Pro-engineer616/pcb_projects_Alex/Sensor-Node v1.2/sensornodeV1.2/README.md

View this project on [CADLAB.io](https://cadlab.io/project/28262). 

# sensor_node
Airspeed, Compass and UART as CAN sensor
