Pro-engineer616/pcb_projects_Alex/infrastructure-board/production/PCB Specification_Infrastructure.docx

PCB Specification FC-Sensor

- Board Layer Stackup

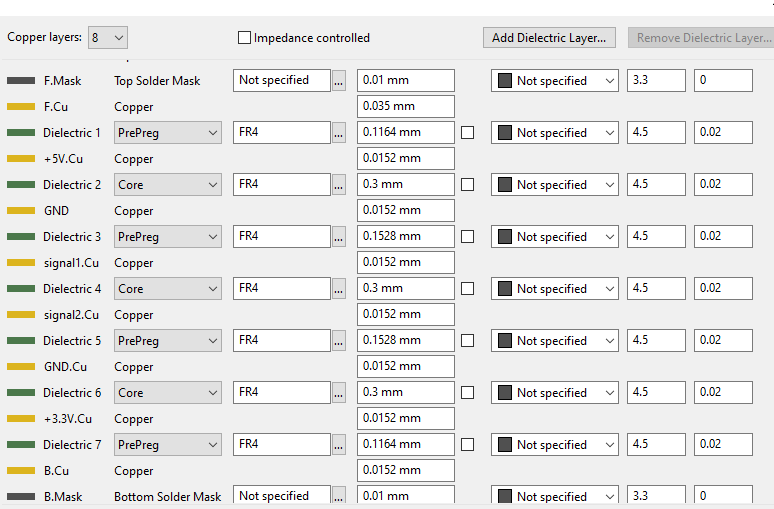
[picture p1: figure]

- Constraints

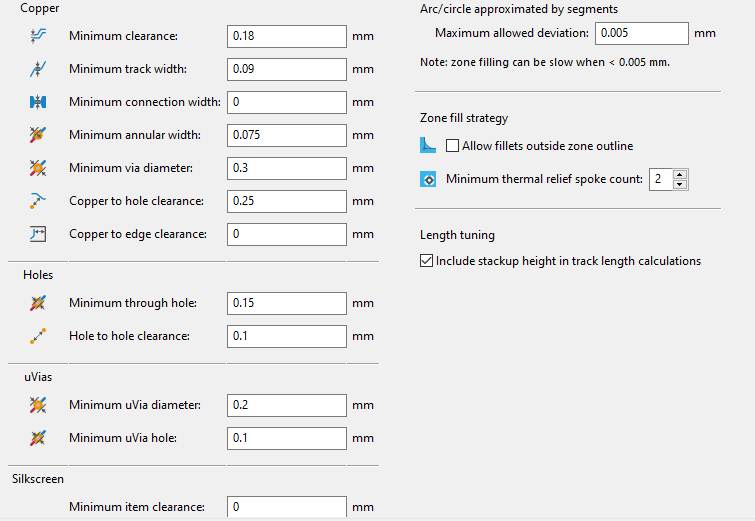
[picture p2: figure]

- 120ohm impedance control

It’s necessary to apply 120ohm impedance control to the following CAN traces on the layer5(signal2).

It’s necessary to apply 100ohm impedance control to the following Ethernet traces on the layer1(F.Cu), layer5(signal2), layer8(B.Cu).

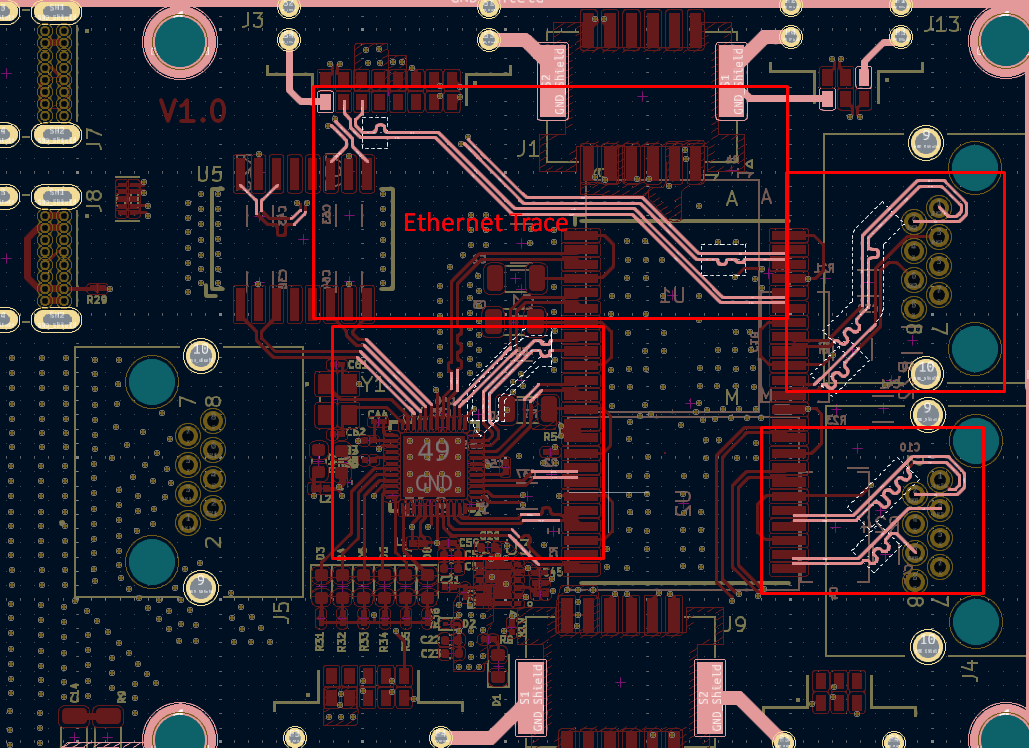
[picture p3: figure]
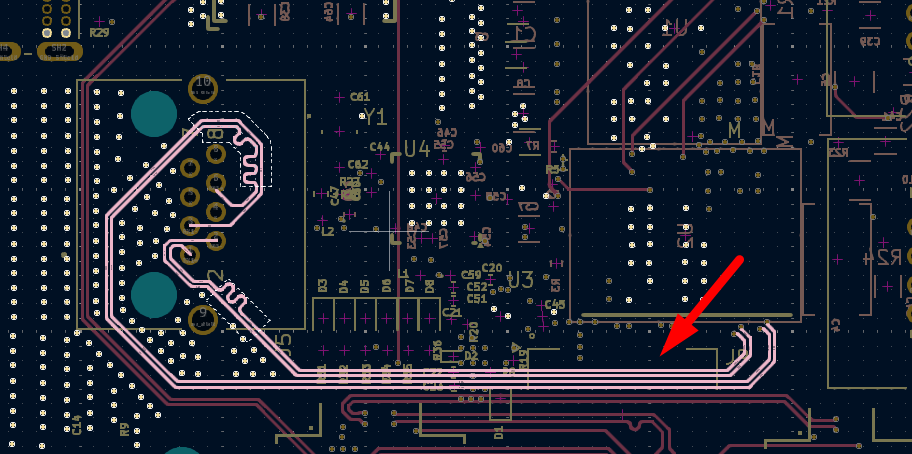
[picture p4: figure]
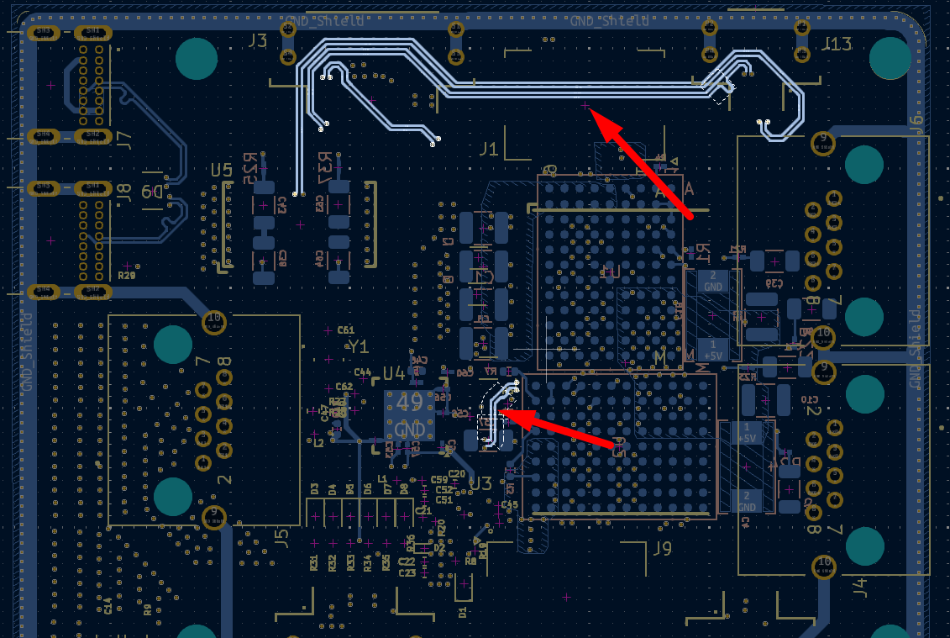
[picture p5: figure]

It’s necessary to apply 120ohm impedance control to the following CAN traces on the layer5(signal2).

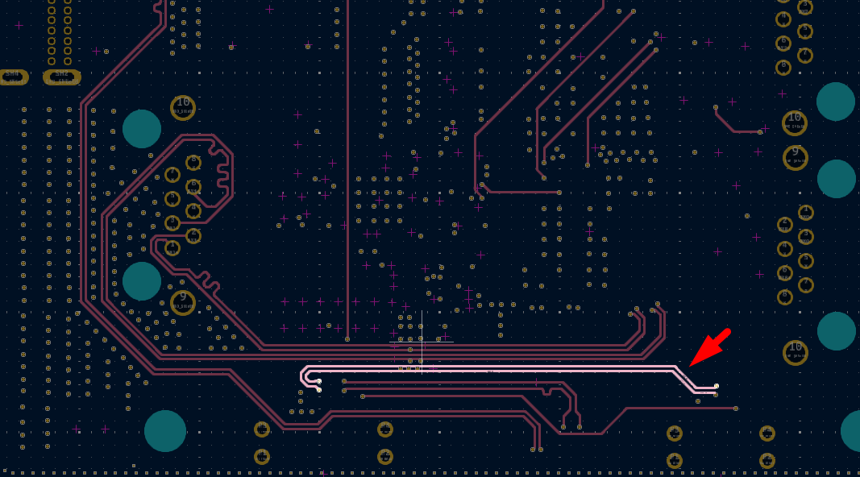
[picture p6: figure]

It’s necessary to apply 90ohm impedance control to the following USB traces on the layer5(signal2), layer8(B.Cu).

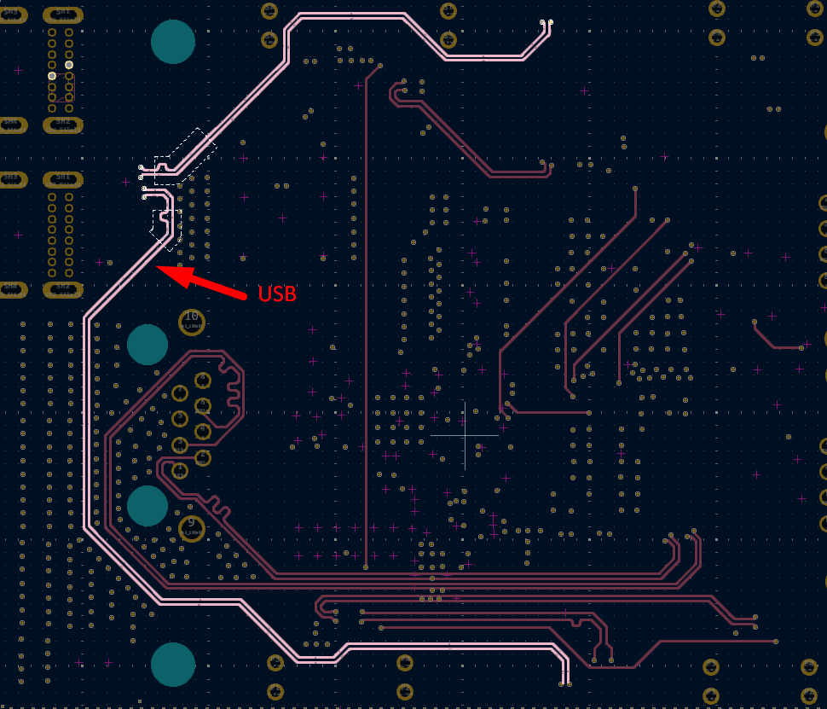
[picture p7: figure]
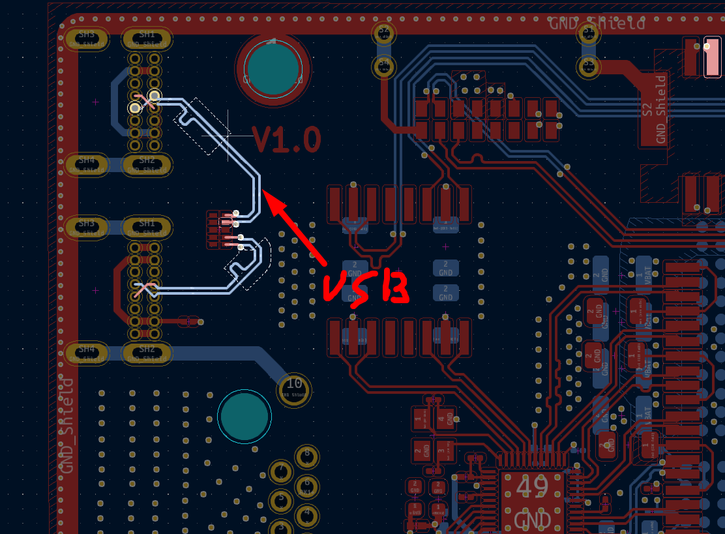
[picture p8: figure]

- Assembly

Pin1 indicators

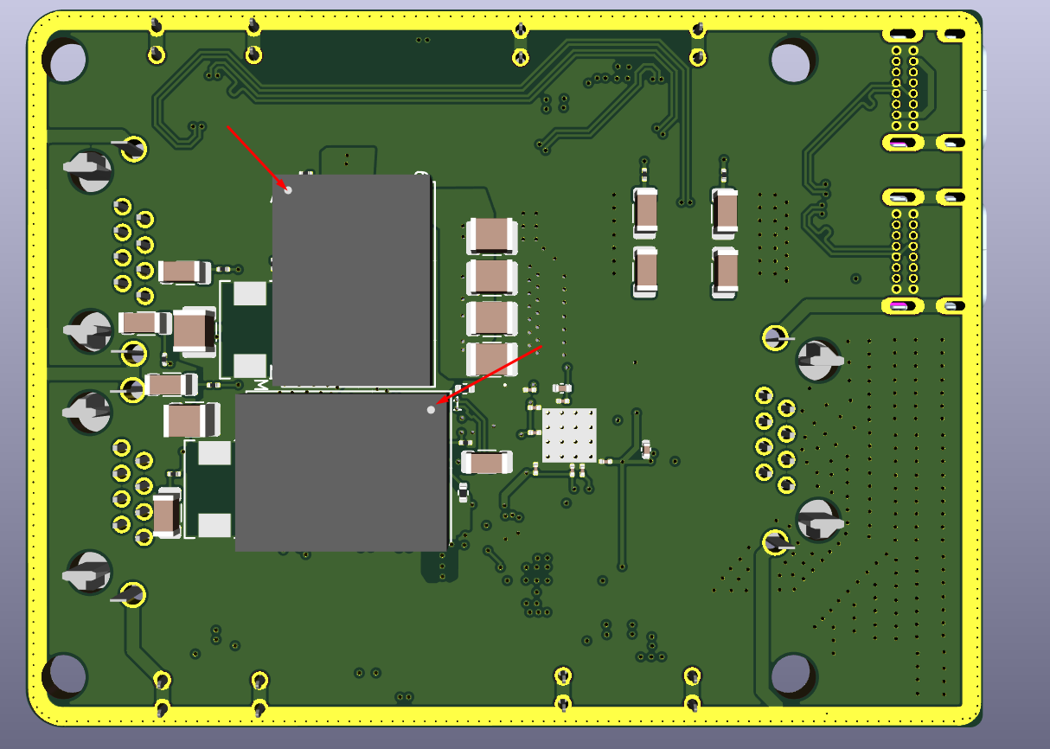
[picture p9: figure]
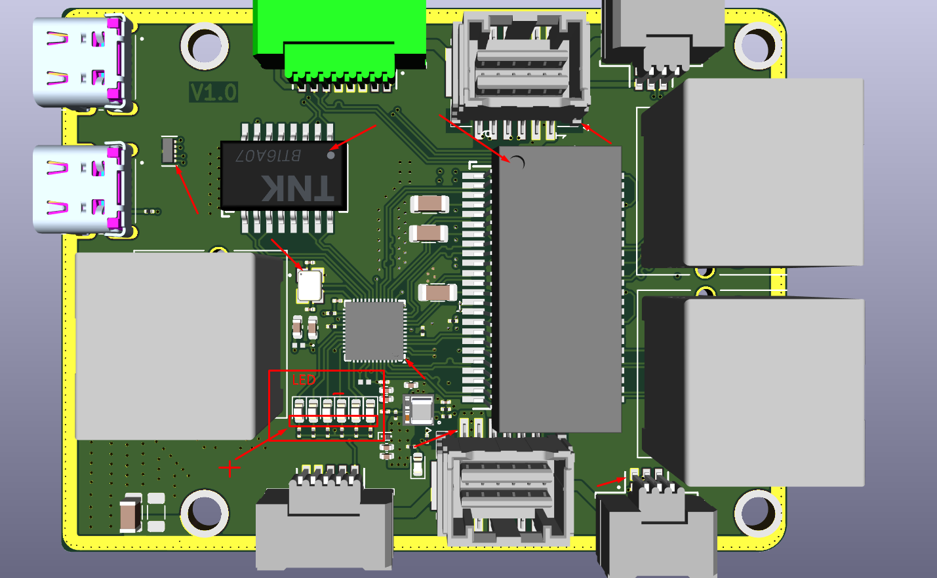
[picture p10: figure]

Drawings

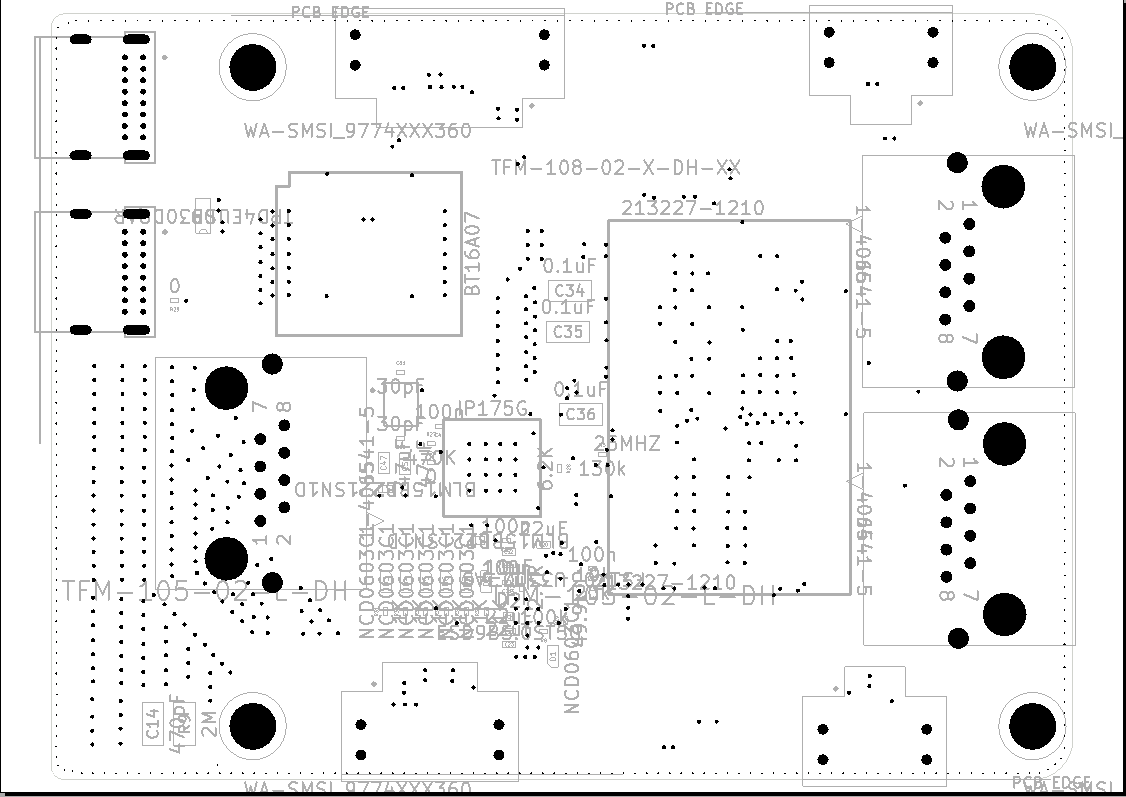
[picture p11: figure]
