Pro-engineer616/pcb_projects_Alex/PDB v1.4/production/PCB Specification PDB_V1.4.docx

PCB Specification FC-Sensor

- Board Layer Stackup

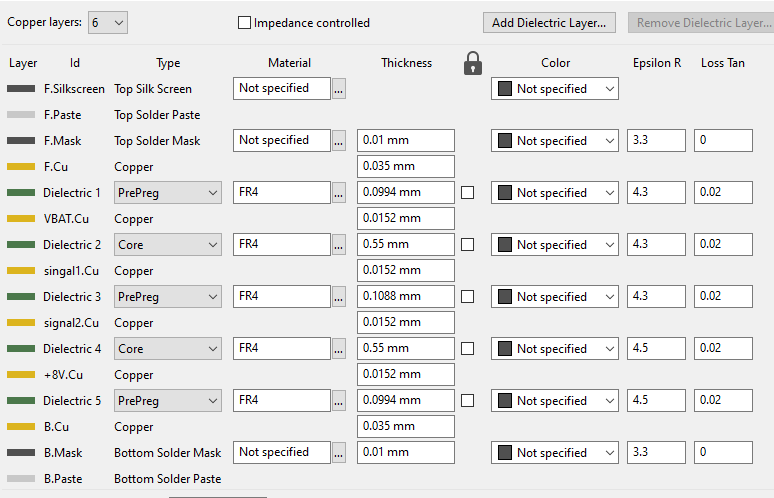
[picture p12: figure]

- Constraints

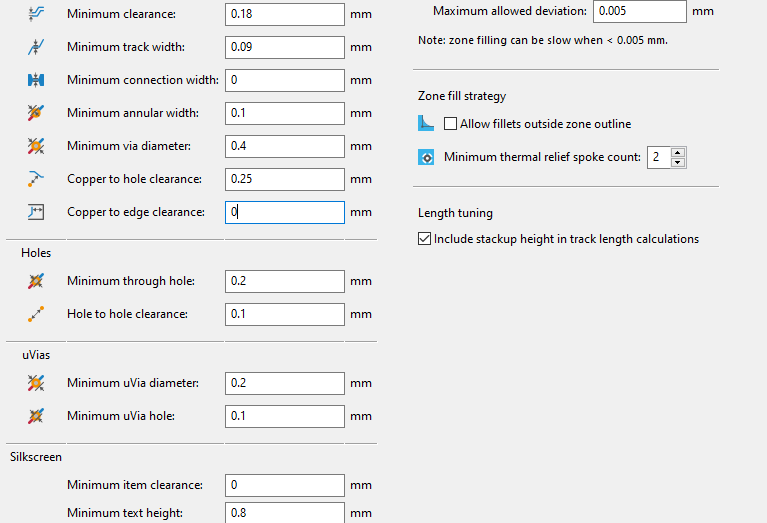
[picture p13: figure]

- 120ohm impedance control

It’s necessary to apply 120ohm impedance control to the following CAN traces on the layer3(signal1).

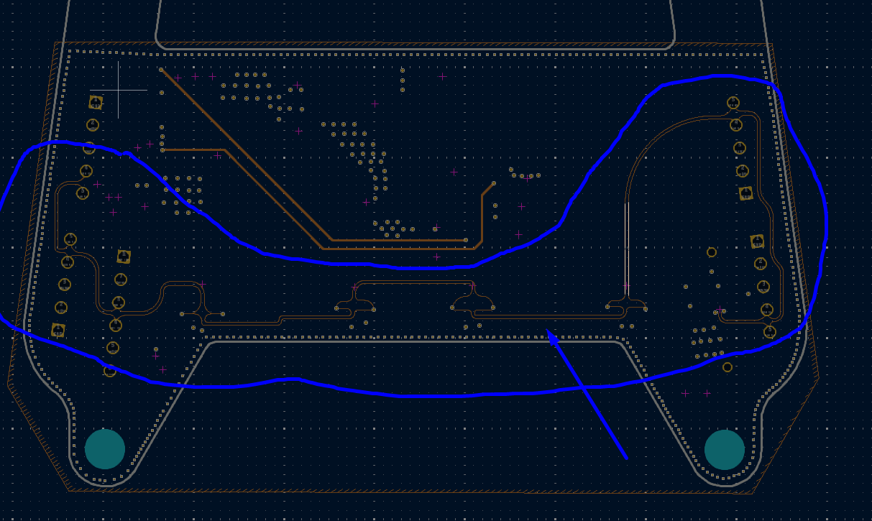
[picture p14: figure]

- Assembly

Pin1 indicators

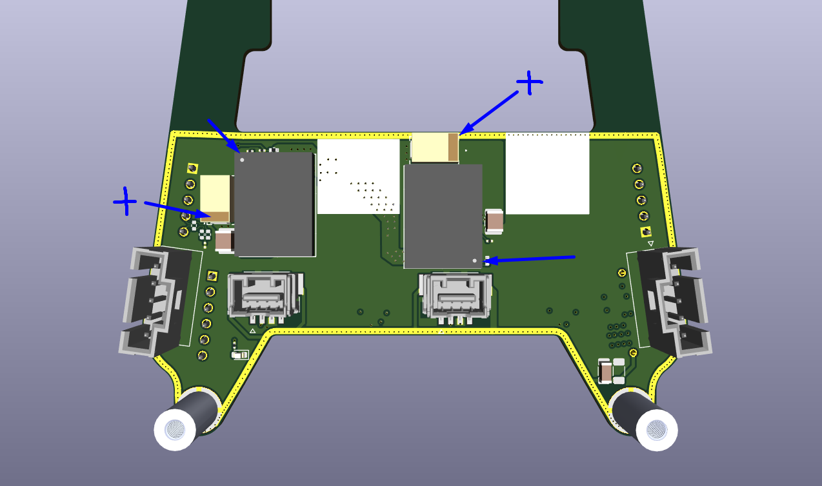
[picture p15: figure]
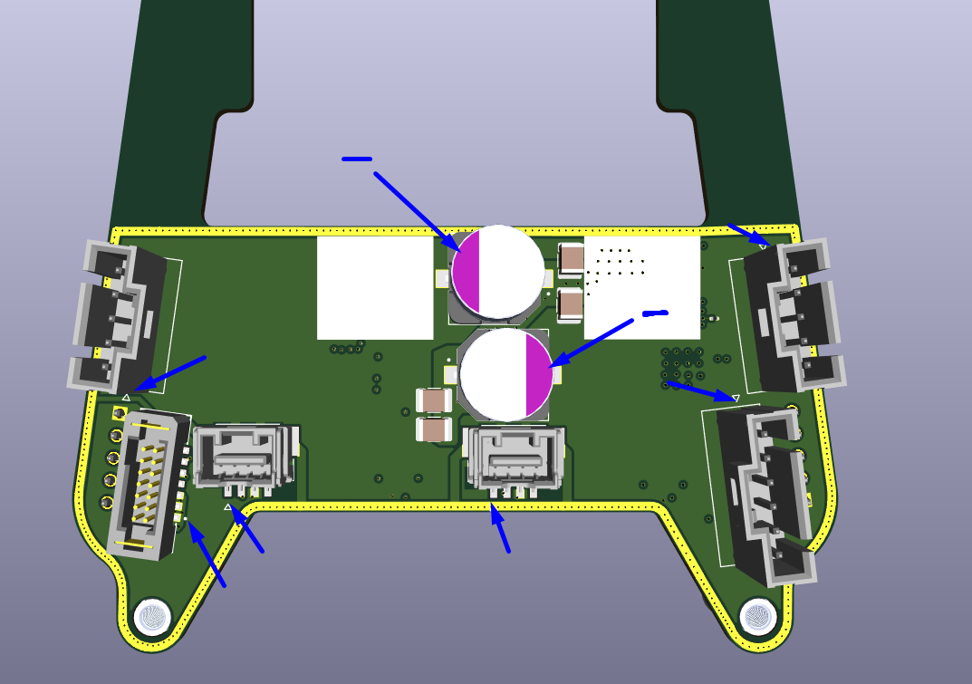
[picture p16: figure]

Drawings

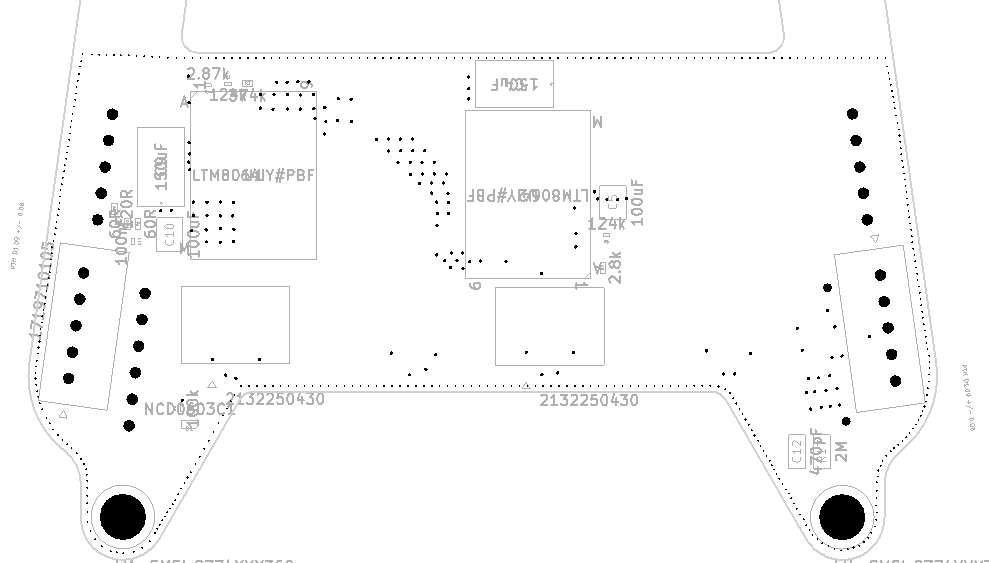
[picture p17: figure]
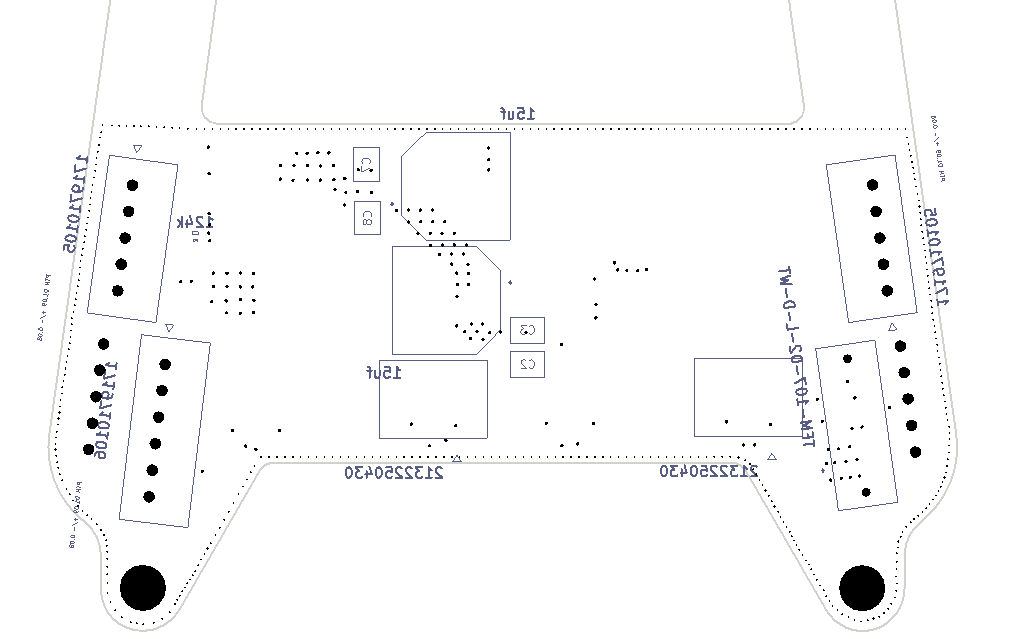
[picture p18: figure]
