Pro-engineer616/pcb_projects_Alex/Sensor-Node v1.2/production/PCB Specification_Sensornode_V1.2.docx

PCB Specification Sensornode_V1.2

- Board Layer Stackup

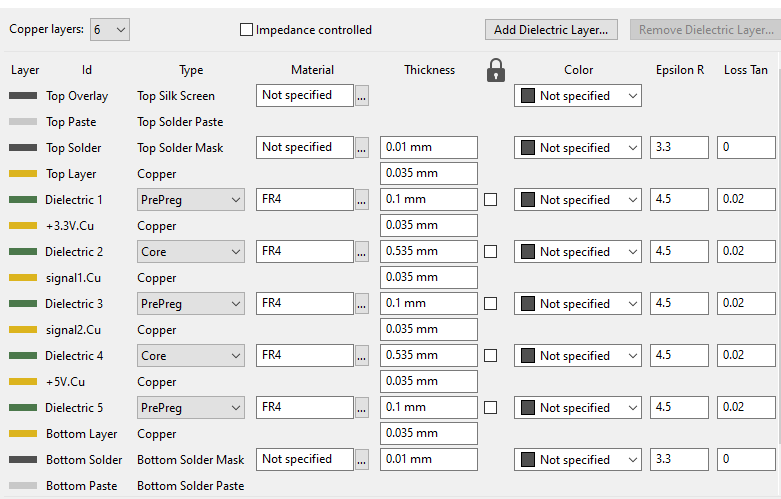
[picture p19: figure]

- Constraints

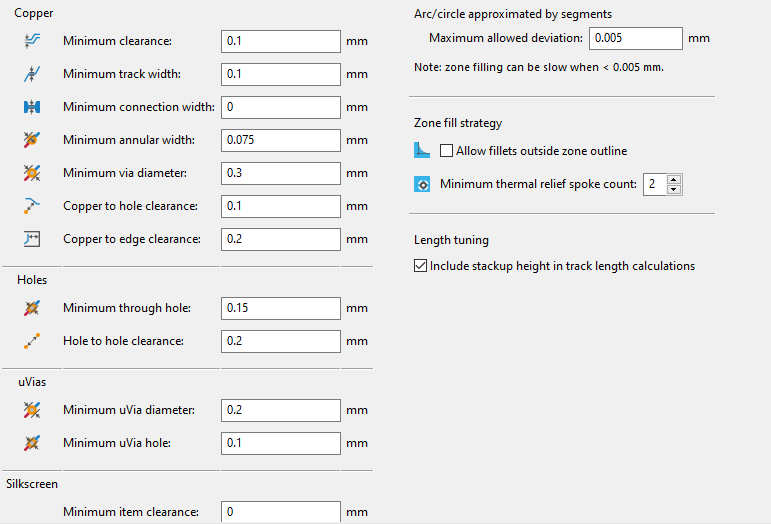
[picture p20: figure]

- impedance control

It’s necessary to apply 120ohm impedance control to the following CAN traces on the layer3(signal1), layer6(B.Cu).

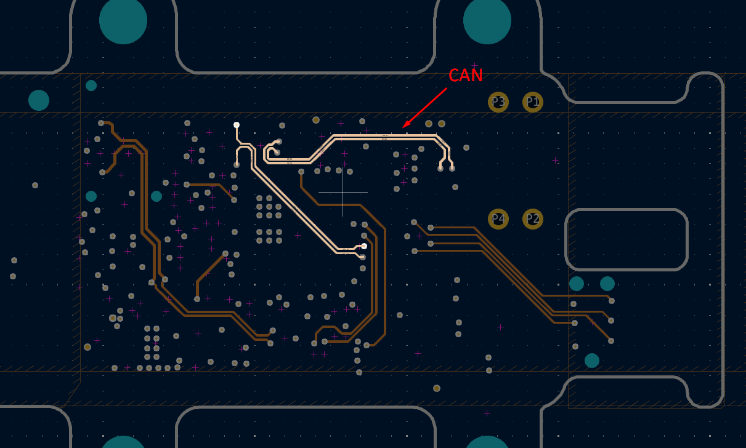
[picture p21: figure]
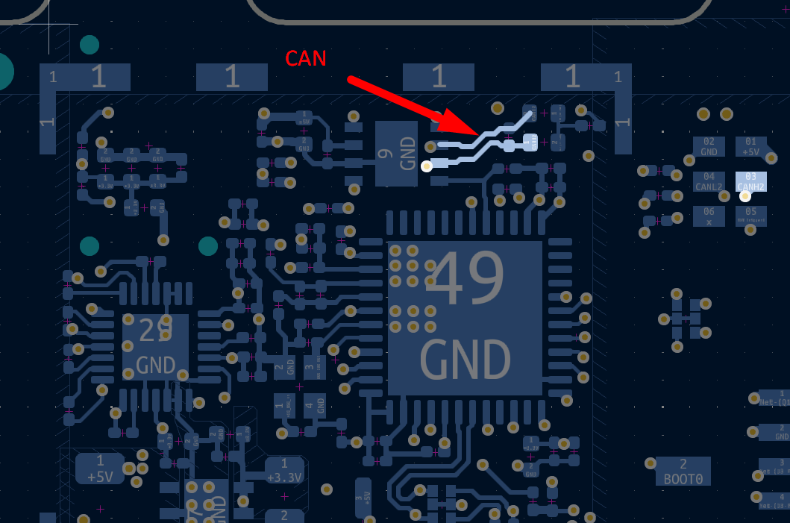
[picture p22: figure]

- Assembly

Pin1 indicators

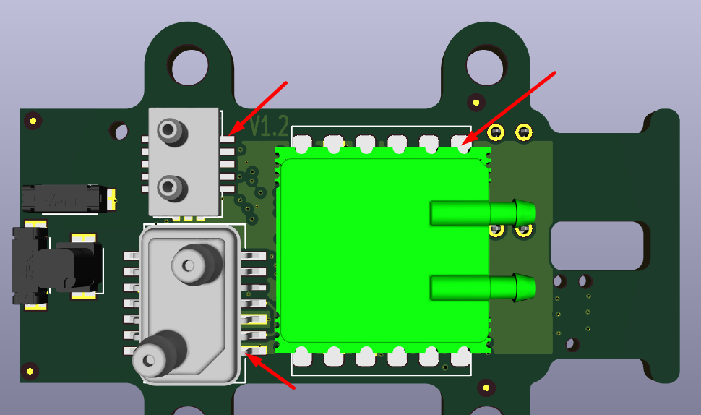
[picture p23: figure]
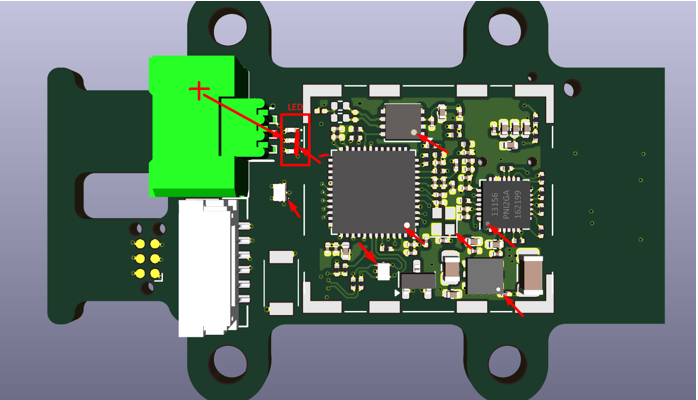
[picture p24: figure]

Drawings

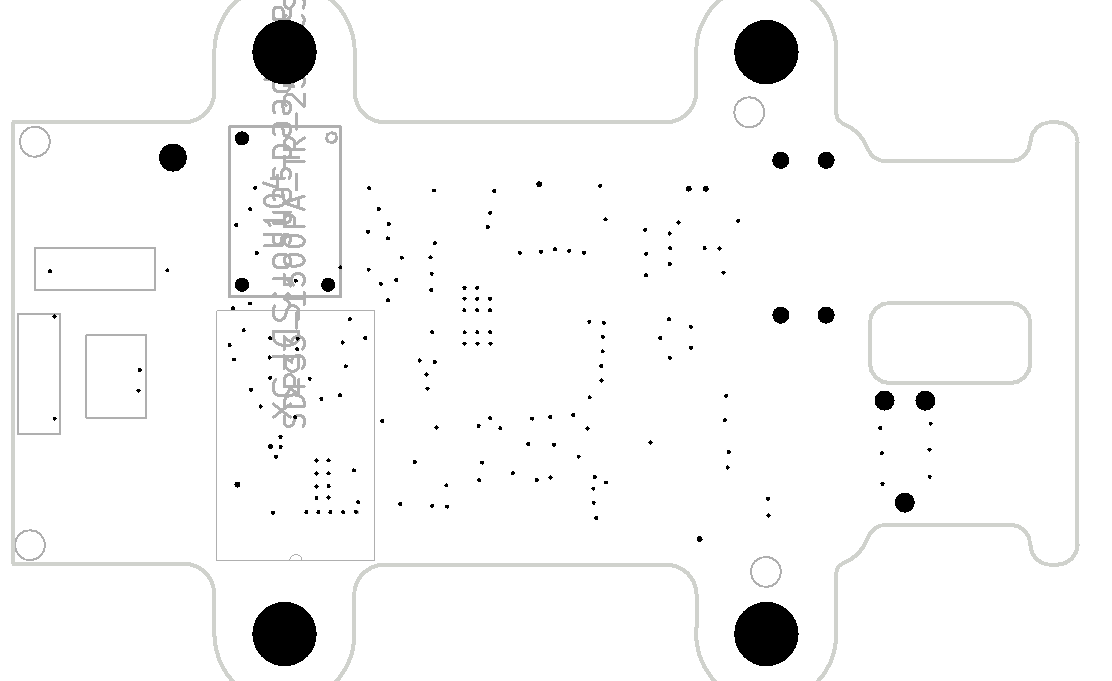
[picture p25: figure]
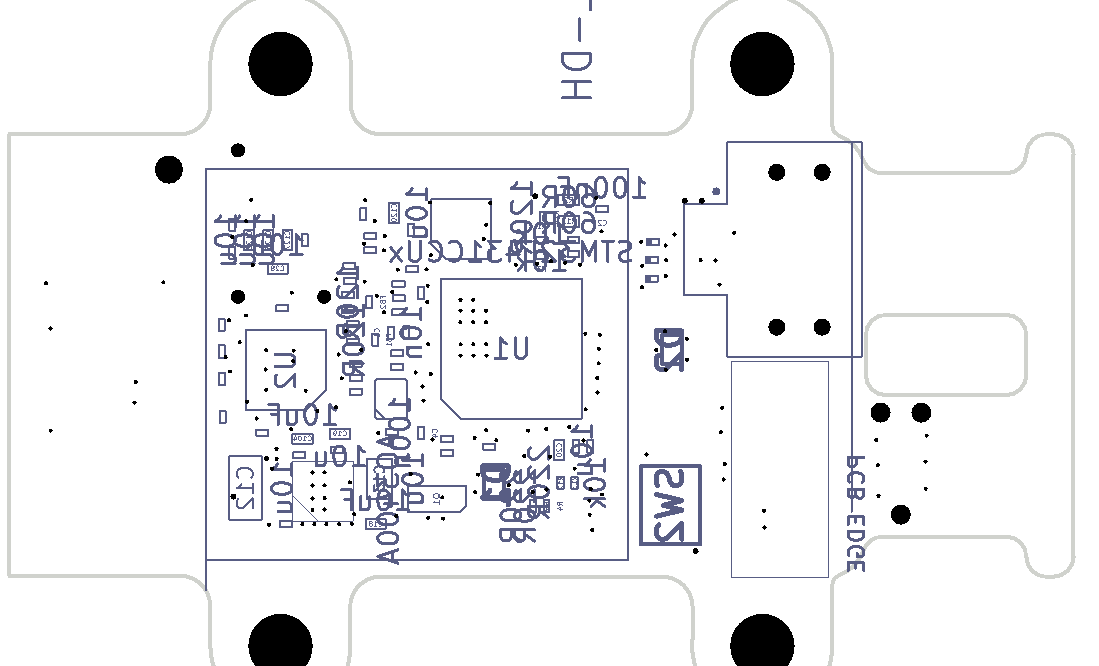
[picture p26: figure]
