Pro-engineer616/pcb_projects_Alex/Sensor-Node v1.2/production/JLCPCB/BOM/sensor_node1.2_BOM.xlsx

Comment | Designator | Footprint | JLCPCB Part#(optional)
CL03A105KP3NSNC | C9,C15,C26,C27 | Capacitor_SMD:C_0201_0603Metric | C5209398
GRM033R71A103KA01D | C1 | Capacitor_SMD:C_0201_0603Metric | C76941
GRM033Z71C104KE14D | C4,C14,C16,C21,C22,C23,C25,C29,C30,C31,C32,C117,C118,C123 | Capacitor_SMD:C_0201_0603Metric | C668346
GRM033Z71C104KE14D | C2,C17,C102,C105,C107 | Capacitor_SMD:C_0201_0603Metric | C668346
CL05A106MP5NUNC | C19,C20,C28,C120,C122,C125,C127, C18,C104 | Capacitor_SMD:C_0402 | C315248
1206B106K100NT | C12 | Capacitor_SMD:C_1206_3216Metric | C165101
CL21A106KPFNNNE | C13 | Capacitor_SMD:C_0805_2012Metric | C17024
C0201C0G6R8D500NTA | C33,C34 | Capacitor_SMD:C_0201_0603Metric | C115567
GRM033Z71C104KE14D | C116 | Capacitor_SMD:C_0201_0603Metric | C668346
XL-0201SURC | D4 | LED_SMD:LED_0201_0603Metric | C3646923
XL-0201UGC | D5 | LED_SMD:LED_0201_0603Metric | C3646922
XL-0201UBC | D6 | LED_SMD:LED_0201_0603Metric | C3646921
PESD3V3L4UF,115 | D1,D2 | SOT-353 | C552517
BLM03AG121SN1D | FB2,FB1 | Resistor_SMD:R_0402 | digikey: 490-2557-1-ND
TFM-103-02-L-DH-TR | J1 | TFM-103-02-L-DH-TR | digikey: 612-TFM-103-02-L-DH-TRCT-ND
SM06B-GHS-TB(LF)(SN) | J3 | SM06B-GHS-TB(LF)(SN) | C133065
RM3100_Sen-XY-f | L101,L102 | airspeedsensor:RM3100_Sen-XY-f | C464558
RM3100_Sen-Z-f | L103 | airspeedsensor:RM3100_Sen-Z-f | C464558
CSD17484F4 | Q1 | PicoStar-3 | C2862245
WR02X1002FAL | R1,R3,R5,R6,R7,R8,R12,R114,R115,R118,R119 | Resistor_SMD:R_0201_0603Metric | C170195
RTT0259R0FTH | R2,R11 | Resistor_SMD:R_0402 | C159005
RTT01333JTH | R105 | Resistor_SMD:R_0201_0603Metric | C158604
RC-01W1210FT | R106,R107,R108,R109,R110,R111 | Resistor_SMD:R_0201_0603Metric | C320672
RC0201FR-07220RL | R4,R9,R13 | Resistor_SMD:R_0201_0603Metric | C274342
0201WMF1200TEE | R10 | Resistor_SMD:R_0201_0603Metric | C473017
0201WMF4701TEE | R112,R113 | Resistor_SMD:R_0201_0603Metric | C270346
TS-1088R-02026 | SW2 | SMD,3x4mm | C455280
STM32L431CCU6 | U1 | UFQFPN-48(7x7) | C1337258
NCP692MN33T2G | U6 | airspeedsensor:DFN6_3X3_ONS-L | C145519
L05D-M25125 | U9 | airspeedsensor:DS-0432 | digikey: 442-AUAV-L05D-M25125-RR-N-ND
5525DSO-DB001DS | U10 | MS5525DSO:SO14_MS5525DSO_TEC | digikey: 223-1707-5-ND
RM3100_MagI2C_QFN28 | U2 | airspeedsensor:RM3100_MagI2C_MLF_4x4mm_P0.4 | C464558
SDP33-1500PA-TR-250PCS | U104 | Airspeedsensor-HW:SDP3x | mouser: 403-SDP331500PATR250
TJA1051TK/3 | U105 | Package_DFN_QFN:DFN-8-1EP_3x3mm_P0.65mm_EP1.55x2.4mm | C2875699
XC21M4-24.000-F06NKDTL | Y2 | Crystal:Crystal_SMD_2016-4Pin_2.0x1.6mm | C3034314
MS215-10S | shield | MS215-10S | digikey: 2333-MS215-10S-ND
