Pro-engineer616/pcb_projects_Alex/Radxa-Shield v1.2/production/PCBWAY/BOM/Radxa Shield Rev. 1.2_BOM_way.xlsx

Item | Designator | Qty | Manufacturer | Msg part | Description | Package | Type | Your Instructions / Notes
1 | C1,C3,C5,C8,C11,C16,C18,C19,C21,C22,C23 | 11 | Walsin Tech Corp | 0201X104K160CT | 16V 100nF X5R ±10% 0201 Multilayer Ceramic Capacitors MLCC - SMD/SMT ROHS | Capacitor_SMD:C_0201_0603Metric | SMD
2 | C2,C4 | 2 | Samsung Electro-Mechanics | CL21A106KOQNNNE | 16V 10uF X5R ±10% 0805 Multilayer Ceramic Capacitors MLCC - SMD/SMT ROHS | Capacitor_SMD:C_0805_2012Metric | SMD
3 | C6 | 1 | Samsung Electro-Mechanics | CL05A475MO5NUNC | 16V 4.7uF X5R ±20% 0402 Multilayer Ceramic Capacitors MLCC - SMD/SMT ROHS | Capacitor_SMD:C_01005_0402Metric | SMD
4 | C7,C9,C10 | 3 | Murata Electronics | GRM155R61A225KE95D | 10V 2.2uF X5R ±10% 0402 Multilayer Ceramic Capacitors MLCC - SMD/SMT ROHS | Capacitor_SMD:C_0402_1005Metric | SMD
5 | C12,C17 | 2 | Murata Electronics | GRM033R71A103KA01D | 10V 10nF X7R ±10% 0201 Multilayer Ceramic Capacitors MLCC - SMD/SMT ROHS | Capacitor_SMD:C_0201_0603Metric | SMD
6 | C13 | 1 | Murata Electronics | GRM033C80J224ME90D | 6.3V 220nF X6S ±20% 0201 Multilayer Ceramic Capacitors MLCC - SMD/SMT ROHS | Capacitor_SMD:C_0201_0603Metric | SMD
7 | C14,C15 | 2 | Murata Electronics | GRM0335C1E180JA01J | 25V 18pF C0G ±5% 0201 Multilayer Ceramic Capacitors MLCC - SMD/SMT ROHS | Capacitor_SMD:C_0201_0603Metric | SMD
8 | C24,C25,C26,C27,C28 | 5 | Samsung Electro-Mechanics | CL05A106MP5NUNC | 10V 10uF X5R ±20% 0402 Multilayer Ceramic Capacitors MLCC - SMD/SMT ROHS | Capacitor_SMD:C_0402_1005Metric | SMD
9 | D1,D2 | 2 | Nexperia | PESD3V3L4UF,115 | SOT-353 ESD and Surge Protection (TVS/ESD) ROHS | PESD3V3L4UF,115:PESD3V3L5UF115 | SMD
10 | D3 | 1 | TECH PUBLIC | ESD9B5.0ST5G | SOD-923 ESD and Surge Protection (TVS/ESD) ROHS | Diode_SMD:D_SOD-923 | SMD
11 | D4 | 1 | Texas Instruments | TPD4EUSB30DQAR | 1A 45W 8V 7V Unidirectional 5.5V USON-10(1x2.5) ESD and Surge Protection (TVS/ESD) ROHS | TPD4EUSB30DQAR:DQA10 | SMD
12 | J1 | 1 | ZHOURI | 2.54-2*20 | 2.54mm 2.54mm Double Row 2.5A 40P -40℃~+105℃ Direct Insert 2x20P 8.5mm Top Square Hole Plugin,P=2.54mm Female Headers ROHS | Connector_Samtec_HLE_THT:Samtec_HLE-120-02-xx-DV-TE_2x20_P2.54mm_Horizontal | wave soldering
13 | J2 | 1 | Samtec Inc. | TFM-106-02-L-DH-TR | CONN HEADER SMD R/A 12POS 1.27MM | TFM-106-02-L-DH-TR:SAMTEC_TFM-106-02-L-DH-TR | SMD
14 | L1 | 1 | Murata Electronics | BLM15BB221SN1D | 800mΩ ±25% 220Ω@100MHz 0402 Ferrite Beads ROHS | BLM15BB221SN1D:IND_BLM15_0402_MUR
15 | R1 | 1 | FH (Guangdong Fenghua Advanced Tech) | RC-01W2402FT | 50mW Thick Film Resistors 25V ±1% ±200ppm/℃ 24kΩ 0201 Chip Resistor - Surface Mount ROHS | Resistor_SMD:R_0201_0603Metric | SMD
16 | R2 | 1 | UNI-ROYAL(Uniroyal Elec) | 0201WMF4702TEE | 50mW Thick Film Resistors 25V ±1% ±200ppm/℃ 47kΩ 0201 Chip Resistor - Surface Mount ROHS | Resistor_SMD:R_0201_0603Metric | SMD
17 | R3 | 1 | UNI-ROYAL(Uniroyal Elec) | 0201WMF4301TEE | 50mW Thick Film Resistors 25V ±1% ±200ppm/℃ 4.3kΩ 0201 Chip Resistor - Surface Mount ROHS | Resistor_SMD:R_0201_0603Metric | SMD
18 | R4,R9,R10,R11,R13,R16,R17 | 7 | YAGEO | RC0201JR-0710KL | 50mW Thick Film Resistors 25V ±5% ±200ppm/℃ 10kΩ 0201 Chip Resistor - Surface Mount ROHS | Resistor_SMD:R_0201_0603Metric | SMD
19 | R5 | 1 | UNI-ROYAL(Uniroyal Elec) | 0201WMF2002TEE | 50mW Thick Film Resistors 25V ±1% ±200ppm/℃ 20kΩ 0201 Chip Resistor - Surface Mount ROHS | Resistor_SMD:R_0201_0603Metric | SMD
20 | R6 | 1 | YAGEO | RC0201FR-0749K9L | 50mW Thick Film Resistors 25V ±1% ±200ppm/℃ 49.9kΩ 0201 Chip Resistor - Surface Mount ROHS | Resistor_SMD:R_0201_0603Metric | SMD
21 | R7 | 1 | RALEC | RTT012R70FTH | 50mW Thick Film Resistors 25V -200ppm/℃~+400ppm/℃ ±1% 2.7Ω 0201 Chip Resistor - Surface Mount ROHS | Resistor_SMD:R_0201_0603Metric | SMD
22 | R8 | 1 | UNI-ROYAL(Uniroyal Elec) | 0201WMF1202TEE | 50mW Thick Film Resistors 25V ±1% ±200ppm/℃ 12kΩ 0201 Chip Resistor - Surface Mount ROHS | Resistor_SMD:R_0201_0603Metric | SMD
23 | R12,R14 | 2 | RALEC | RTT011003FTH | 50mW Thick Film Resistors 25V ±1% ±200ppm/℃ 100kΩ 0201 Chip Resistor - Surface Mount ROHS | Resistor_SMD:R_0201_0603Metric | SMD
24 | R15 | 1 | YAGEO | RC0201FR-071ML | 50mW Thick Film Resistors 25V ±1% ±200ppm/℃ 1MΩ 0201 Chip Resistor - Surface Mount ROHS | Resistor_SMD:R_0201_0603Metric | SMD
25 | U1 | 1 | SKYWORKS/SILICON LABS | CP2105-F01-GM | 2Mbps USB to UART UART QFN-24-EP(4x4) USB Converters ROHS | CP2105:QFN24_4X4_SIL-L | SMD
26 | U2 | 1 | Microchip Tech | USB2512BI-AEZG | Hub SQFN-36-EP(6x6) USB Converters ROHS | QFN36_6X6MC_MCH | SMD
27 | U3 | 1 | TDK | FS1703-3300-AS | SMD-17P,3.3x3.3mm DC-DC Power Modules ROHS | FS1703-3300-AS:P11F1_TDK | wave soldering
28 | Y1 | 1 | Lucki | L327S240P11L | 24MHz SMD crystal oscillator 15pF ±10ppm SMD3225-4P Crystals ROHS | L327S240P11L:XTAL_TSX-3225_40.0000MF20X-K0 | SMD
29 | C20 | 1 | FOJAN | FCC1206B471K102DT | 1kV 470pF X7R ±10% 1206 Multilayer Ceramic Capacitors MLCC - SMD/SMT ROHS | 1206 | SMD
30 | R18 | 1 | UNI-ROYAL(Uniroyal Elec) | 1206W4F2004T5E | 250mW Thick Film Resistors 200V ±100ppm/℃ ±1% 2.2MΩ 1206 Chip Resistor - Surface Mount ROHS | 1206 | SMD
