Pro-engineer616/pcb_projects_Alex/infrastructure-board/source/infrastructure/package/100SXV15MX/100SXV15MX.step

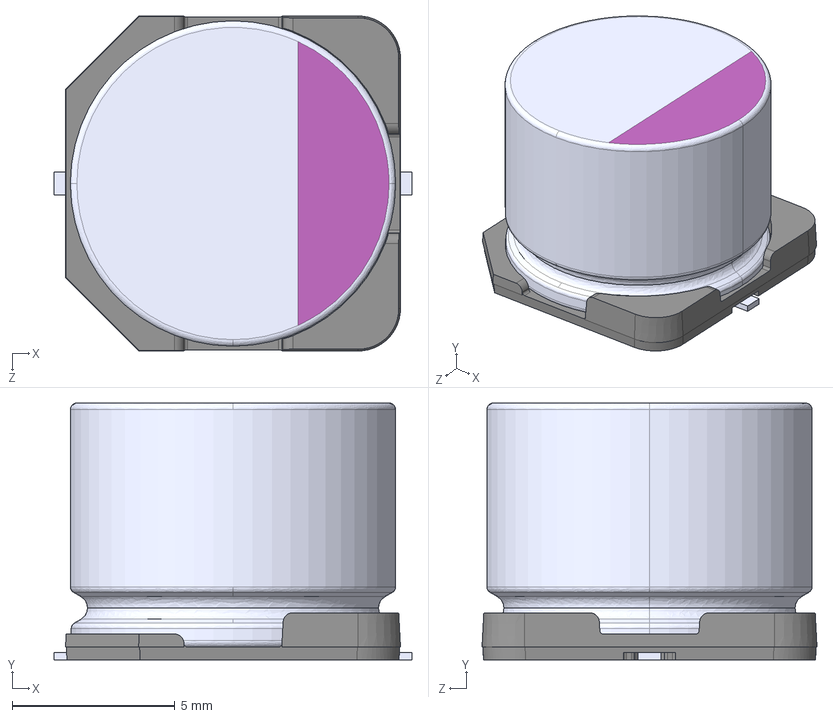
[picture p27: CAD file, 2024-08-19]
infrastructure-board/source/infrastructure/package/100SXV15MX/100SXV15MX.step
11.0 x 7.90 x 10.3 mm
