Pro-engineer616/pcb_projects_Alex/infrastructure-board/source/infrastructure/package/1_406541_5/c-1-406541-5-l1-3d.stp

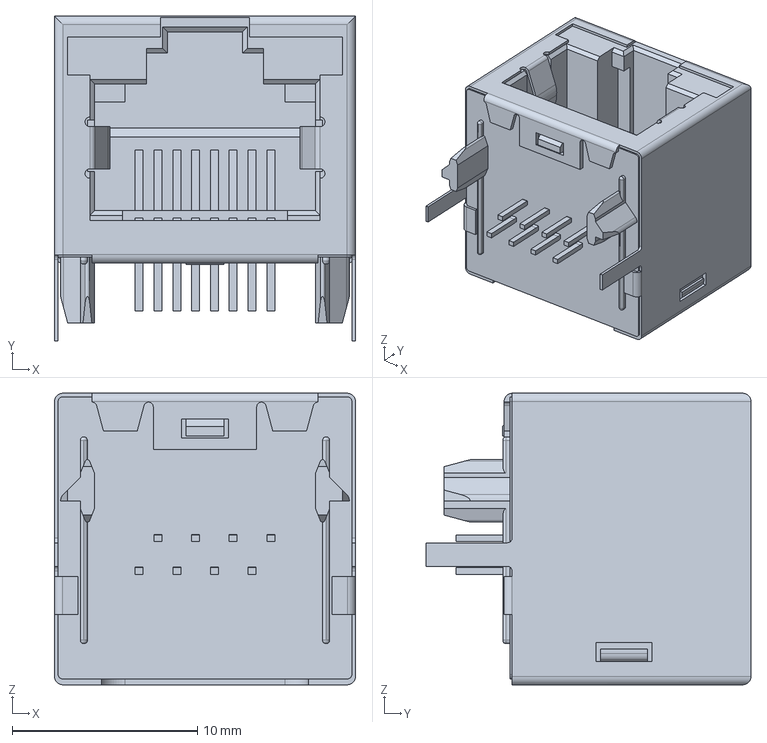
[picture p28: CAD file, 2024-08-29]
infrastructure-board/source/infrastructure/package/1_406541_5/c-1-406541-5-l1-3d.stp
16.3 x 17.6 x 15.7 mm
