Pro-engineer616/pcb_projects_Alex/infrastructure-board/source/infrastructure/package/9774120360R/WA-SMSI_9774XXX360.step

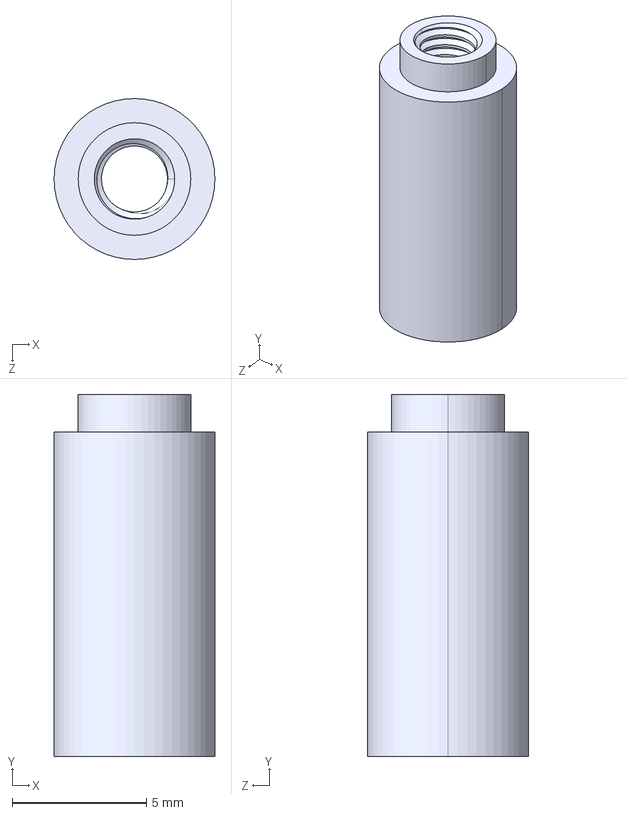
[picture p29: CAD file, 2024-08-19]
infrastructure-board/source/infrastructure/package/9774120360R/WA-SMSI_9774XXX360.step
6.00 x 13.5 x 6.00 mm
