Pro-engineer616/pcb_projects_Alex/infrastructure-board/source/infrastructure/package/GSB1C211110DS1HR/GSB1C211110DS1HR.step

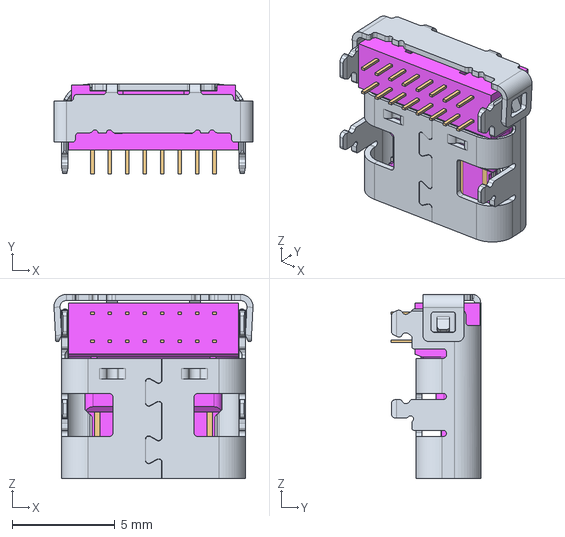
[picture p30: CAD file, 2024-08-29]
infrastructure-board/source/infrastructure/package/GSB1C211110DS1HR/GSB1C211110DS1HR.step
9.69 x 4.36 x 8.97 mm
