Pro-engineer616/pcb_projects_Alex/infrastructure-board/source/infrastructure/package/LIB_IP175G/IP175G/3D/IP175G.stp

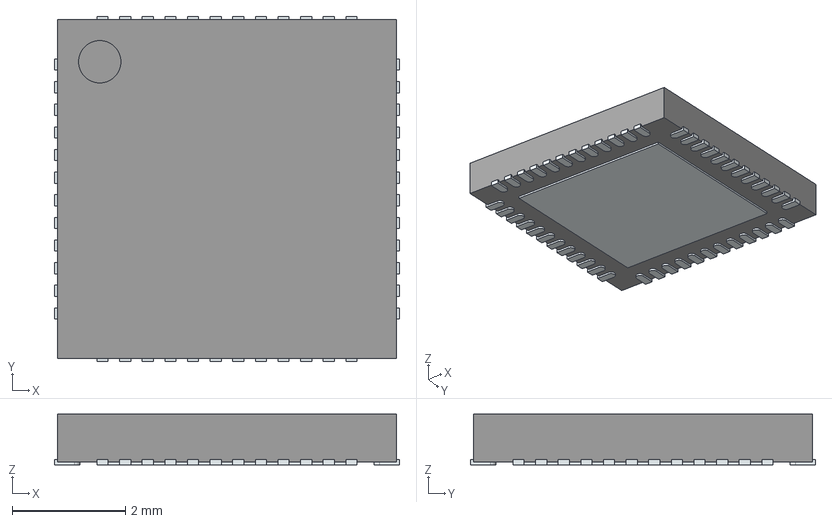
[picture p31: CAD file, 2024-08-29]
infrastructure-board/source/infrastructure/package/LIB_IP175G/IP175G/3D/IP175G.stp
6.10 x 6.10 x 0.9 mm
ThermalPin
PinsArrayLR
PinsArrayTB
