Pro-engineer616/pcb_projects_Alex/infrastructure-board/source/infrastructure/package/LIB_QT48A03/QT48A03/3D/QT48A03.stp

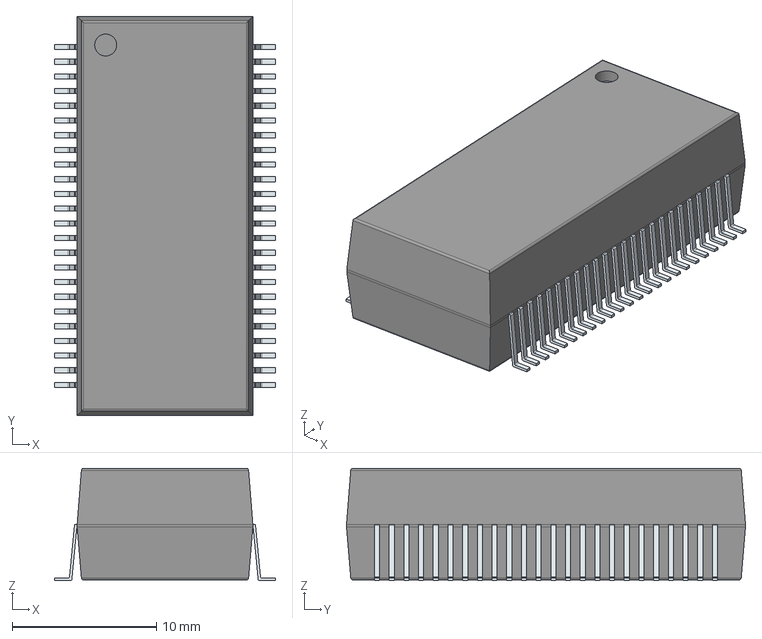
[picture p32: CAD file, 2024-08-29]
infrastructure-board/source/infrastructure/package/LIB_QT48A03/QT48A03/3D/QT48A03.stp
15.4 x 27.7 x 7.80 mm
PinsArrayLR
