Pro-engineer616/pcb_projects_Alex/infrastructure-board/source/infrastructure/package/LTM8064IY_PBF/KiCADv6/BGA108_16X11P9_ADI.step

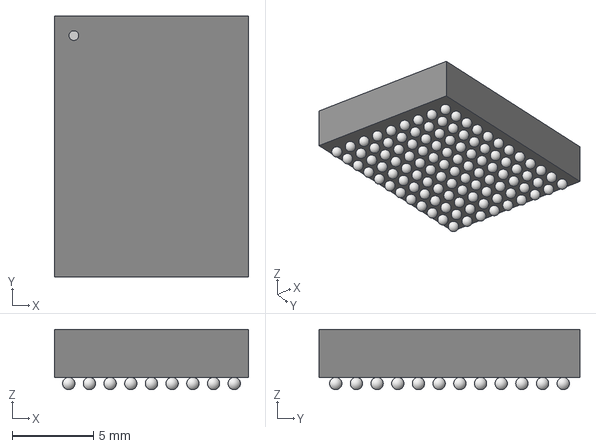
[picture p33: CAD file, 2024-08-19]
infrastructure-board/source/infrastructure/package/LTM8064IY_PBF/KiCADv6/BGA108_16X11P9_ADI.step
11.9 x 16.0 x 3.71 mm
