Pro-engineer616/pcb_projects_Alex/infrastructure-board/source/infrastructure/package/TFM_103_02_L_DH/TFM-103-02-L-DH.step

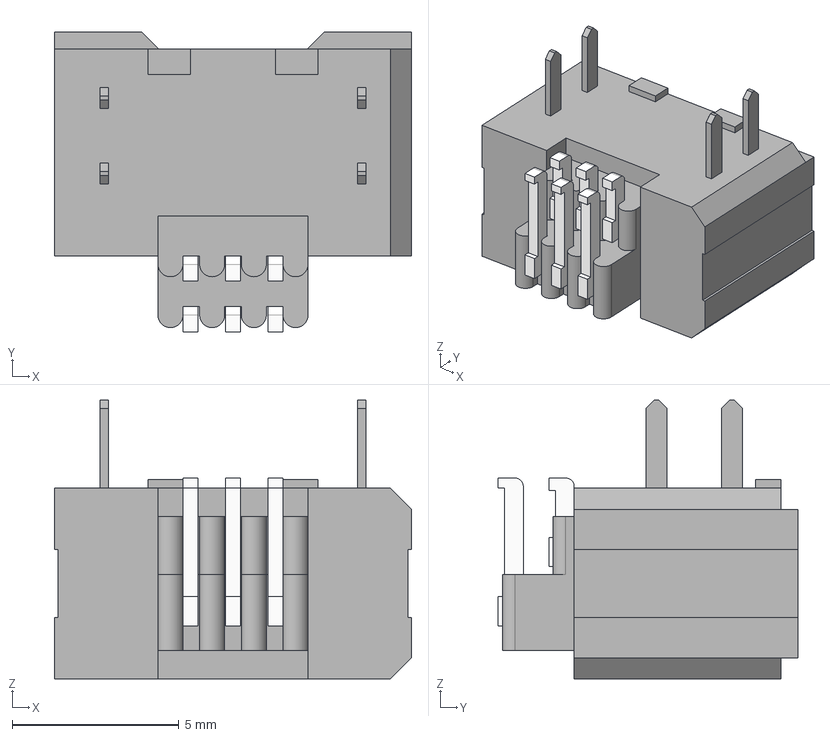
[picture p34: CAD file, 2024-08-29]
infrastructure-board/source/infrastructure/package/TFM_103_02_L_DH/TFM-103-02-L-DH.step
10.7 x 8.99 x 8.36 mm
TFM-103-02-L-DH_terminal
TFM-103-02-L-DH-L_pins
TFM-103-02-L-DH-L-2_pins
