Pro-engineer616/pcb_projects_Alex/infrastructure-board/source/infrastructure/package/TFM_108_02_L_DH/TFM-108-02-X-DH-XX.step

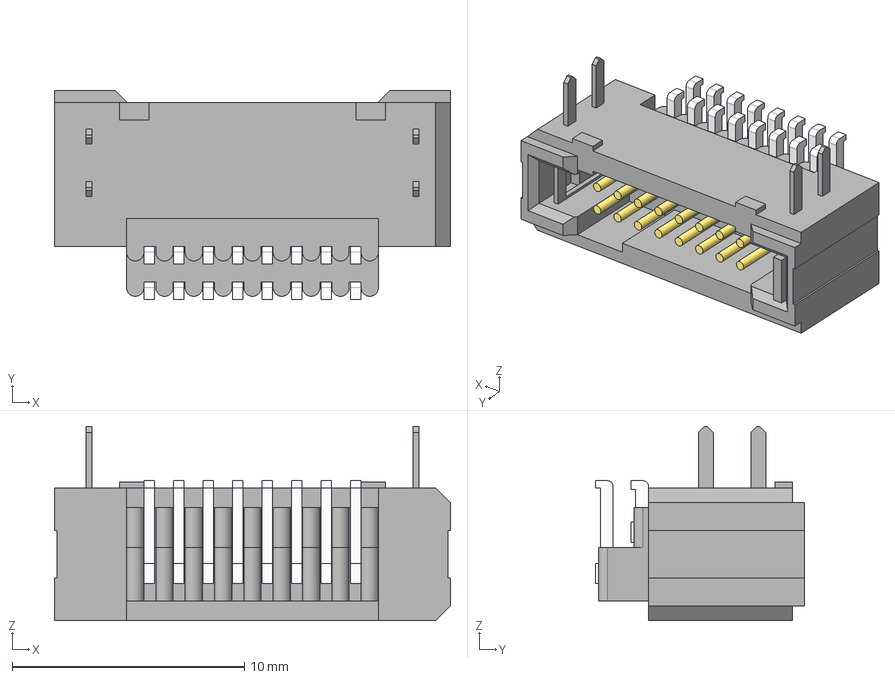
[picture p35: CAD file, 2024-08-29]
infrastructure-board/source/infrastructure/package/TFM_108_02_L_DH/TFM-108-02-X-DH-XX.step
17.0 x 8.99 x 8.36 mm
TFM-108-02-L-DH_terminal
TFM-108-02-L-DH-L_pins
TFM-108-02-L-DH-L-2_pins
