Pro-engineer616/pcb_projects_Alex/infrastructure-board/source/infrastructure/package/TRME157M016R0030/CAP_TRM-E-2917_AVX.step

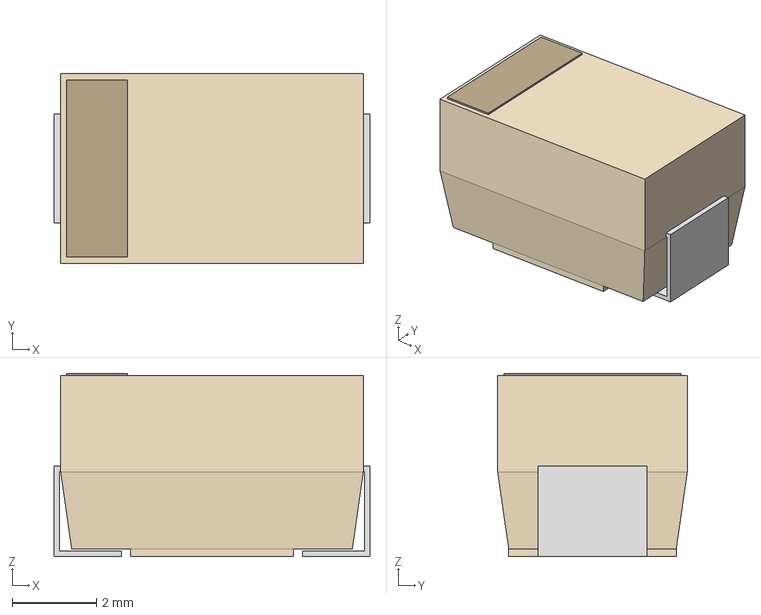
[picture p36: CAD file, 2024-08-19]
infrastructure-board/source/infrastructure/package/TRME157M016R0030/CAP_TRM-E-2917_AVX.step
7.49 x 4.50 x 4.34 mm
