Pro-engineer616/pcb_projects_Alex/Radxa-Shield v1.2/source/3D/FS1703-3300-AL--3DModel-STEP-269445.STEP

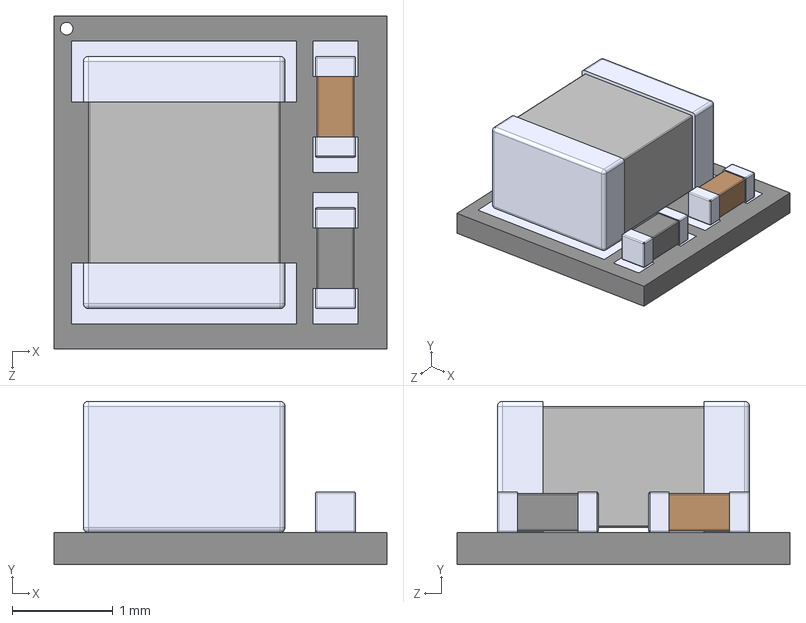
[picture p37: CAD file, 2024-08-19]
Radxa-Shield v1.2/source/3D/FS1703-3300-AL--3DModel-STEP-269445.STEP
3.30 x 1.62 x 3.30 mm
