Pro-engineer616/pcb_projects_Alex/Radxa-Shield v1.2/source/CP2105_F01_GM/QFN24_4X4_SIL.step

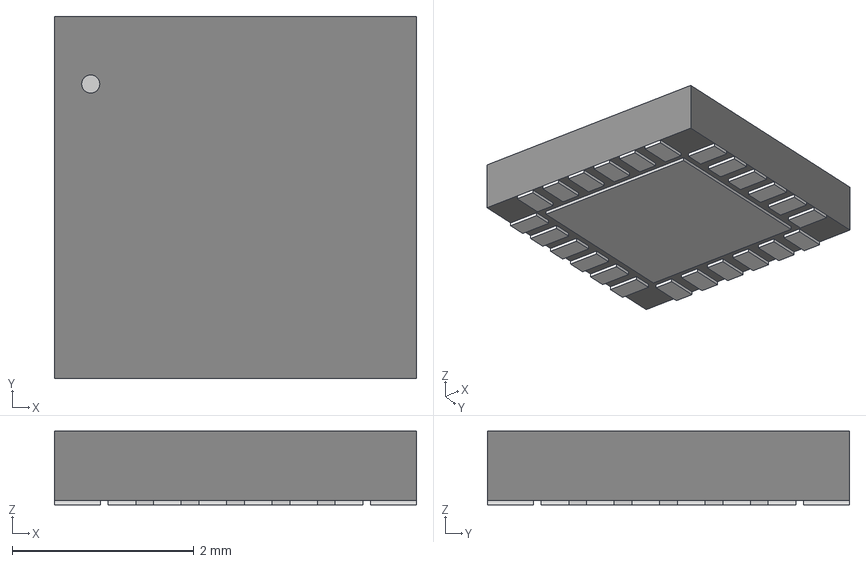
[picture p38: CAD file, 2024-08-19]
Radxa-Shield v1.2/source/CP2105_F01_GM/QFN24_4X4_SIL.step
3.99 x 3.99 x 0.815 mm
