Pro-engineer616/pcb_projects_Alex/Radxa-Shield v1.2/source/LIB_PESD3V3L4UF,115/PESD3V3L4UF,115/3D/PESD3V3L4UF,115.stp

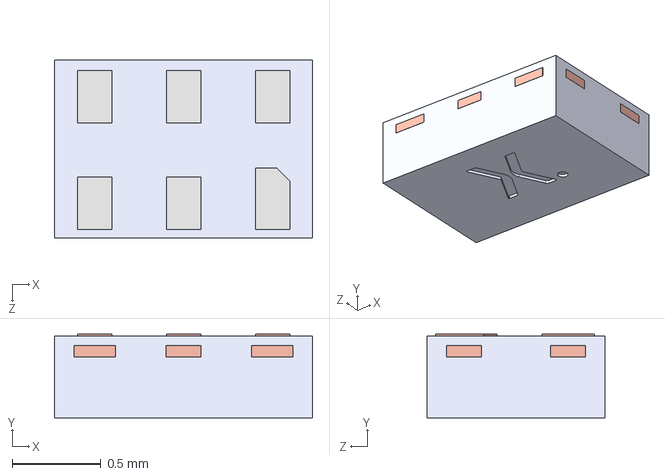
[picture p39: CAD file, 2024-08-19]
Radxa-Shield v1.2/source/LIB_PESD3V3L4UF,115/PESD3V3L4UF,115/3D/PESD3V3L4UF,115.stp
1.45 x 0.47 x 1.00 mm
SOT886 LF
SOT886 Mold Body
