Pro-engineer616/pcb_projects_Alex/Radxa-Shield v1.2/source/SSW_120_22_G_D/SSW-120-22-G-D.step

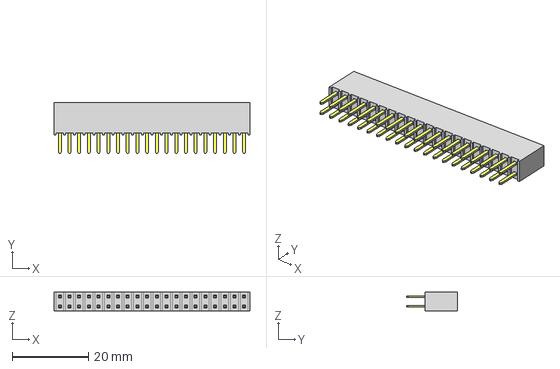
[picture p40: CAD file, 2024-08-19]
Radxa-Shield v1.2/source/SSW_120_22_G_D/SSW-120-22-G-D.step
51.3 x 13.4 x 4.95 mm
T1SSW-120-22-G-D
P2SSW-120-22-G-D
