Pro-engineer616/pcb_projects_Alex/Radxa-Shield v1.2/source/TFM-104-02-L-DH-FR/TFM-104-02-L-DH.step

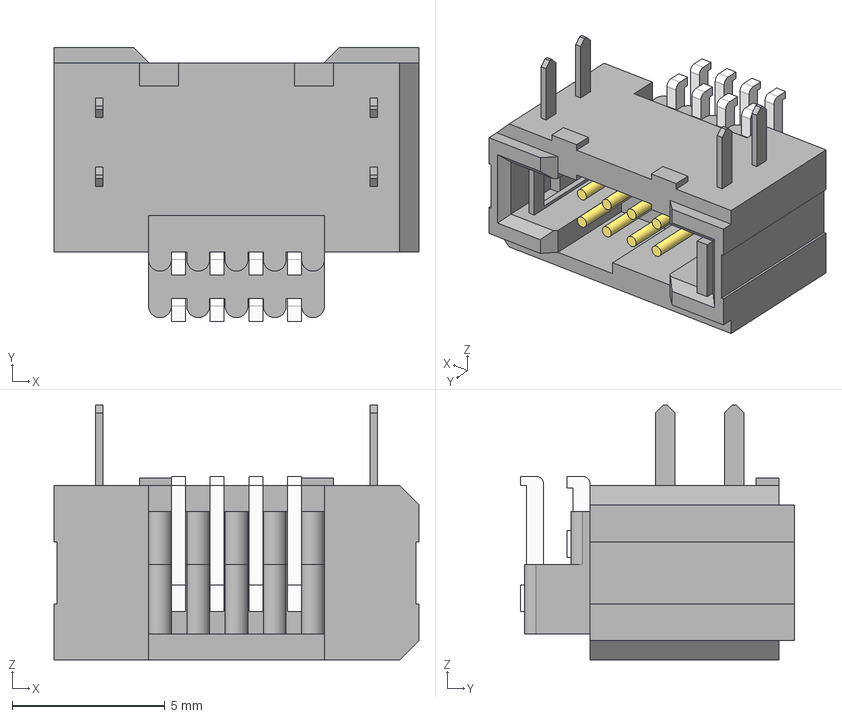
[picture p41: CAD file, 2024-08-19]
Radxa-Shield v1.2/source/TFM-104-02-L-DH-FR/TFM-104-02-L-DH.step
12.0 x 8.99 x 8.36 mm
TFM-104-02-L-DH_terminal
TFM-104-02-L-DH-L_pins
TFM-104-02-L-DH-L-2_pins
