Pro-engineer616/pcb_projects_Alex/Radxa-Shield v1.2/source/TFM_102_02_L_DH_TR/TFM-102-02-L-DH.step

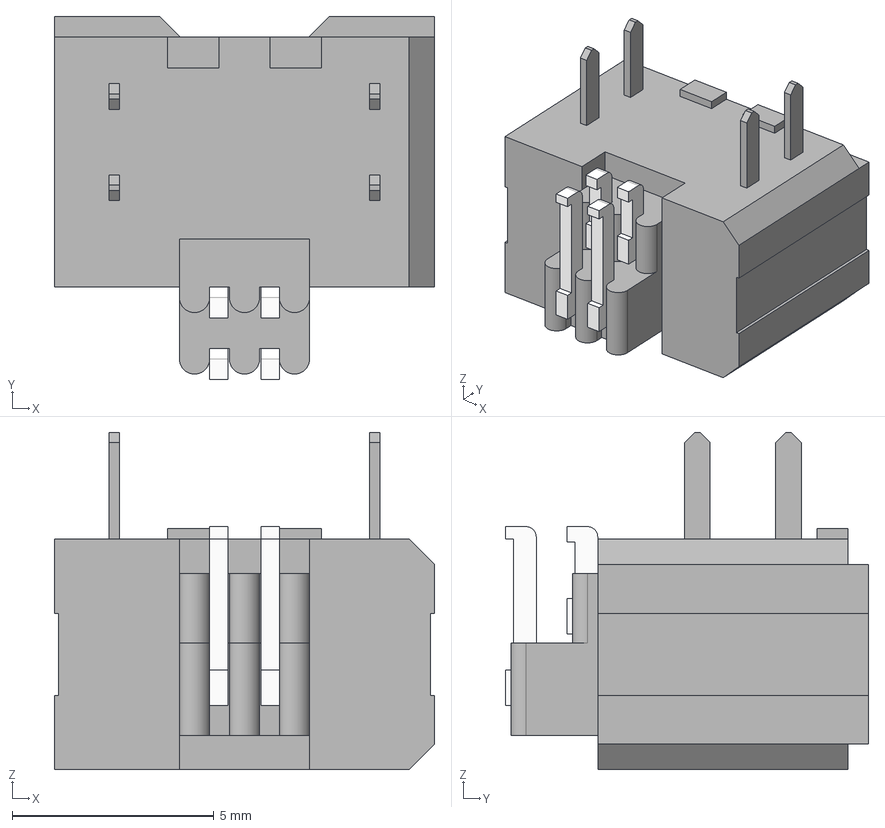
[picture p42: CAD file, 2024-08-19]
Radxa-Shield v1.2/source/TFM_102_02_L_DH_TR/TFM-102-02-L-DH.step
9.42 x 8.99 x 8.36 mm
TFM-102-02-L-DH_terminal
TFM-102-02-L-DH-L_pins
TFM-102-02-L-DH-L-2_pins
