Pro-engineer616/pcb_projects_Alex/Radxa-Shield v1.2/source/TFM_105_02_L_DH (1)/TFM-105-02-L-DH.step

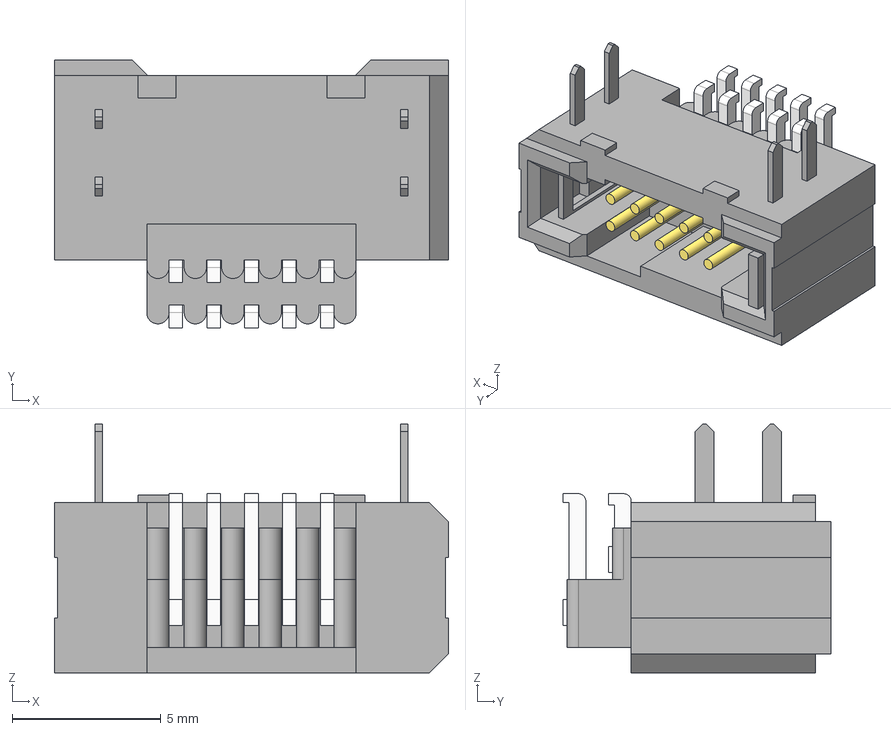
[picture p43: CAD file, 2024-08-19]
Radxa-Shield v1.2/source/TFM_105_02_L_DH (1)/TFM-105-02-L-DH.step
13.2 x 8.99 x 8.36 mm
TFM-105-02-L-DH_terminal
TFM-105-02-L-DH-L_pins
TFM-105-02-L-DH-L-2_pins
