Pro-engineer616/pcb_projects_Alex/Radxa-Shield v1.2/source/TFM_106_02_L_DH_TR/TFM-106-02-L-DH-TR.step

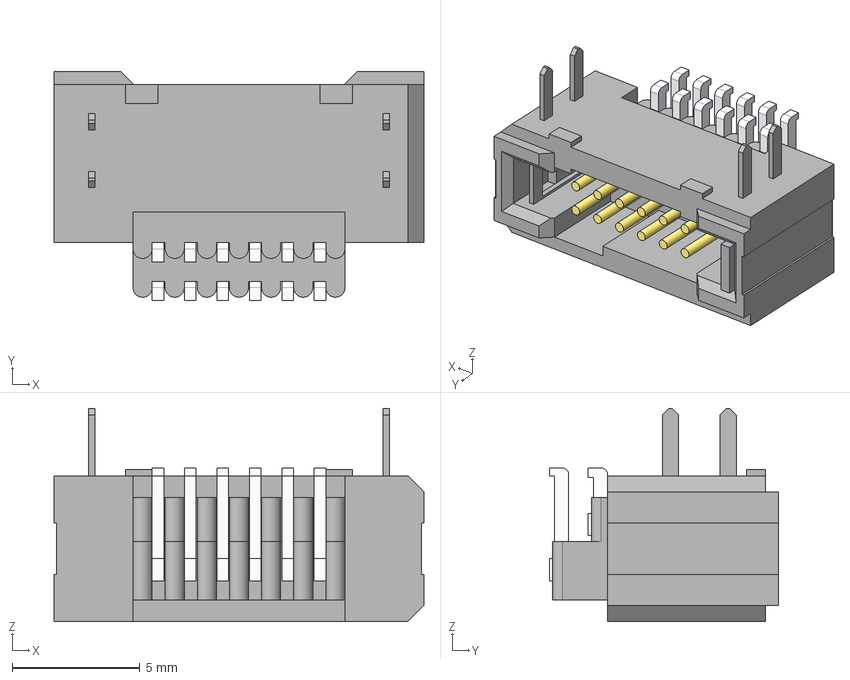
[picture p44: CAD file, 2024-08-19]
Radxa-Shield v1.2/source/TFM_106_02_L_DH_TR/TFM-106-02-L-DH-TR.step
14.5 x 8.99 x 8.36 mm
TFM-106-02-L-DH_terminal
TFM-106-02-L-DH-L_pins
TFM-106-02-L-DH-L-2_pins
