Pro-engineer616/pcb_projects_Alex/Radxa-Shield v1.2/source/TPD4EUSB30DQAR/DQA0010A.stp

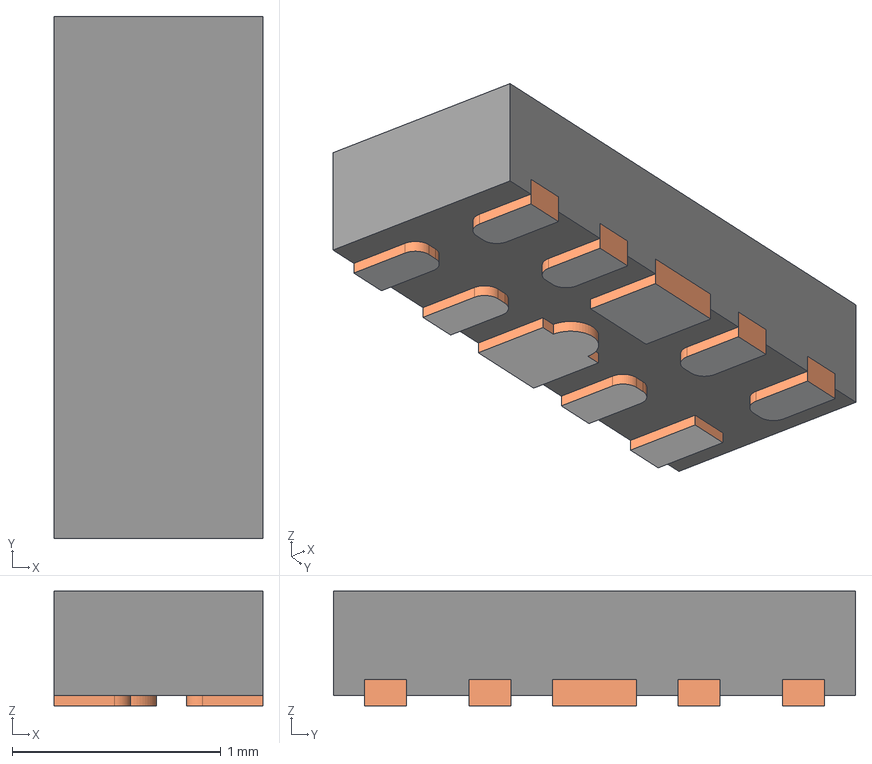
[picture p45: CAD file, 2024-08-19]
Radxa-Shield v1.2/source/TPD4EUSB30DQAR/DQA0010A.stp
1.00 x 2.50 x 0.55 mm
BODY-SON
FRAME-DQA0010A
PIN1-ID
