Pro-engineer616/pcb_projects_Alex/Radxa-Shield v1.2/source/TSX_3225_40_0000MF20X_K0/TSX-3225_40.0000MF20X-K0.step

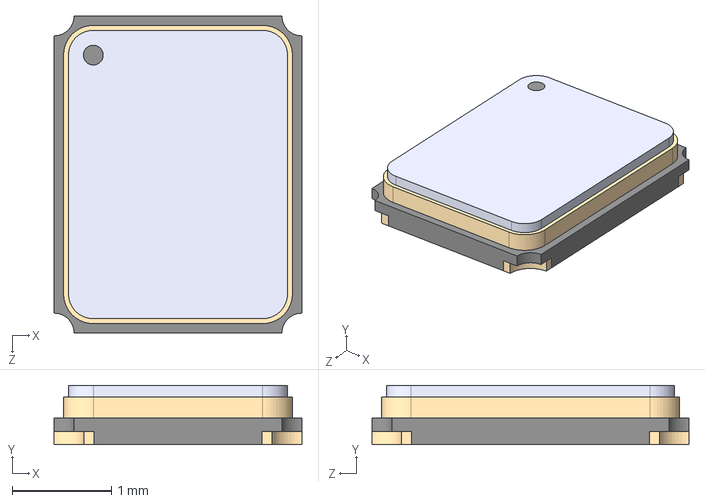
[picture p46: CAD file, 2024-08-19]
Radxa-Shield v1.2/source/TSX_3225_40_0000MF20X_K0/TSX-3225_40.0000MF20X-K0.step
2.50 x 0.6 x 3.20 mm
