Pro-engineer616/pcb_projects_Alex/Radxa-Shield v1.2/source/USB2512BI_AEZG/QFN36_6X6MC_MCH.step

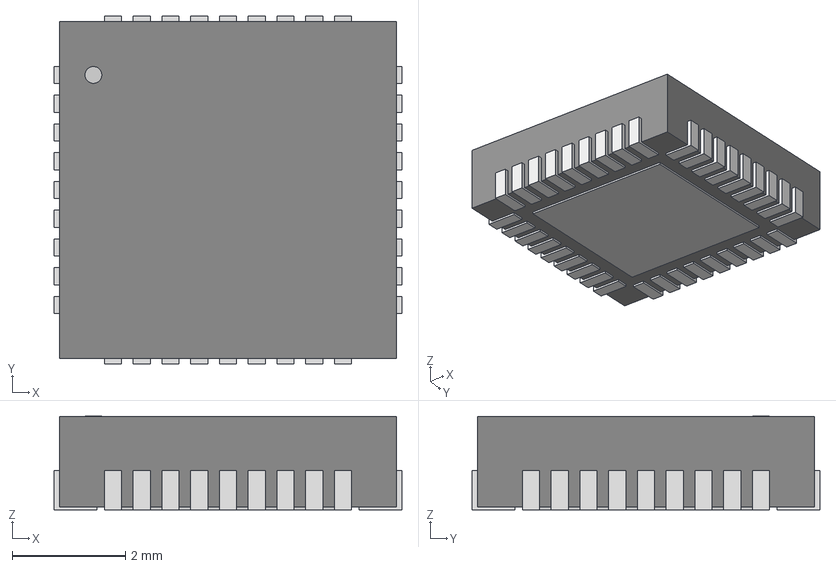
[picture p47: CAD file, 2024-08-19]
Radxa-Shield v1.2/source/USB2512BI_AEZG/QFN36_6X6MC_MCH.step
6.15 x 6.15 x 1.65 mm
