Pro-engineer616/pcb_projects_Alex/Sensor-Node v1.2/sensornodeV1.2/3d model/NCP692MN33T2G--3DModel-STEP-510211.STEP

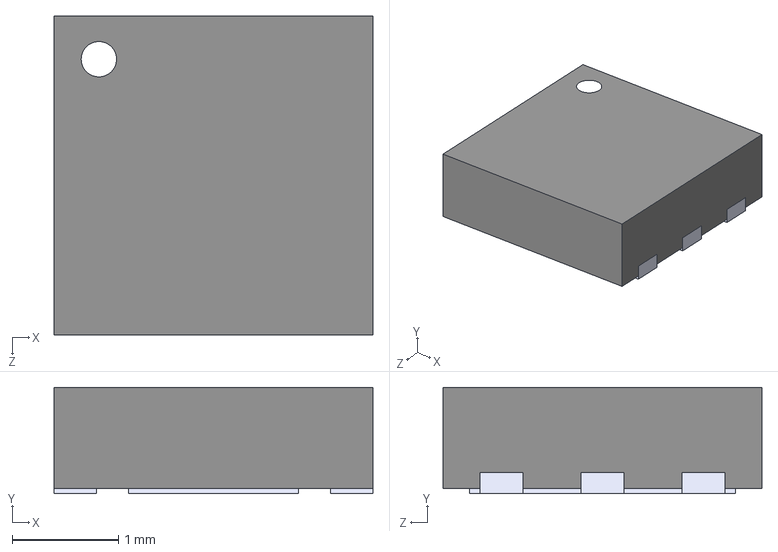
[picture p48: CAD file, 2024-08-19]
Sensor-Node v1.2/sensornodeV1.2/3d model/NCP692MN33T2G--3DModel-STEP-510211.STEP
3.00 x 1.00 x 3.00 mm
