Pro-engineer616/pcb_projects_Alex/Sensor-Node v1.2/sensornodeV1.2/5525DSO_DB001DS/c-5525dso-db001ds-b-3d.stp

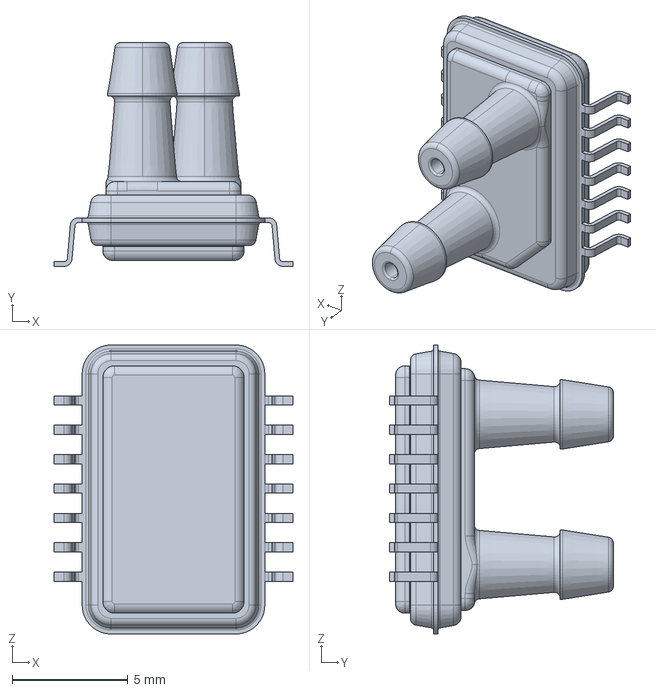
[picture p49: CAD file, 2024-08-19]
Sensor-Node v1.2/sensornodeV1.2/5525DSO_DB001DS/c-5525dso-db001ds-b-3d.stp
10.3 x 9.68 x 12.5 mm
