Pro-engineer616/pcb_projects_Alex/Sensor-Node v1.2/sensornodeV1.2/Airsensor.step

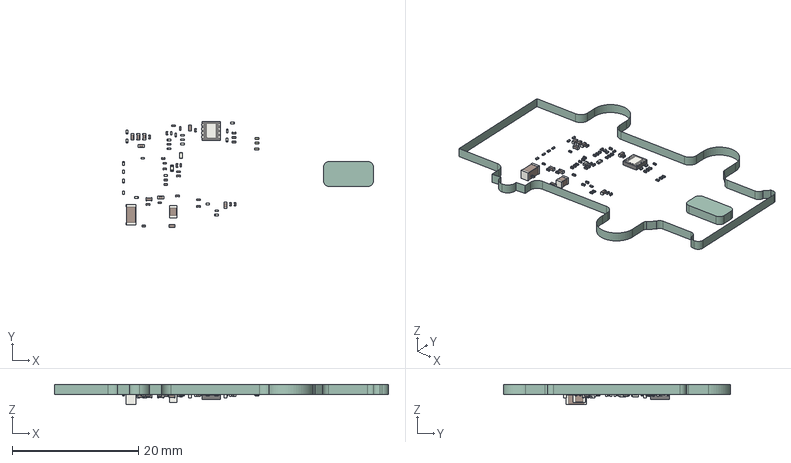
[picture p50: CAD file, 2024-08-19]
Sensor-Node v1.2/sensornodeV1.2/Airsensor.step
53.0 x 36.0 x 3.25 mm
R_0201_0603Metric x 22
C_0201_0603Metric x 26
DFN-8-1EP_3x3mm_Pitch0.65mm
C_0402_1005Metric x 9
R_0402_1005Metric x 2
LED_0201_0603Metric x 3
C_0805_2012Metric
C_1206_3216Metric
_autosave-Airspeedsensor_PCB
