Pro-engineer616/pcb_projects_Alex/Sensor-Node v1.2/sensornodeV1.2/CSD17381F4/YJC0003A_TEX.step

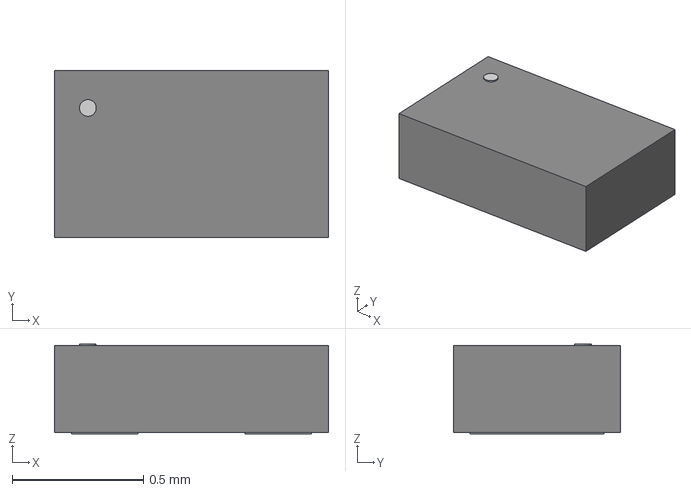
[picture p51: CAD file, 2024-09-19]
Sensor-Node v1.2/sensornodeV1.2/CSD17381F4/YJC0003A_TEX.step
1.04 x 0.636 x 0.341 mm
