Pro-engineer616/pcb_projects_Alex/Sensor-Node v1.2/sensornodeV1.2/LIB_ESDCAN03-2BM3Y/ESDCAN03-2BM3Y/3D/ESDCAN03-2BM3Y.stp

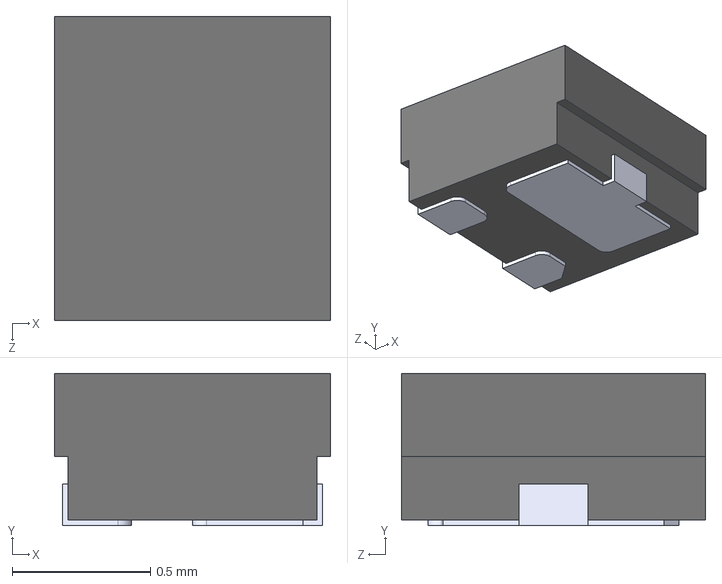
[picture p52: CAD file, 2024-08-19]
Sensor-Node v1.2/sensornodeV1.2/LIB_ESDCAN03-2BM3Y/ESDCAN03-2BM3Y/3D/ESDCAN03-2BM3Y.stp
1.00 x 0.55 x 1.10 mm
