Pro-engineer616/pcb_projects_Alex/Sensor-Node v1.2/sensornodeV1.2/LIB_KMR621NGLFS/KMR621NGLFS/3D/KMR621NGLFS.stp

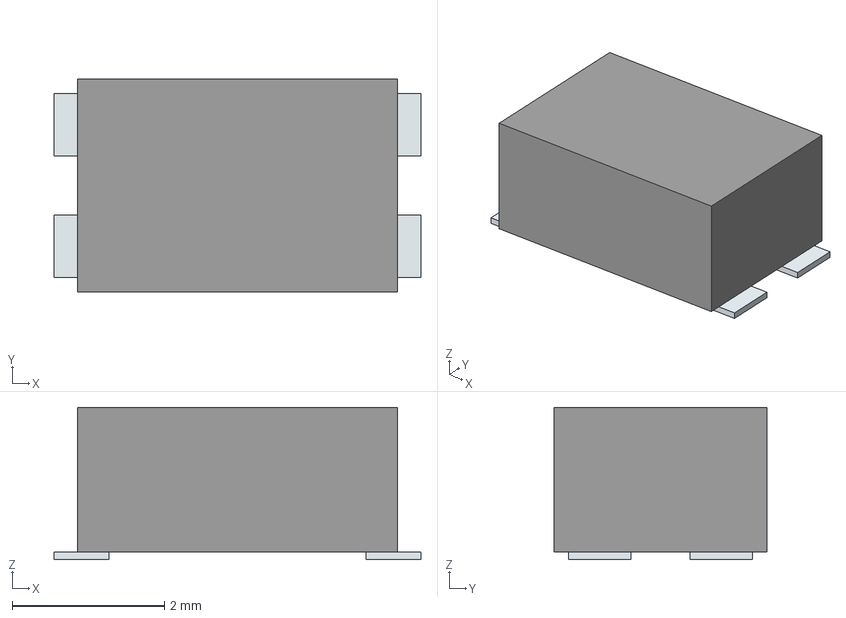
[picture p53: CAD file, 2024-08-19]
Sensor-Node v1.2/sensornodeV1.2/LIB_KMR621NGLFS/KMR621NGLFS/3D/KMR621NGLFS.stp
4.82 x 2.80 x 2.00 mm
Pins
