Pro-engineer616/pcb_projects_Alex/Sensor-Node v1.2/sensornodeV1.2/LIB_PESD3V3S1UL,315/PESD3V3S1UL,315/3D/PESD3V3S1UL,315.stp

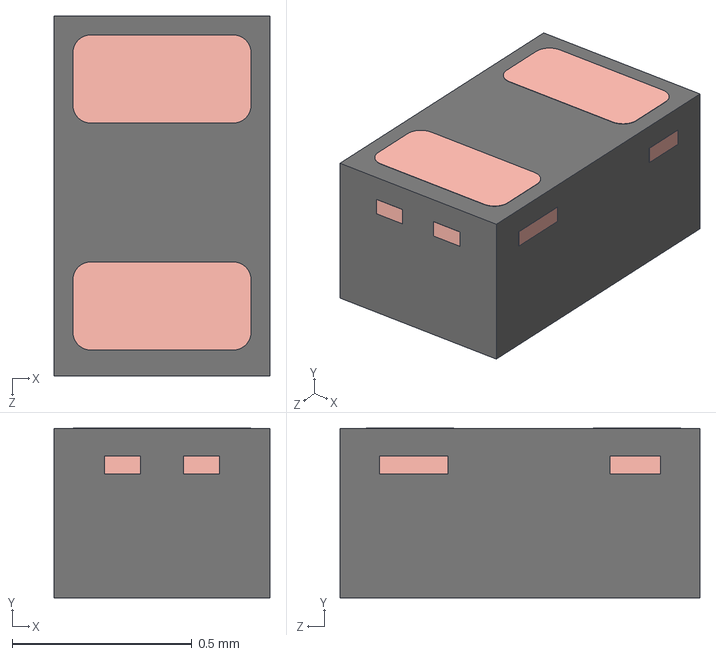
[picture p54: CAD file, 2024-08-19]
Sensor-Node v1.2/sensornodeV1.2/LIB_PESD3V3S1UL,315/PESD3V3S1UL,315/3D/PESD3V3S1UL,315.stp
0.6 x 0.471 x 1.00 mm
SOD882 body
SOD882A3 singulated LF unit
