Pro-engineer616/pcb_projects_Alex/Sensor-Node v1.2/sensornodeV1.2/STM32L431KCU6/UFQFPN-32.step

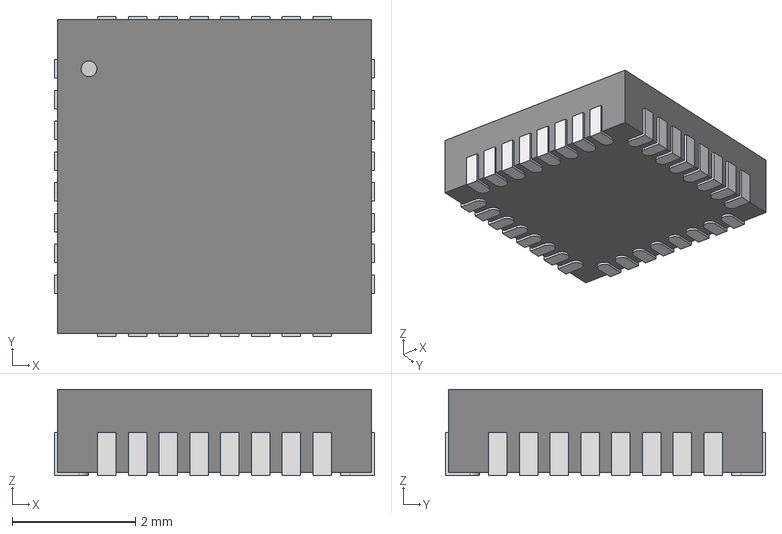
[picture p55: CAD file, 2024-08-19]
Sensor-Node v1.2/sensornodeV1.2/STM32L431KCU6/UFQFPN-32.step
5.20 x 5.20 x 1.40 mm
