Pro-engineer616/pcb_projects_Alex/Sensor-Node v1.2/sensornodeV1.2/TFM_102_02_L_D_WT/TFM-102-02-L-D-WT.step

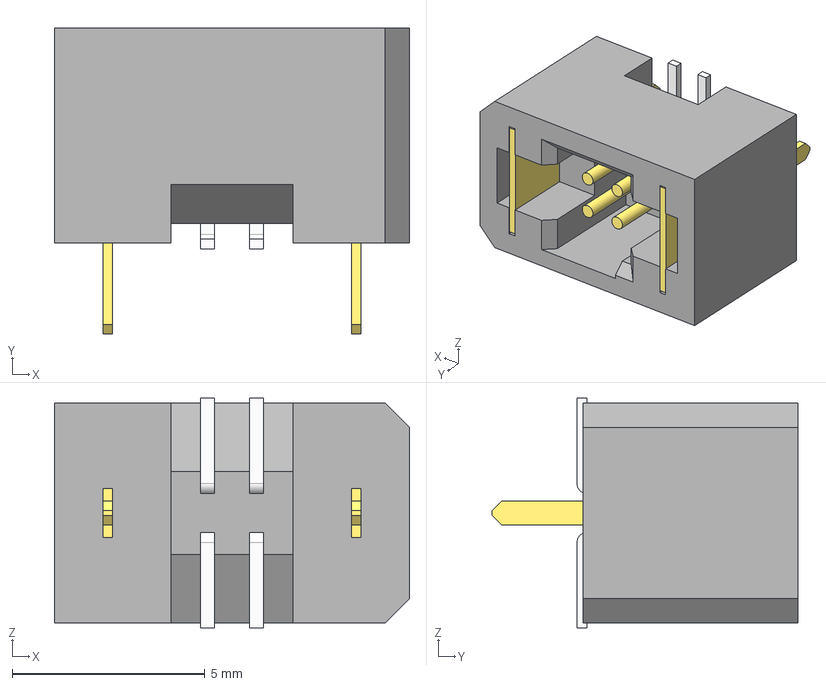
[picture p56: CAD file, 2024-08-19]
Sensor-Node v1.2/sensornodeV1.2/TFM_102_02_L_D_WT/TFM-102-02-L-D-WT.step
9.22 x 7.95 x 5.97 mm
TFM-102-02-L-D-WT_terminal
TFM-102-02-L-D-L_pins
TFM-102-02-L-D-L-2_pins
WT-25-04-T x 2
