Pro-engineer616/pcb_projects_Alex/Sensor-Node v1.2/sensornodeV1.2/TJA1051TK_3_118/HVSON08_3X3_NXP.step

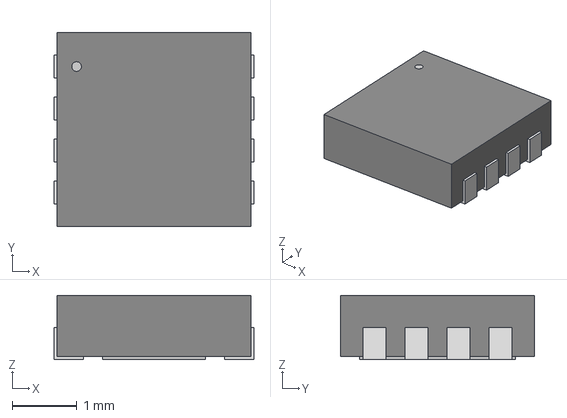
[picture p57: CAD file, 2024-08-19]
Sensor-Node v1.2/sensornodeV1.2/TJA1051TK_3_118/HVSON08_3X3_NXP.step
3.10 x 3.00 x 0.993 mm
