Pro-engineer616/pcb_projects_Alex/Sensor-Node v1.2/sensornodeV1.2/3d model/STM32L431CCT6.step

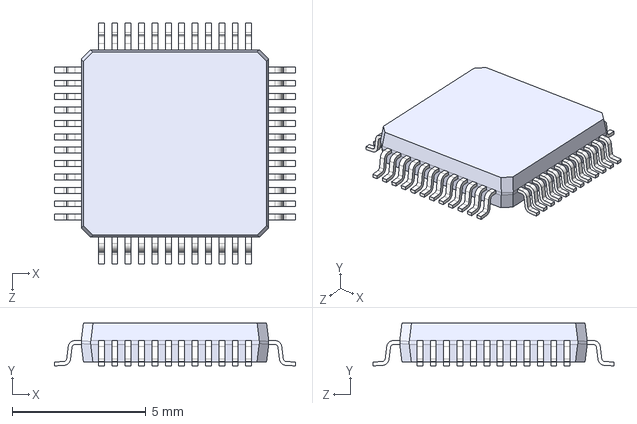
[picture p58: CAD file, 2024-08-19]
Sensor-Node v1.2/sensornodeV1.2/3d model/STM32L431CCT6.step
9.00 x 1.60 x 9.00 mm
