Pro-engineer616/pcb_projects_Alex/Sensor-Node v1.2/sensornodeV1.2/3d model/DFN6_3X3_ONS.step

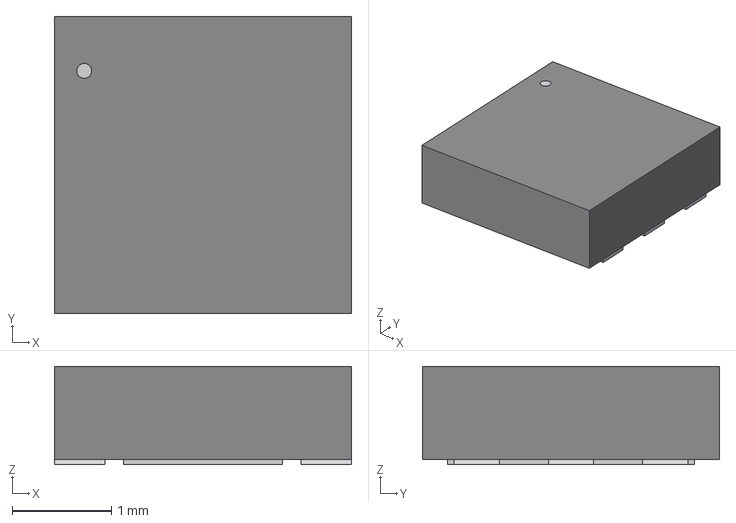
[picture p59: CAD file, 2024-08-19]
Sensor-Node v1.2/sensornodeV1.2/3d model/DFN6_3X3_ONS.step
3.00 x 3.00 x 0.993 mm
