Pro-engineer616/pcb_projects_Alex/Sensor-Node v1.2/sensornodeV1.2/3d model/SM10B-GHS-TB.STEP

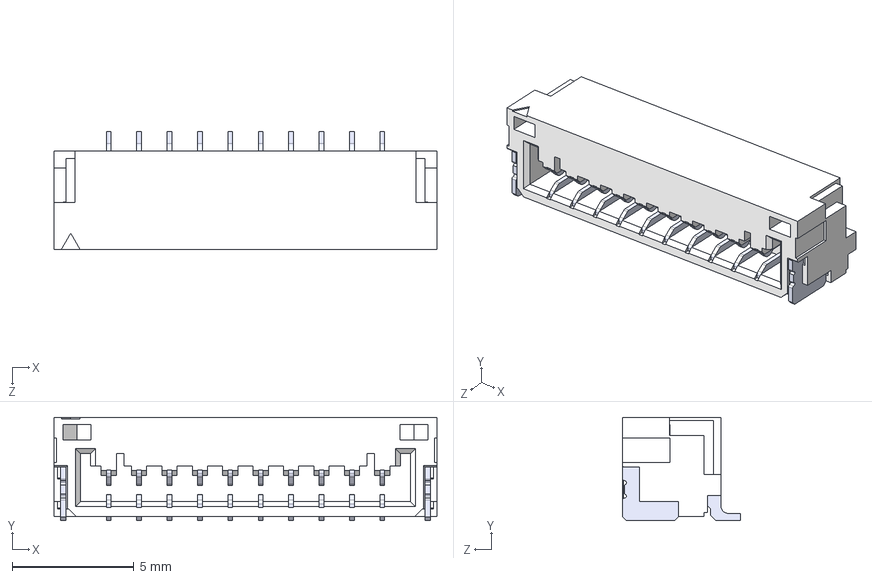
[picture p60: CAD file, 2024-08-19]
Sensor-Node v1.2/sensornodeV1.2/3d model/SM10B-GHS-TB.STEP
15.8 x 4.25 x 4.85 mm
SMxB-GHS-TB 8plus_10
pin x 10
