Pro-engineer616/pcb_projects_Alex/infrastructure-board/source/infrastructure/package/magnetics/T.step

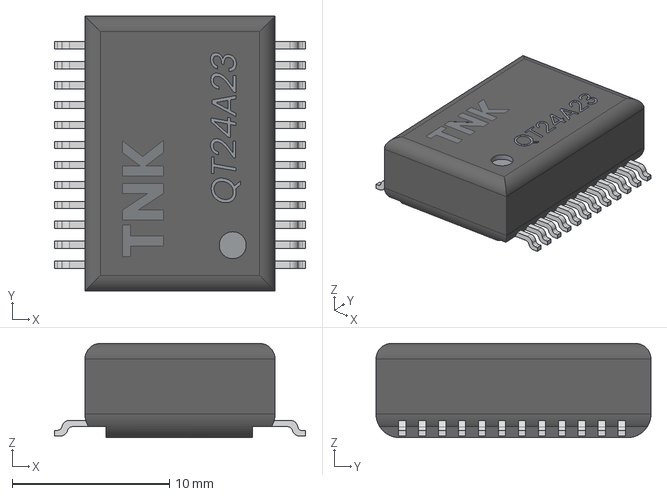
[picture p61: CAD file, 2024-08-29]
infrastructure-board/source/infrastructure/package/magnetics/T.step
16.0 x 17.5 x 6.00 mm
