Pro-engineer616/pcb_projects_Alex/Sensor-Node v1.2/sensornodeV1.2/3d model/AUAV-RR.STEP

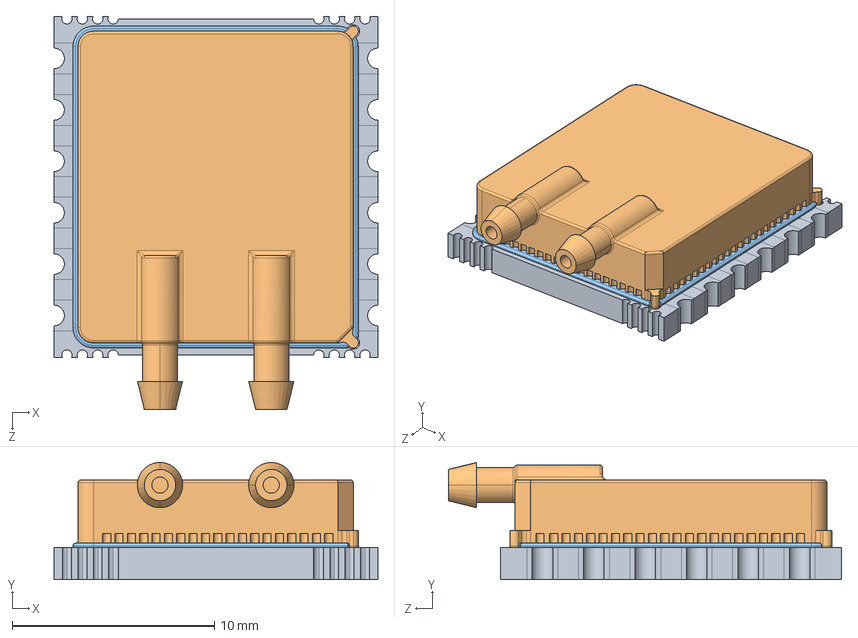
[picture p62: CAD file, 2024-08-19]
Sensor-Node v1.2/sensornodeV1.2/3d model/AUAV-RR.STEP
16.0 x 5.78 x 19.4 mm
PCB AS01-08-078A
AS01-01-060 Rev A1
Adhesive
