Pro-engineer616/pcb_projects_Alex/Sensor-Node v1.2/sensornodeV1.2/3d model/MS215-10S.step

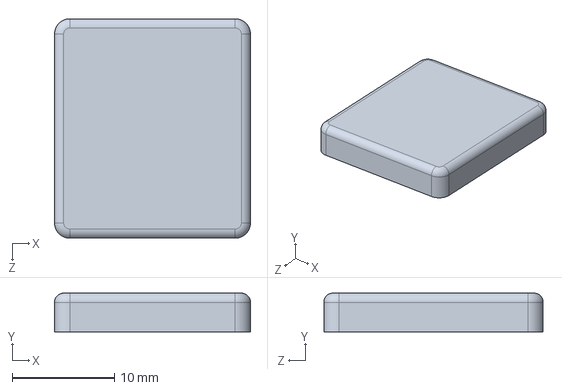
[picture p63: CAD file, 2024-08-19]
Sensor-Node v1.2/sensornodeV1.2/3d model/MS215-10S.step
19.2 x 3.80 x 21.5 mm
