Pro-engineer616/pcb_projects_Alex/Sensor-Node v1.2/sensornodeV1.2/3d model/SM06B-GHS-TB.step

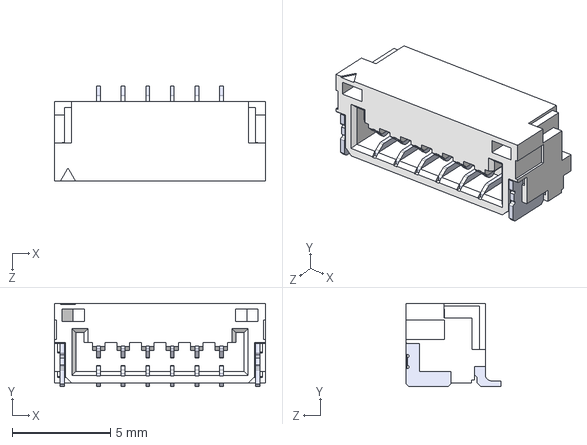
[picture p64: CAD file, 2024-08-19]
Sensor-Node v1.2/sensornodeV1.2/3d model/SM06B-GHS-TB.step
10.8 x 4.25 x 4.85 mm
SMxB-GHS-TB_06
pin x 6
