Pro-engineer616/pcb_projects_Alex/Sensor-Node v1.2/sensornodeV1.2/3d model/LQFP-48.step

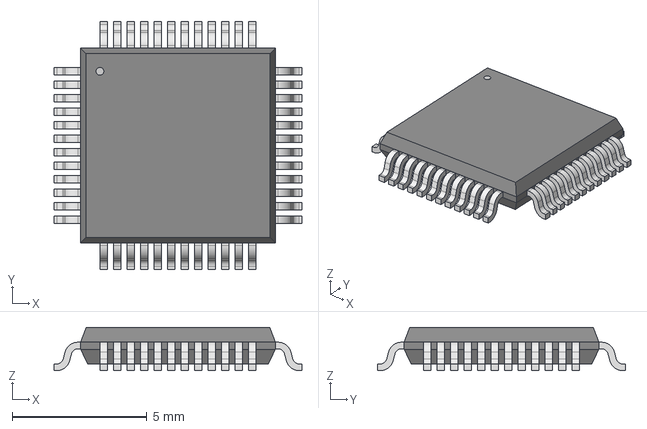
[picture p65: CAD file, 2024-08-19]
Sensor-Node v1.2/sensornodeV1.2/3d model/LQFP-48.step
9.19 x 9.19 x 1.60 mm
