Pro-engineer616/pcb_projects_Alex/Sensor-Node v1.2/sensornodeV1.2/3d model/Sensirion_Differential_Pressure_Sensors_SDP3x.step

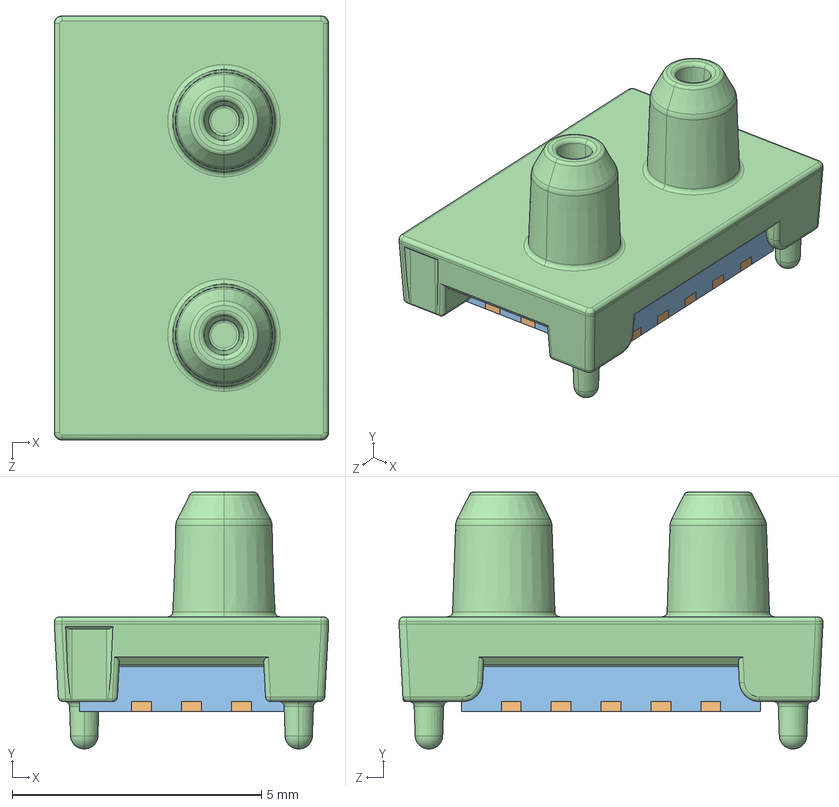
[picture p66: CAD file, 2024-08-19]
Sensor-Node v1.2/sensornodeV1.2/3d model/Sensirion_Differential_Pressure_Sensors_SDP3x.step
5.50 x 5.15 x 8.50 mm
