Pro-engineer616/pcb_projects_Alex/Sensor-Node v1.2/sensornodeV1.2/3d model/PNI_RM3100_MagIC_QFN_4X4.STEP

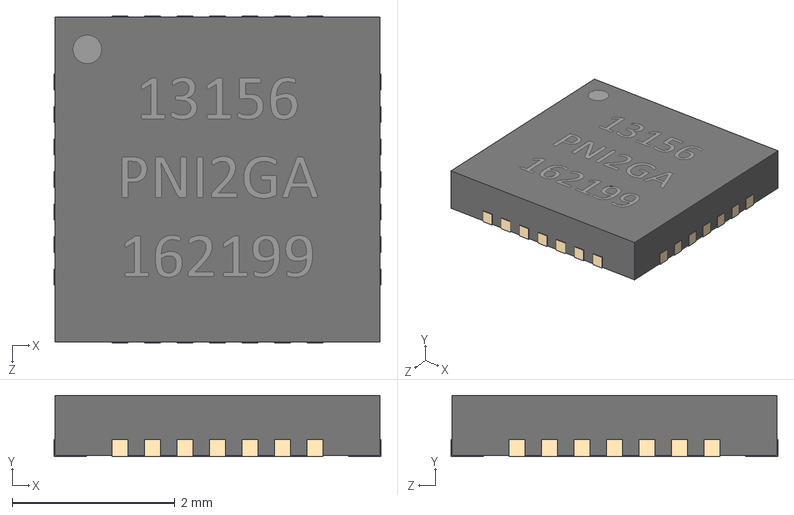
[picture p67: CAD file, 2024-08-19]
Sensor-Node v1.2/sensornodeV1.2/3d model/PNI_RM3100_MagIC_QFN_4X4.STEP
4.02 x 0.75 x 4.02 mm
