Pro-engineer616/pcb_projects_Alex/(list of files, cad)

Other CAD files:
Sensor-Node v1.2/sensornodeV1.2/TFM_103_02_L_DH_TR/TFM-103-02-L-DH.step
infrastructure-board/source/infrastructure/package/magnetics/Part Studio 1.step
PDB v1.1/PDB1.1/source/PDB/package/1719710106 (1)/1719710106.step
PDB v1.1/PDB1.1/source/PDB/package/1719710106/1719710106.step
PDB v1.1/PDB1.1/source/PDB/package/2132250430 (1)/2132250430.step
PDB v1.1/PDB1.1/source/PDB/package/2132250430/2132250430.step
PDB v1.1/PDB_1.0/source/source/package/1719710106 (1)/1719710106.step
PDB v1.1/PDB_1.0/source/source/package/1719710106/1719710106.step
PDB v1.1/PDB_1.0/source/source/package/2132250430 (1)/2132250430.step
PDB v1.1/PDB_1.0/source/source/package/2132250430/2132250430.step
PDB v1.2/PDB1.step
PDB v1.2/bottom.DXF
PDB v1.2/top.DXF
PDB v1.4/source/PDB1.4/package/1719710106 (1)/1719710106.step
PDB v1.4/source/PDB1.4/package/1719710106/1719710106.step
PDB v1.4/source/PDB1.4/package/2132250430 (1)/2132250430.step
PDB v1.4/source/PDB1.4/package/2132250430/2132250430.step
Radxa-Shield v1.1/Radxa Shield 1.0/production/RADXA5.0_V1.1.step
Radxa-Shield v1.1/Radxa Shield 1.0/source/LIB_PESD3V3L4UF,115/PESD3V3L4UF,115/Allegro/pesd3v3l5uf115.psm
Radxa-Shield v1.1/Radxa Shield 1.0/source/LIB_PESD3V3L4UF,115/PESD3V3L4UF,115/DEHDL/pesd3v3l4uf_115/chips/chips.prt
Radxa-Shield v1.2/source/LIB_PESD3V3L4UF,115/PESD3V3L4UF,115/Allegro/pesd3v3l5uf115.psm
Radxa-Shield v1.2/source/LIB_PESD3V3L4UF,115/PESD3V3L4UF,115/DEHDL/pesd3v3l4uf_115/chips/chips.prt
Sensor-Node v1.1/Sensor_node_1.0/Airspeed_pcb.step
Sensor-Node v1.1/Sensor_node_1.0/LIB_KMR621NGLFS/KMR621NGLFS/Allegro/kmr621nglfs.psm
Sensor-Node v1.1/Sensor_node_1.0/LIB_KMR621NGLFS/KMR621NGLFS/DEHDL/kmr621nglfs/chips/chips.prt
Sensor-Node v1.1/Sensor_node_1.0/LIB_PESD3V3S1UL,315/PESD3V3S1UL,315/Allegro/pesd5v0s1bl315.psm
Sensor-Node v1.1/Sensor_node_1.0/LIB_PESD3V3S1UL,315/PESD3V3S1UL,315/DEHDL/pesd3v3s1ul_315/chips/chips.prt
Sensor-Node v1.1/Sensor_node_1.0/LIB_TS-1088R-02026/TS-1088R-02026/Allegro/ts1088r02026.psm
Sensor-Node v1.1/Sensor_node_1.0/LIB_TS-1088R-02026/TS-1088R-02026/DEHDL/ts_1088r_02026/chips/chips.prt
Sensor-Node v1.1/Sensor_node_1.0/Radxa-shield/production/RADXA5.0.step
Sensor-Node v1.2/sensornodeV1.2/LIB_KMR621NGLFS/KMR621NGLFS/Allegro/kmr621nglfs.psm
Sensor-Node v1.2/sensornodeV1.2/LIB_KMR621NGLFS/KMR621NGLFS/DEHDL/kmr621nglfs/chips/chips.prt
Sensor-Node v1.2/sensornodeV1.2/LIB_PESD3V3S1UL,315/PESD3V3S1UL,315/Allegro/pesd5v0s1bl315.psm
Sensor-Node v1.2/sensornodeV1.2/LIB_PESD3V3S1UL,315/PESD3V3S1UL,315/DEHDL/pesd3v3s1ul_315/chips/chips.prt
Sensor-Node v1.2/sensornodeV1.2/LIB_TS-1088R-02026/TS-1088R-02026/Allegro/ts1088r02026.psm
Sensor-Node v1.2/sensornodeV1.2/LIB_TS-1088R-02026/TS-1088R-02026/DEHDL/ts_1088r_02026/chips/chips.prt
infrastructure-board/source/infrastructure/package/151583533-19-2132271210/2132271210.stp
infrastructure-board/source/infrastructure/package/1719710105 (1)/1719710105.step
infrastructure-board/source/infrastructure/package/1719710106 (1)/1719710106.step
infrastructure-board/source/infrastructure/package/1719710106/1719710106.step
infrastructure-board/source/infrastructure/package/2132250430 (1)/2132250430.step
infrastructure-board/source/infrastructure/package/2132250430/2132250430.step
infrastructure-board/source/infrastructure/package/LIB_IP175G/IP175G/Allegro/qfn40p600x600x90-49n-d.psm
infrastructure-board/source/infrastructure/package/LIB_IP175G/IP175G/DEHDL/ip175g/chips/chips.prt
infrastructure-board/source/infrastructure/package/LIB_QT48A03/QT48A03/Allegro/sop102p1536x780-48n.psm
infrastructure-board/source/infrastructure/package/LIB_QT48A03/QT48A03/DEHDL/qt48a03/chips/chips.prt
infrastructure-board/source/infrastructure/package/TFM_105_02_L_DH/TFM-105-02-L-DH.step
infrastructure-board/source/infrastructure/package/TFM_106_02_L_DH_TR/TFM-106-02-L-DH-TR.step
infrastructure-board/source/infrastructure/package/magnetics/530470210.stp
infrastructure-board/source/infrastructure/package/magnetics/530470410.stp
infrastructure-board/source/infrastructure/package/magnetics/Part Studio 1 Copy 1.step
infrastructure-board/source/infrastructure/package/magnetics/Part Studio 1 Copy 2.step
