Pro-engineer616/pcb_projects_Alex/Radxa-Shield v1.2/source/Radxa Shield Rev. 1.2.pdf

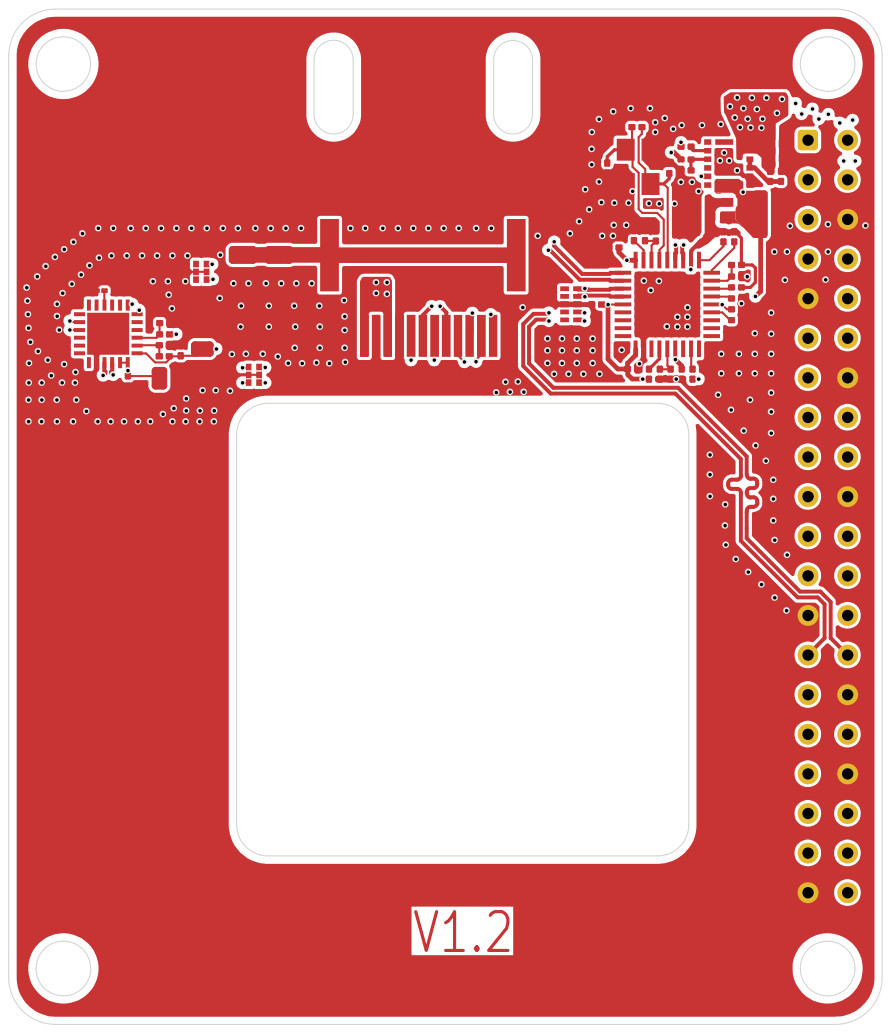
[picture p68: page 1]

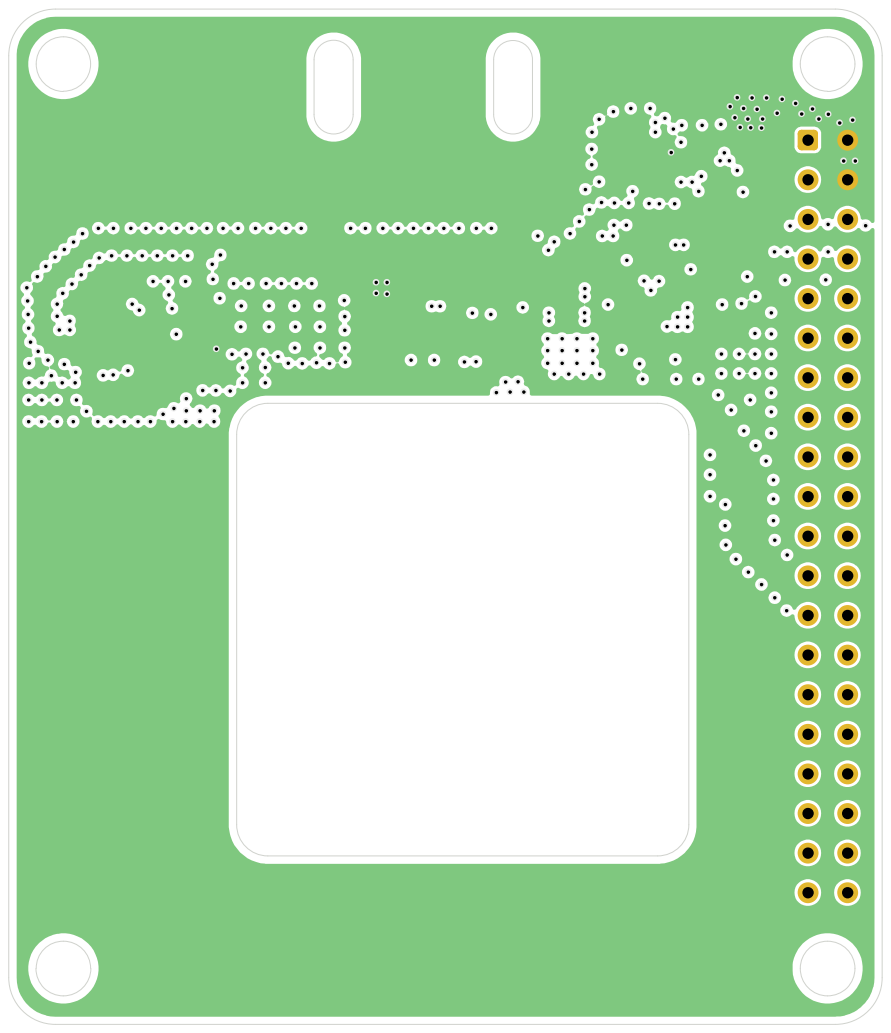
[picture p69: page 2]

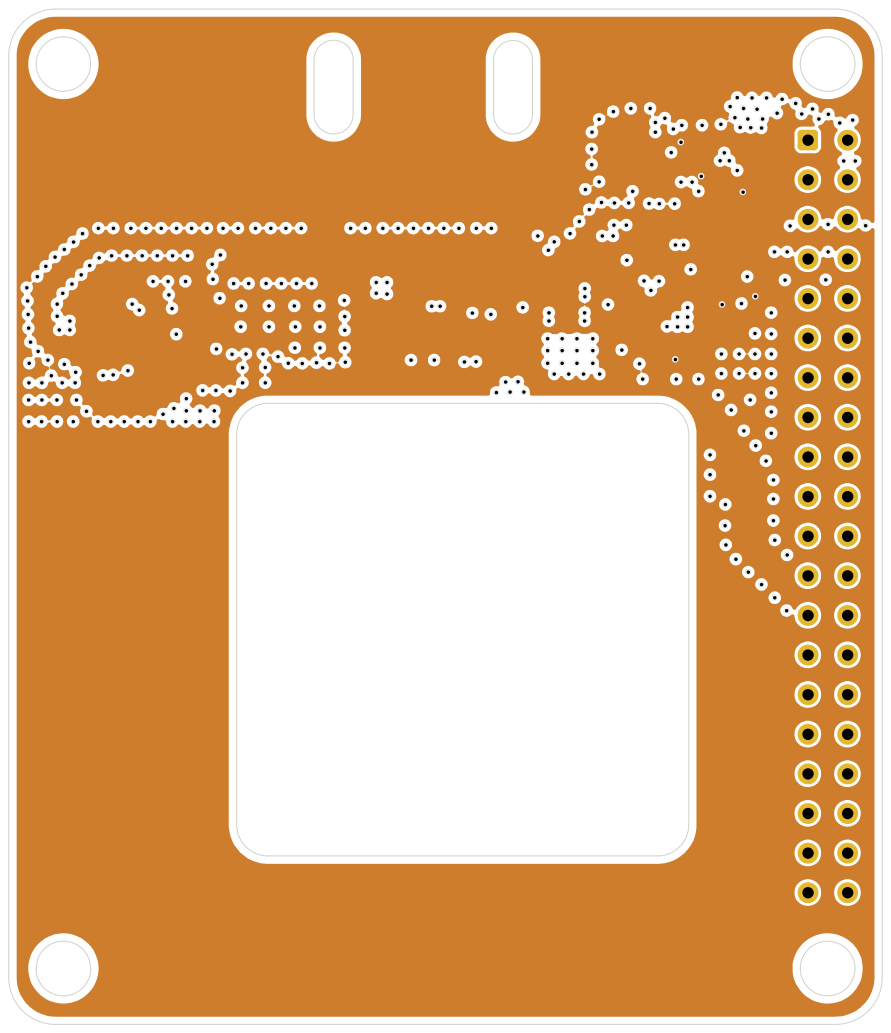
[picture p70: page 3]

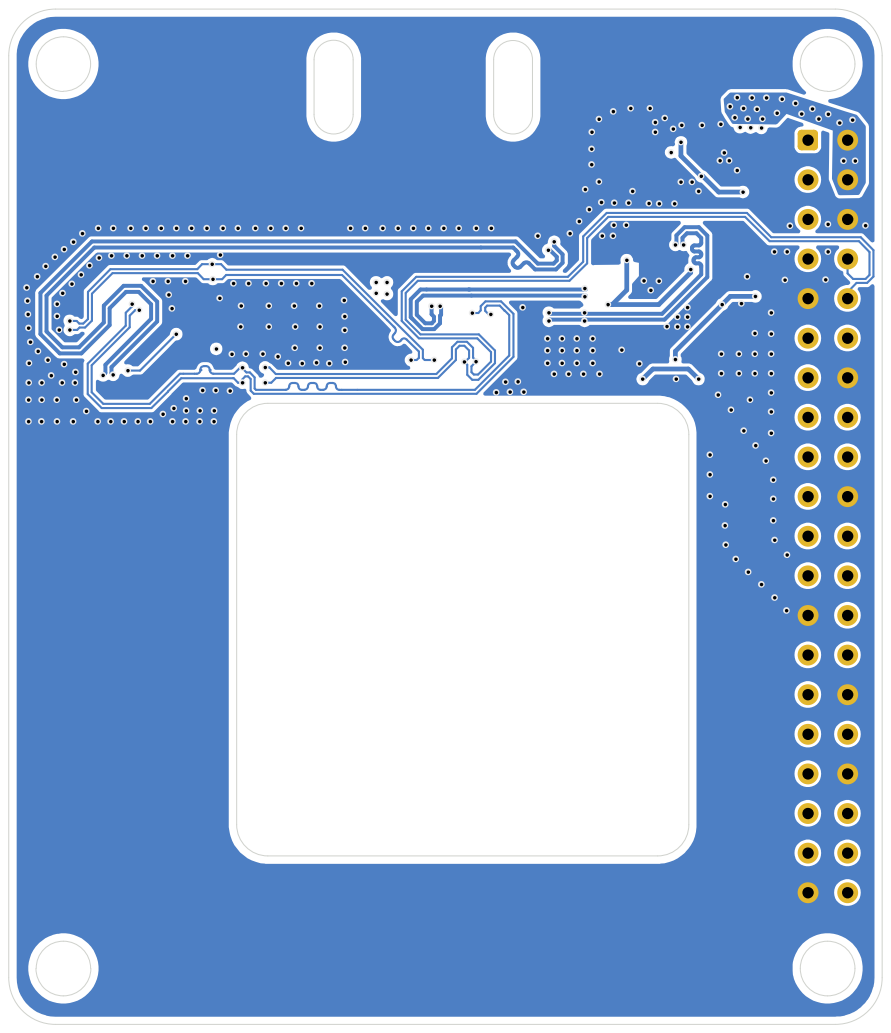
[picture p71: page 4]
