Pro-engineer616/pcb_projects_Alex/infrastructure-board/source/infrastructure/Infrastructure_circuit.pdf

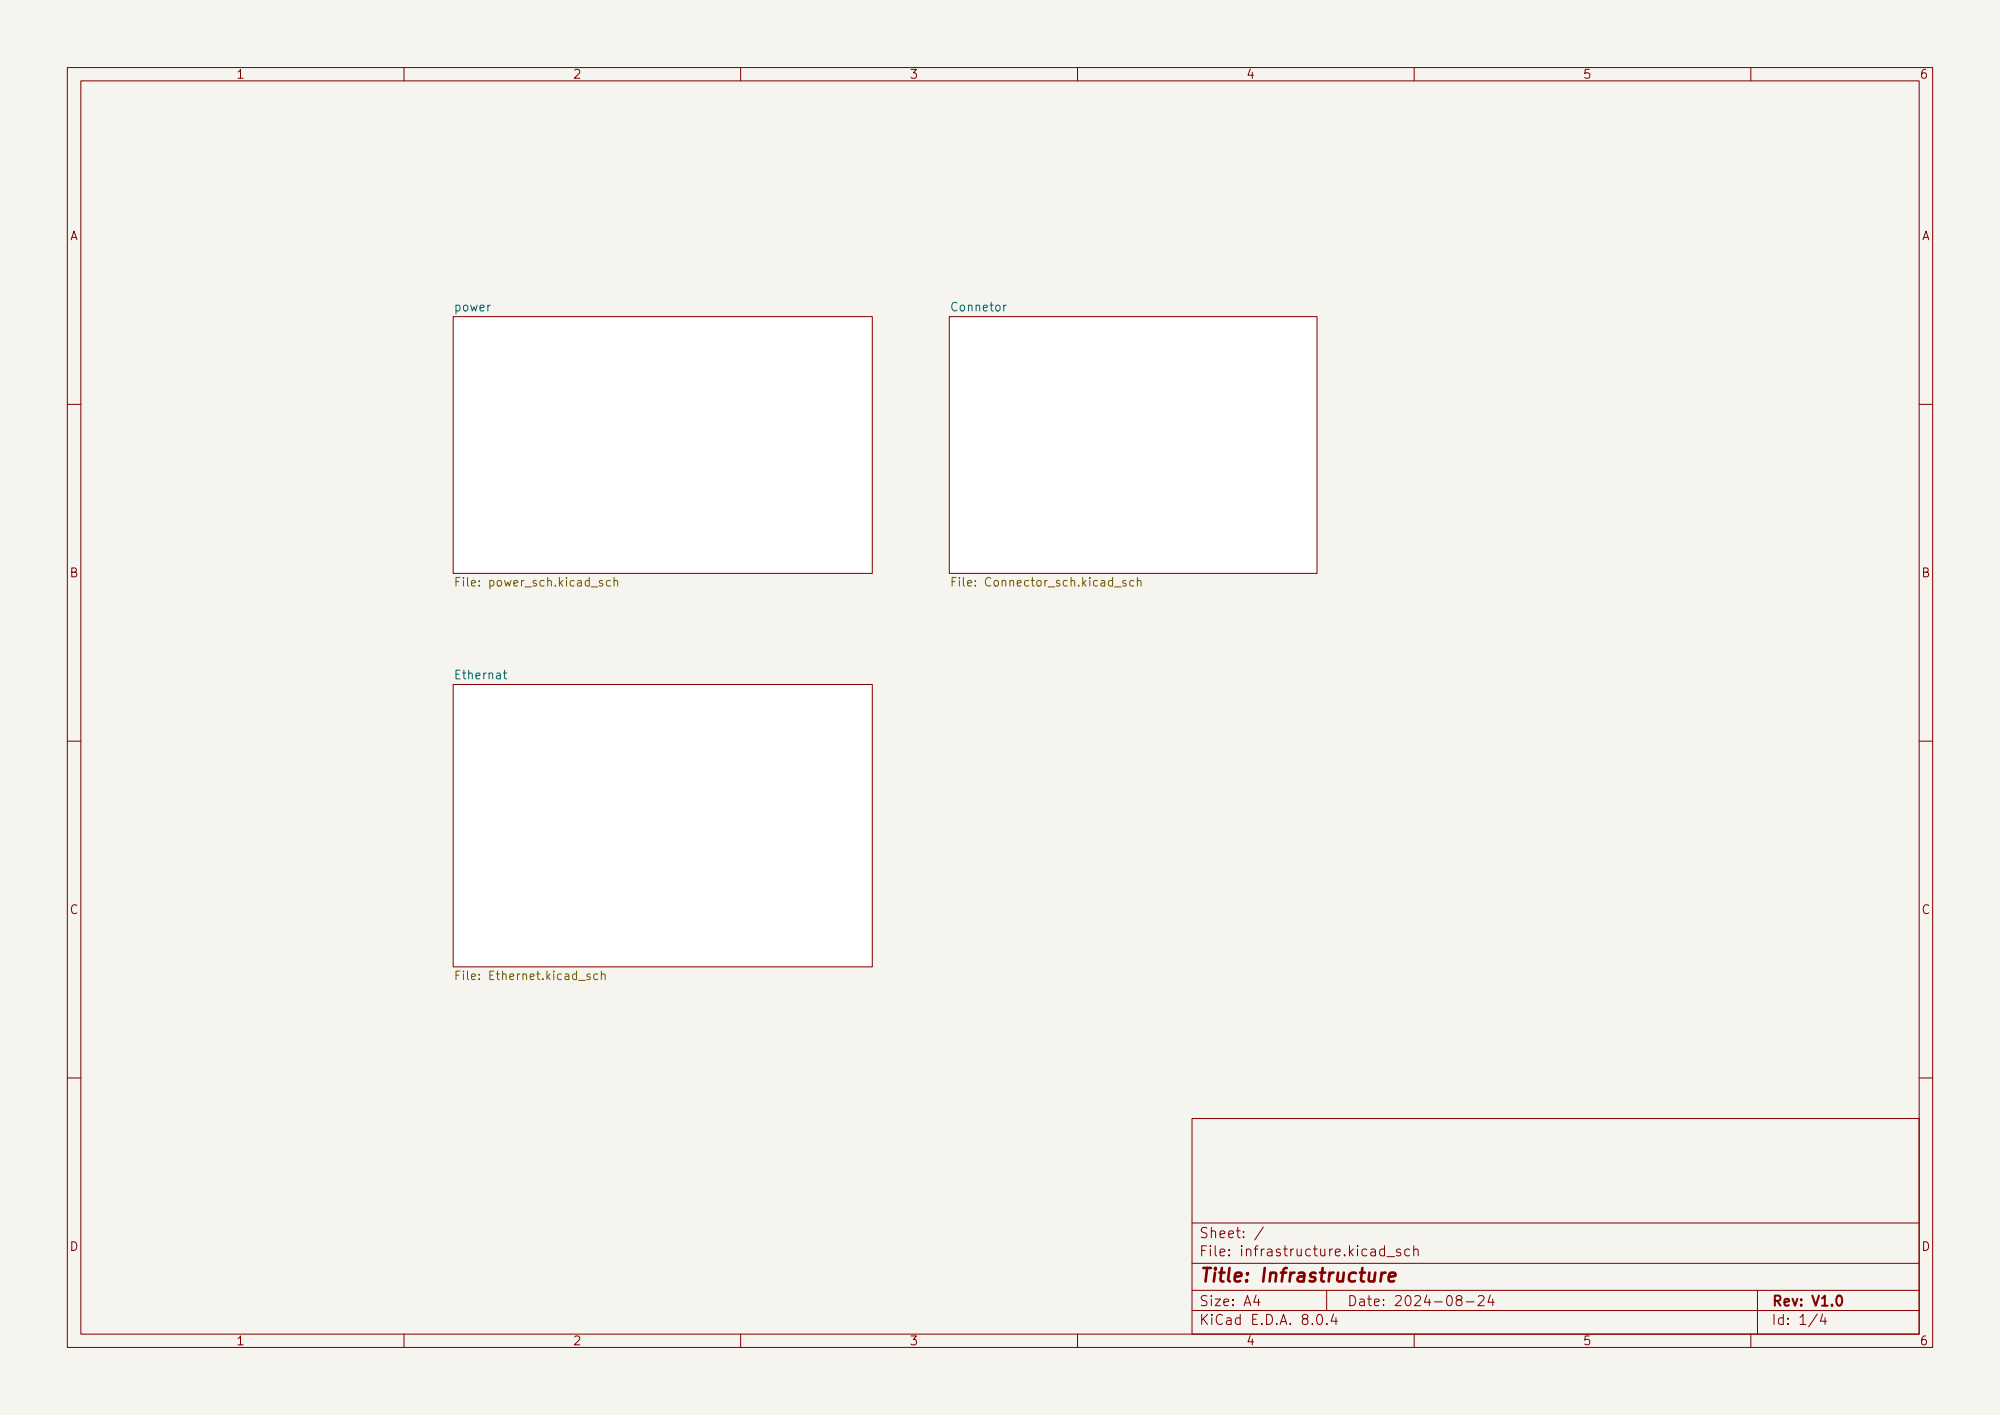
[picture p72: page 1]

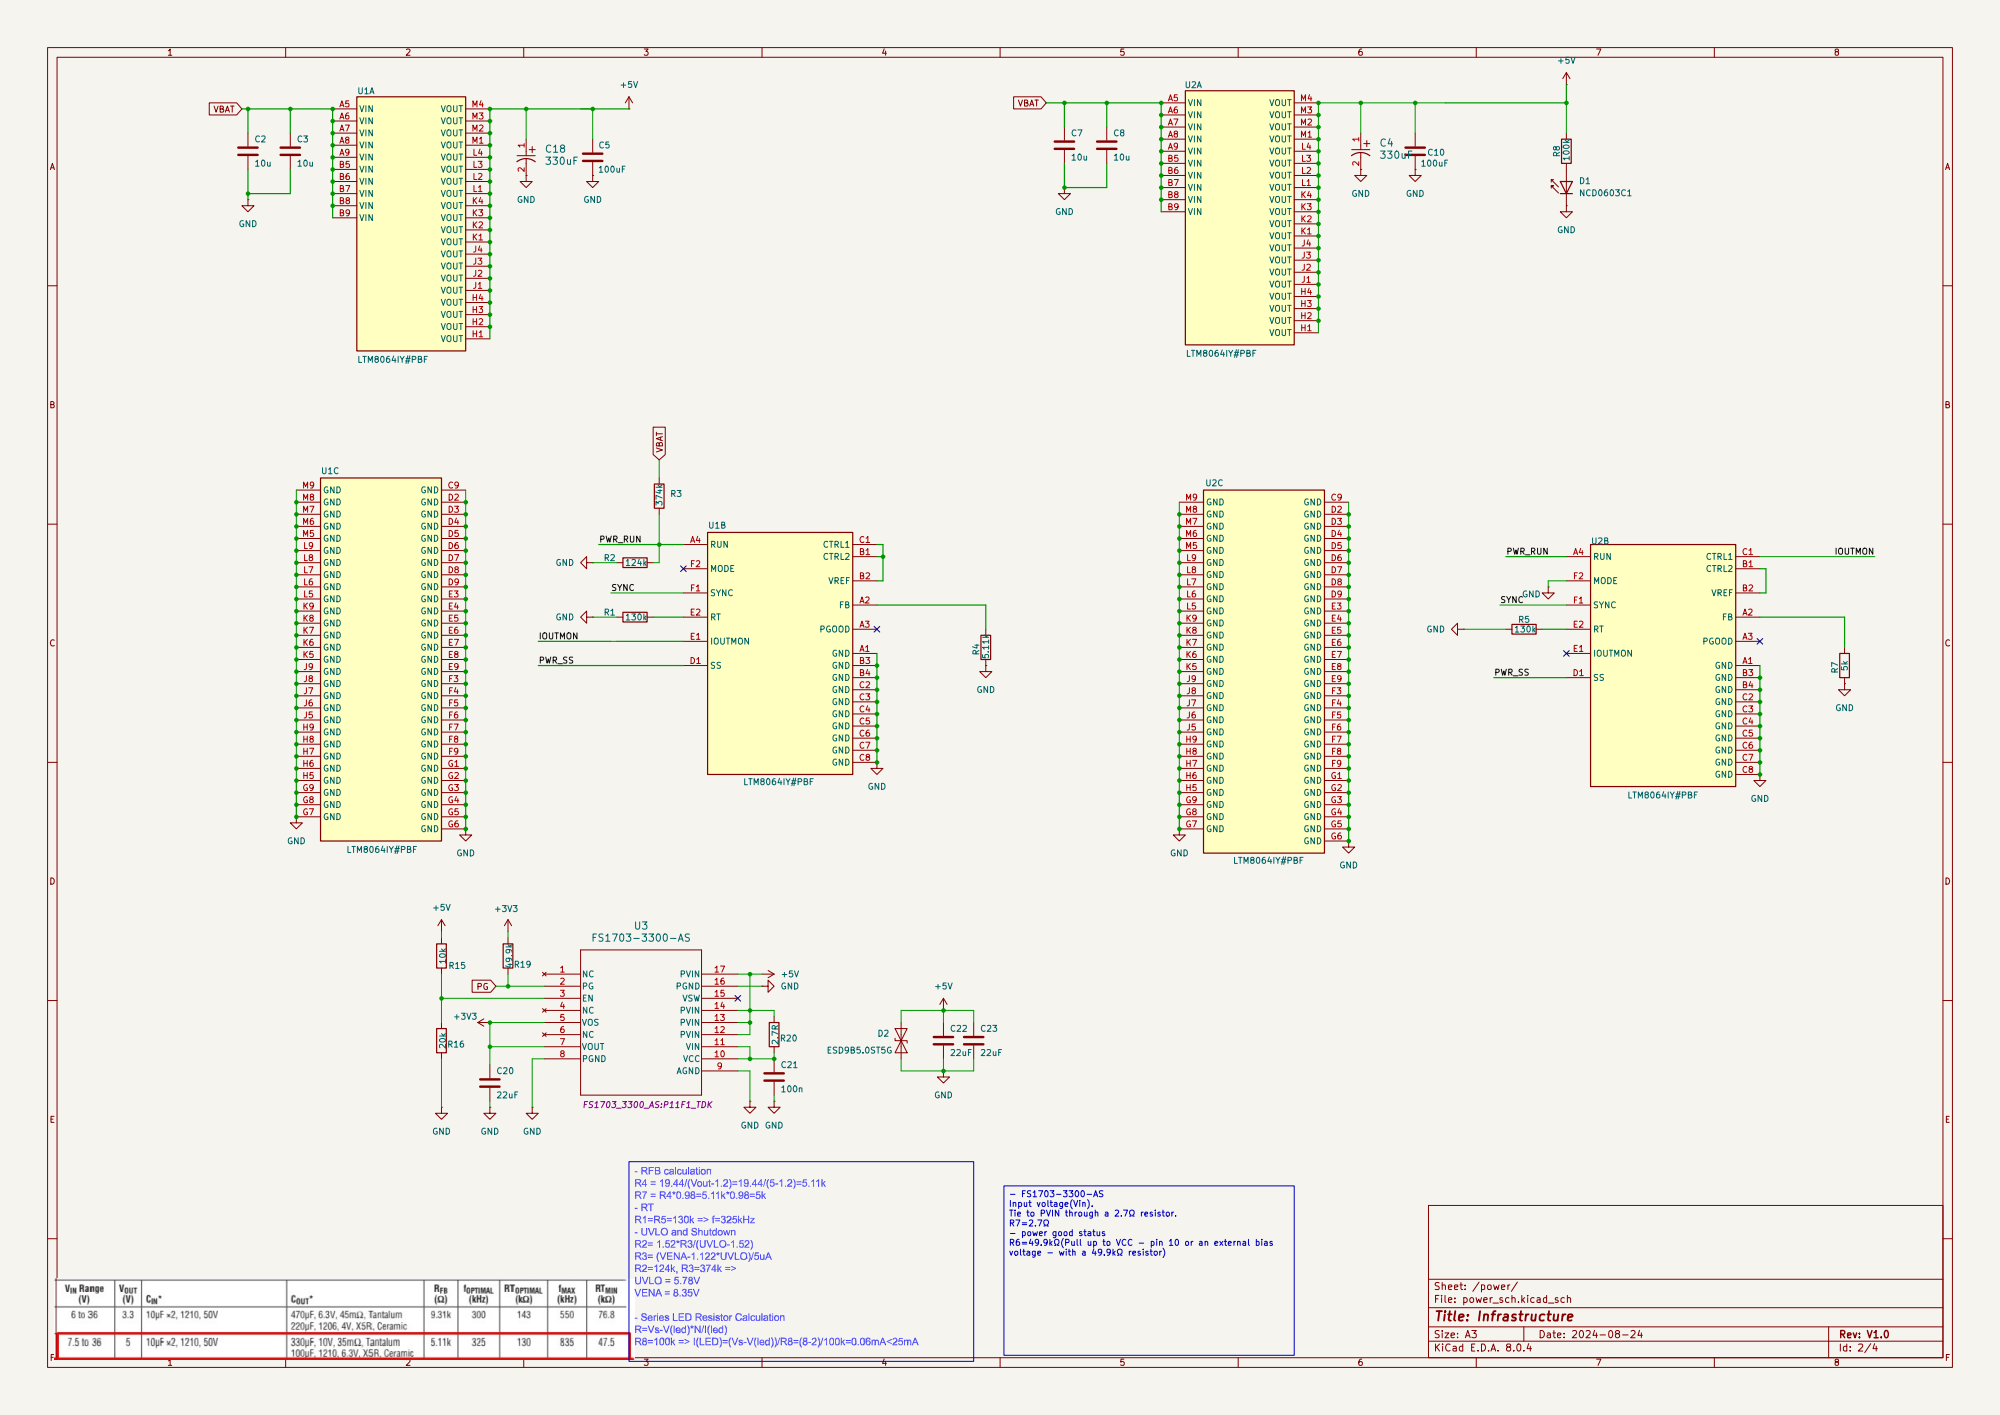
[picture p73: page 2]

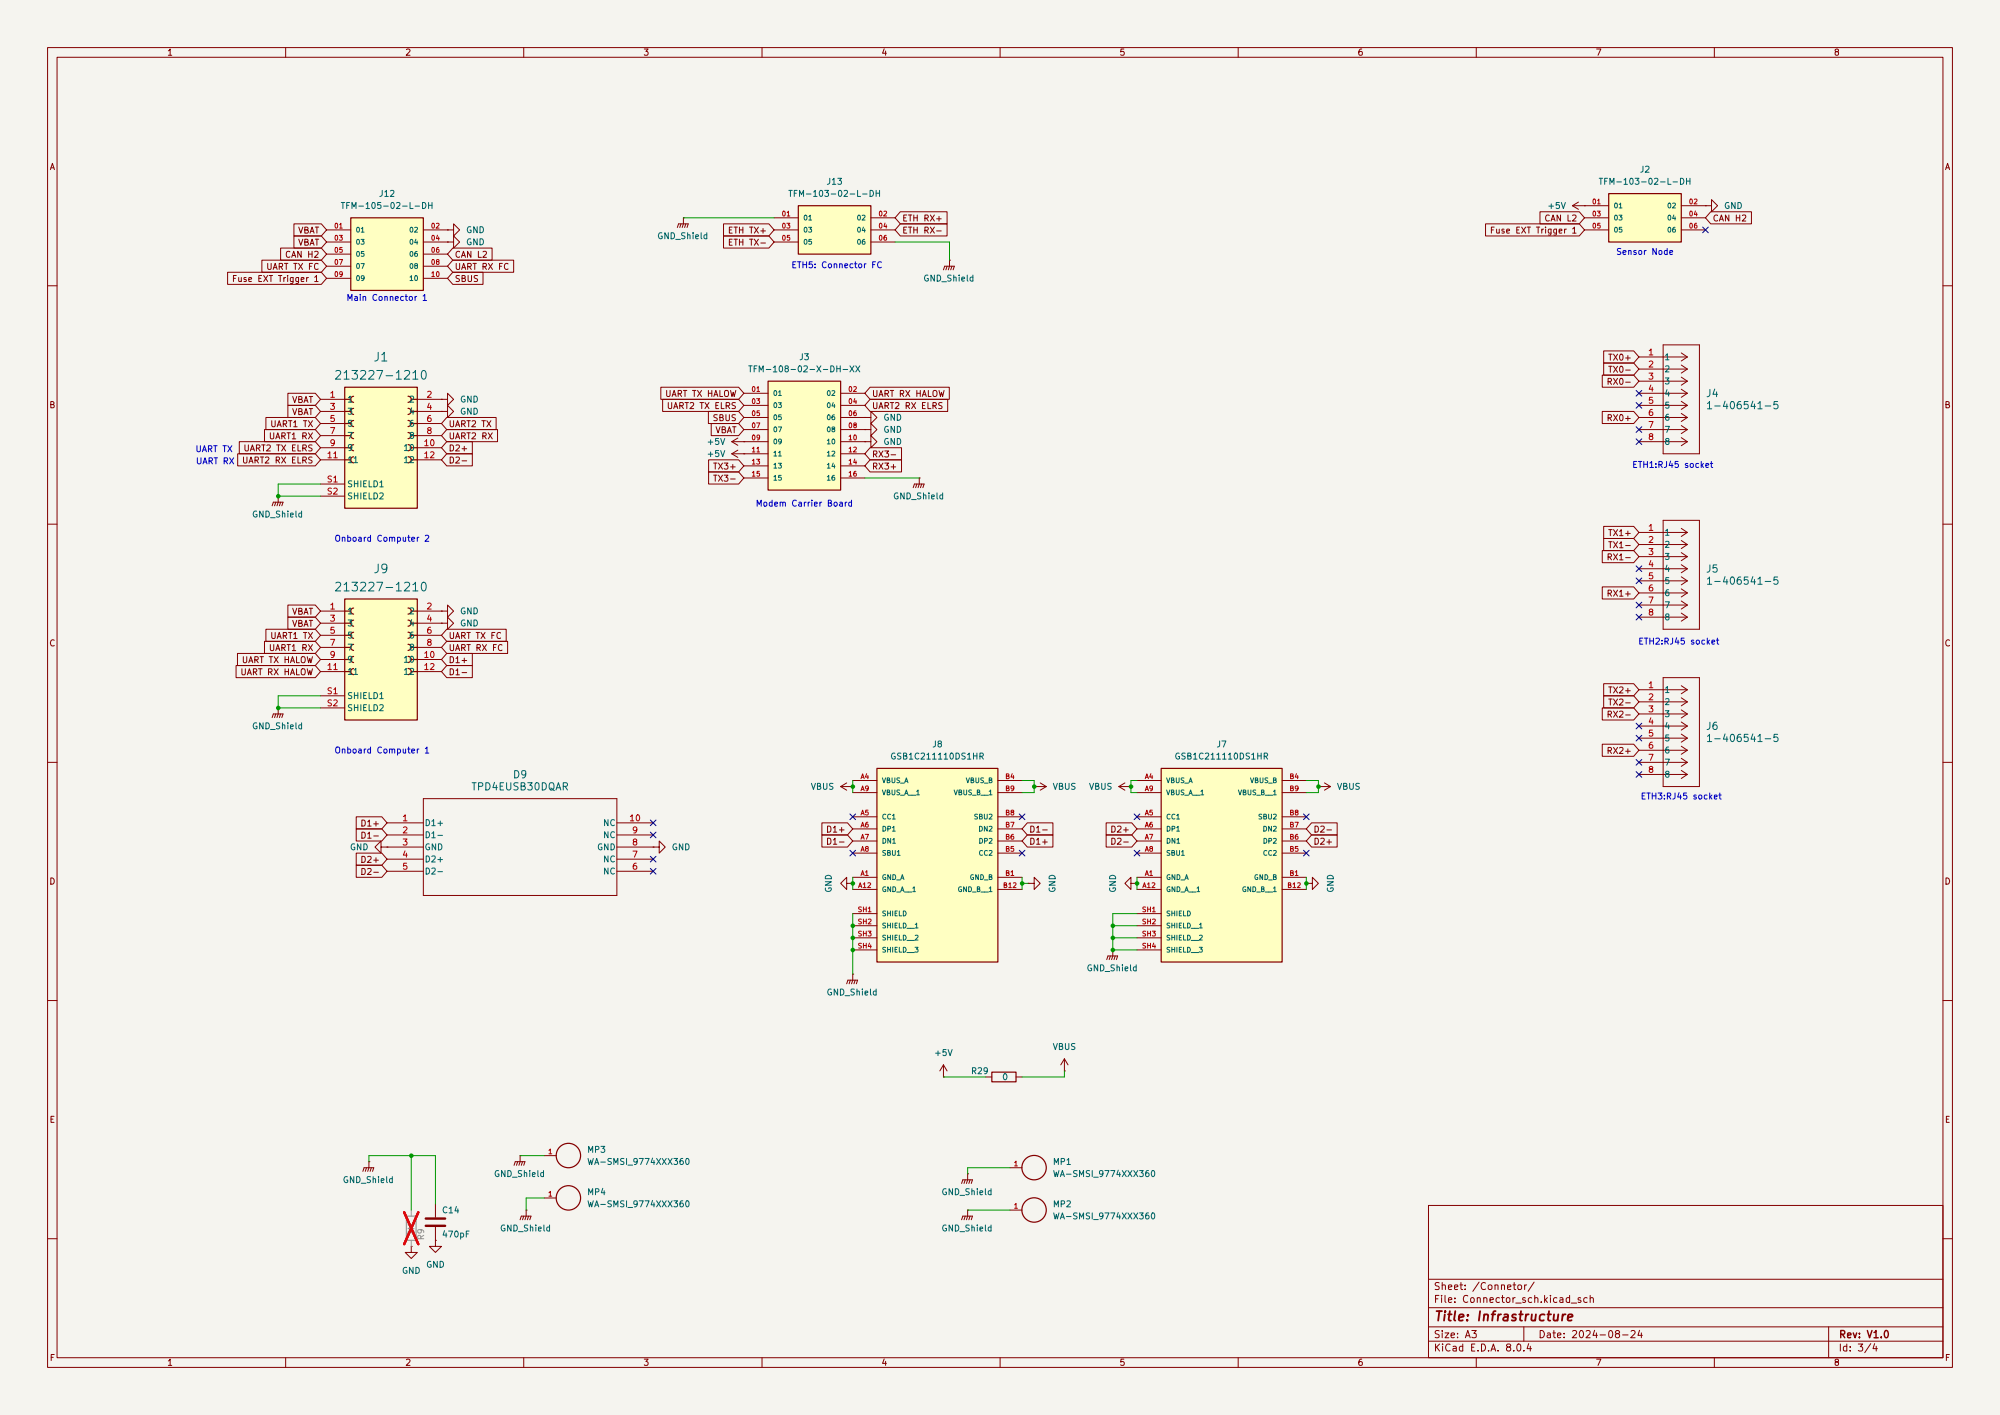
[picture p74: page 3]

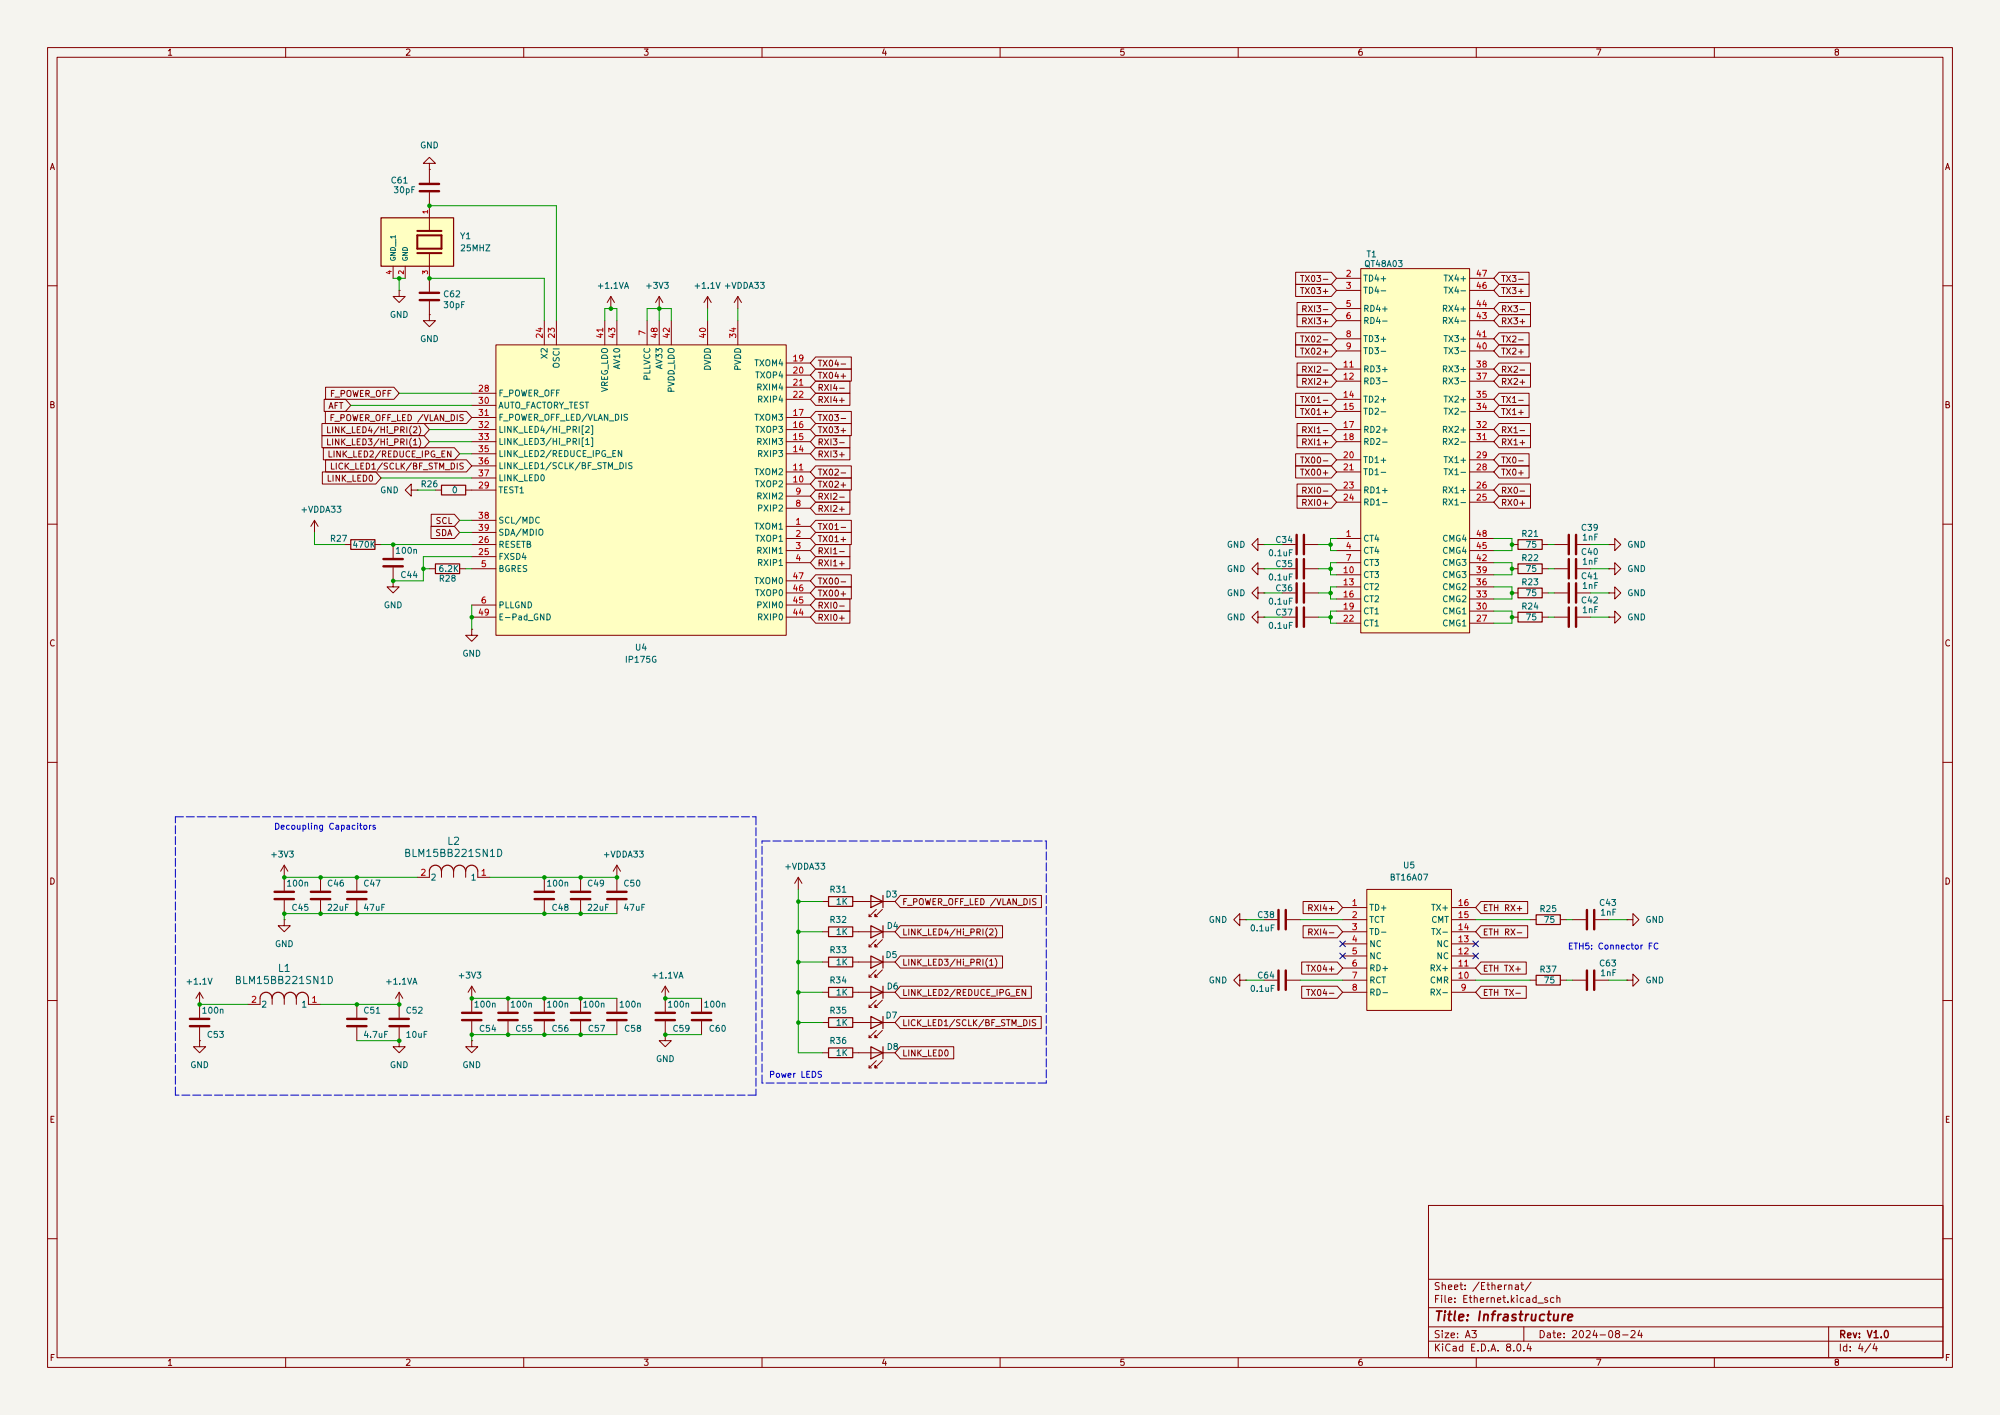
[picture p75: page 4]
