Pro-engineer616/pcb_projects_Alex/PDB v1.2/schematic_V1.2.pdf

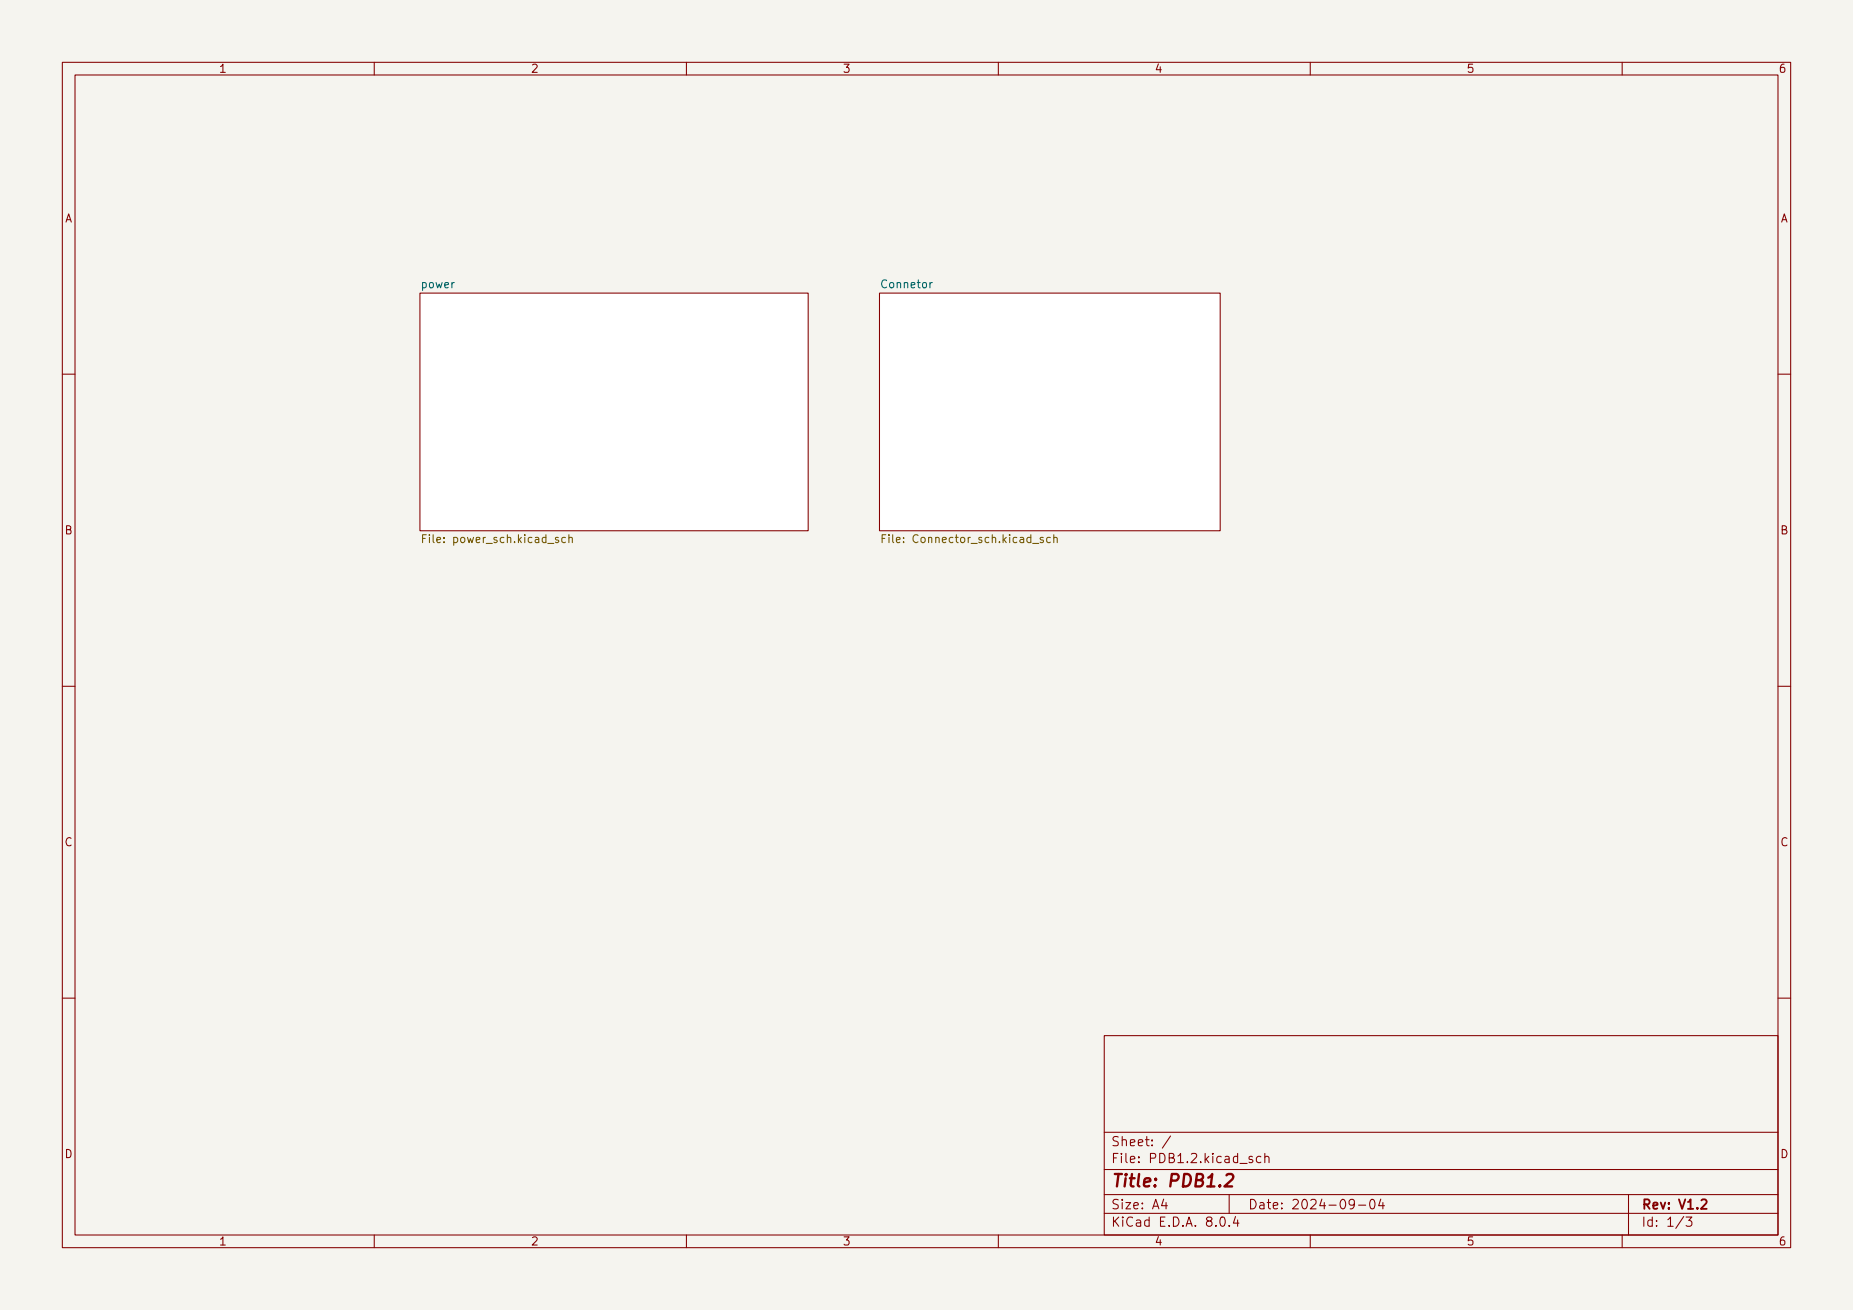
[picture p84: page 1]

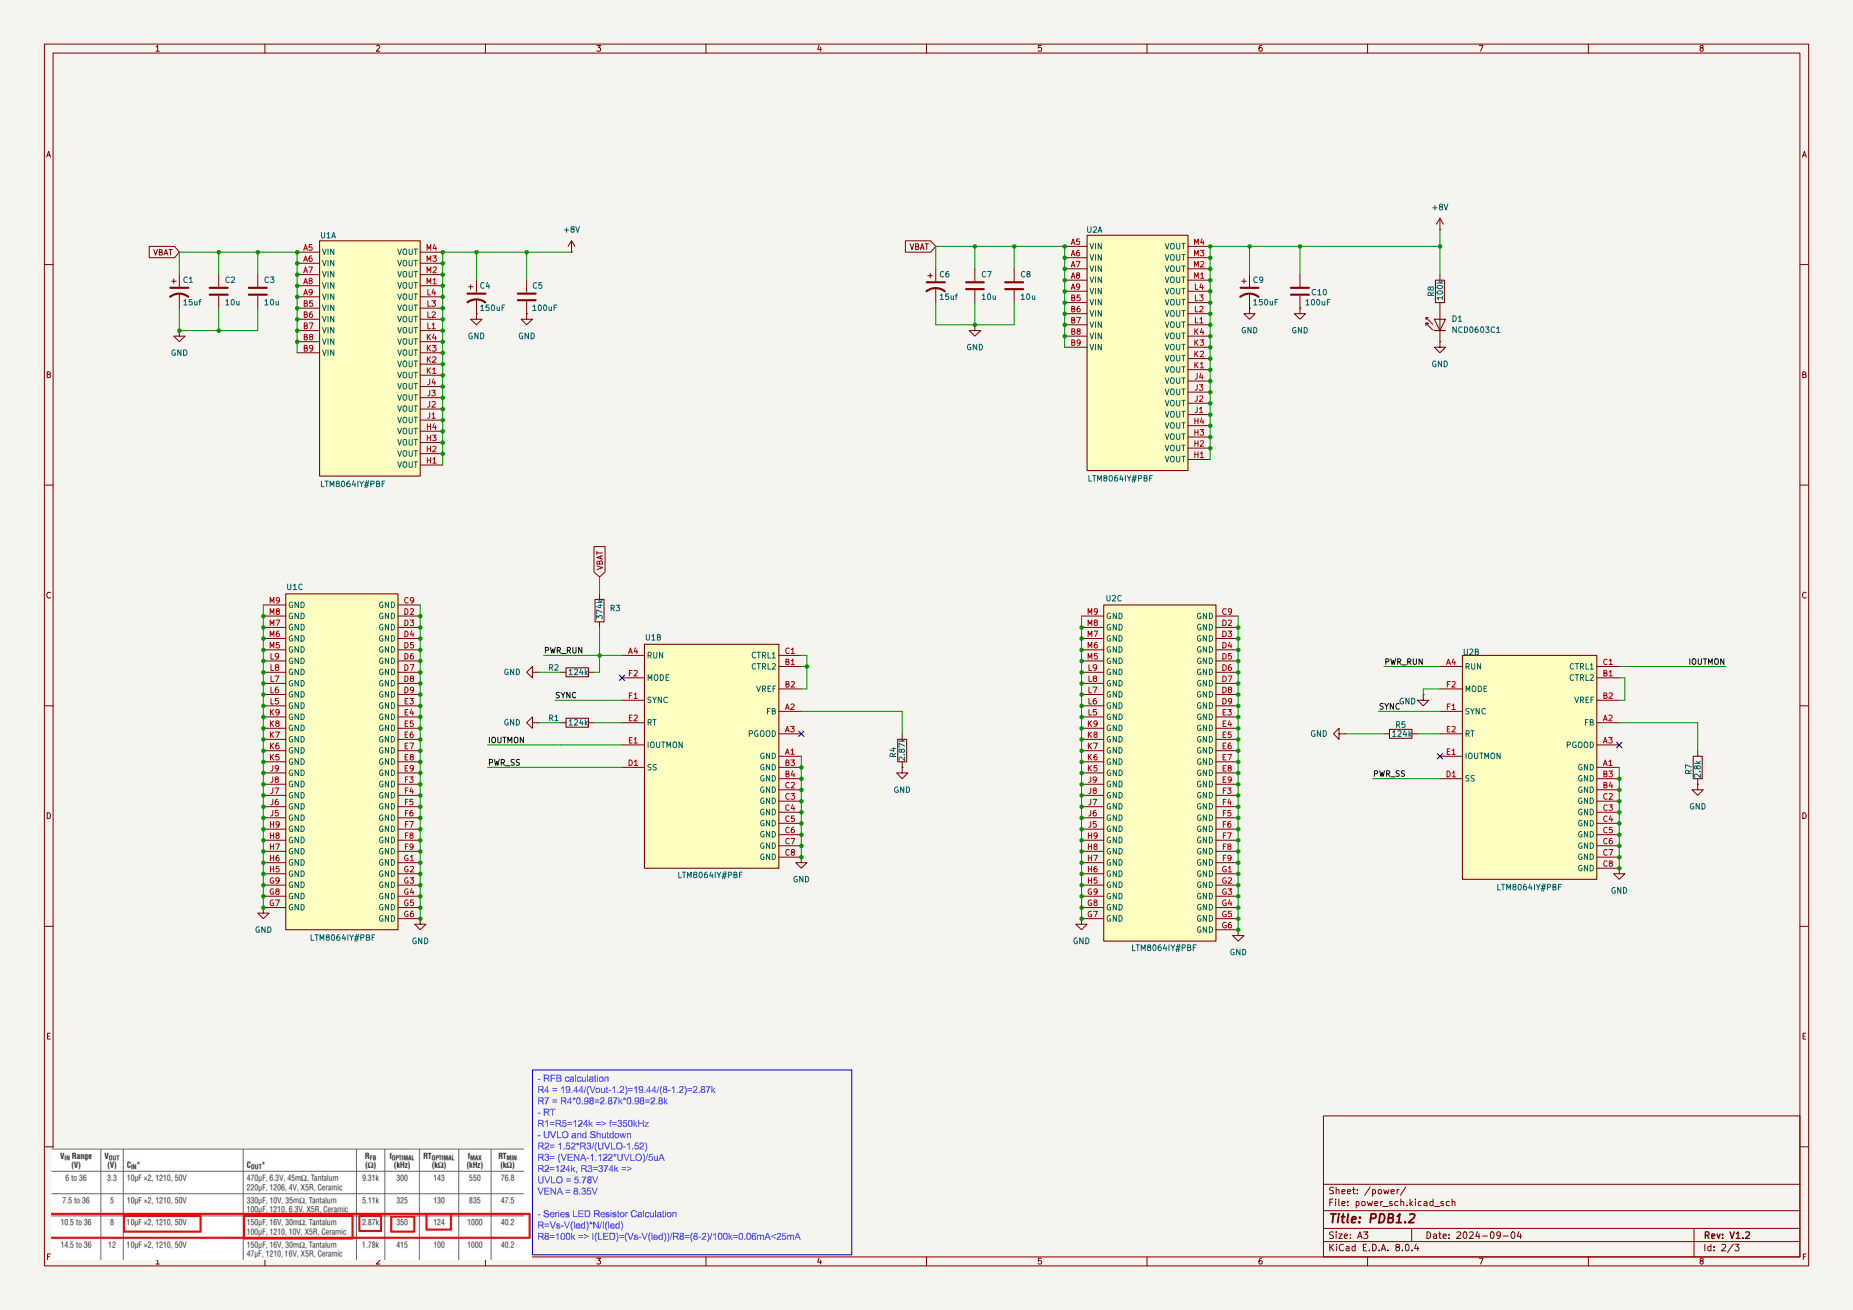
[picture p85: page 2]

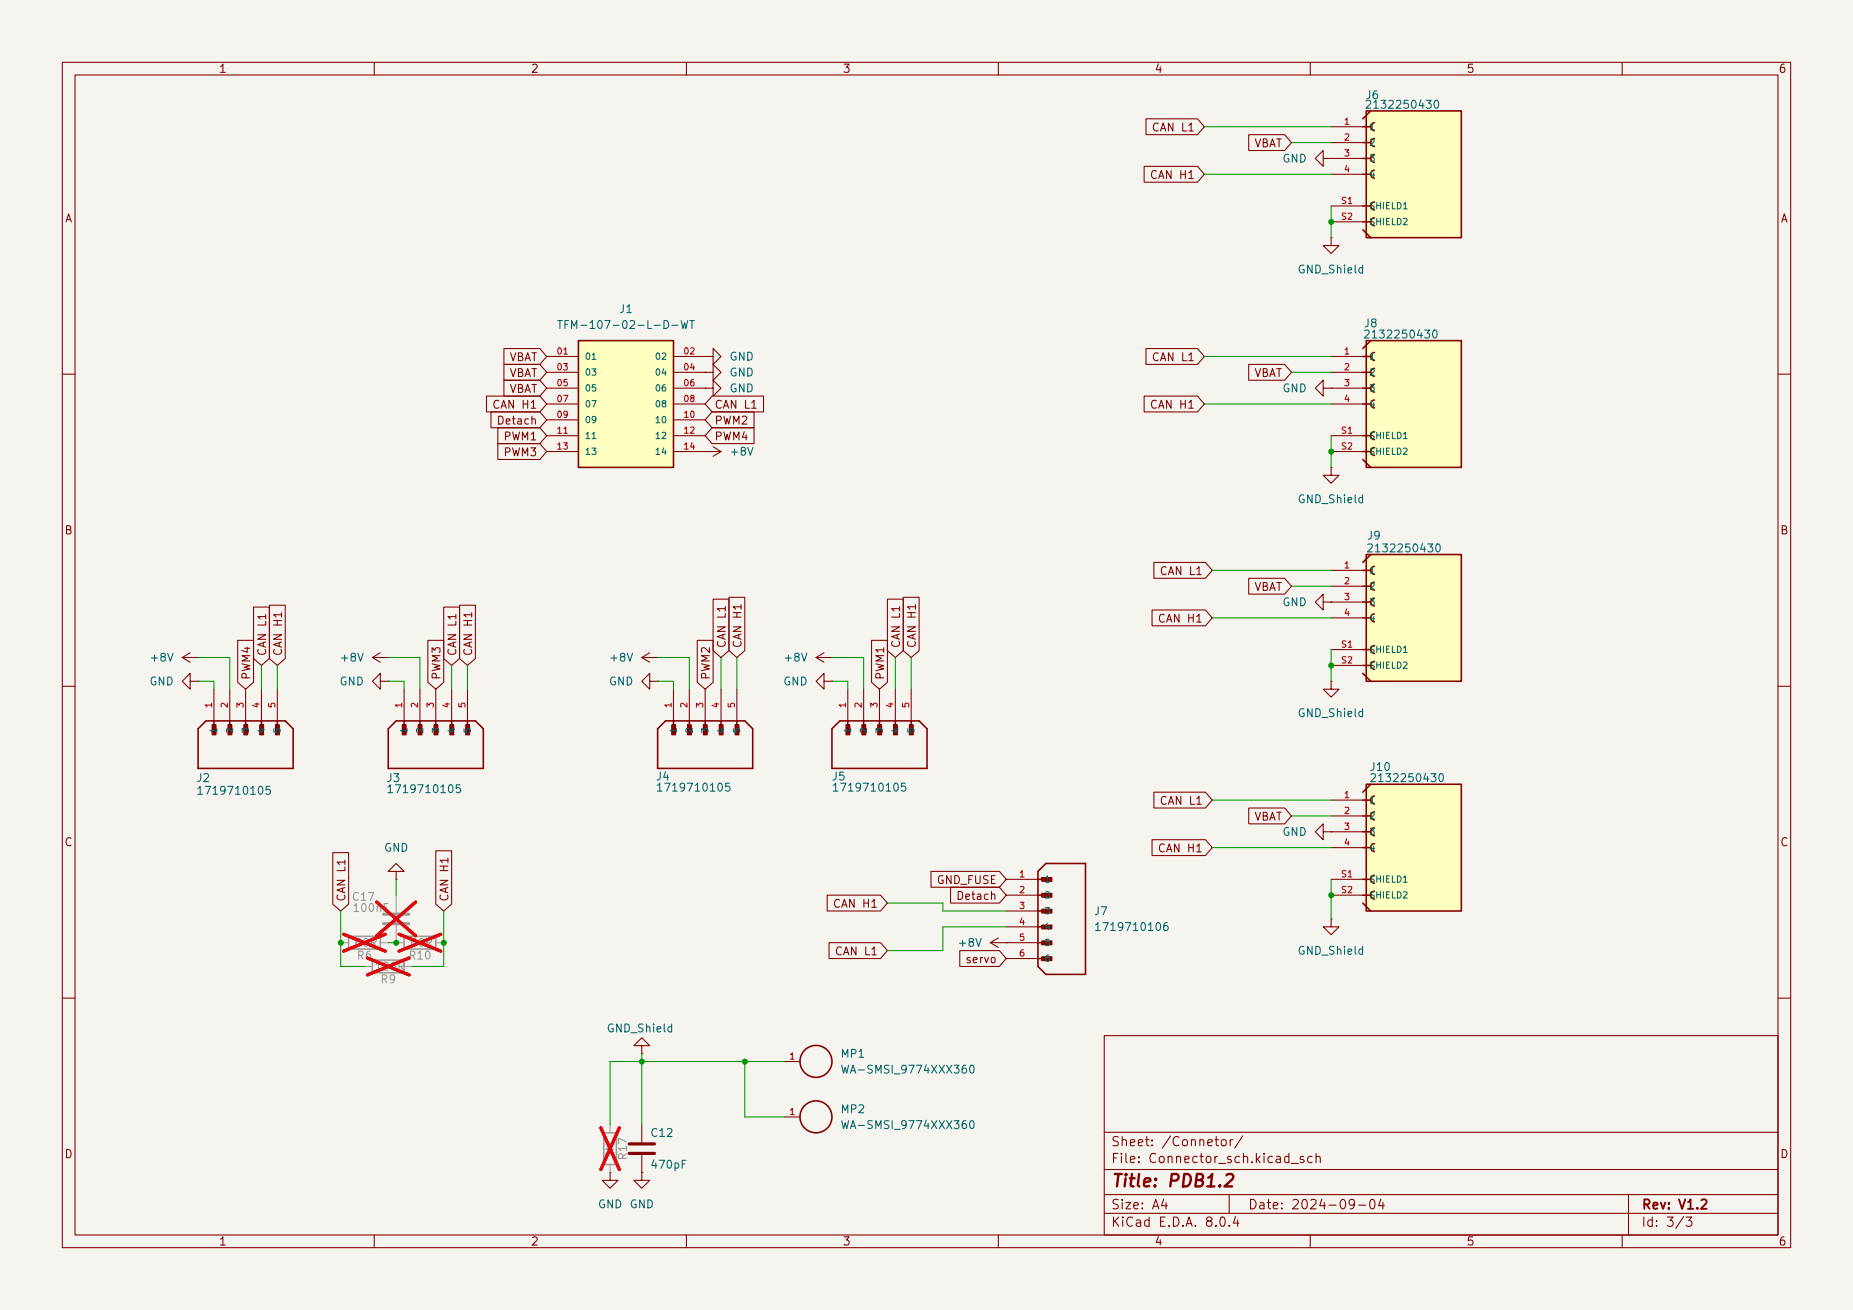
[picture p86: page 3]
