Pro-engineer616/pcb_projects_Alex/PDB v1.2/PCB_V1.2.pdf

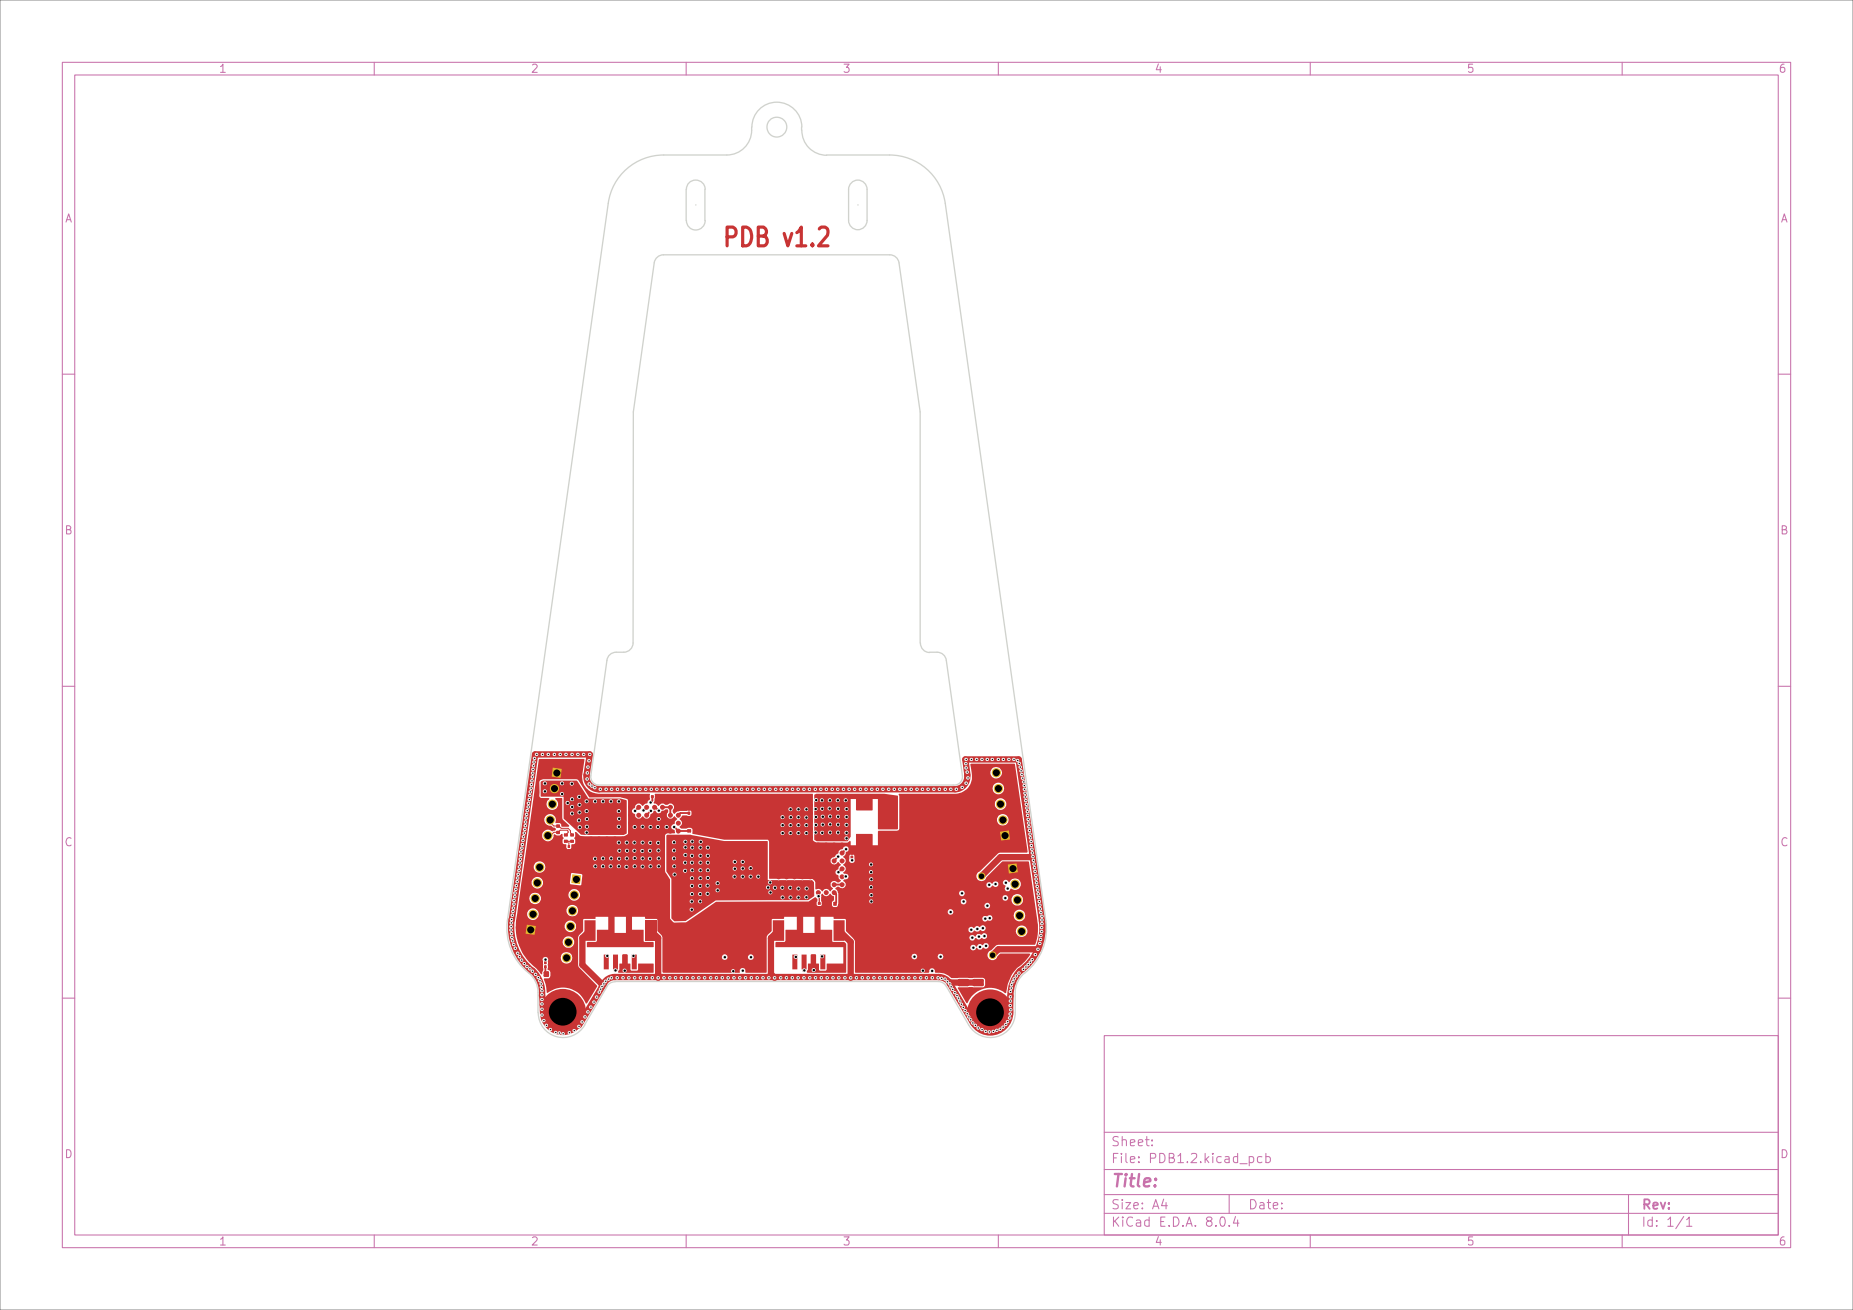
[picture p87: page 1]

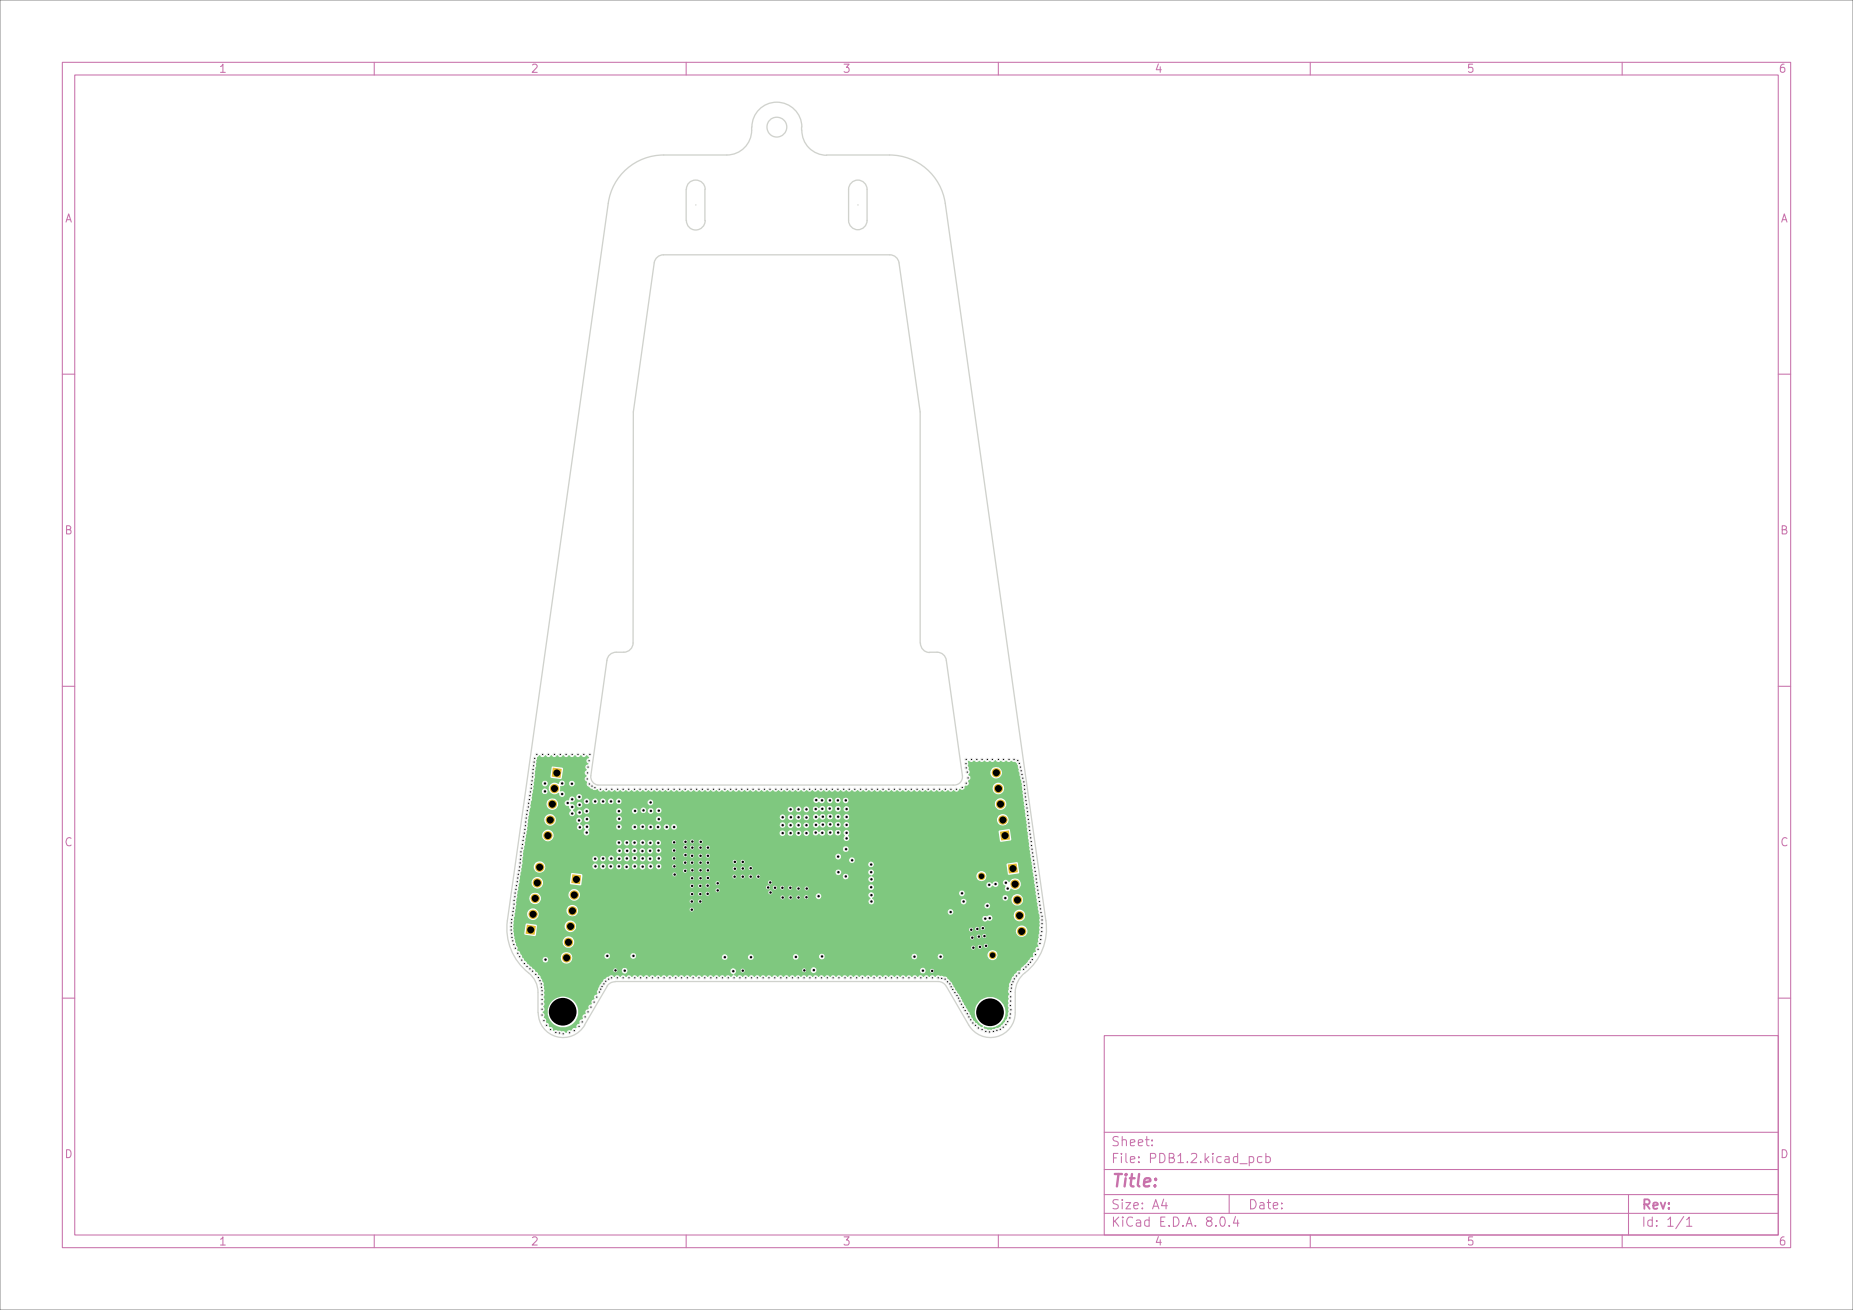
[picture p88: page 2]

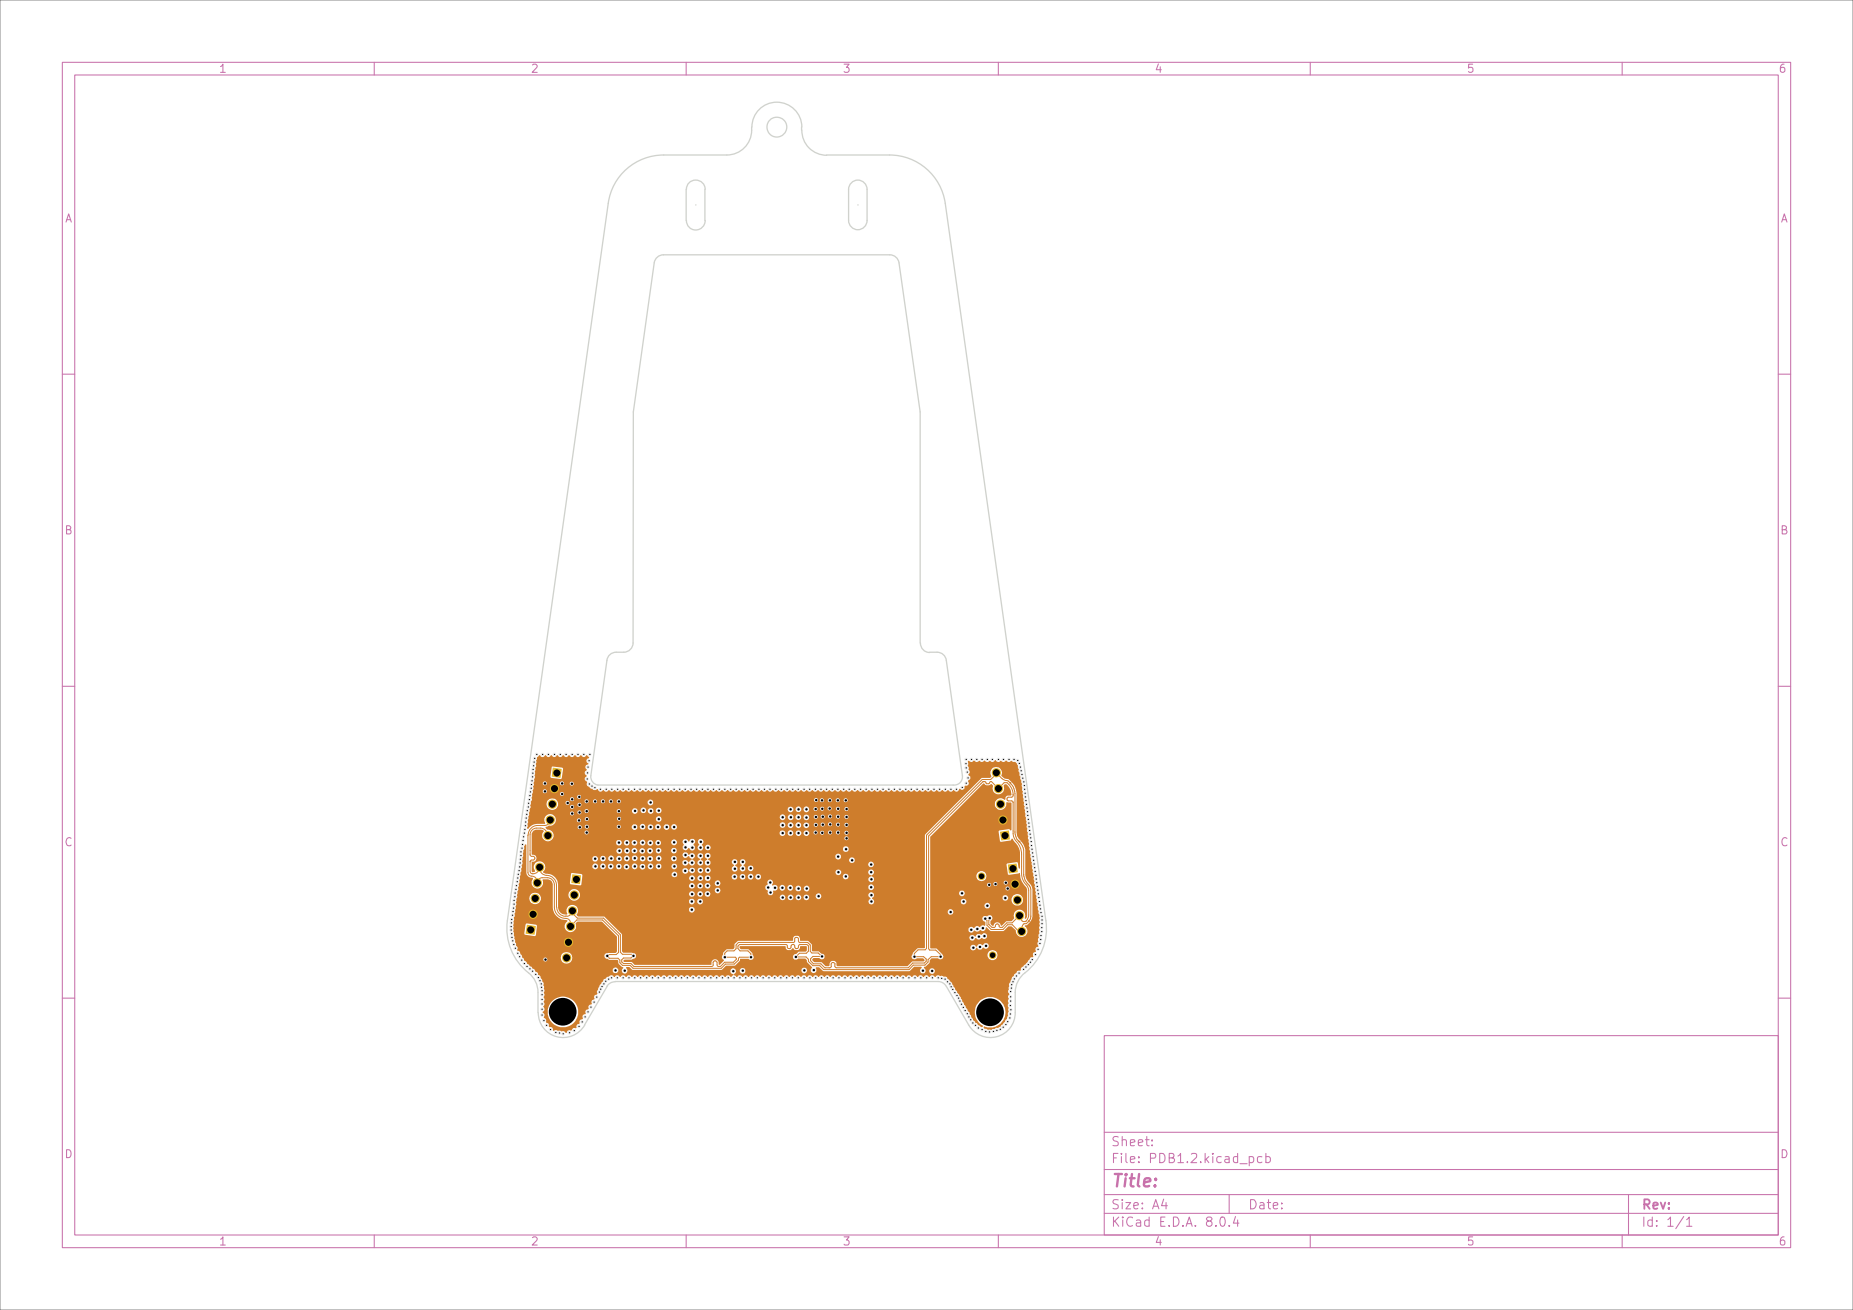
[picture p89: page 3]

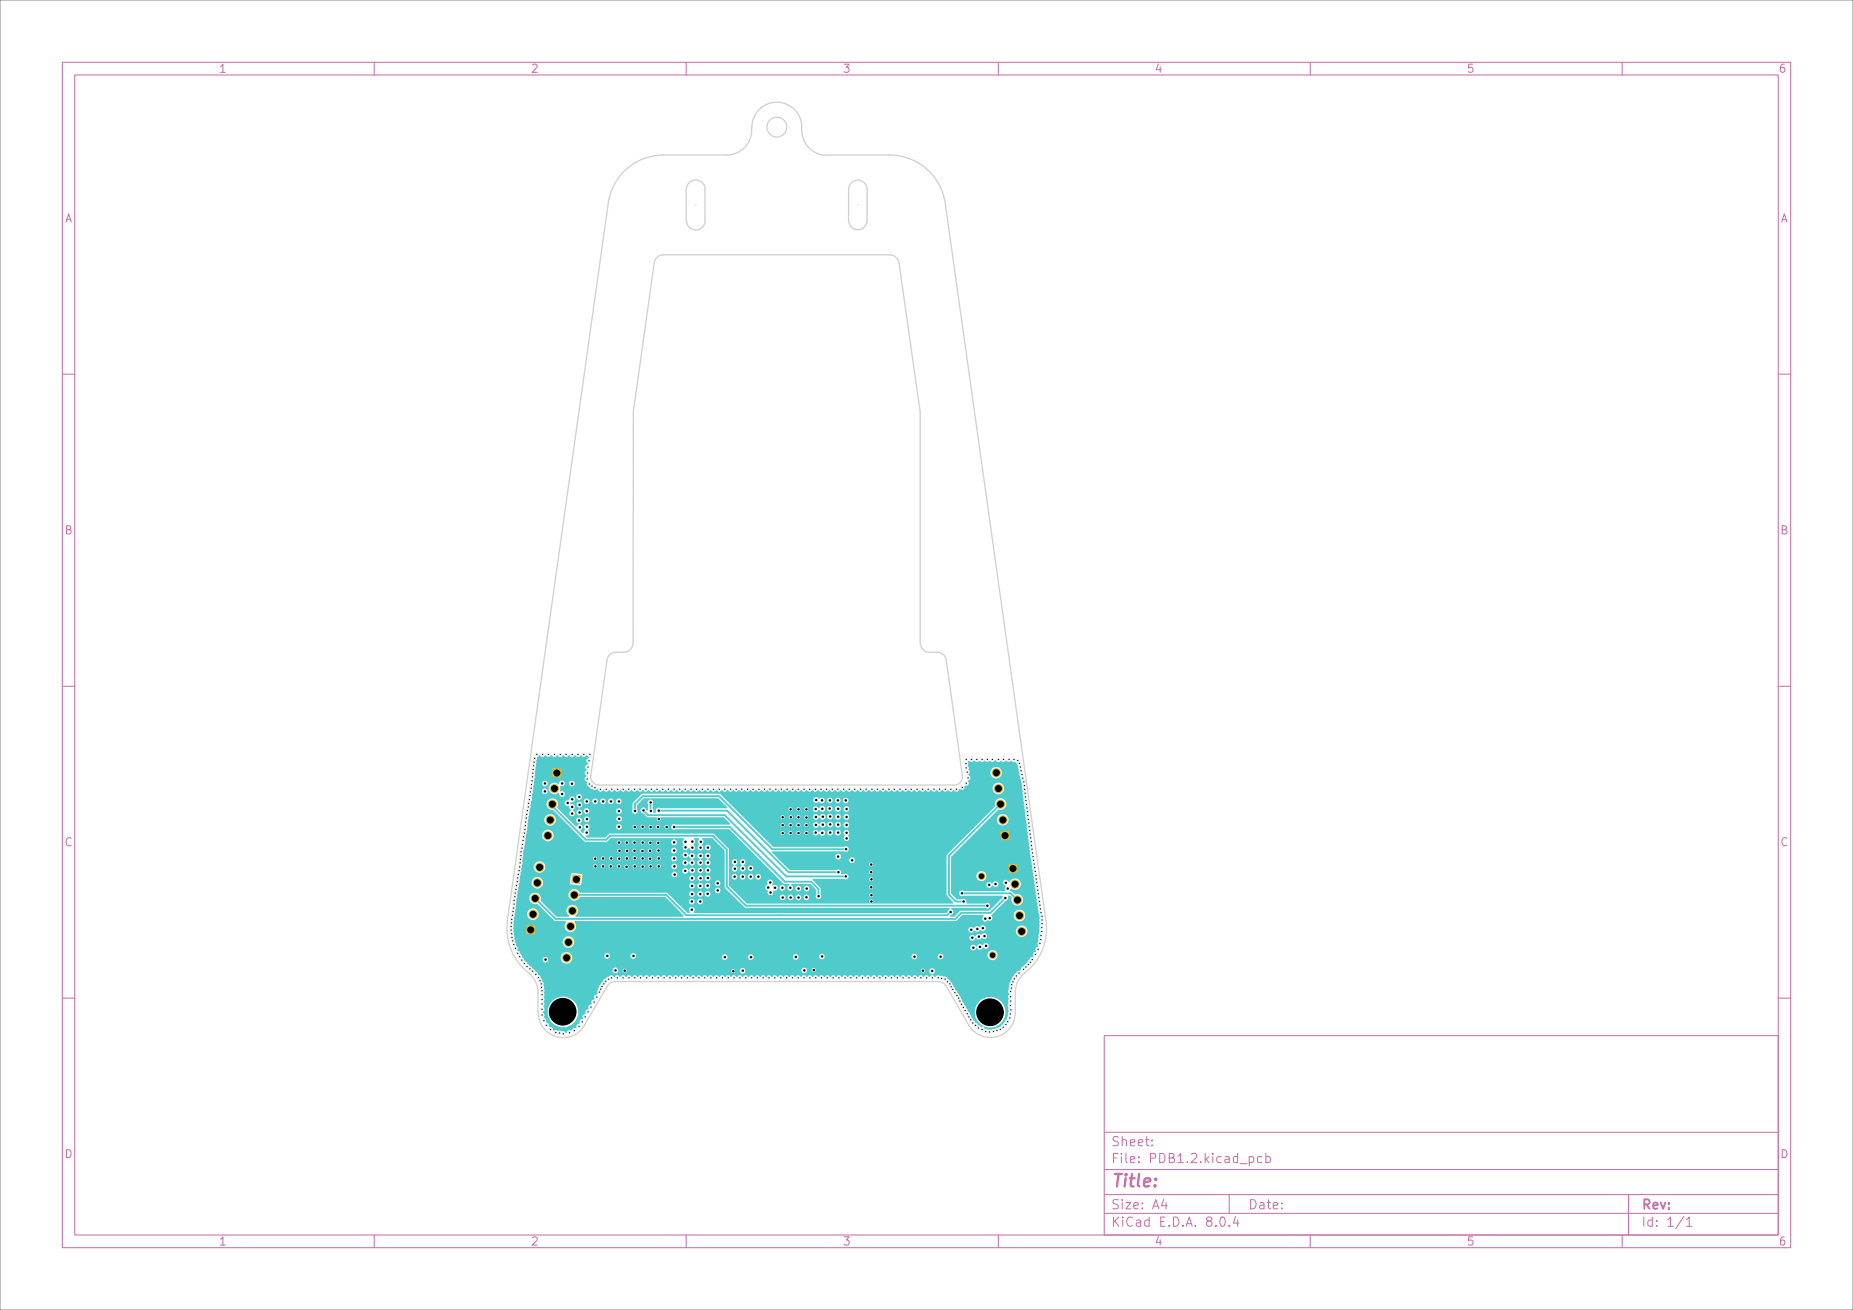
[picture p90: page 4]

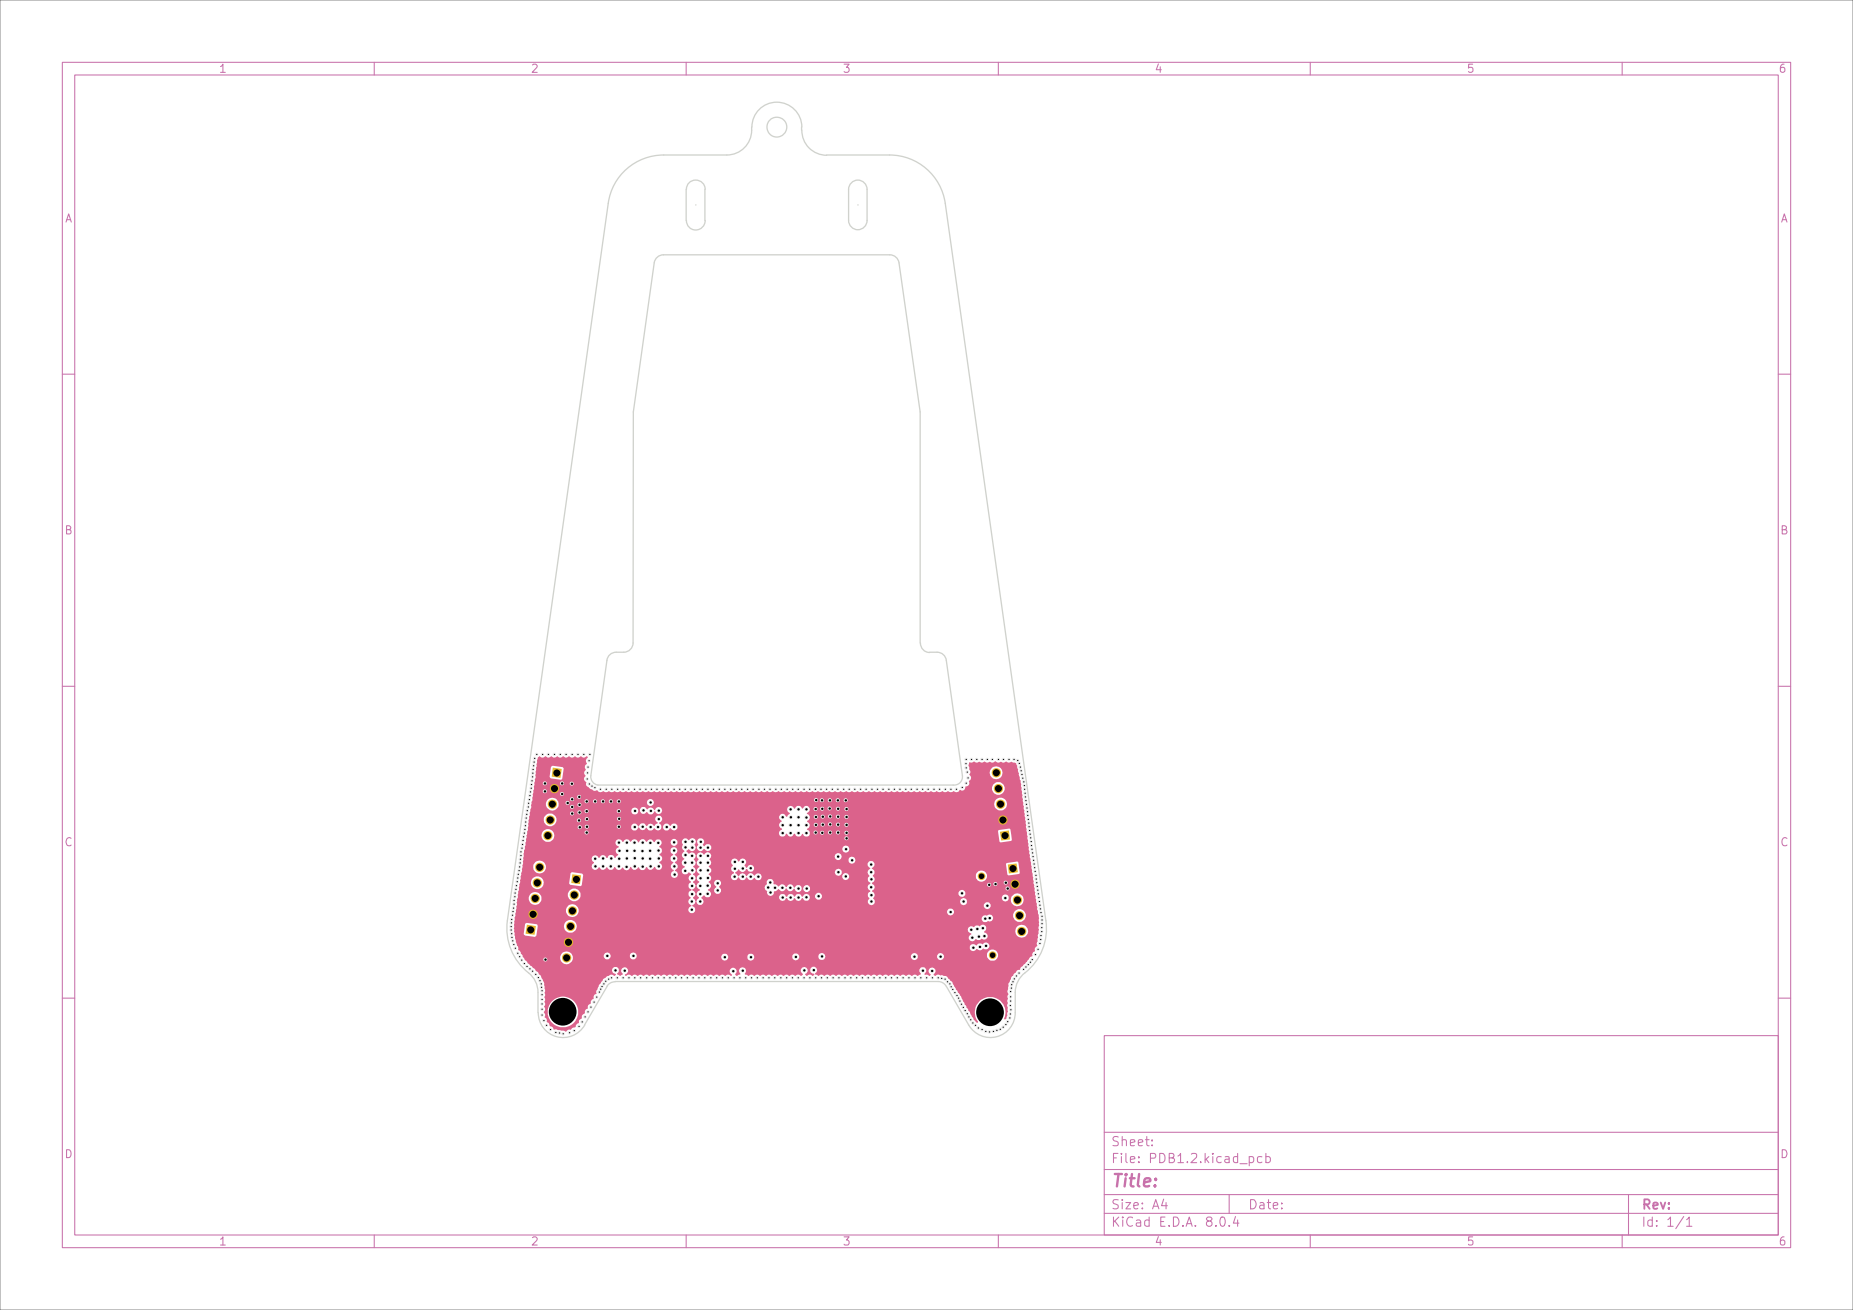
[picture p91: page 5]

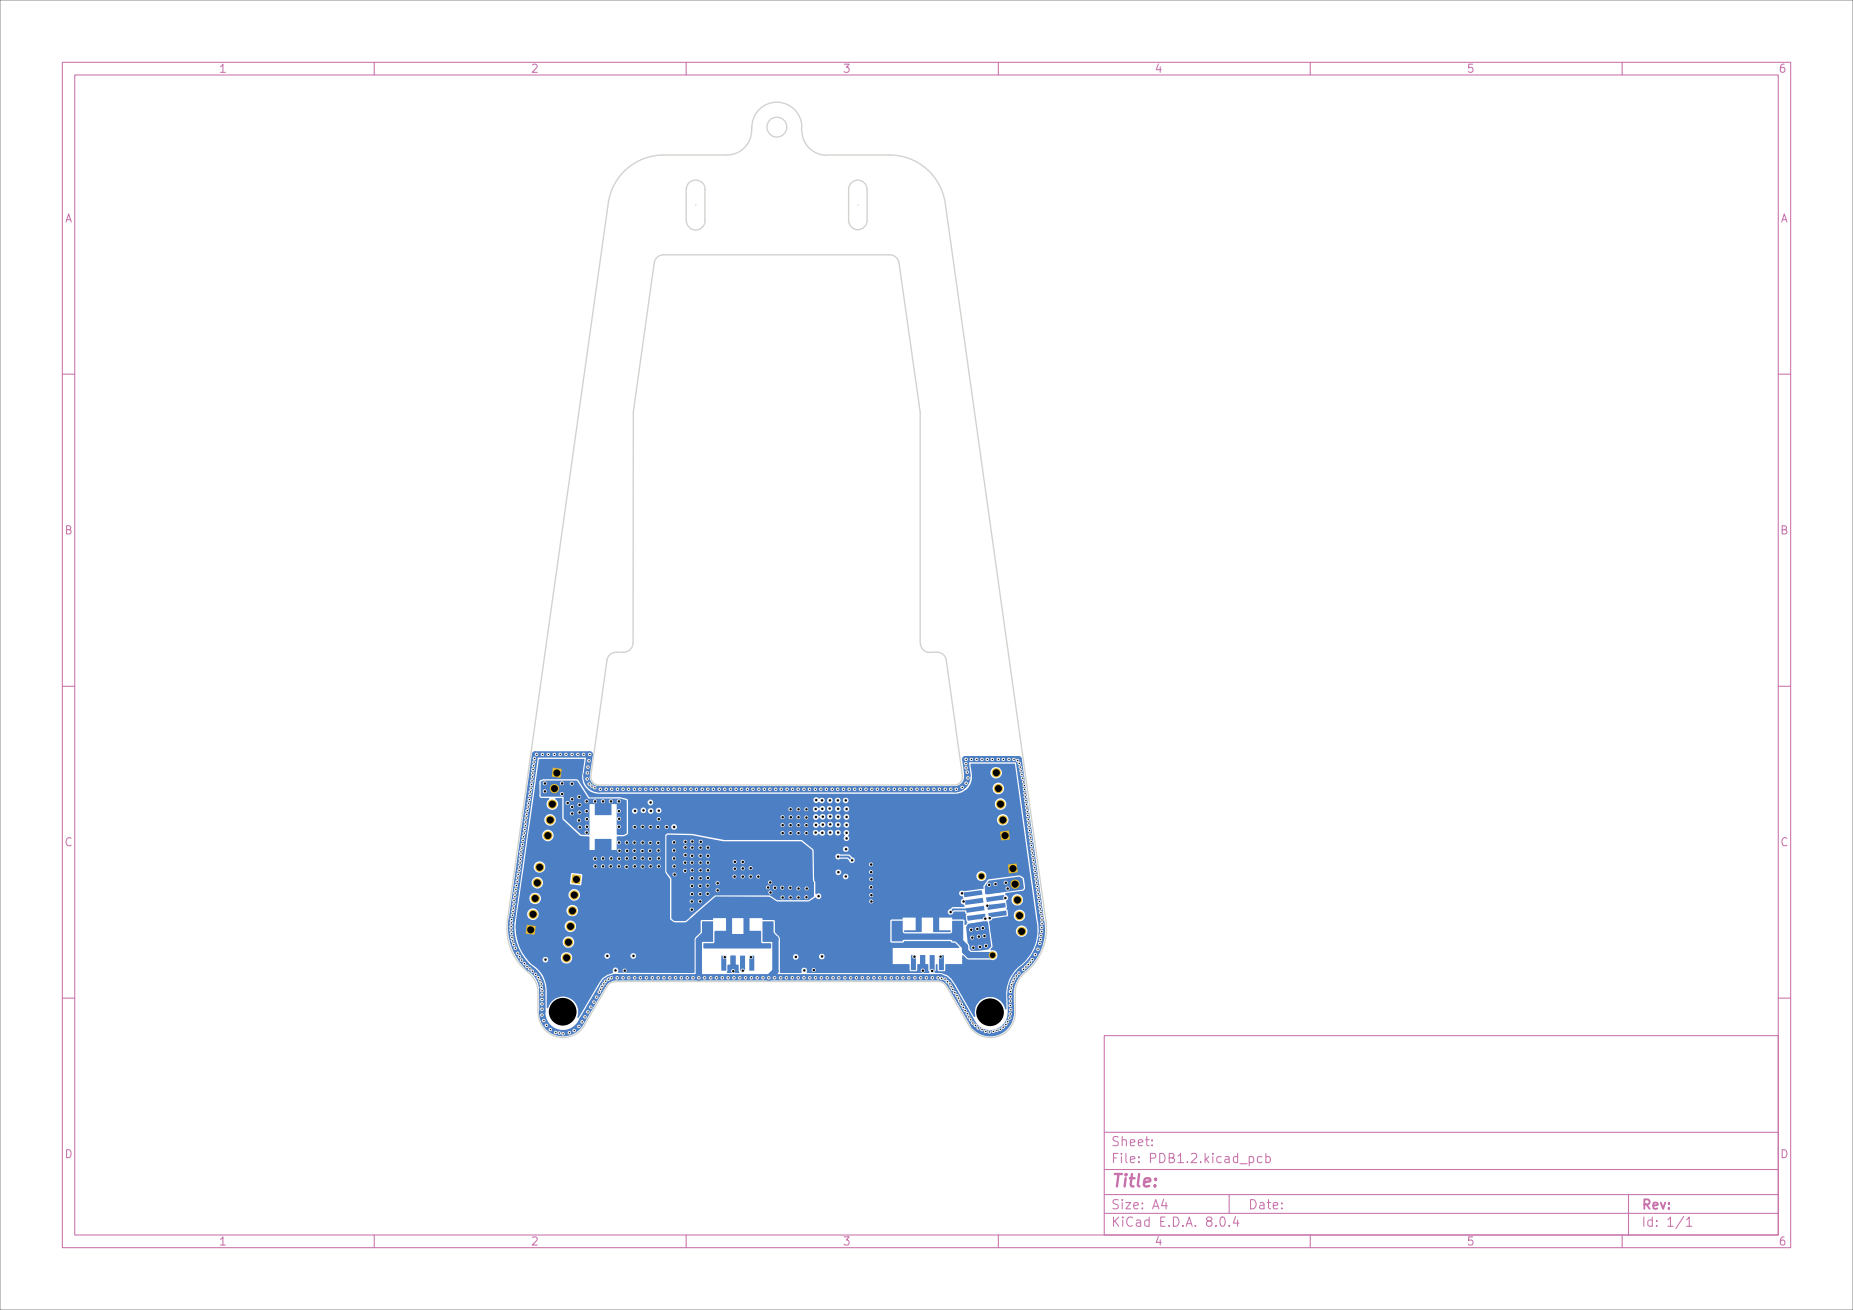
[picture p92: page 6]
