Pro-engineer616/pcb_projects_Alex/Sensor-Node v1.1/Sensor_node_1.0/Airspeedsensor.pdf

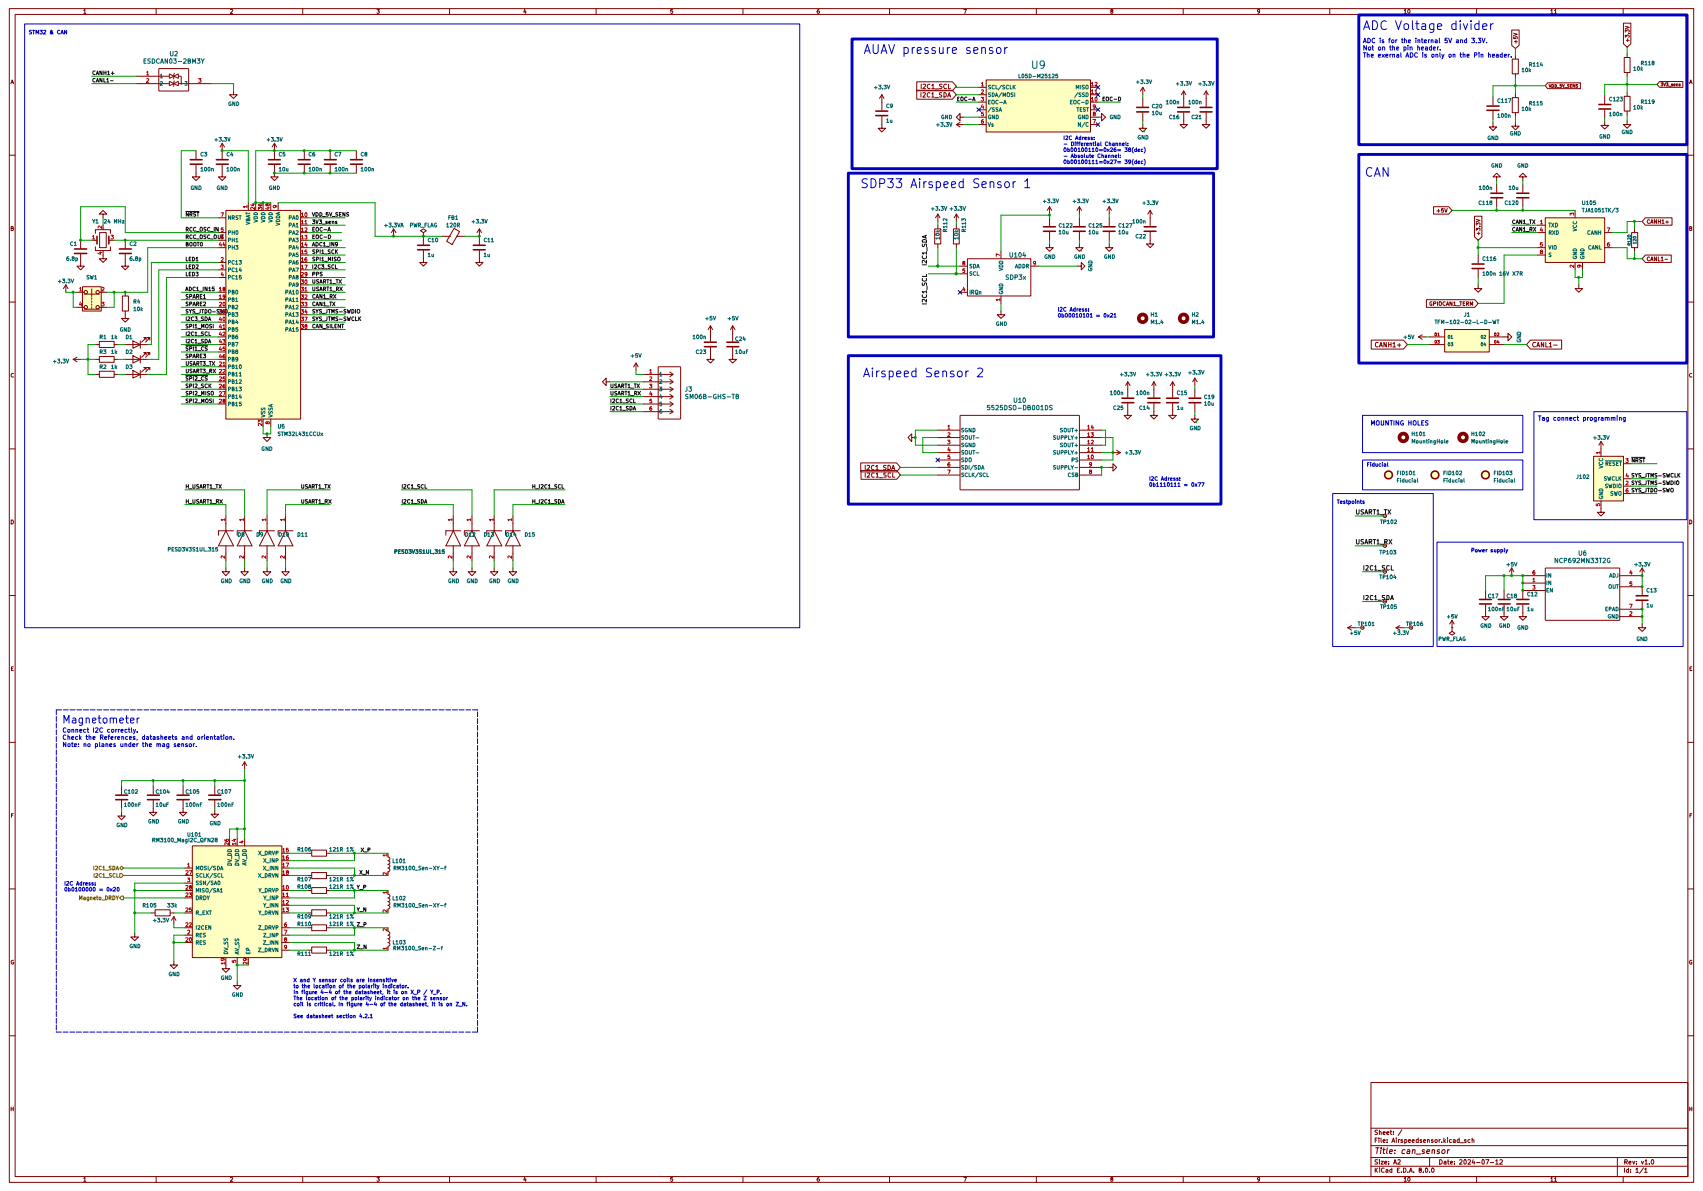
[picture p93: page 1]
