Pro-engineer616/pcb_projects_Alex/PDB v1.1/PDB1.1/source/PDB1.1 circuit.pdf

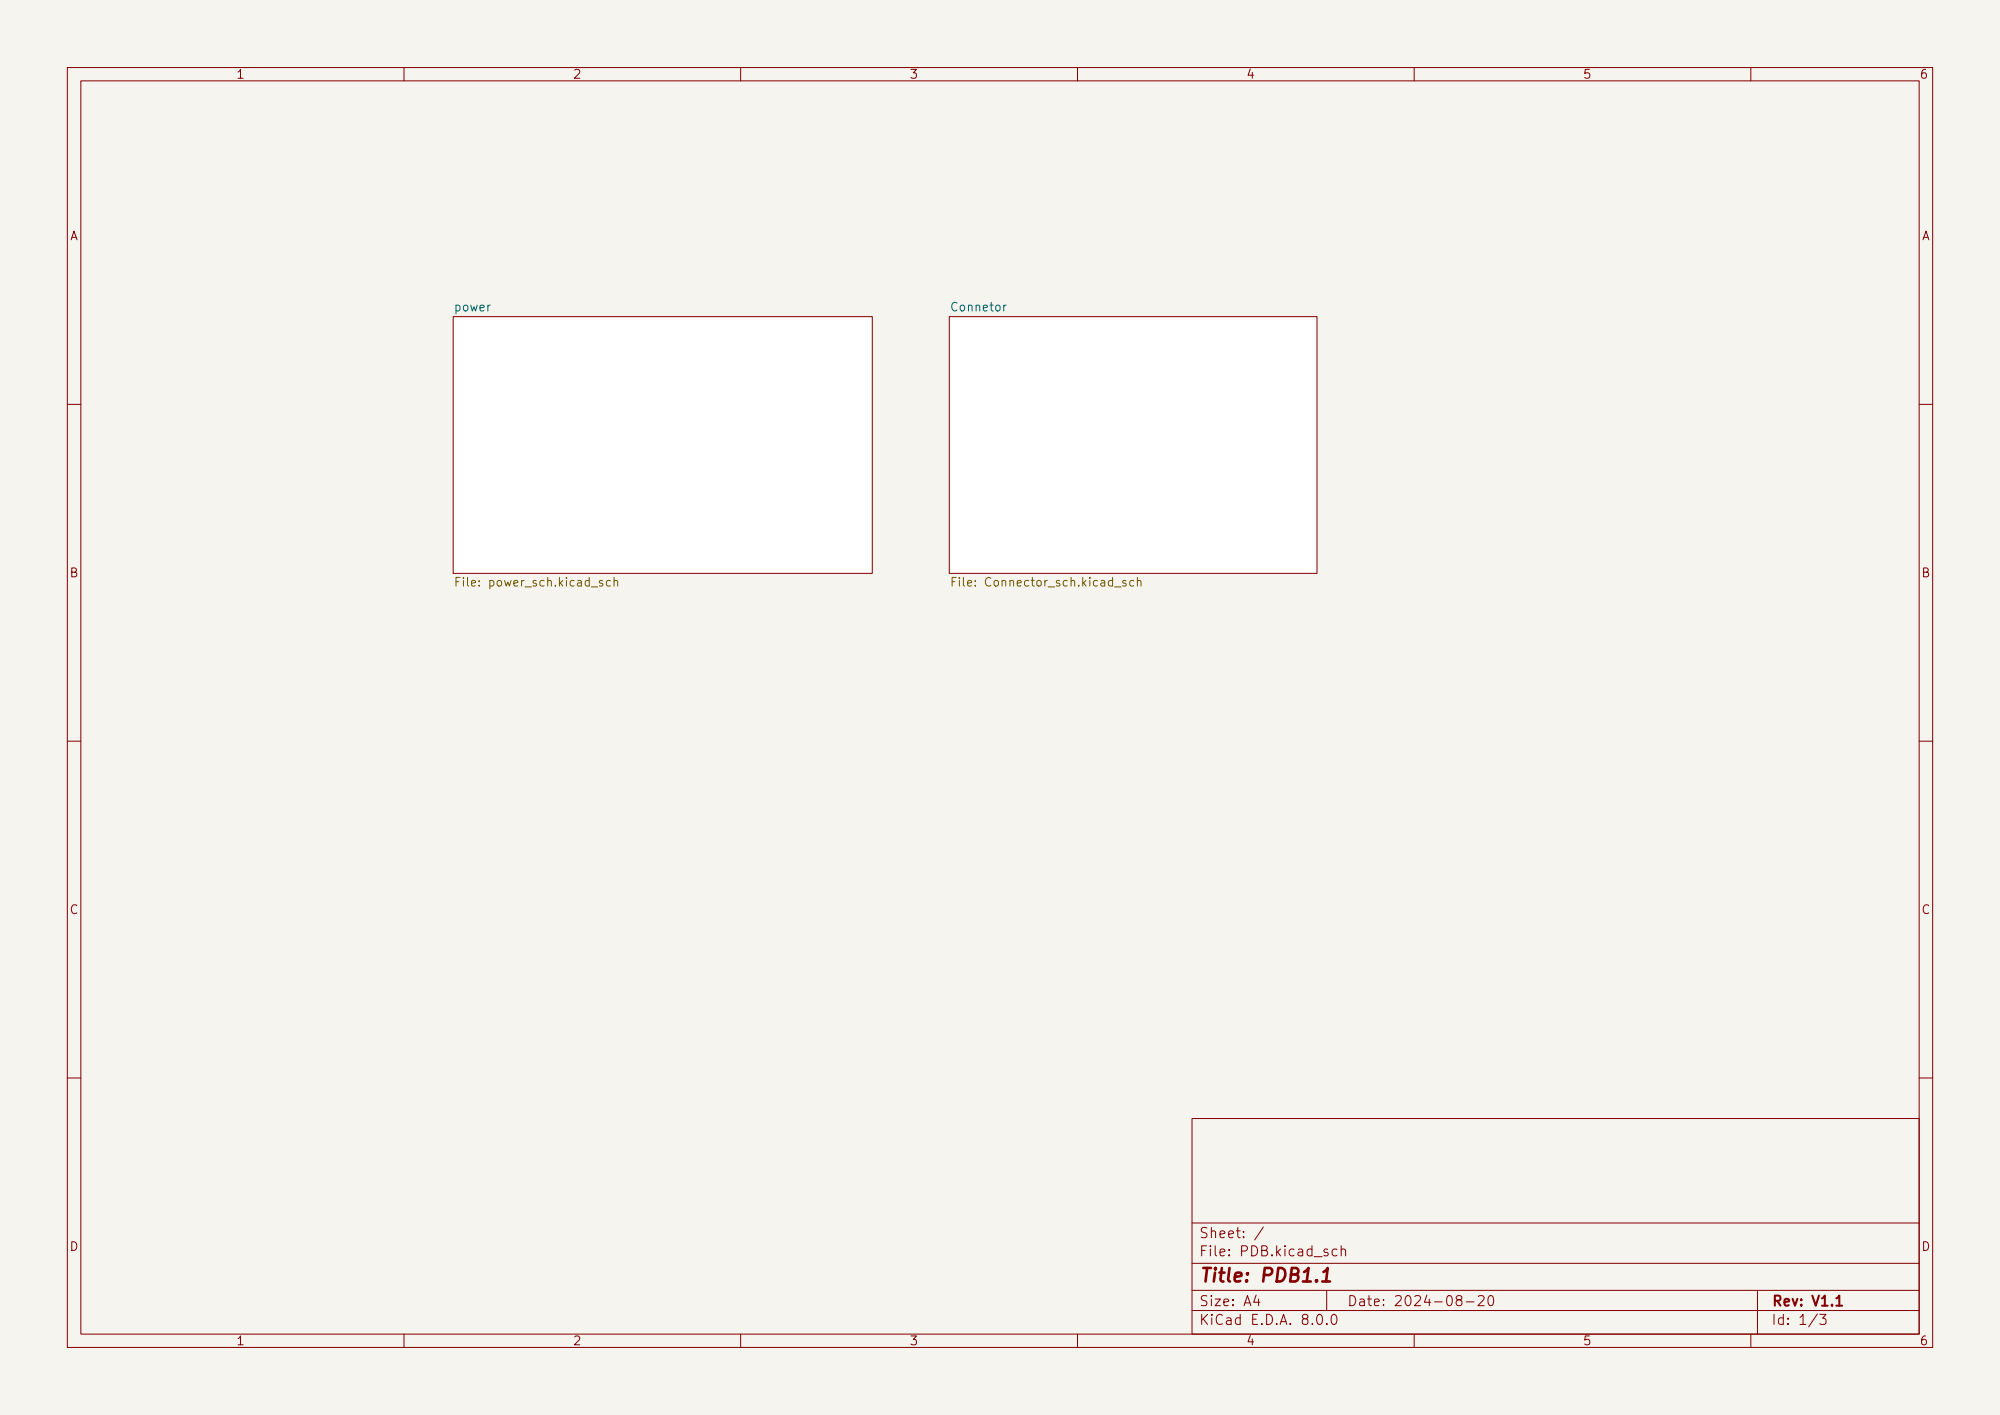
[picture p94: page 1]

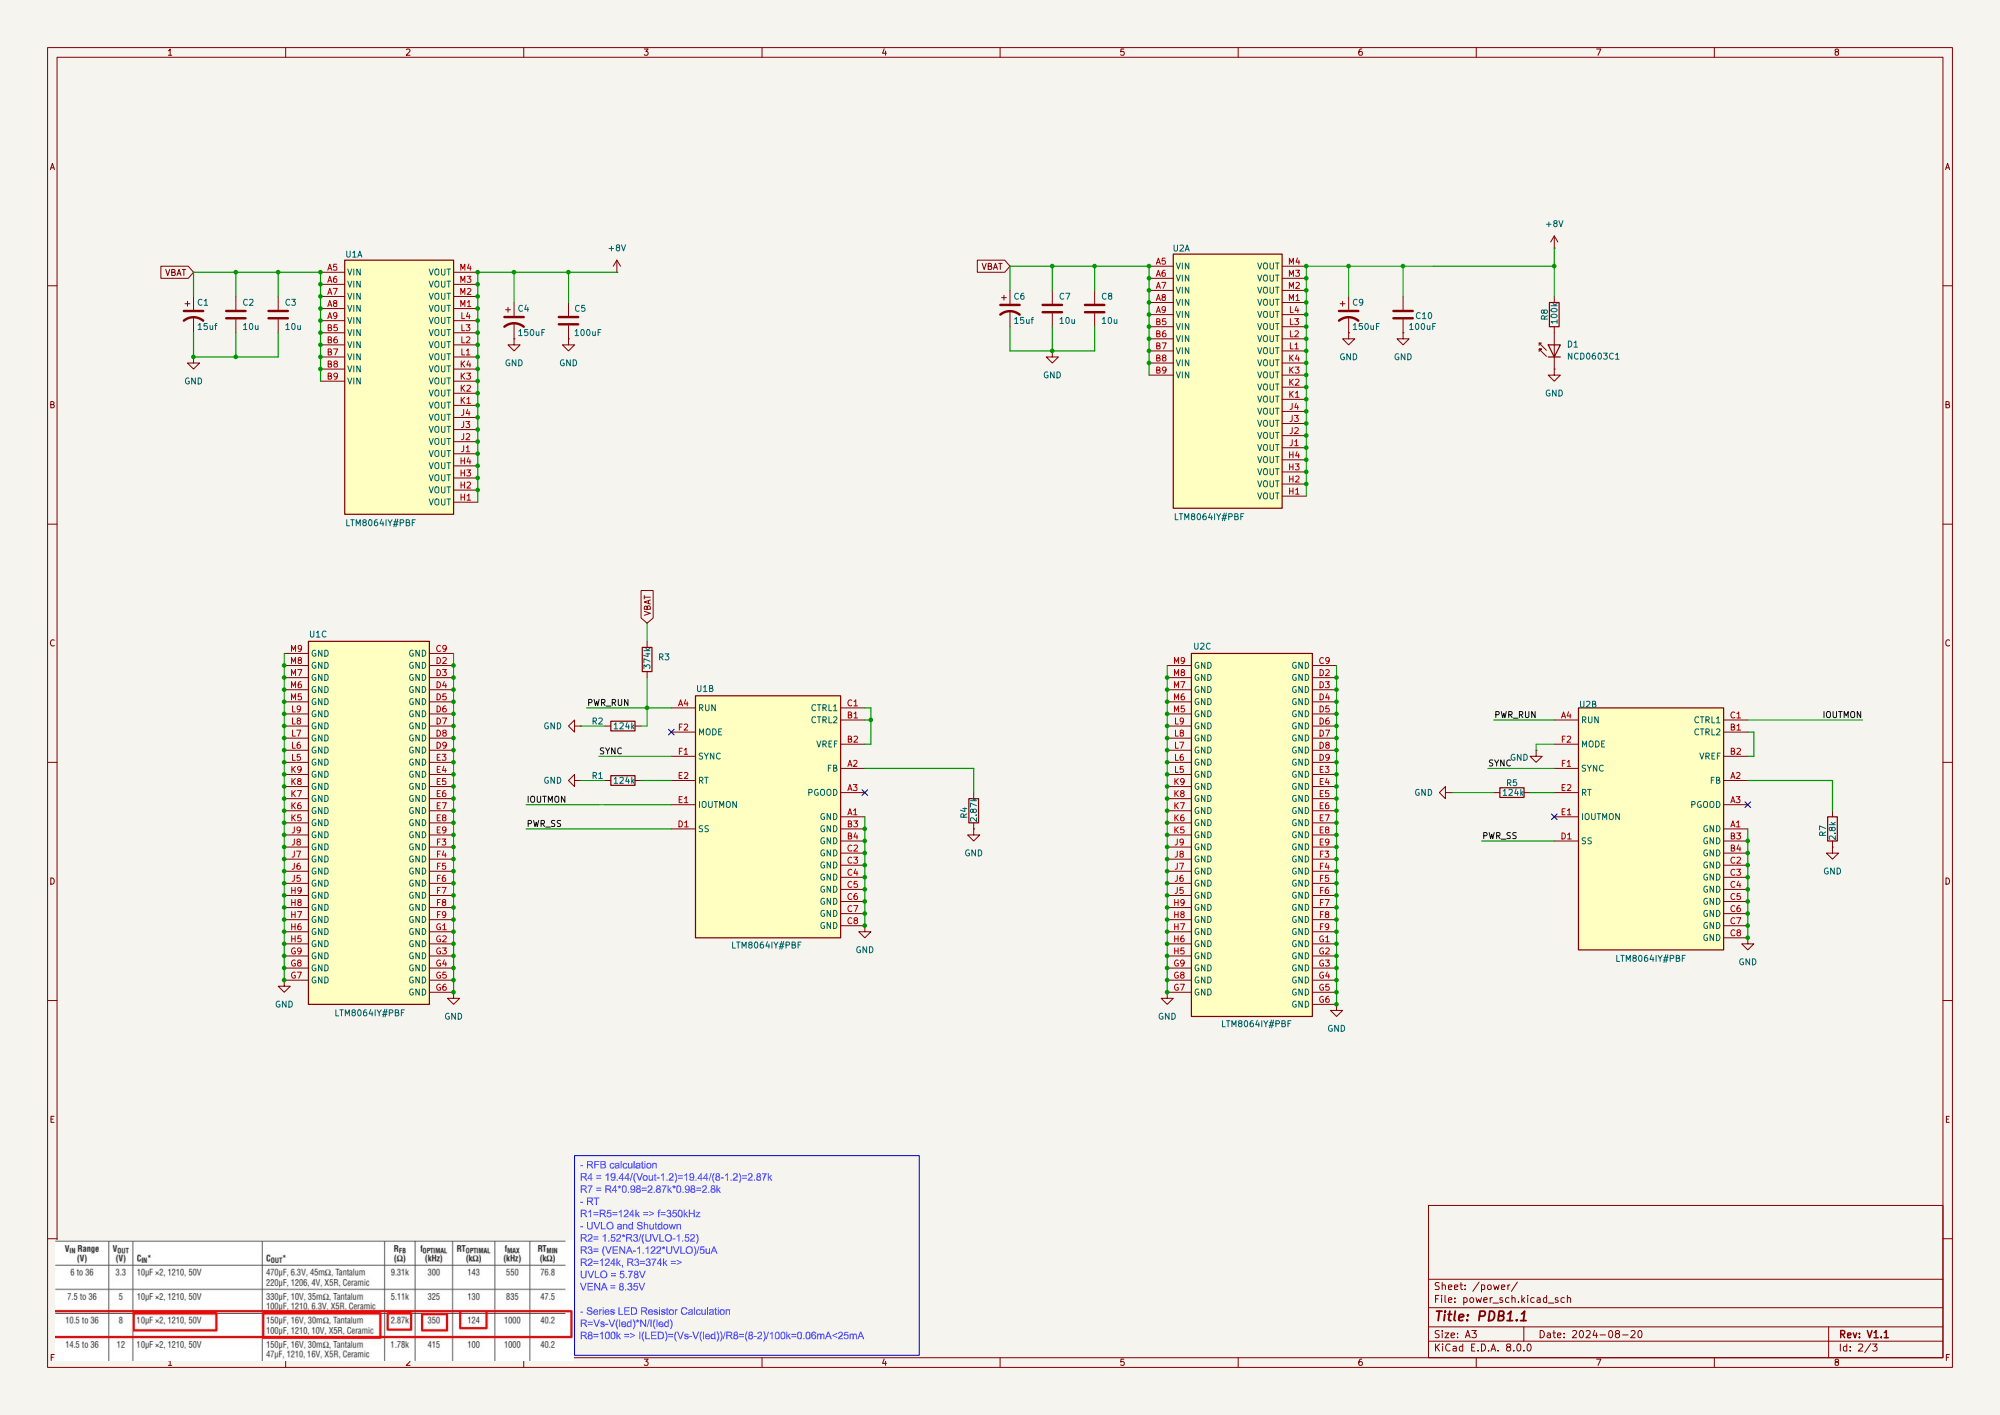
[picture p95: page 2]

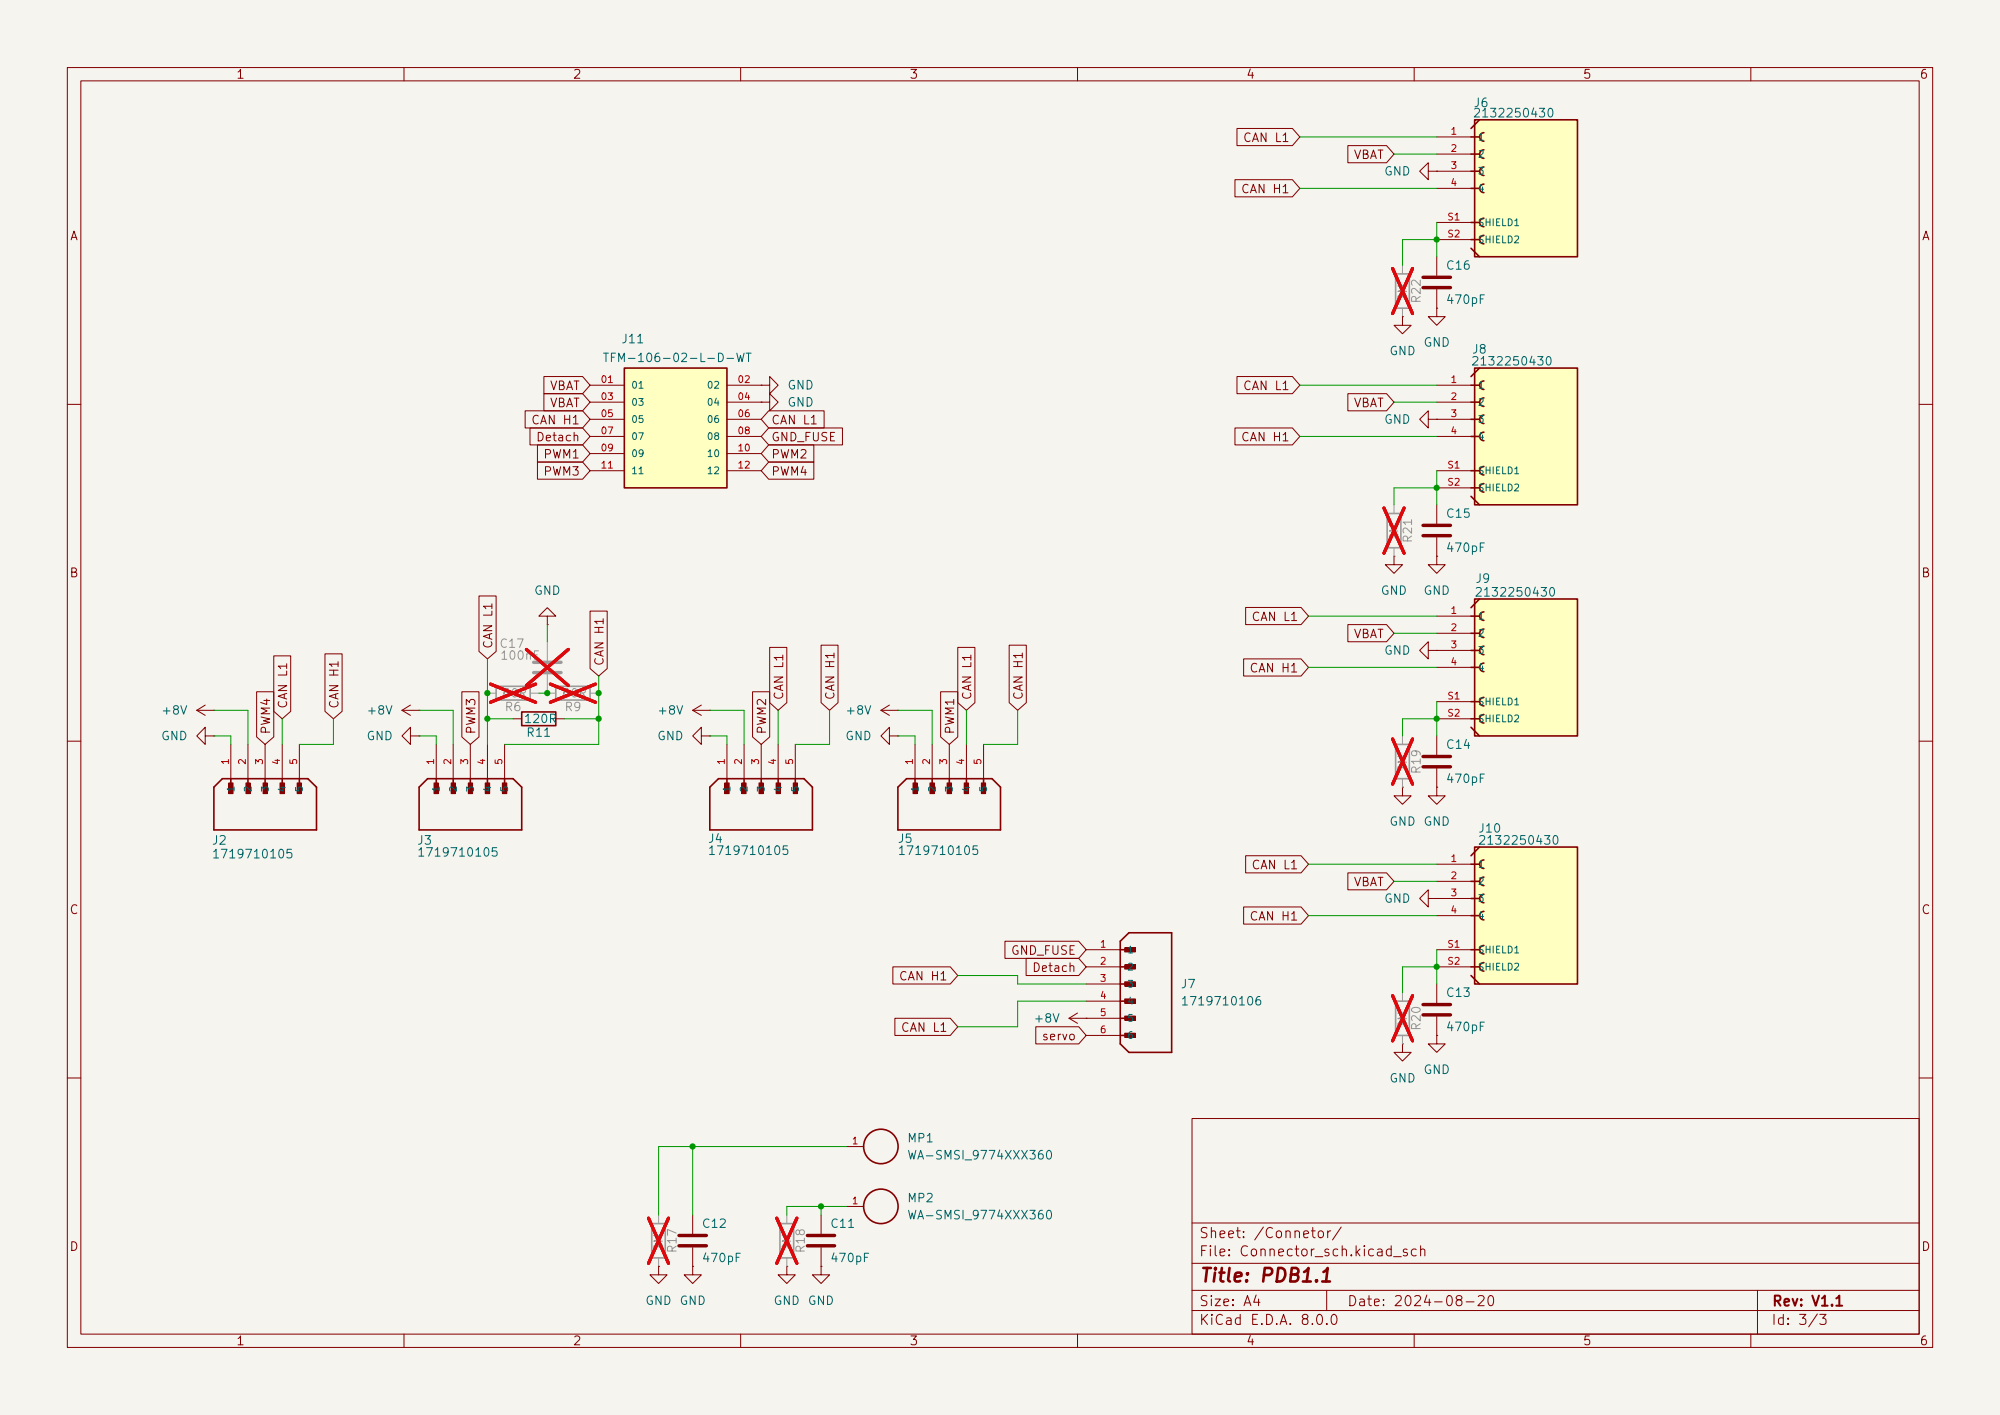
[picture p96: page 3]
