Pro-engineer616/pcb_projects_Alex/Radxa-Shield v1.1/Radxa Shield 1.0/source/circuit.pdf

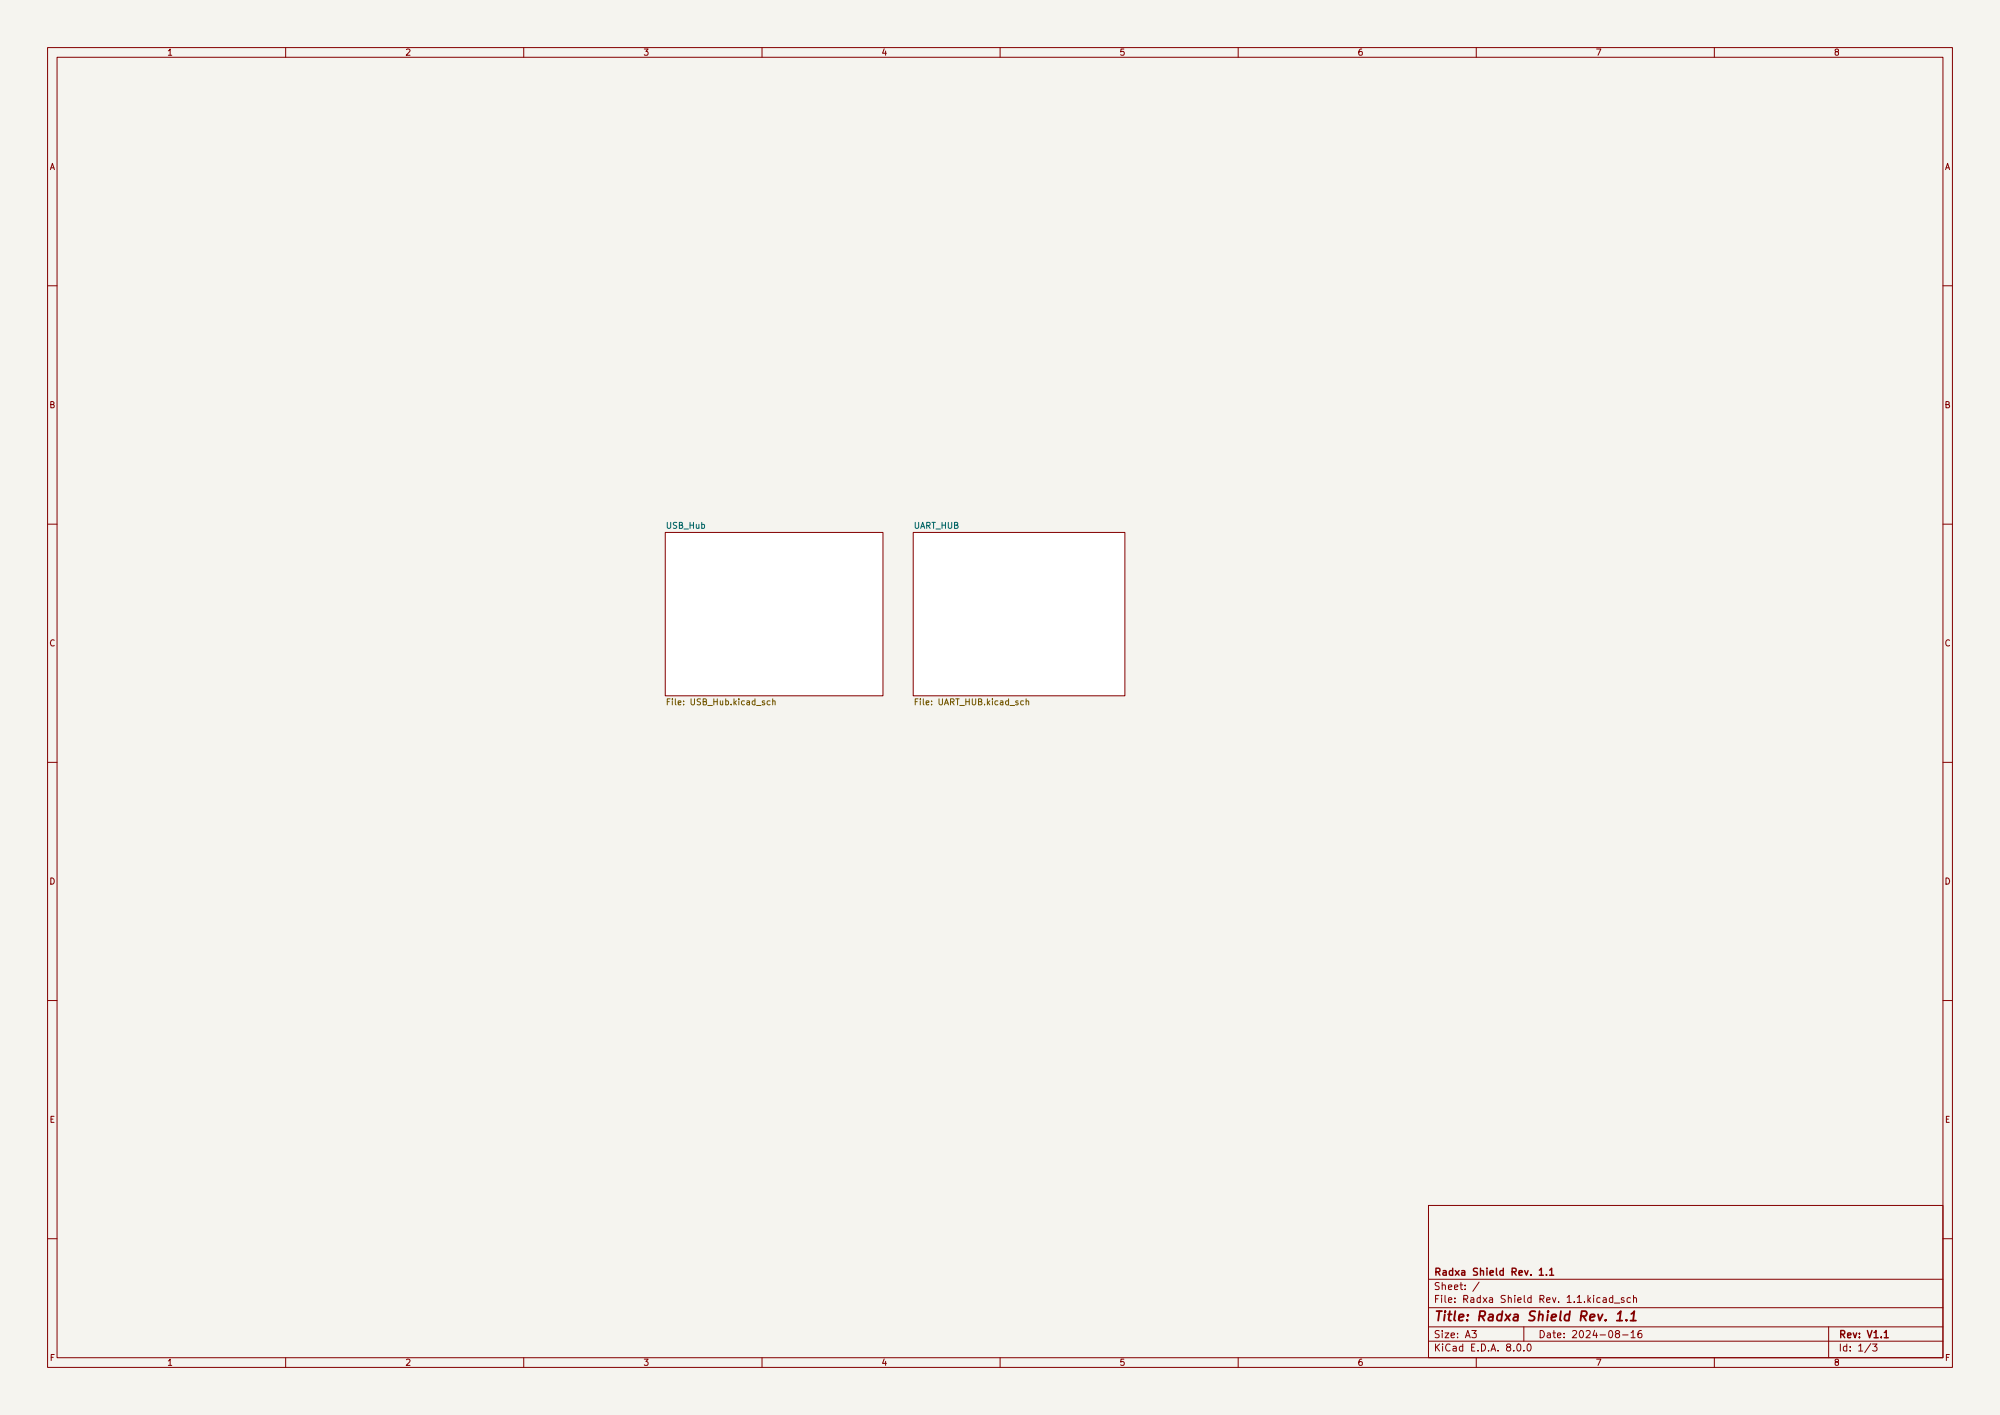
[picture p97: page 1]

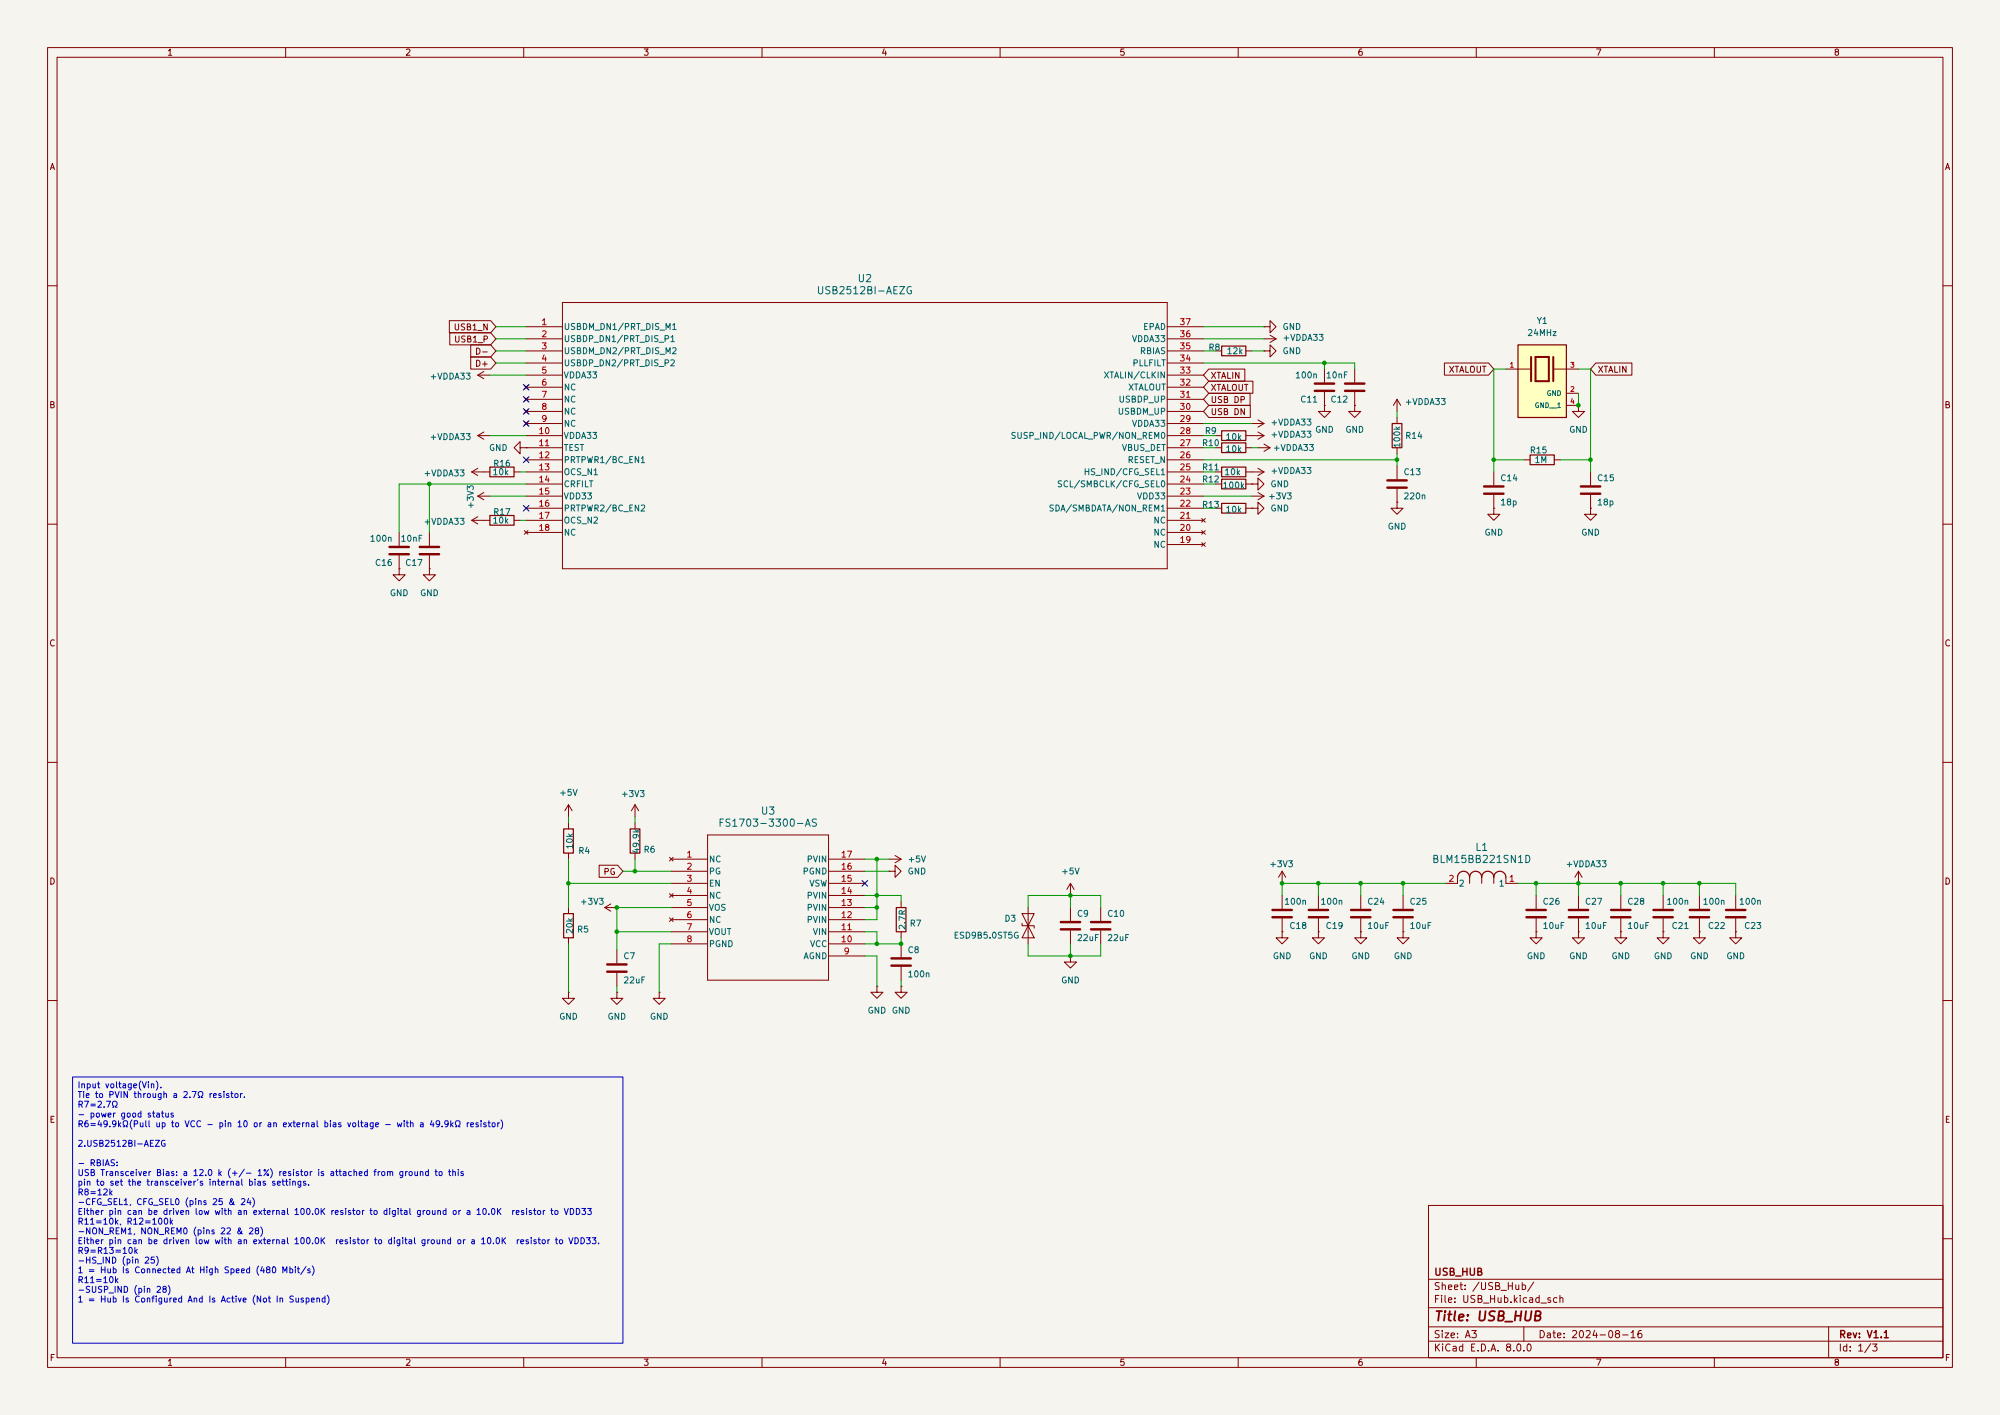
[picture p98: page 2]

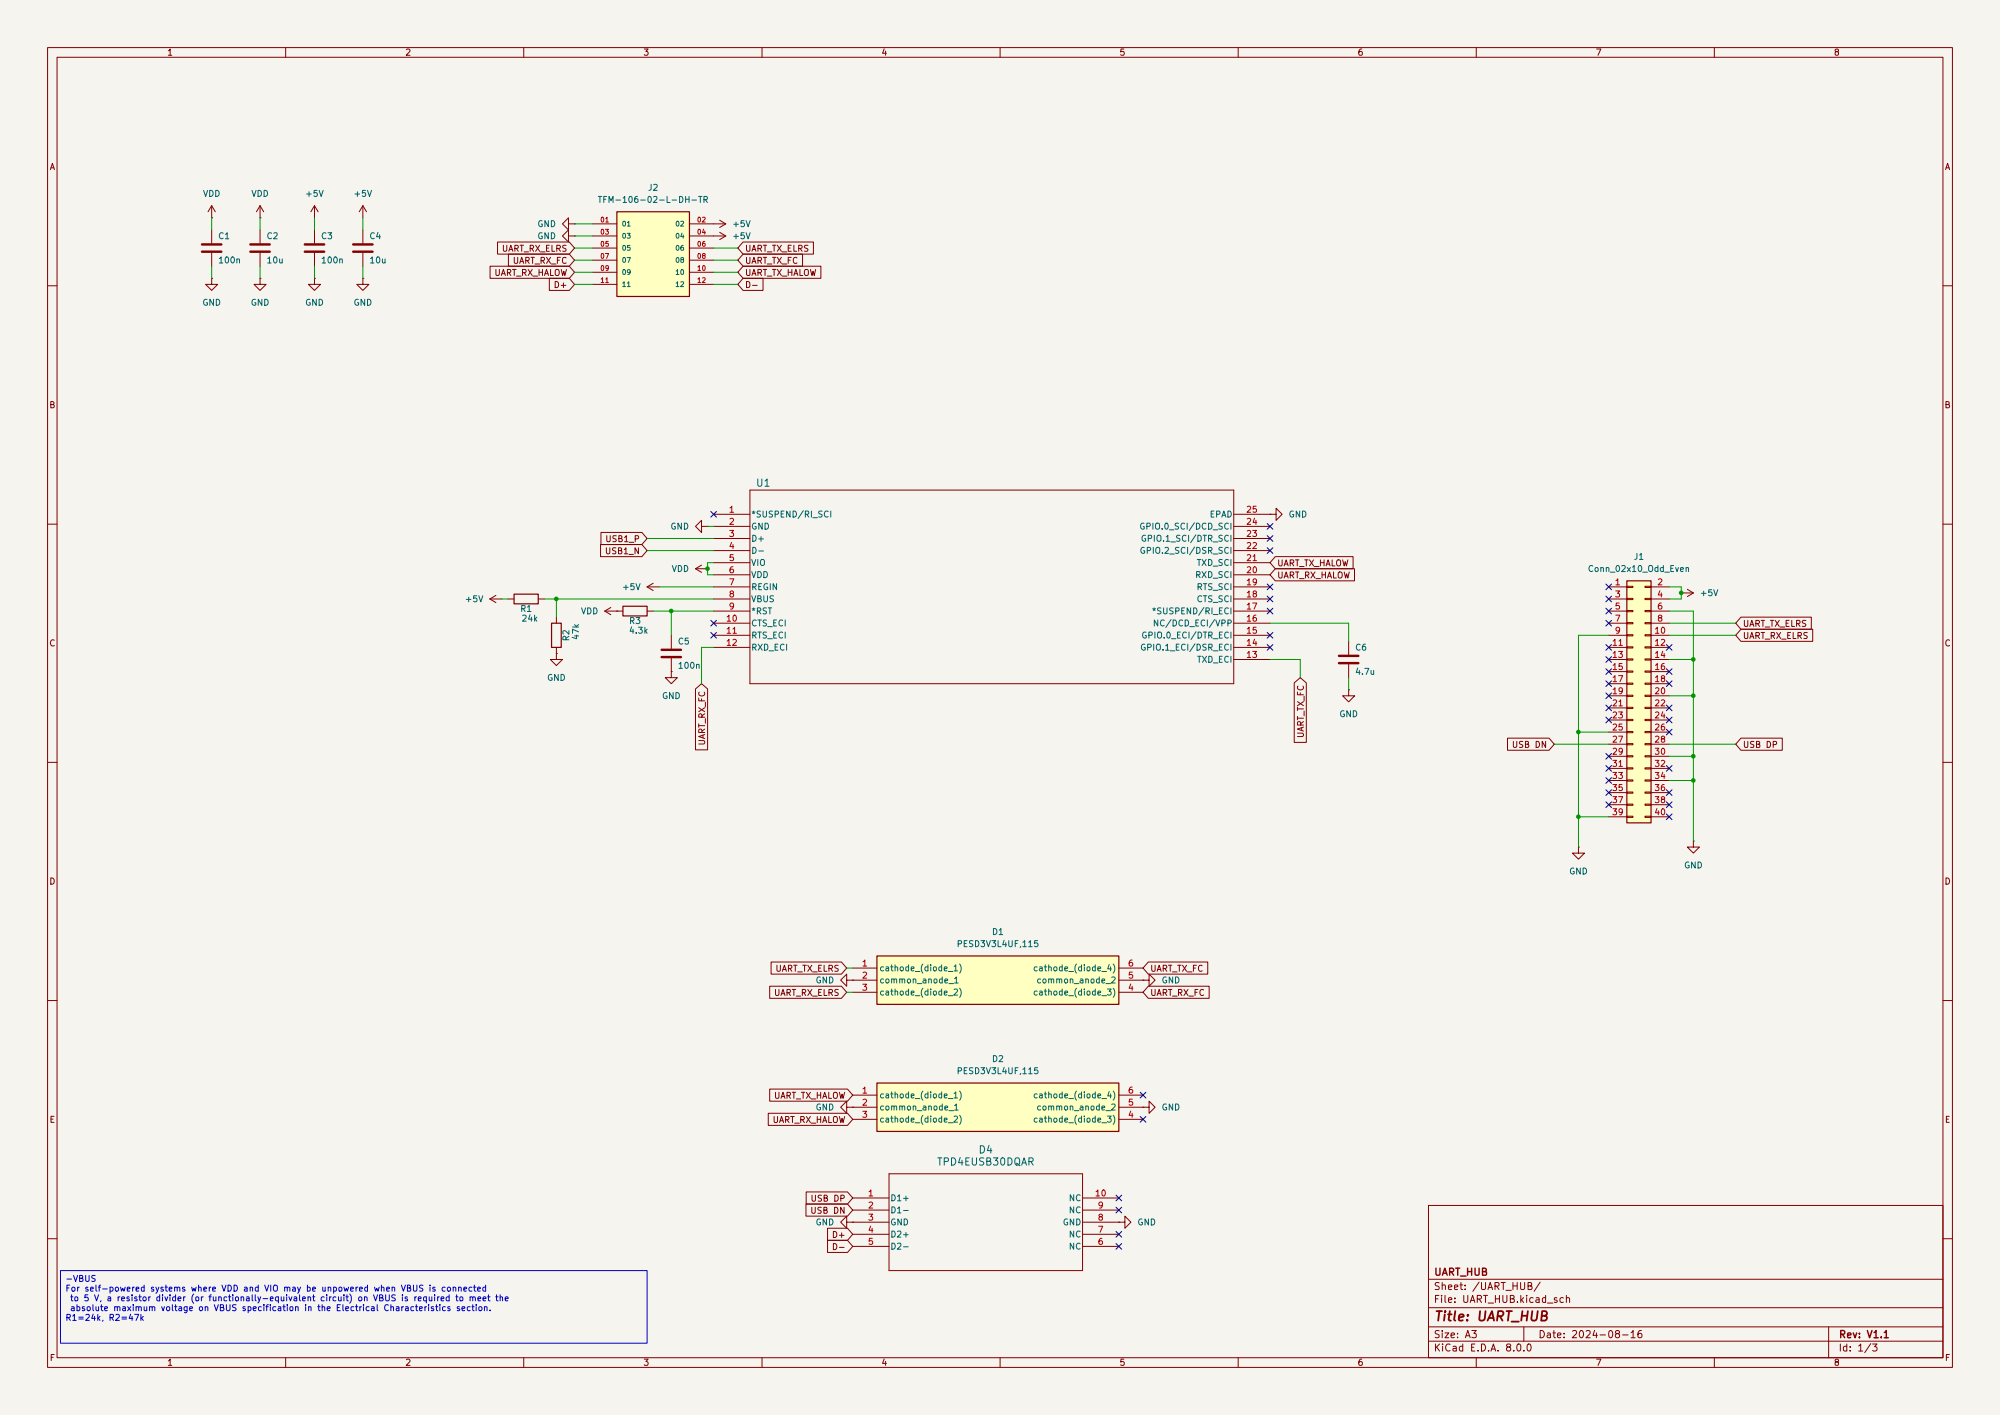
[picture p99: page 3]
