Pro-engineer616/pcb_projects_Alex/Radxa-Shield v1.1/Radxa Shield 1.0/source/Radxa Shield Rev. 1.1.pdf

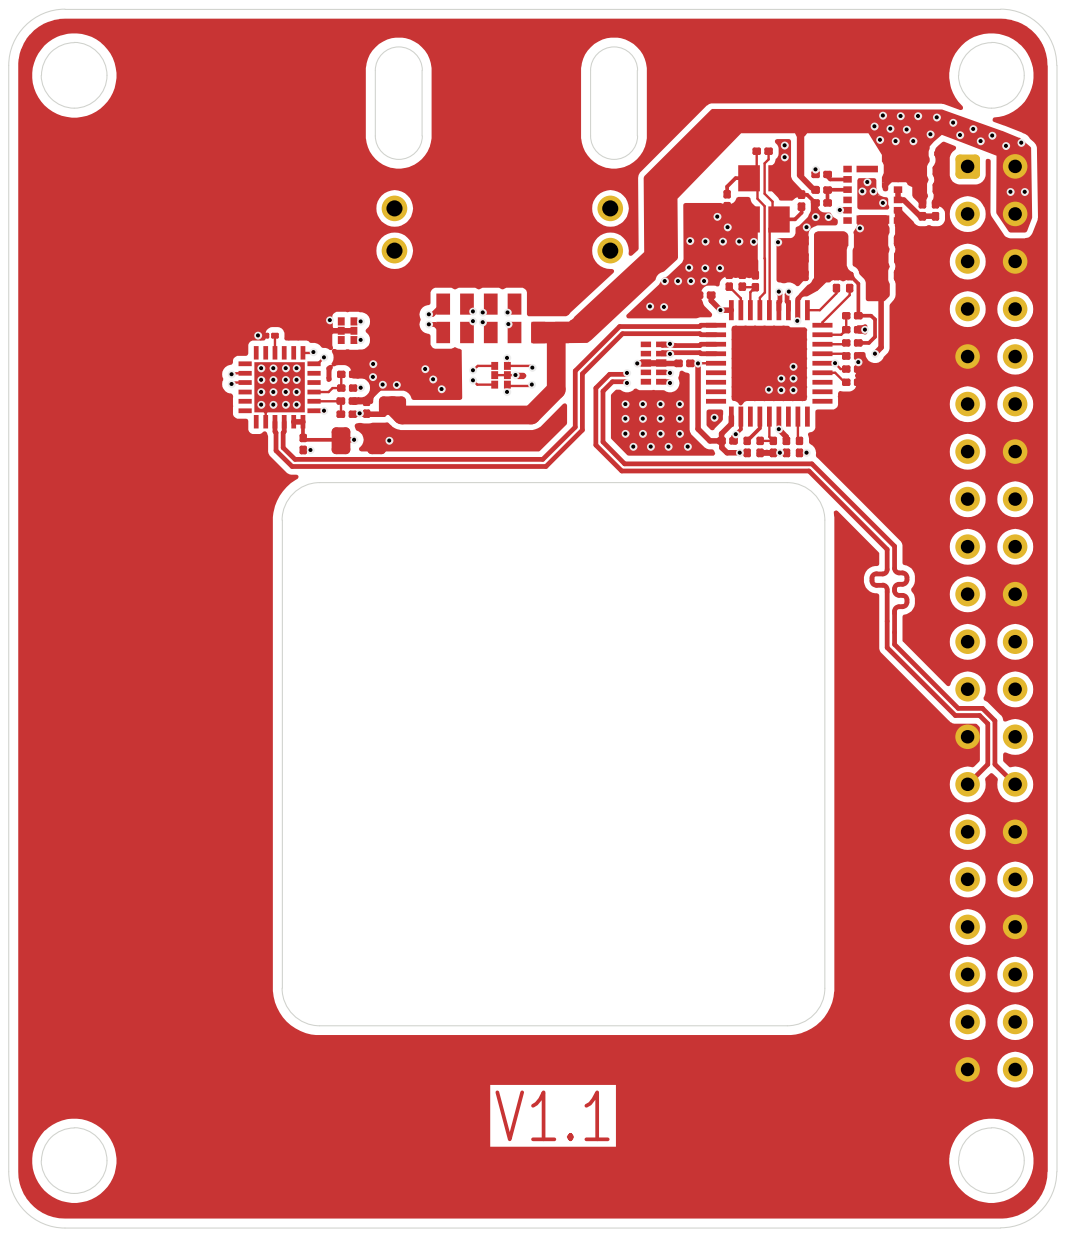
[picture p100: page 1]

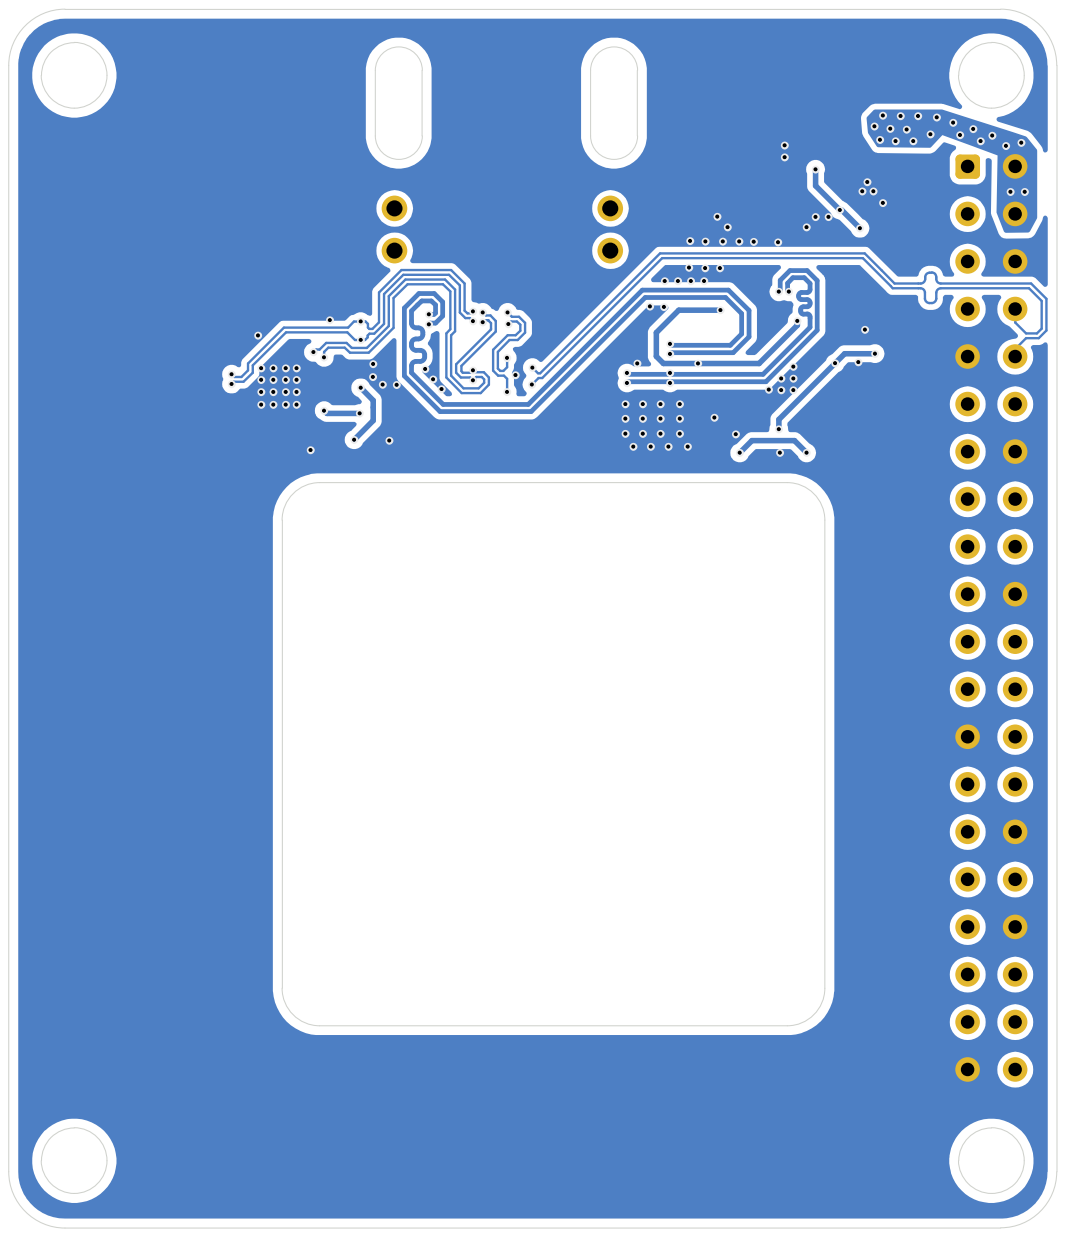
[picture p101: page 2]
