Pro-engineer616/pcb_projects_Alex/PDB v1.1/PDB1.1/source/PDB/PDB_circuit.pdf

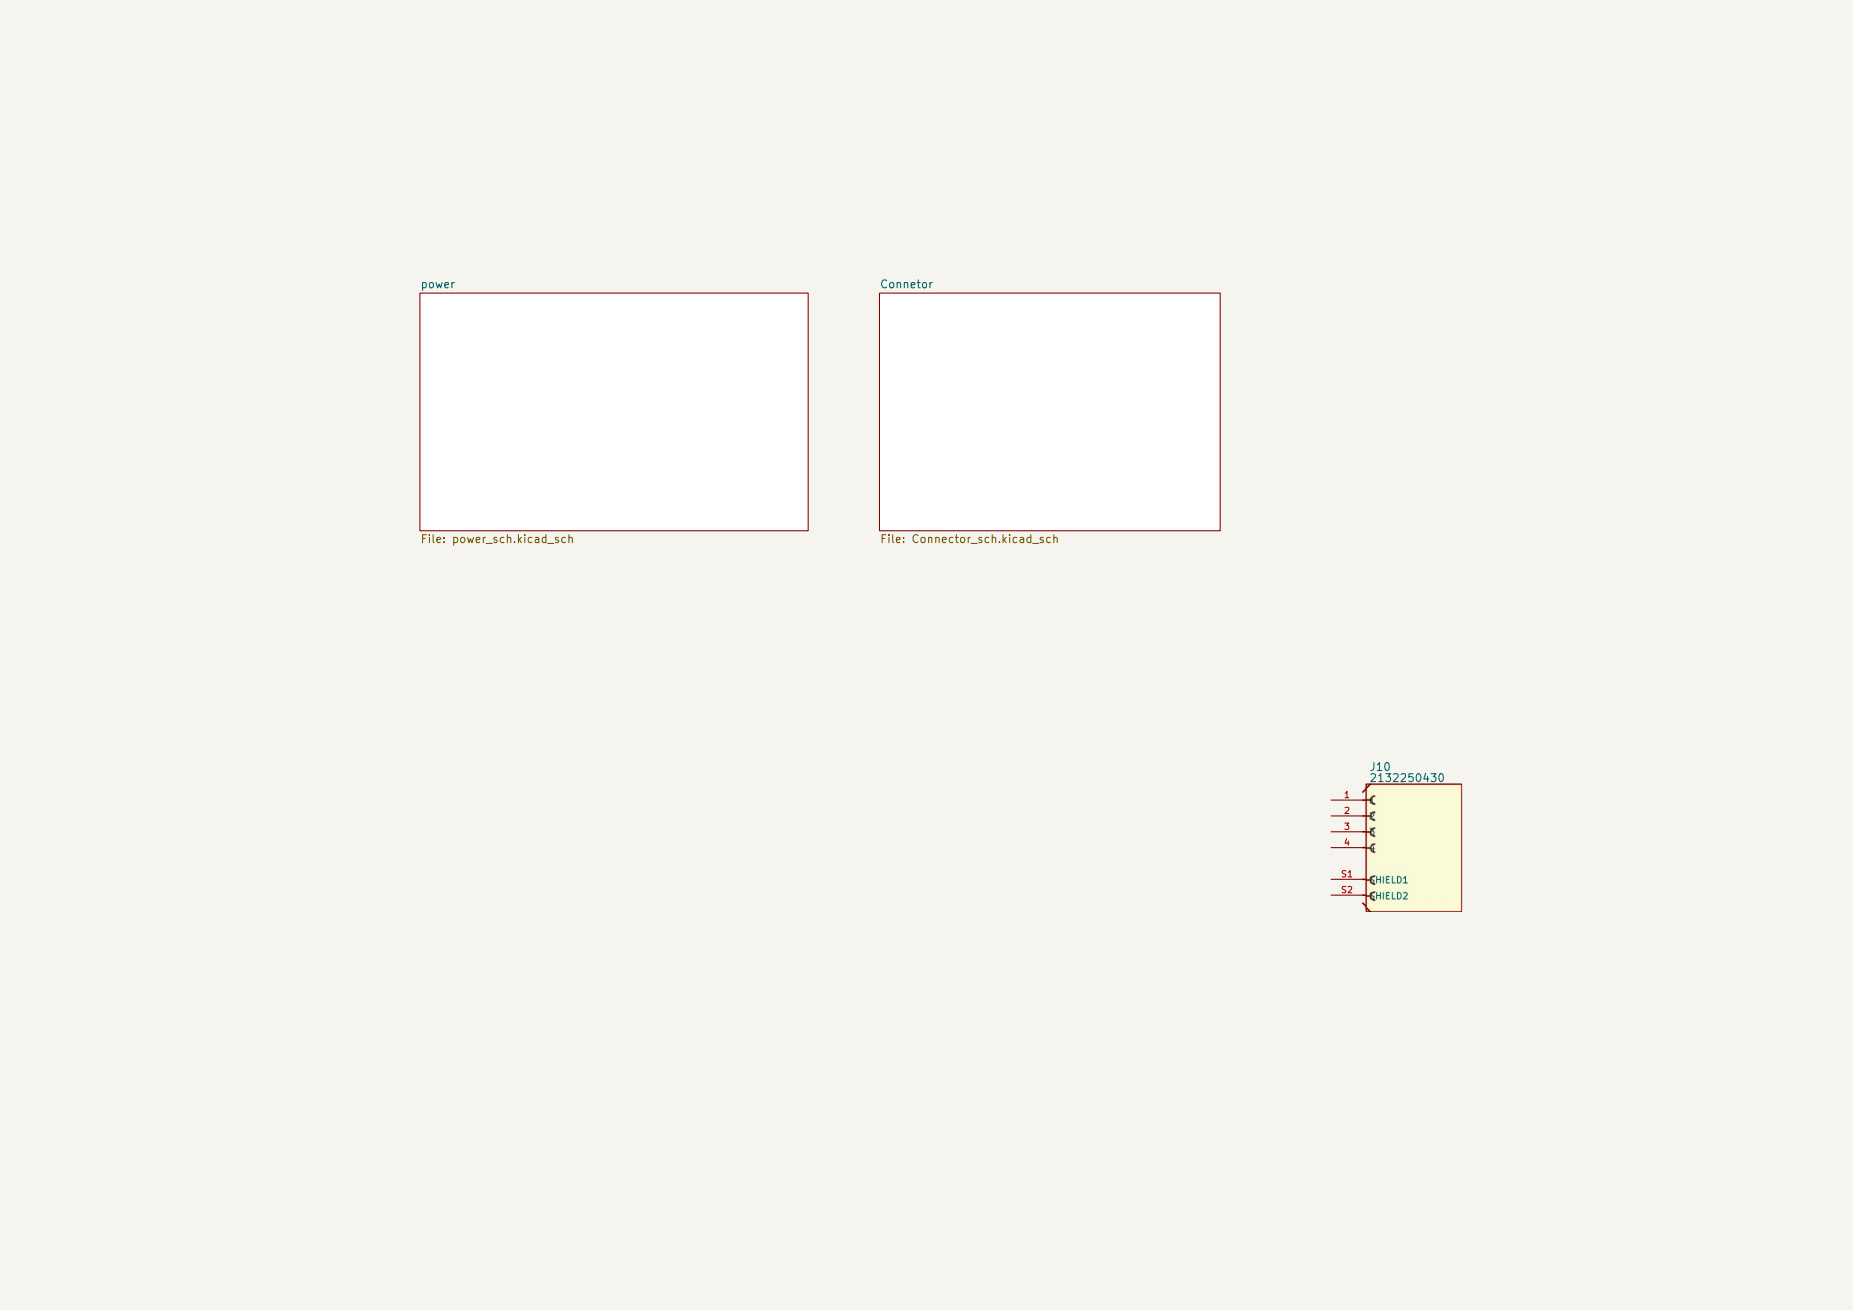
[picture p102: page 1]

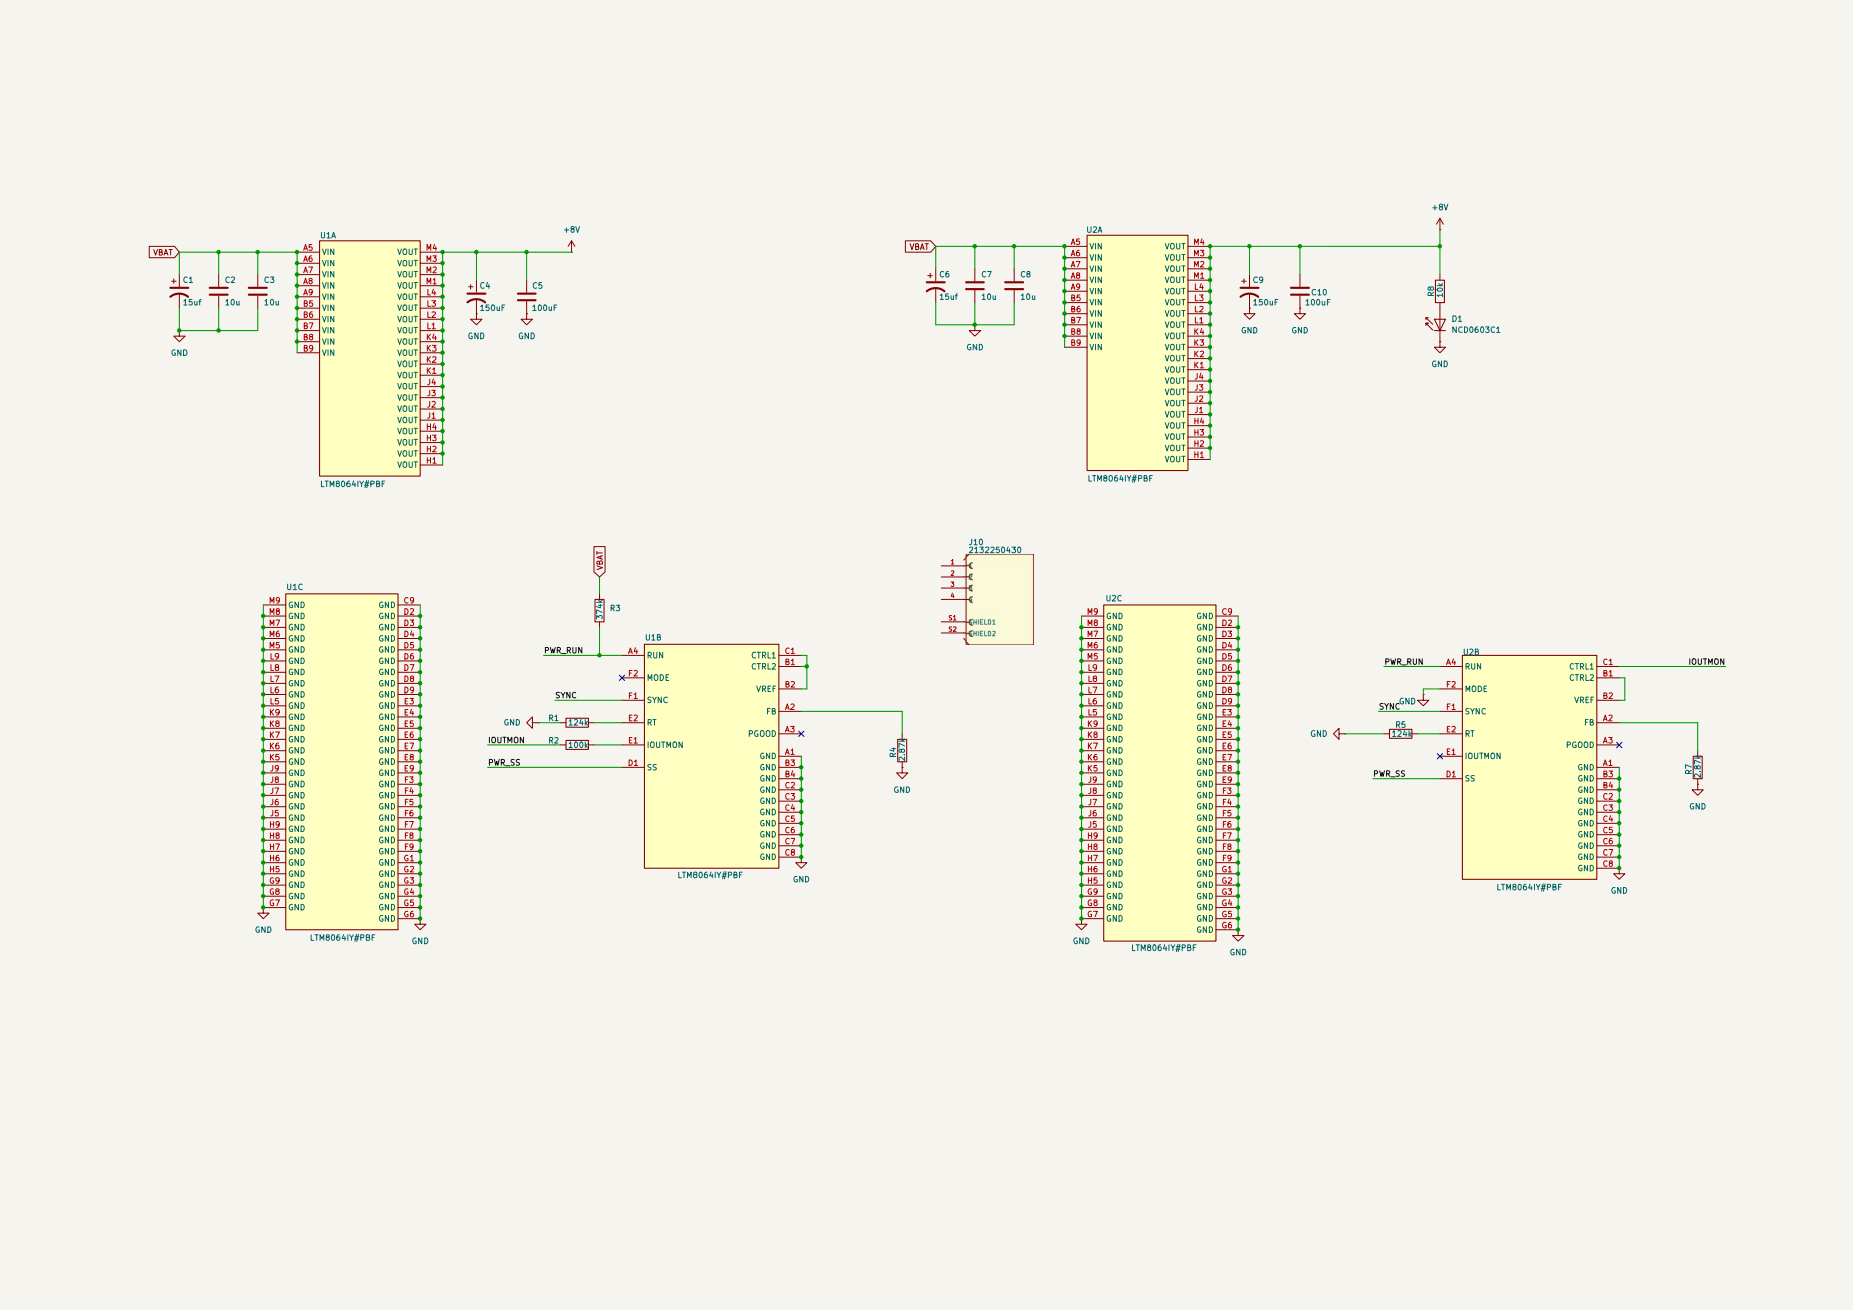
[picture p103: page 2]

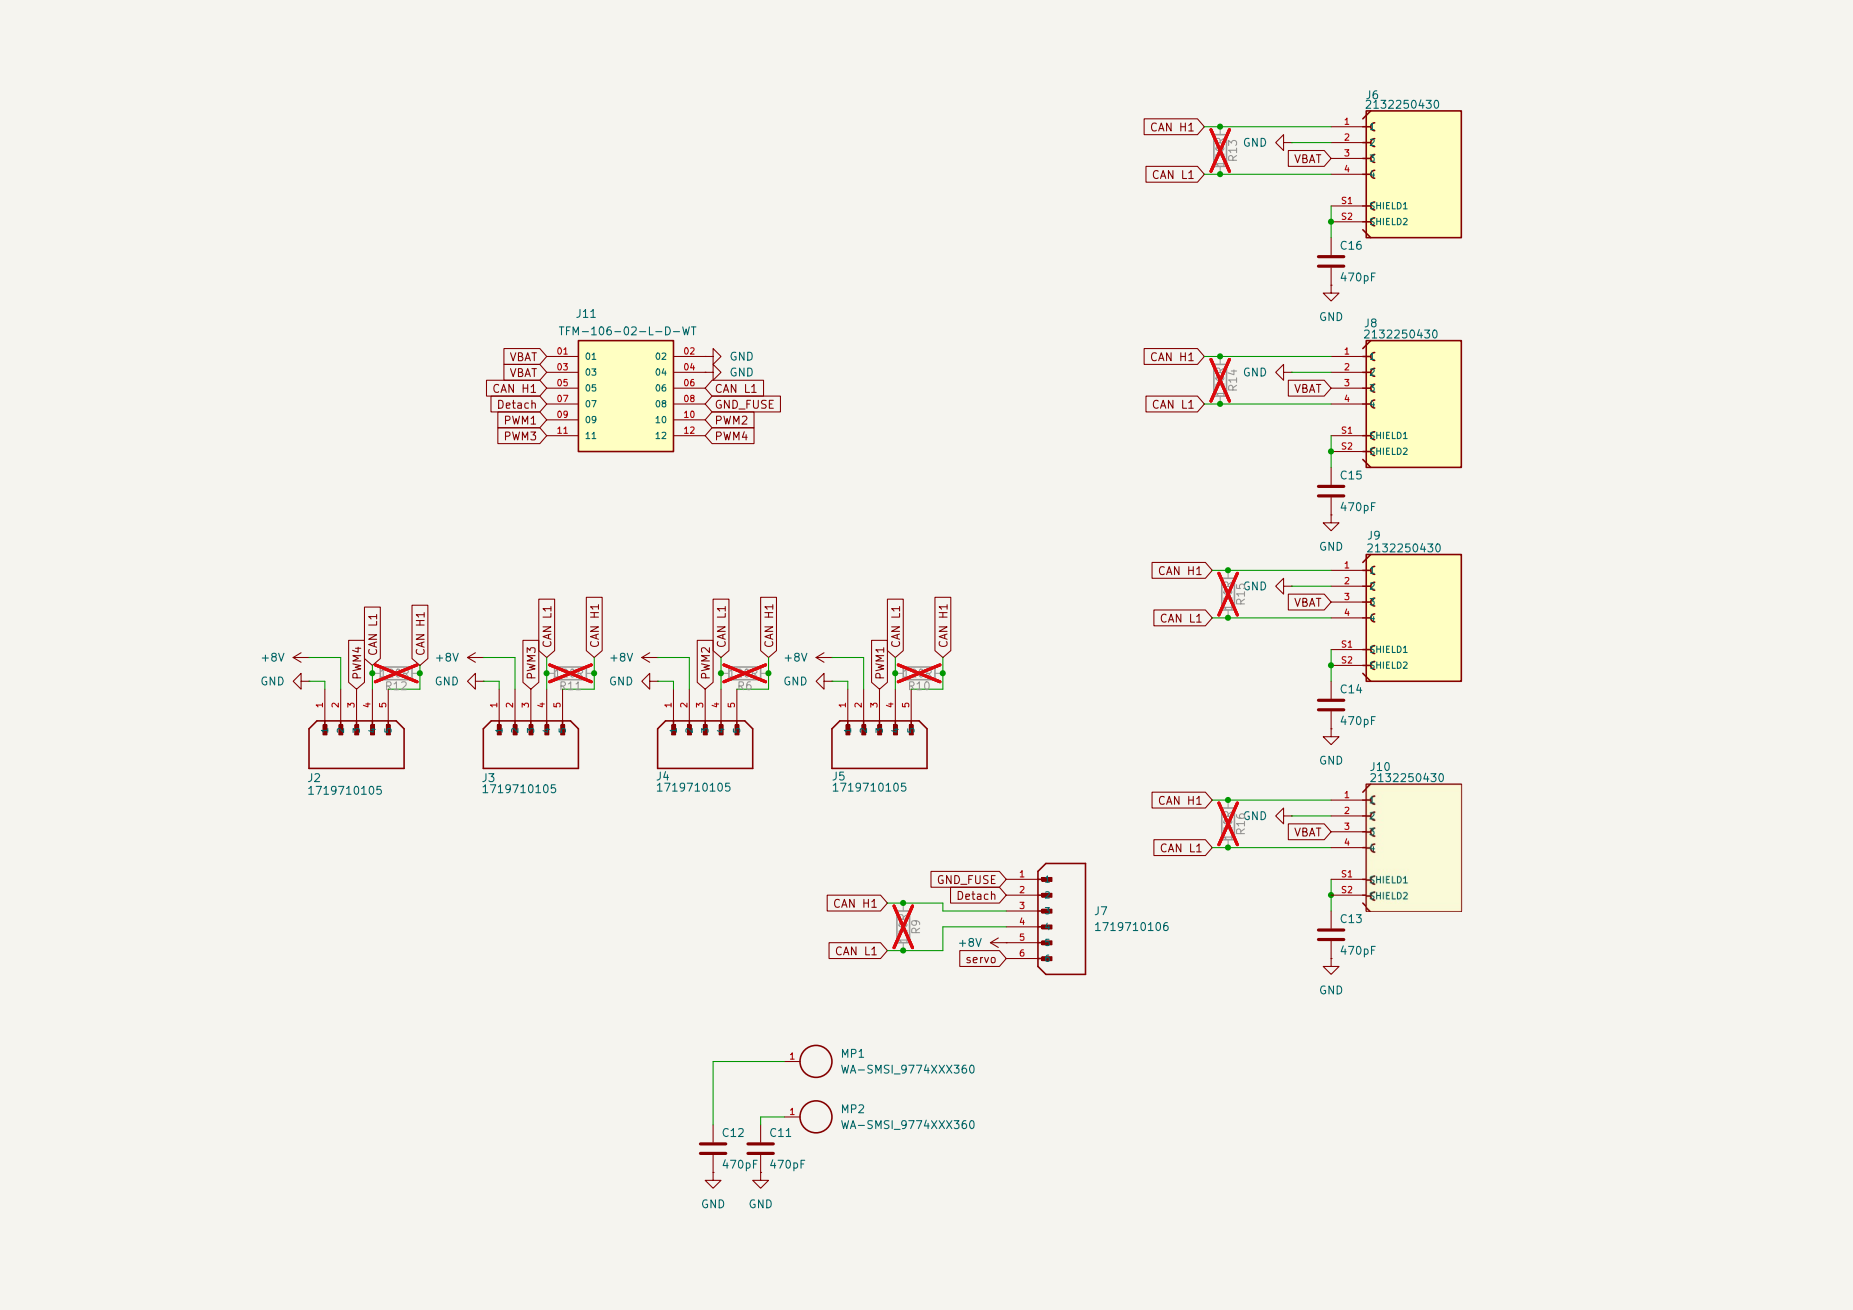
[picture p104: page 3]
