Pro-engineer616/pcb_projects_Alex/PDB v1.1/PDB1.1/source/PDB/PDB_layout.pdf

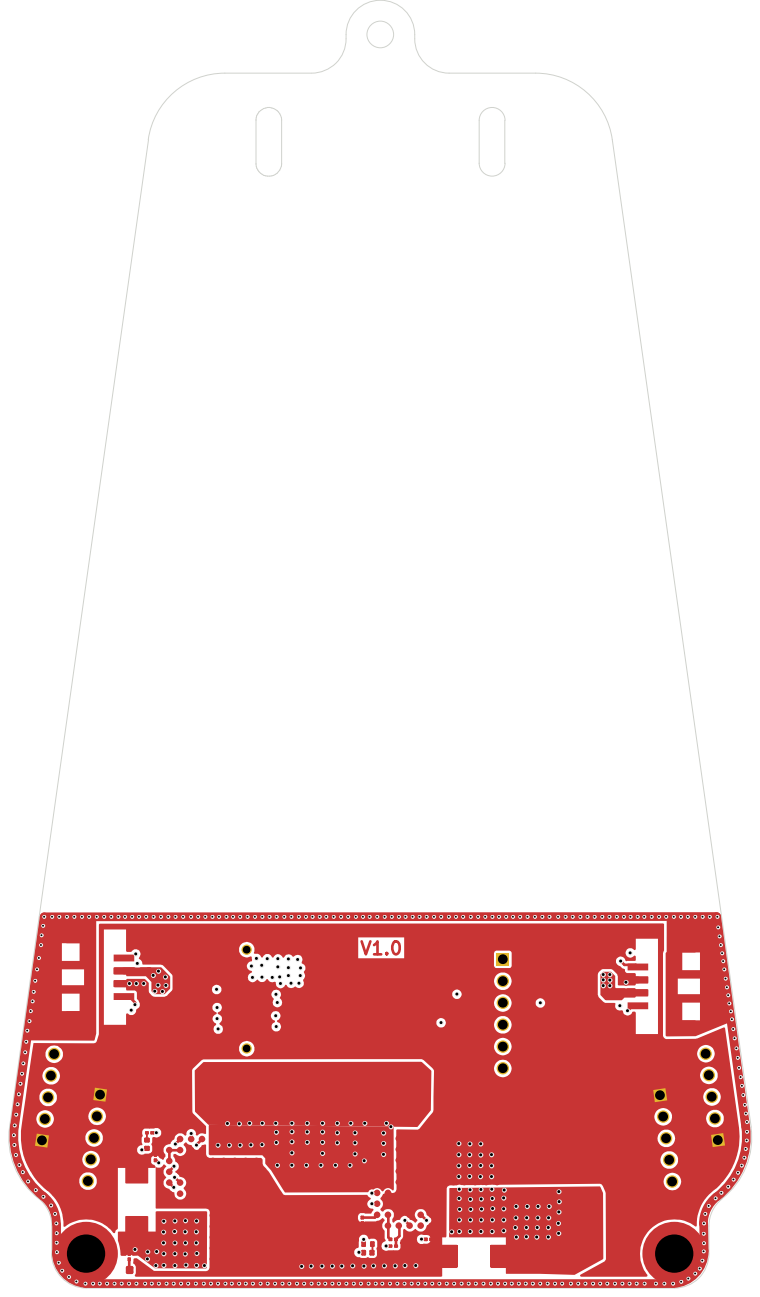
[picture p105: page 1]

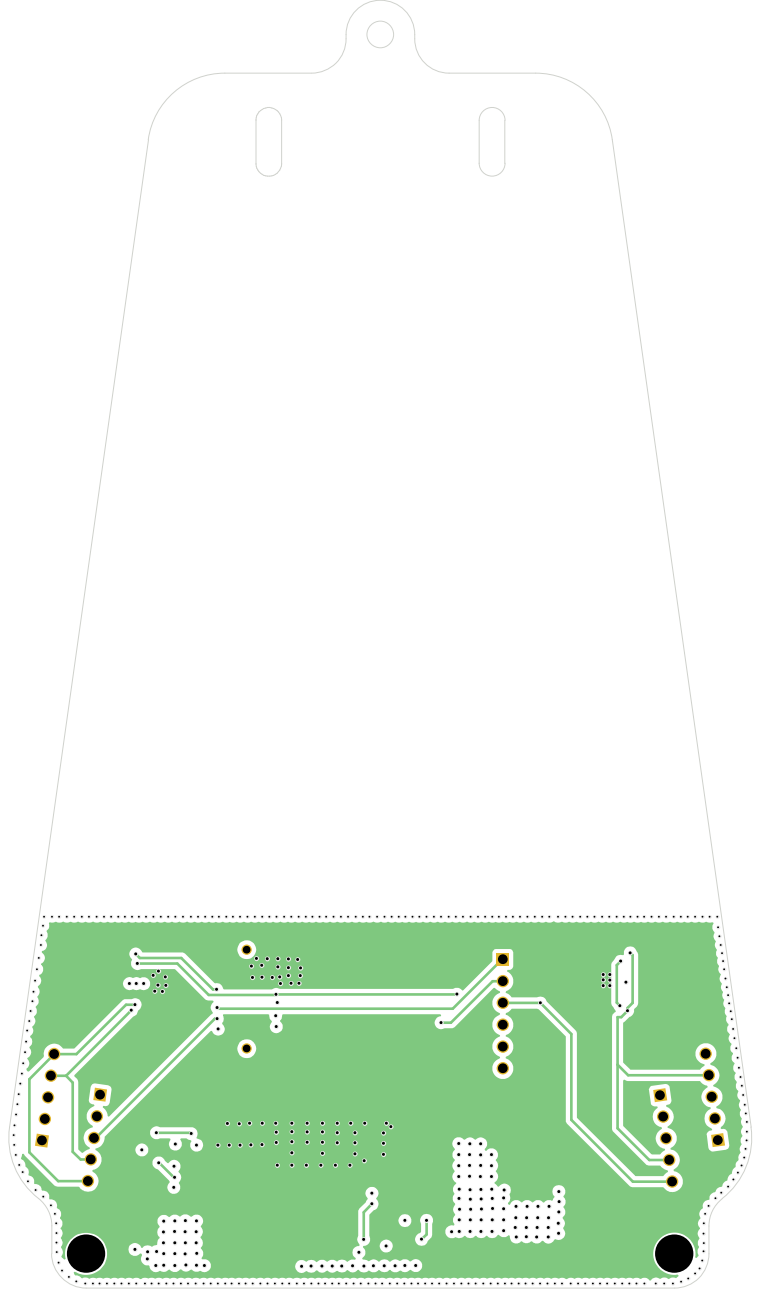
[picture p106: page 2]

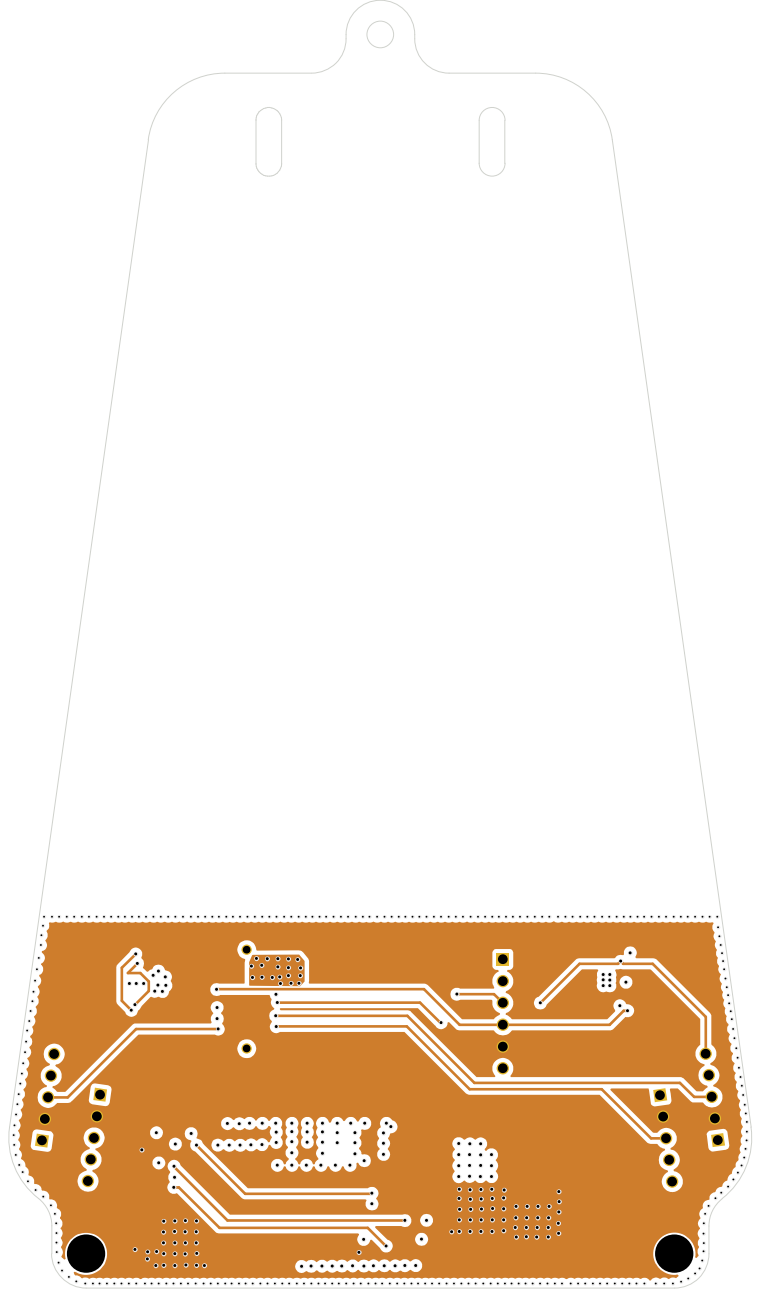
[picture p107: page 3]

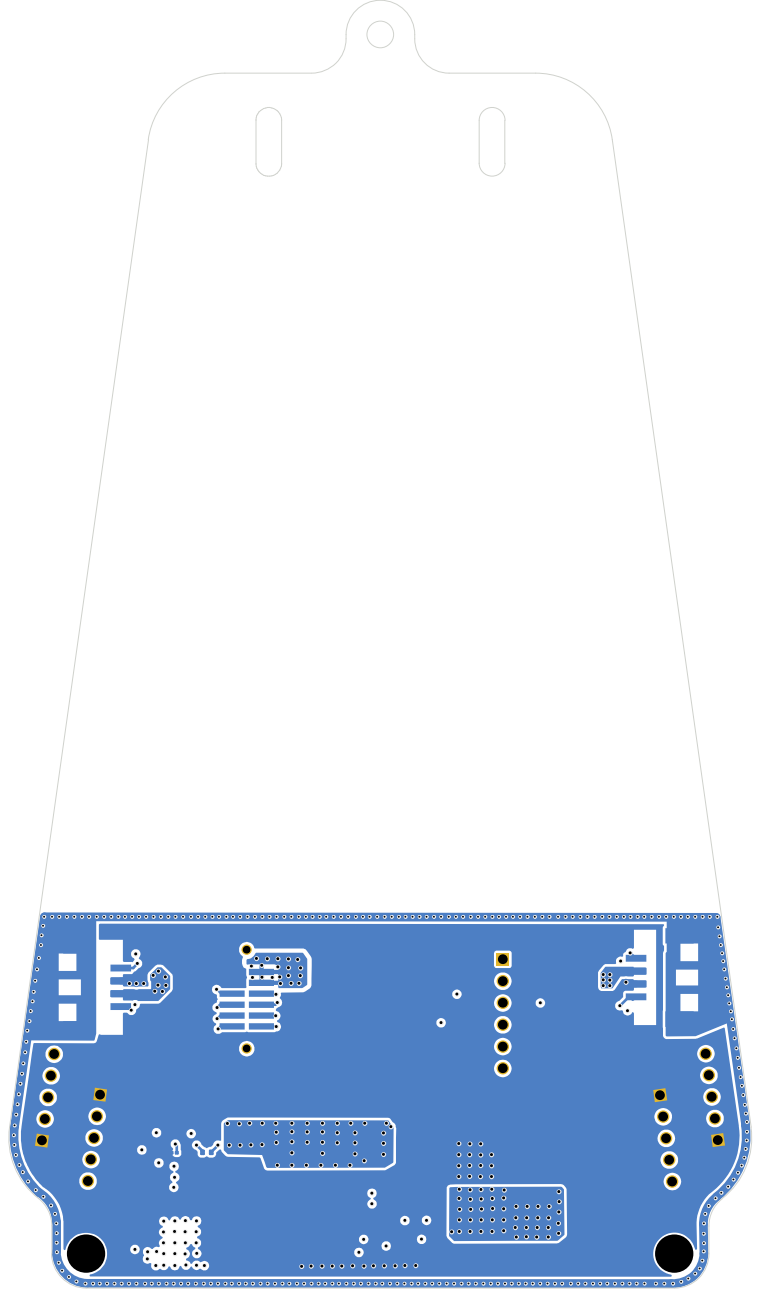
[picture p108: page 4]
