Pro-engineer616/pcb_projects_Alex/Sensor-Node v1.1/Sensor_node_1.0/Radxa-shield/source/RADXA5.0/PCB.pdf

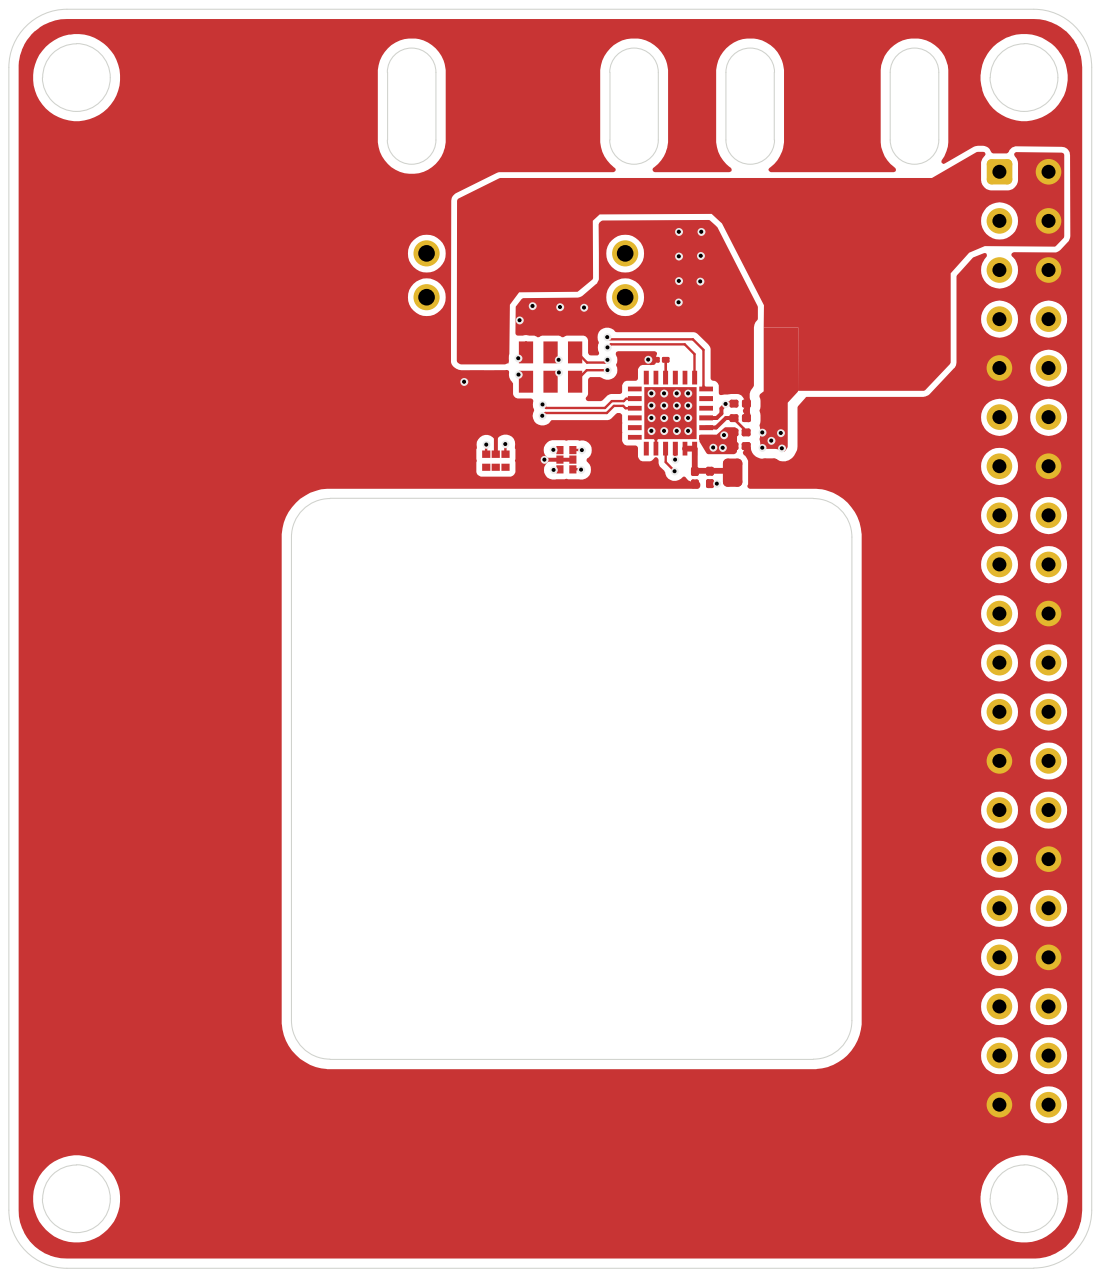
[picture p109: page 1]

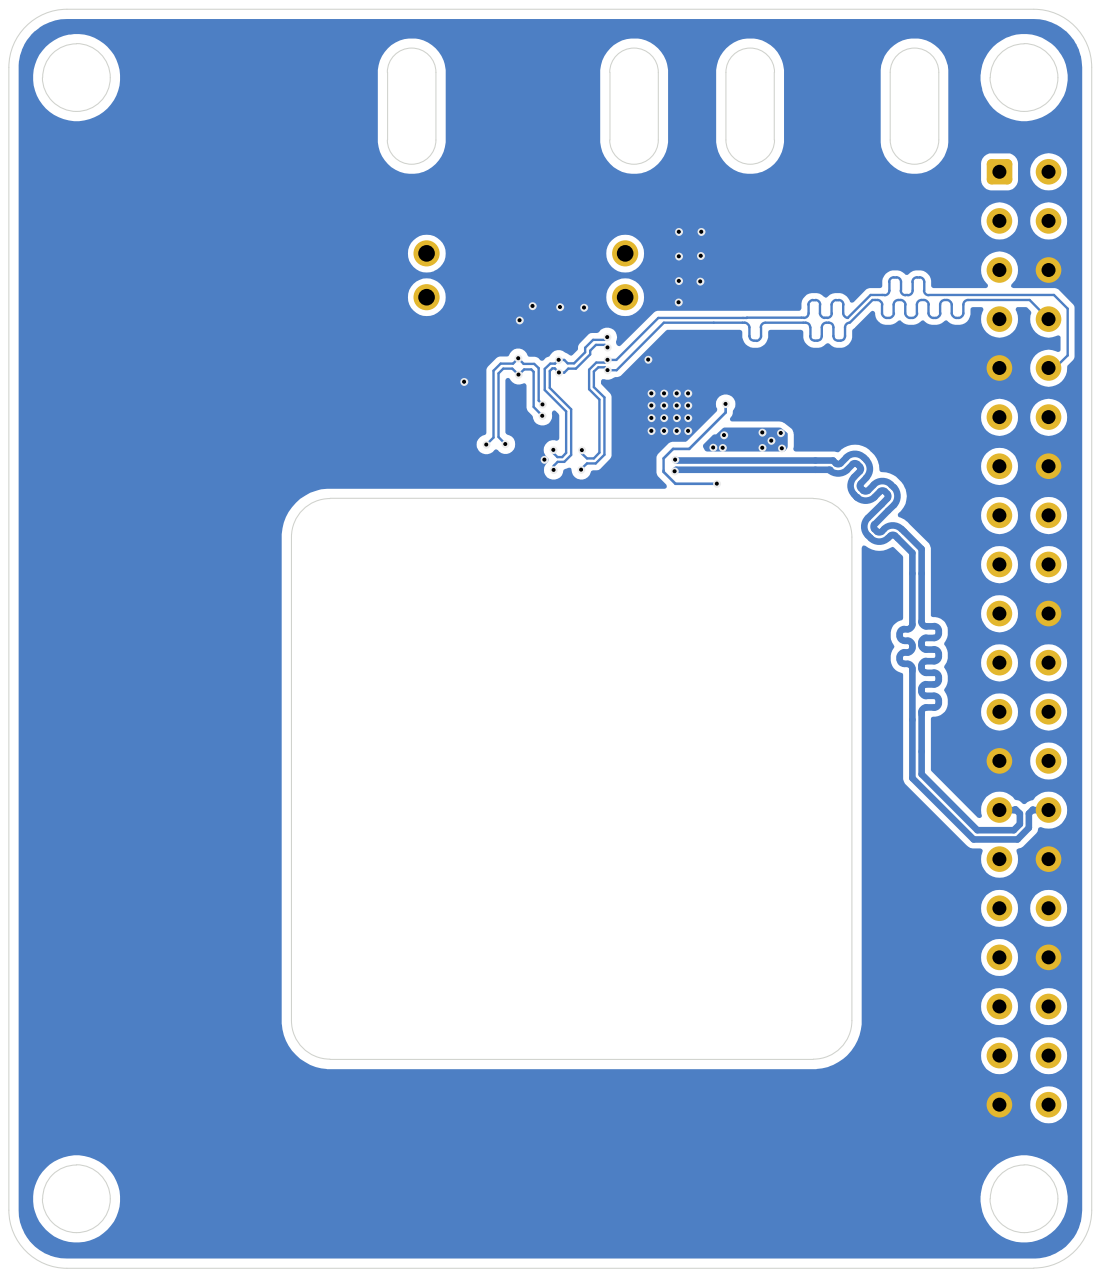
[picture p110: page 2]
