Pro-engineer616/pcb_projects_Alex/(list of files, drawings)

Other design files:
infrastructure-board/source/infrastructure/package/LIB_IP175G/IP175G/Altium/IP175G.SchLib
infrastructure-board/source/infrastructure/package/LIB_IP175G/IP175G/Altium/QFN40P600X600X90-49N-D.PcbLib
infrastructure-board/source/infrastructure/package/LIB_QT48A03/QT48A03/Altium/QT48A03.SchLib
infrastructure-board/source/infrastructure/package/LIB_QT48A03/QT48A03/Altium/SOP102P1536X780-48N.PcbLib
Sensor-Node v1.1/Sensor_node_1.0/LIB_KMR621NGLFS/KMR621NGLFS/Altium/KMR621NGLFS.PcbLib
Sensor-Node v1.1/Sensor_node_1.0/LIB_KMR621NGLFS/KMR621NGLFS/Altium/KMR621NGLFS.SchLib
Sensor-Node v1.2/sensornodeV1.2/LIB_KMR621NGLFS/KMR621NGLFS/Altium/KMR621NGLFS.PcbLib
Sensor-Node v1.2/sensornodeV1.2/LIB_KMR621NGLFS/KMR621NGLFS/Altium/KMR621NGLFS.SchLib
