Pro-engineer616/pcb_projects_Alex/Radxa-Shield v1.2/source/Radxa Shield Rev. 1.2.kicad_pcb

## KiCad design Radxa-Shield v1.2/source/Radxa Shield Rev. 1.2.kicad_pcb (2024-09-19)

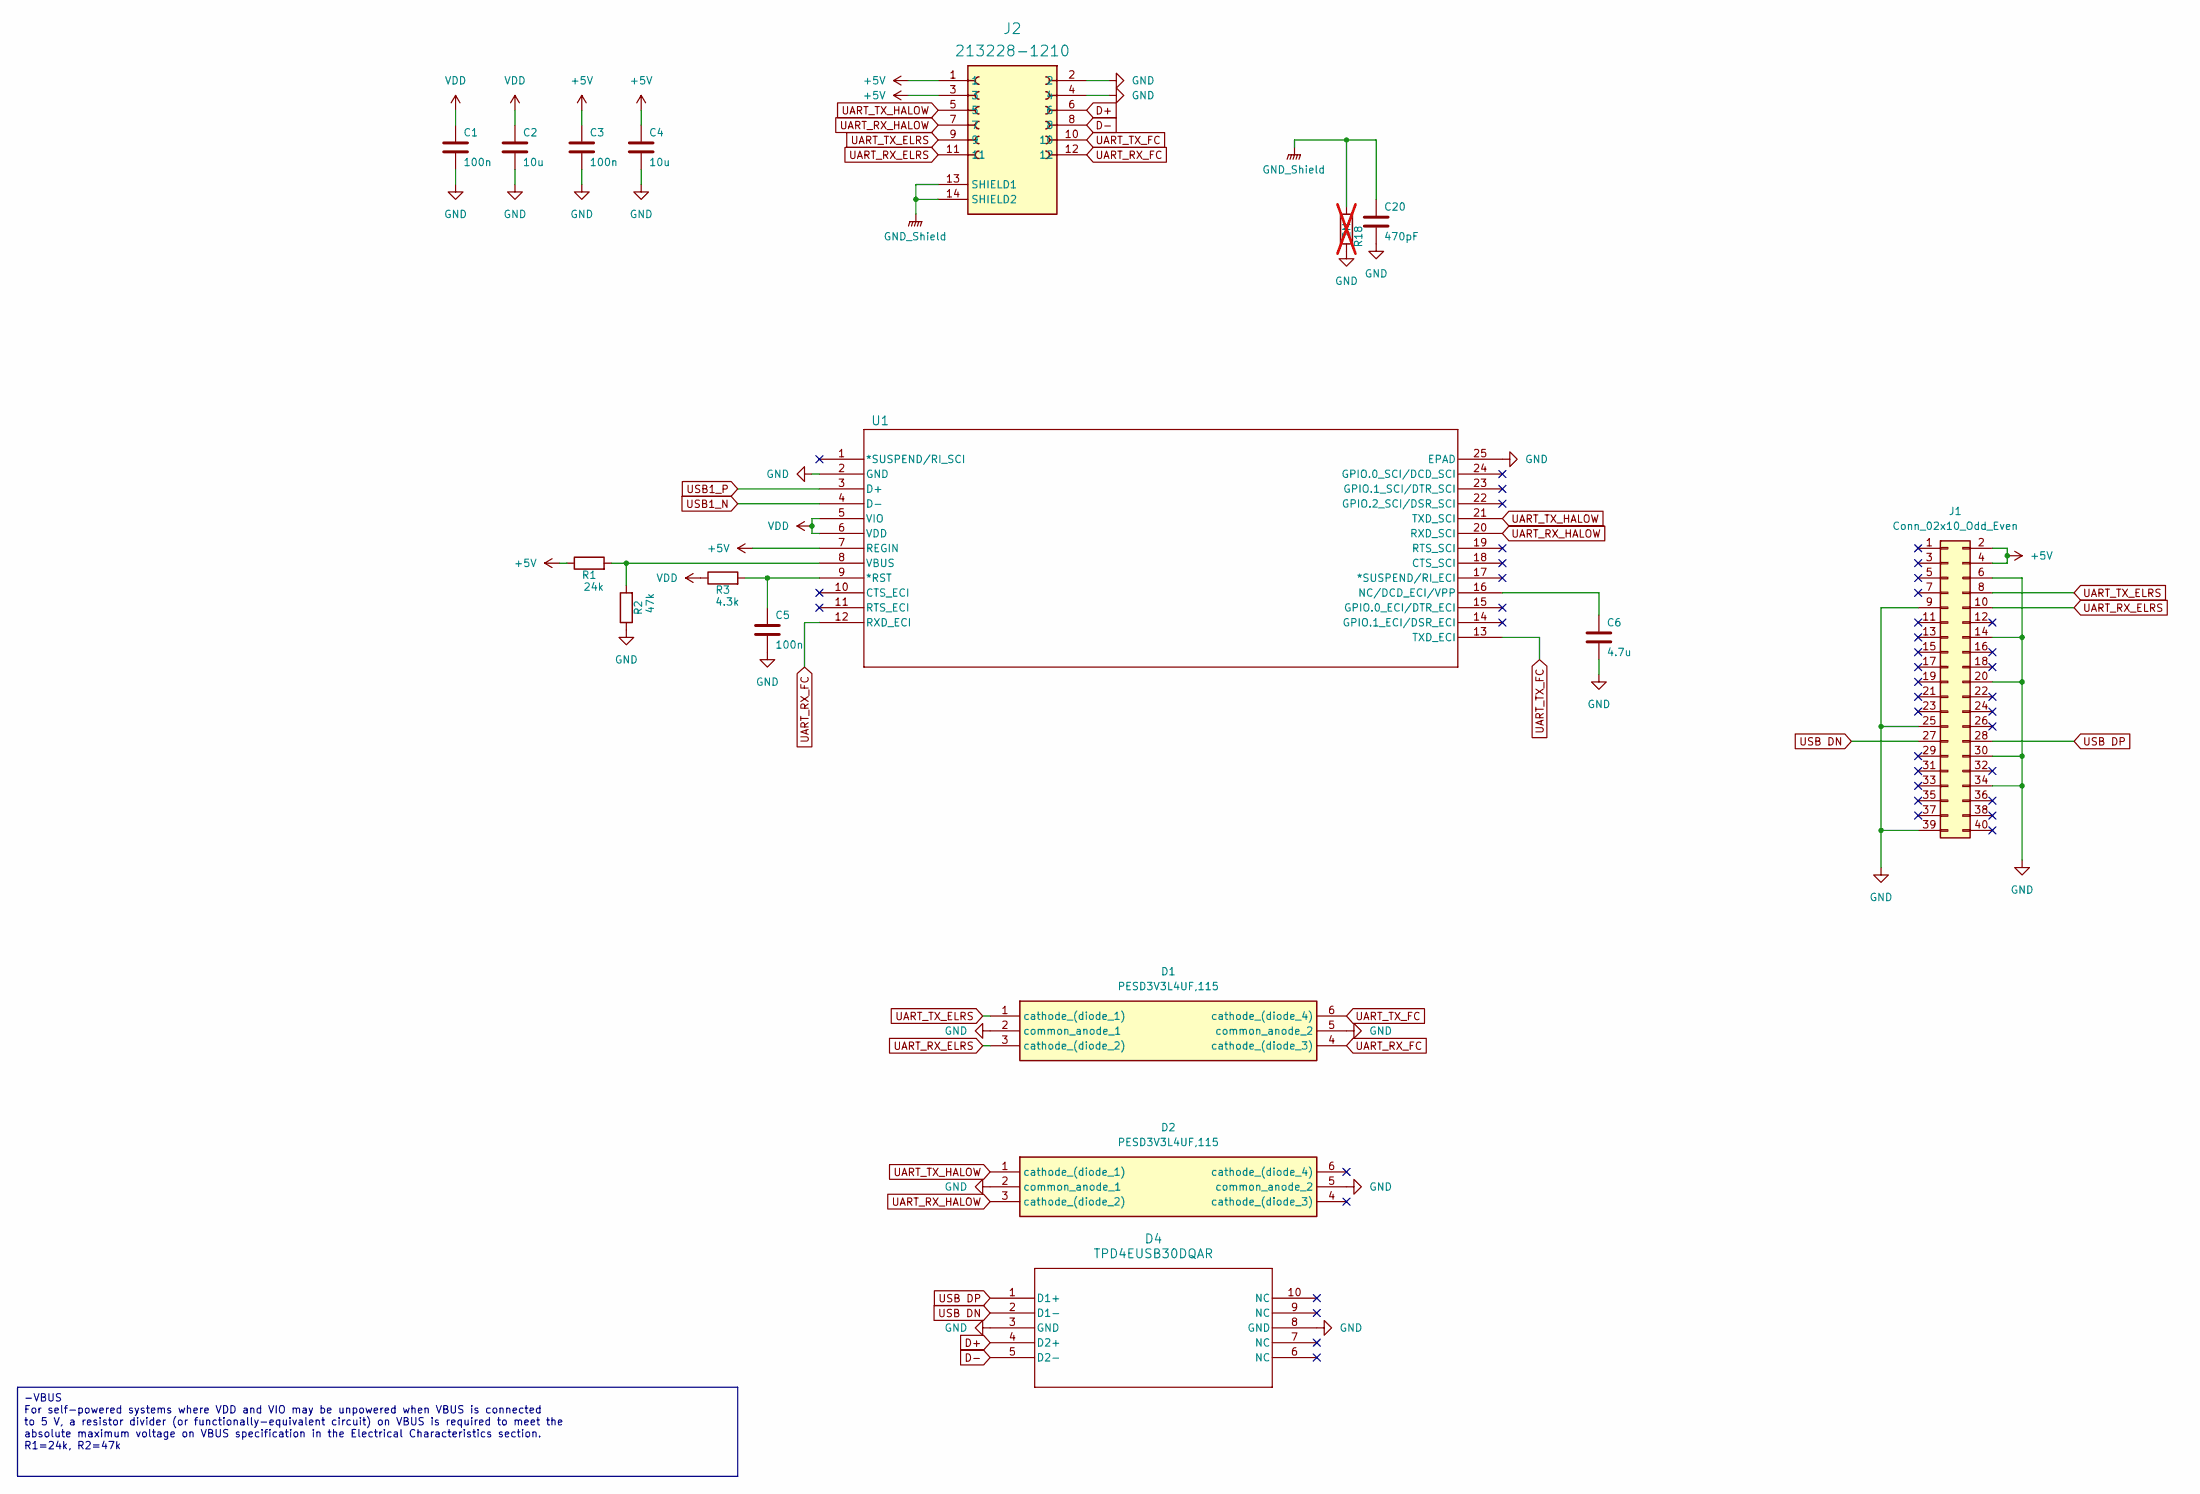
[picture p111: schematic UART_HUB.kicad_sch]

Parts:
C1, C3, C5: 100n; C_0201_0603Metric; Part CL10B104KB8NNWC
C2, C4: 10u; C_0805_2012Metric; Part CL21A106KOQNNNE
C6: 4.7u; C_01005_0402Metric; Part CL05A475MO5NUNC
C20: 470pF; C_1206_3216Metric; Part FCC1206B471K102DT
D1, D2: PESD3V3L4UF,115; PESD3V3L5UF115; Manufacturer_Part_Number PESD3V3L4UF,115; Mouser Part Number 771-PESD3V3L4UFT/R
D4: TPD4EUSB30DQAR; DQA10
J1: Conn_02x10_Odd_Even; Samtec_HLE-120-02-xx-DV-TE_2x20_P2.54mm_Horizontal
J2: 213228-1210; CON_2132281210_MOL
R1: 24k; R_0201_0603Metric; Part RC-01W2402FT
R2: 47k; R_0201_0603Metric; Part 0201WMF4702TEE
R3: 4.3k; R_0201_0603Metric; Part RNCP0603FTD1K00
R18: 2M; C_1206_3216Metric; PART NUMBER 1206W4F2004T5E; not fitted
U1: CP2105-F01-GM; QFN24_4X4_SIL-L

Connections:
+5V: C3.1, C4.1, J1.2, J1.4, J2.1, J2.3, R1.1, U1.7 (REGIN); also elsewhere on the board
D+: D4.4 (D2+), J2.6; also elsewhere on the board
D-: D4.5 (D2-), J2.8; also elsewhere on the board
GND: C1.2, C2.2, C3.2, C4.2, C5.2, C6.2, C20.2, D1.2 (common_anode_1), D1.5 (common_anode_2), D2.2 (common_anode_1), D2.5 (common_anode_2), D4.3 (GND), D4.8 (GND), J1.6, J1.9, J1.14, J1.20, J1.25, J1.30, J1.34, J1.39, J2.2, J2.4, R2.1, R18.2, U1.2 (GND), U1.25 (EPAD); also elsewhere on the board
GND_Shield: C20.1, J2.13 (SHIELD1), J2.14 (SHIELD2), R18.1
unnamed: C5.1, R3.2, U1.9 (*RST)
unnamed: C6.1, U1.16 (NC/DCD_ECI/VPP)
unnamed: R1.2, R2.2, U1.8 (VBUS)
UART_RX_ELRS: D1.3 (cathode_(diode_2)), J1.10, J2.11
UART_RX_FC: D1.4 (cathode_(diode_3)), J2.12, U1.12 (RXD_ECI)
UART_RX_HALOW: D2.3 (cathode_(diode_2)), J2.7, U1.20 (RXD_SCI)
UART_TX_ELRS: D1.1 (cathode_(diode_1)), J1.8, J2.9
UART_TX_FC: D1.6 (cathode_(diode_4)), J2.10, U1.13 (TXD_ECI)
UART_TX_HALOW: D2.1 (cathode_(diode_1)), J2.5, U1.21 (TXD_SCI)
USB1_N: U1.4 (D-); also elsewhere on the board
USB1_P: U1.3 (D+); also elsewhere on the board
USB DN: D4.2 (D1-), J1.27; also elsewhere on the board
USB DP: D4.1 (D1+), J1.28; also elsewhere on the board
VDD: C1.1, C2.1, R3.1, U1.5 (VIO), U1.6 (VDD)

Notes on the sheet:
-VBUS For self-powered systems where VDD and VIO may be unpowered when VBUS is connected to 5 V, a resistor divider (or functionally-equivalent circuit) on VBUS is required to meet the absolute maximum voltage on VBUS specification in the Electrical Characteristics section. R1=24k, R2=47k

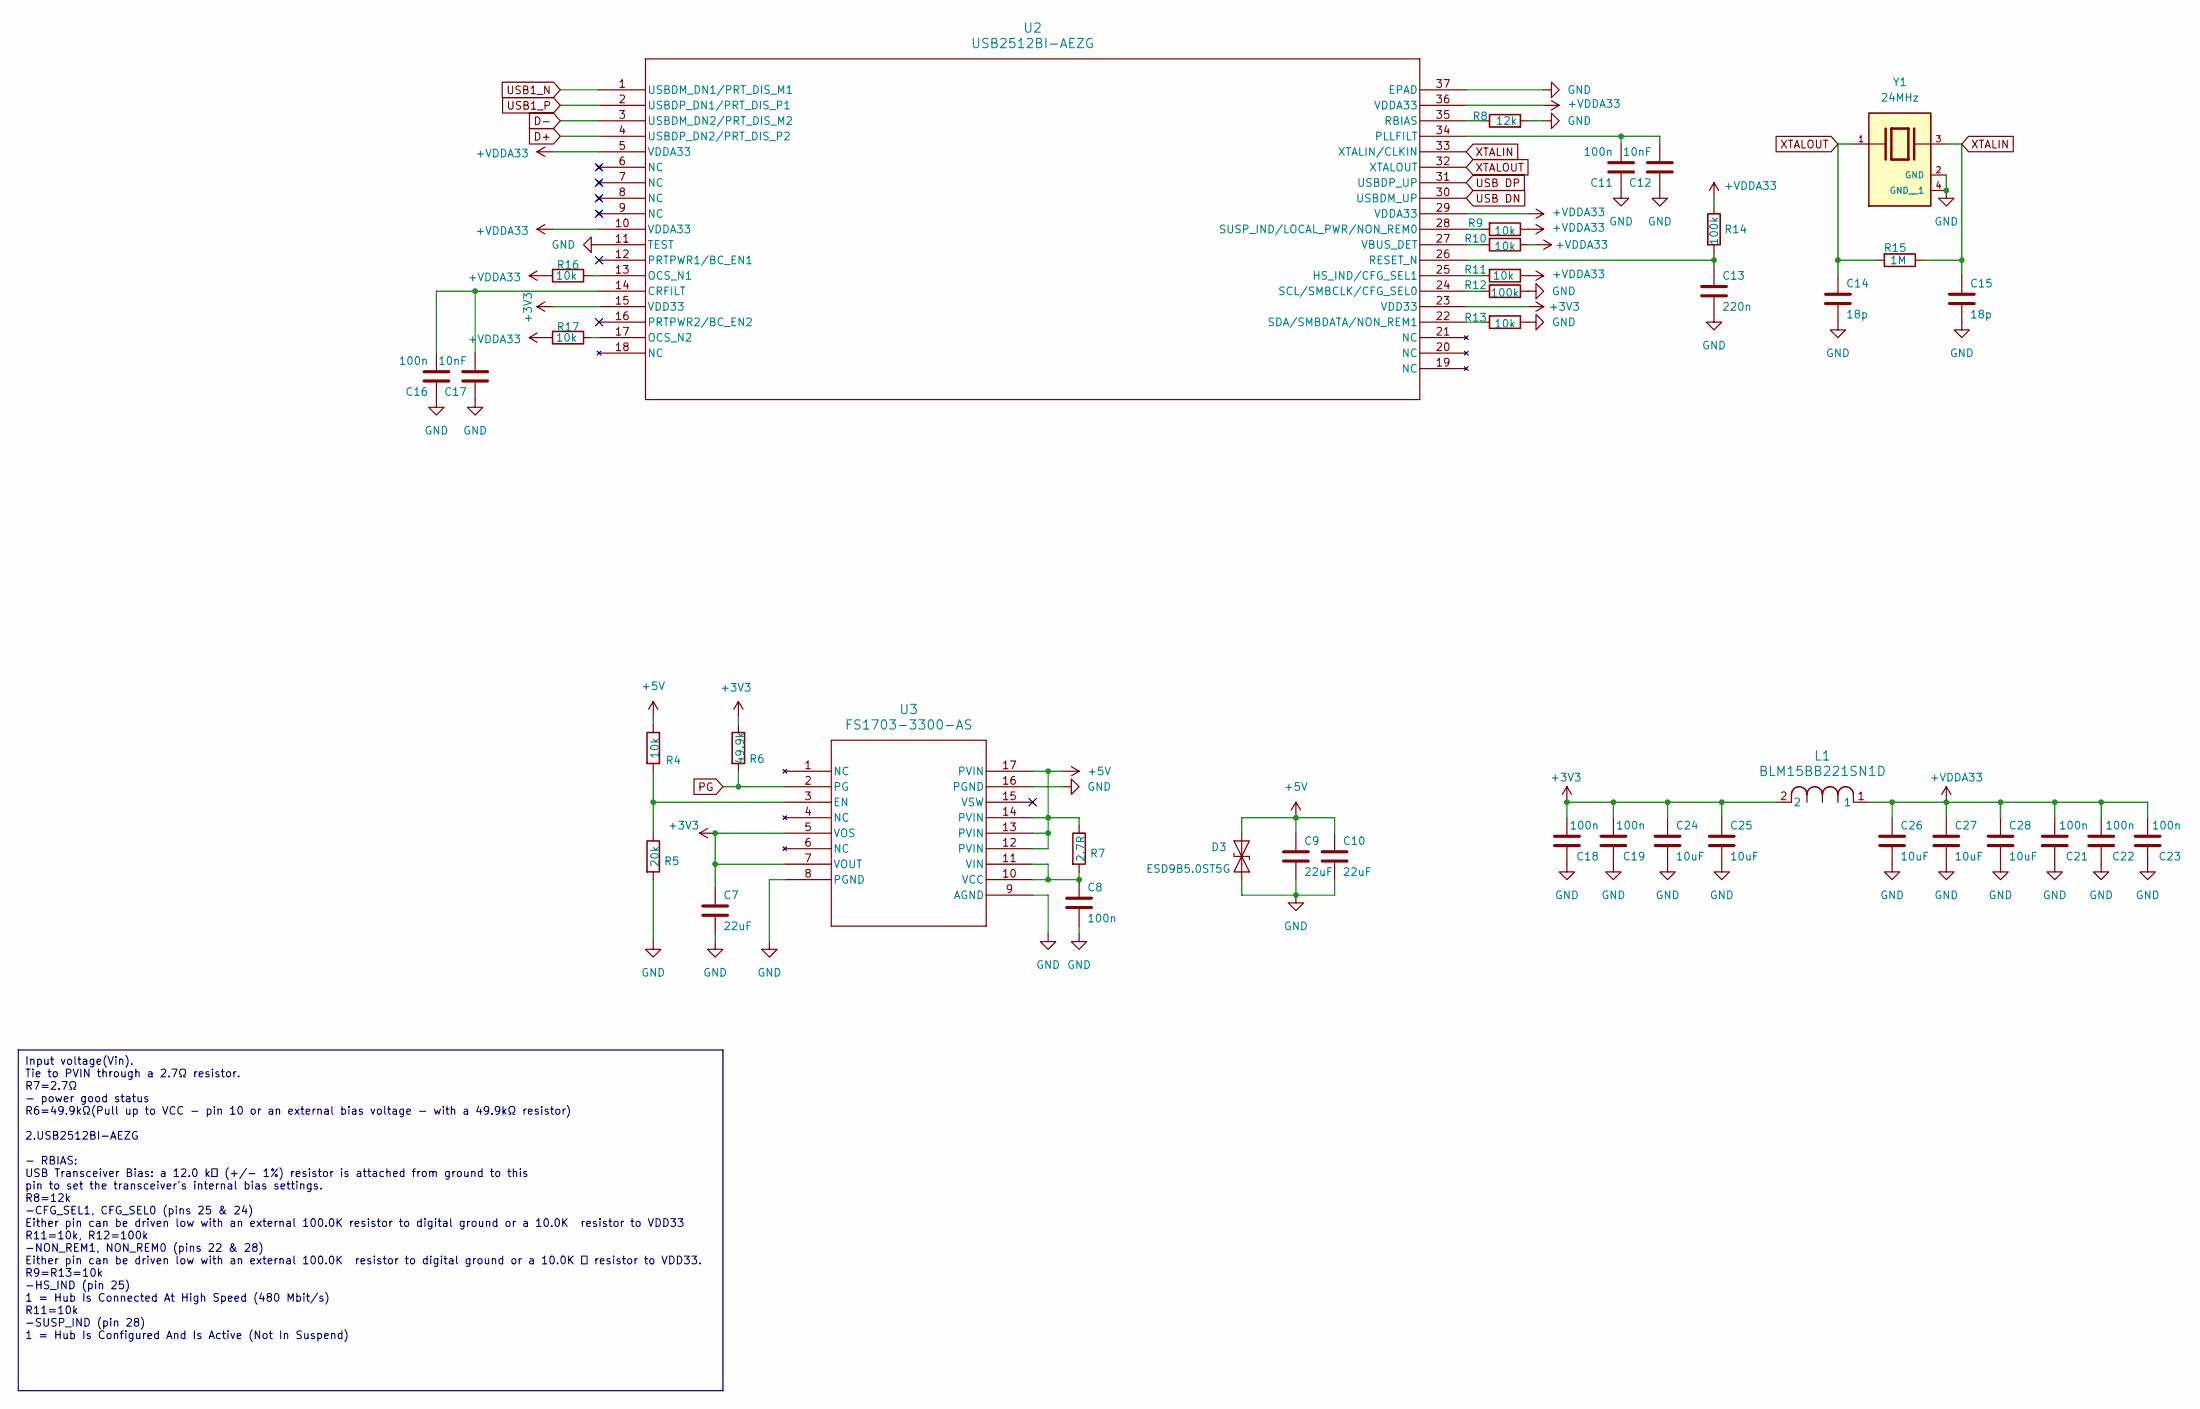
[picture p112: schematic USB_Hub.kicad_sch]

Parts:
C7, C9, C10: 22uF; C_0402_1005Metric; Part GRM155R61A225KE95D
C8, C11, C16: 100n; C_0201_0603Metric; Part CL10B104KB8NNWC
C12, C17: 10nF; C_0201_0603Metric; Part GRM033R71A103KA01D
C13: 220n; C_0201_0603Metric; Part GRM033C80J224ME90D
C14, C15: 18p; C_0201_0603Metric; Part GRM0335C1E180JA01J
C18, C19, C21, C22, C23: 100n; C_0201_0603Metric; Part C0201X5R104K160NT
C24, C25, C26, C27, C28: 10uF; C_0402_1005Metric; Part CL05A106MP5NUNC
D3: ESD9B5.0ST5G; D_SOD-923
L1: BLM15BB221SN1D; IND_BLM15_0402_MUR
R4, R9, R10, R11, R13, R16, R17: 10k; R_0201_0603Metric; Part RC0201JR-0710KL
R5: 20k; R_0201_0603Metric; Part 0201WMF2002TEE
R6: 49.9k; R_0201_0603Metric; Part RC0201FR-0749K9L
R7: 2.7R; R_0201_0603Metric; Part RTT012R70FTH
R8: 12k; R_0201_0603Metric; Part 0201WMF1202TEE
R12, R14: 100k; R_0201_0603Metric; Part RTT011003FTH
R15: 1M; R_0201_0603Metric; Part RC0201FR-071ML
U2: USB2512BI-AEZG; QFN36_6X6MC_MCH
U3: FS1703-3300-AS; P11F1_TDK
Y1: 24MHz; XTAL_TSX-3225_40.0000MF20X-K0; part num L327S240P11L

Connections:
+3V3: C7.1, C18.2, C19.2, C24.1, C25.1, L1.2, R6.1, U2.15 (VDD33), U2.23 (VDD33), U3.5 (VOS), U3.7 (VOUT)
+5V: C9.1, C10.1, D3.2 (A2), R4.1, R7.1, U3.12 (PVIN), U3.13 (PVIN), U3.14 (PVIN), U3.17 (PVIN); also elsewhere on the board
+VDDA33: C21.2, C22.2, C23.2, C26.1, C27.1, C28.1, L1.1, R9.1, R10.1, R11.1, R14.1, R16.2, R17.2, U2.5 (VDDA33), U2.10 (VDDA33), U2.29 (VDDA33), U2.36 (VDDA33)
D+: U2.4 (USBDP_DN2/PRT_DIS_P2); also elsewhere on the board
D-: U2.3 (USBDM_DN2/PRT_DIS_M2); also elsewhere on the board
GND: C7.2, C8.2, C9.2, C10.2, C11.1, C12.1, C13.2, C14.2, C15.2, C16.1, C17.1, C18.1, C19.1, C21.1, C22.1, C23.1, C24.2, C25.2, C26.2, C27.2, C28.2, D3.1 (A1), R5.2, R8.2, R12.1, R13.1, U2.11 (TEST), U2.37 (EPAD), U3.8 (PGND), U3.9 (AGND), U3.16 (PGND), Y1.2 (GND), Y1.4 (GND__1); also elsewhere on the board
unnamed: C16.2, C17.2, U2.14 (CRFILT)
unnamed: R11.2, U2.25 (HS_IND/CFG_SEL1)
unnamed: R16.1, U2.13 (OCS_N1)
unnamed: R17.1, U2.17 (OCS_N2)
unnamed: C11.2, C12.2, U2.34 (PLLFILT)
unnamed: R8.1, U2.35 (RBIAS)
unnamed: C13.1, R14.2, U2.26 (RESET_N)
unnamed: R12.2, U2.24 (SCL/SMBCLK/CFG_SEL0)
unnamed: R13.2, U2.22 (SDA/SMBDATA/NON_REM1)
unnamed: R9.2, U2.28 (SUSP_IND/LOCAL_PWR/NON_REM0)
unnamed: R10.2, U2.27 (VBUS_DET)
unnamed: R4.2, R5.1, U3.3 (EN)
unnamed: C8.1, R7.2, U3.10 (VCC), U3.11 (VIN)
PG: R6.2, U3.2 (PG)
USB1_N: U2.1 (USBDM_DN1/PRT_DIS_M1); also elsewhere on the board
USB1_P: U2.2 (USBDP_DN1/PRT_DIS_P1); also elsewhere on the board
USB DN: U2.30 (USBDM_UP); also elsewhere on the board
USB DP: U2.31 (USBDP_UP); also elsewhere on the board
XTALIN: C15.1, R15.1, U2.33 (XTALIN/CLKIN), Y1.3
XTALOUT: C14.1, R15.2, U2.32 (XTALOUT), Y1.1

Notes on the sheet:
Input voltage(Vin). Tie to PVIN through a 2.7Ω resistor. R7=2.7Ω - power good status R6=49.9kΩ(Pull up to VCC - pin 10 or an external bias voltage - with a 49.9kΩ resistor) 2.USB2512BI-AEZG - RBIAS: USB Transceiver Bias: a 12.0 k (+/- 1%) resistor is attached from ground to this pin to set the tra…

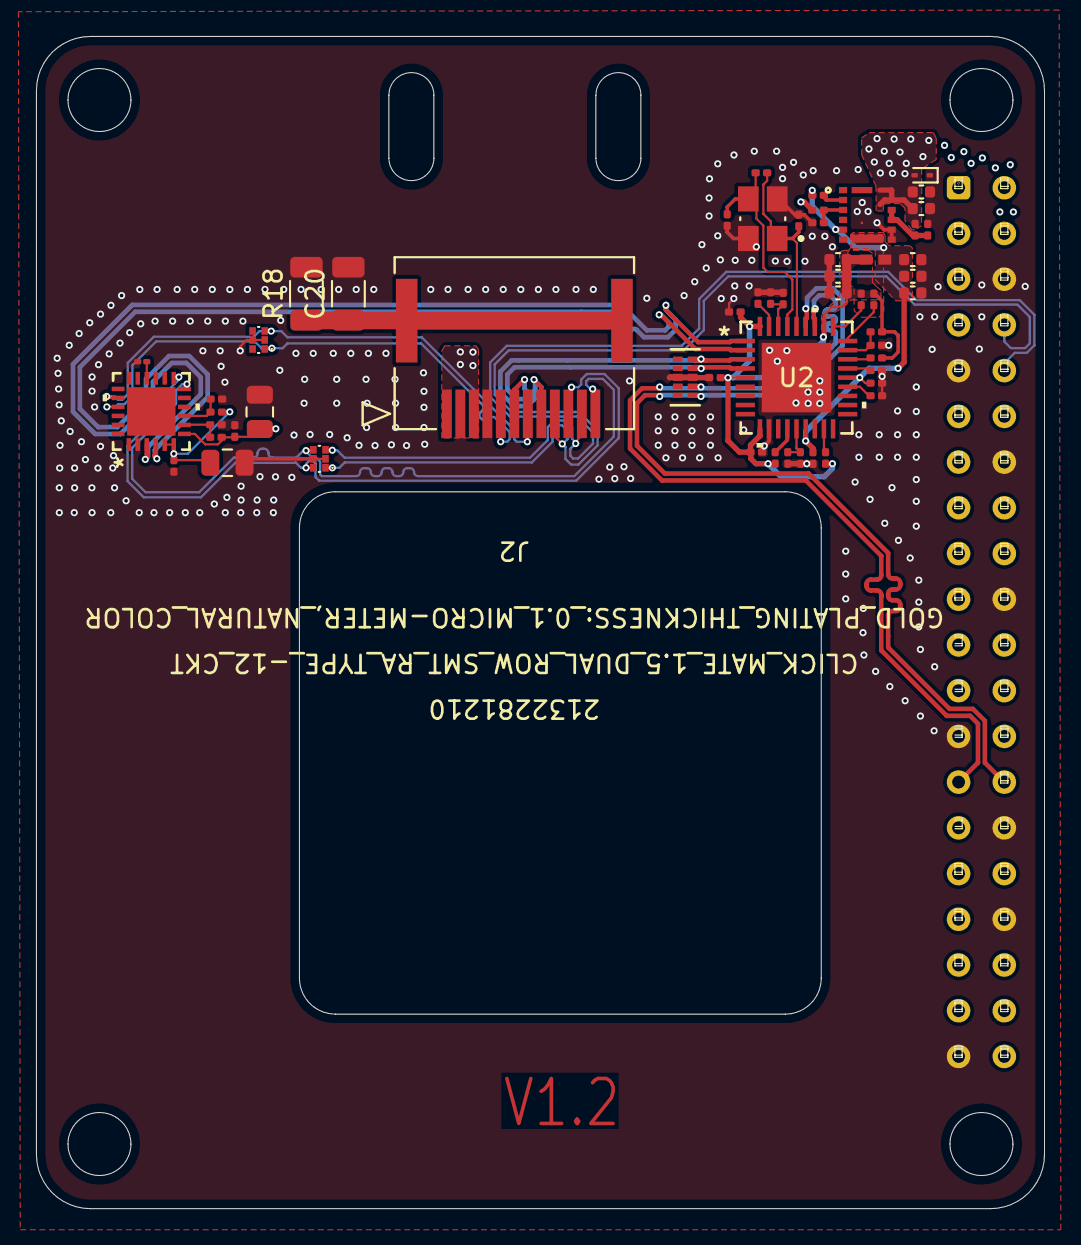
[picture p113: board Radxa Shield Rev. 1.2.kicad_pcb from above]

Board: 4 copper layers, 56.0 x 65.1 mm, 57 parts (1 on the bottom side), 37 nets.
