Pro-engineer616/pcb_projects_Alex/Sensor-Node v1.1/Sensor_node_1.0/Radxa-shield/source/RADXA5.0/RADXA5.0.kicad_pcb

## KiCad design Sensor-Node v1.1/Sensor_node_1.0/Radxa-shield/source/RADXA5.0/RADXA5.0.kicad_pcb (2024-08-19, an earlier design)

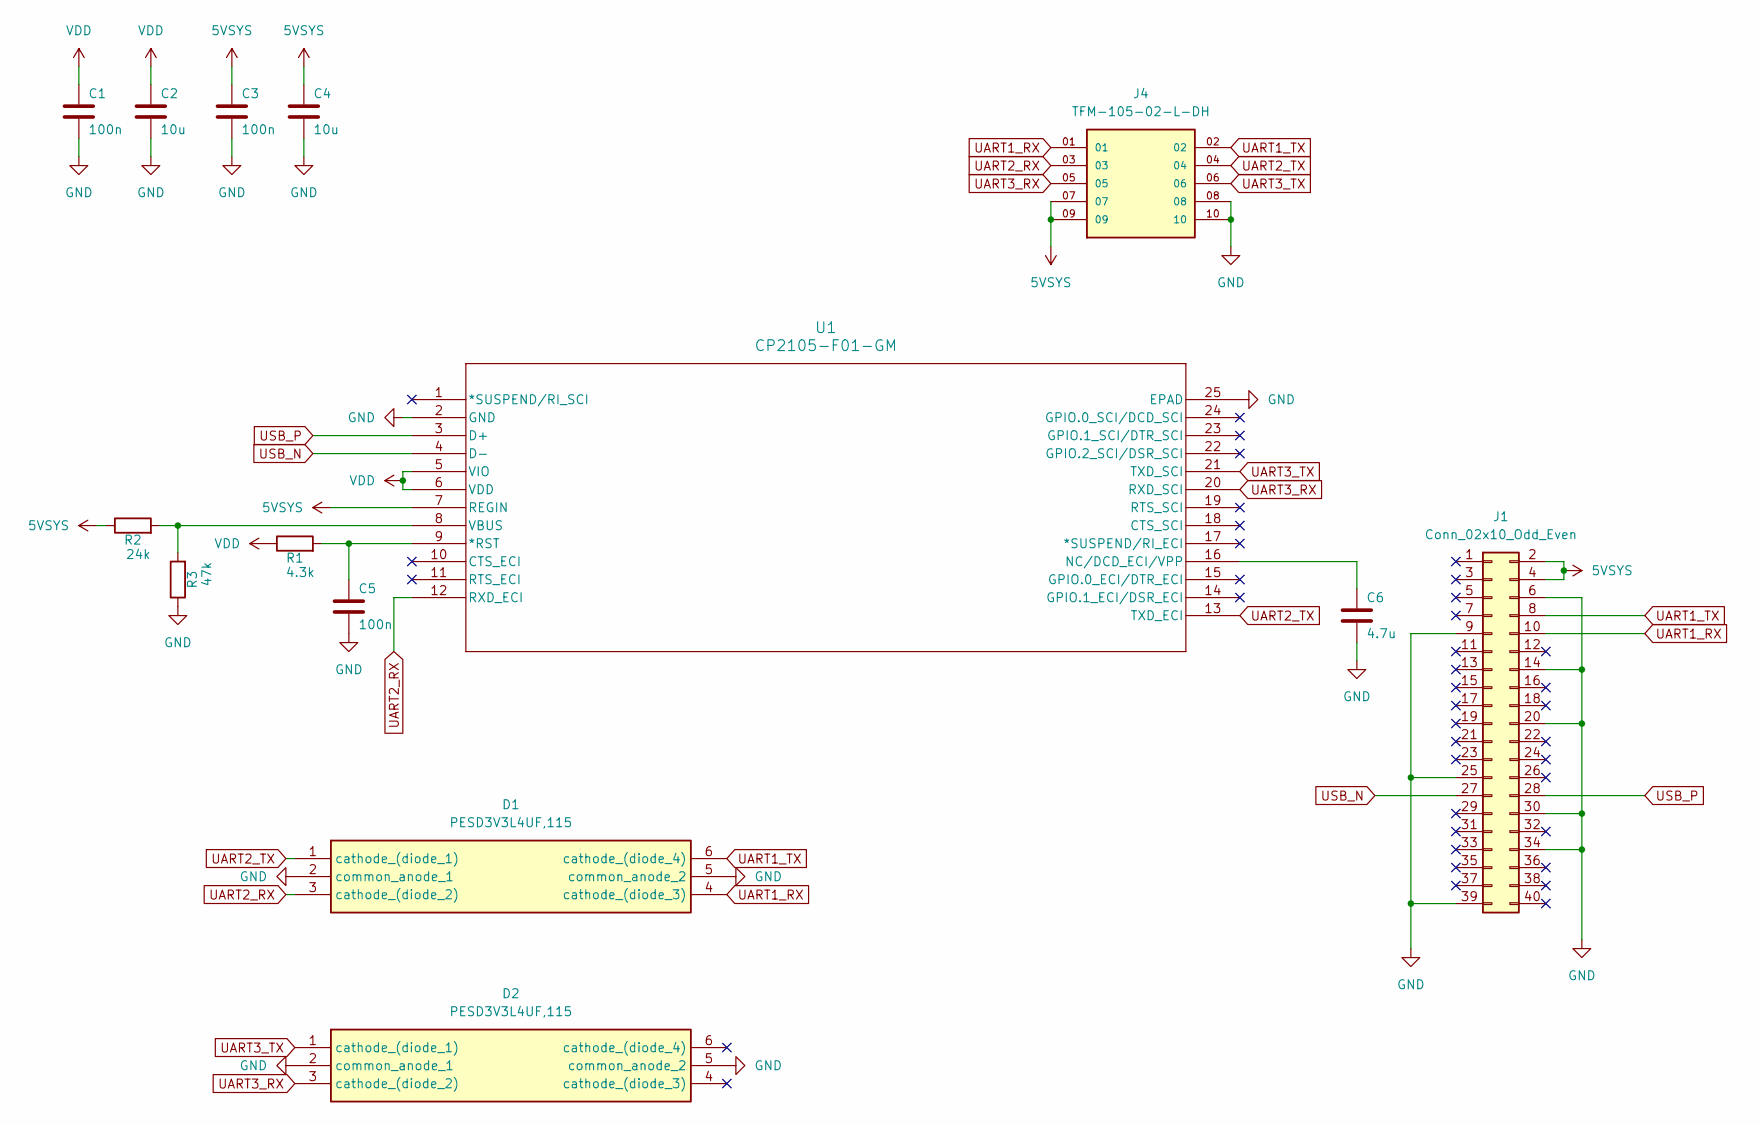
[picture p114: schematic RADXA5.0.kicad_sch]

Parts:
C1, C3, C5: 100n; C_0201_0603Metric; Part CL10B104KB8NNWC
C2, C4: 10u; C_0805_2012Metric; Part CL21A106KOQNNNE
C6: 4.7u; C_01005_0402Metric; Part CL21A106KOQNNNE
D1, D2: PESD3V3L4UF,115; PESD3V3L5UF115; Manufacturer_Part_Number PESD3V3L4UF,115; Mouser Part Number 771-PESD3V3L4UFT/R
J1: Conn_02x10_Odd_Even; Samtec_HLE-120-02-xx-DV-TE_2x20_P2.54mm_Horizontal
J4: TFM-105-02-L-DH; SAMTEC_TFM-105-02-L-DH; PARTREV F
R1: 4.3k; R_0201_0603Metric; Part RNCP0603FTD1K00
R2: 24k; R_0201_0603Metric; Part RNCP0603FTD1K00
R3: 47k; R_0201_0603Metric; Part RNCP0603FTD1K00
U1: CP2105-F01-GM; QFN24_4X4_SIL-L

Connections:
5VSYS: C3.1, C4.1, J1.2, J1.4, J4.07, J4.09, R2.1, U1.7 (REGIN)
GND: C1.2, C2.2, C3.2, C4.2, C5.2, C6.2, D1.2 (common_anode_1), D1.5 (common_anode_2), D2.2 (common_anode_1), D2.5 (common_anode_2), J1.6, J1.9, J1.14, J1.20, J1.25, J1.30, J1.34, J1.39, J4.08, J4.10, R3.1, U1.2 (GND), U1.25 (EPAD)
unnamed: C5.1, R1.2, U1.9 (*RST)
unnamed: C6.1, U1.16 (NC/DCD_ECI/VPP)
unnamed: R2.2, R3.2, U1.8 (VBUS)
UART1_RX: D1.4 (cathode_(diode_3)), J1.10, J4.01
UART1_TX: D1.6 (cathode_(diode_4)), J1.8, J4.02
UART2_RX: D1.3 (cathode_(diode_2)), J4.03, U1.12 (RXD_ECI)
UART2_TX: D1.1 (cathode_(diode_1)), J4.04, U1.13 (TXD_ECI)
UART3_RX: D2.3 (cathode_(diode_2)), J4.05, U1.20 (RXD_SCI)
UART3_TX: D2.1 (cathode_(diode_1)), J4.06, U1.21 (TXD_SCI)
USB_N: J1.27, U1.4 (D-)
USB_P: J1.28, U1.3 (D+)
VDD: C1.1, C2.1, R1.1, U1.5 (VIO), U1.6 (VDD)

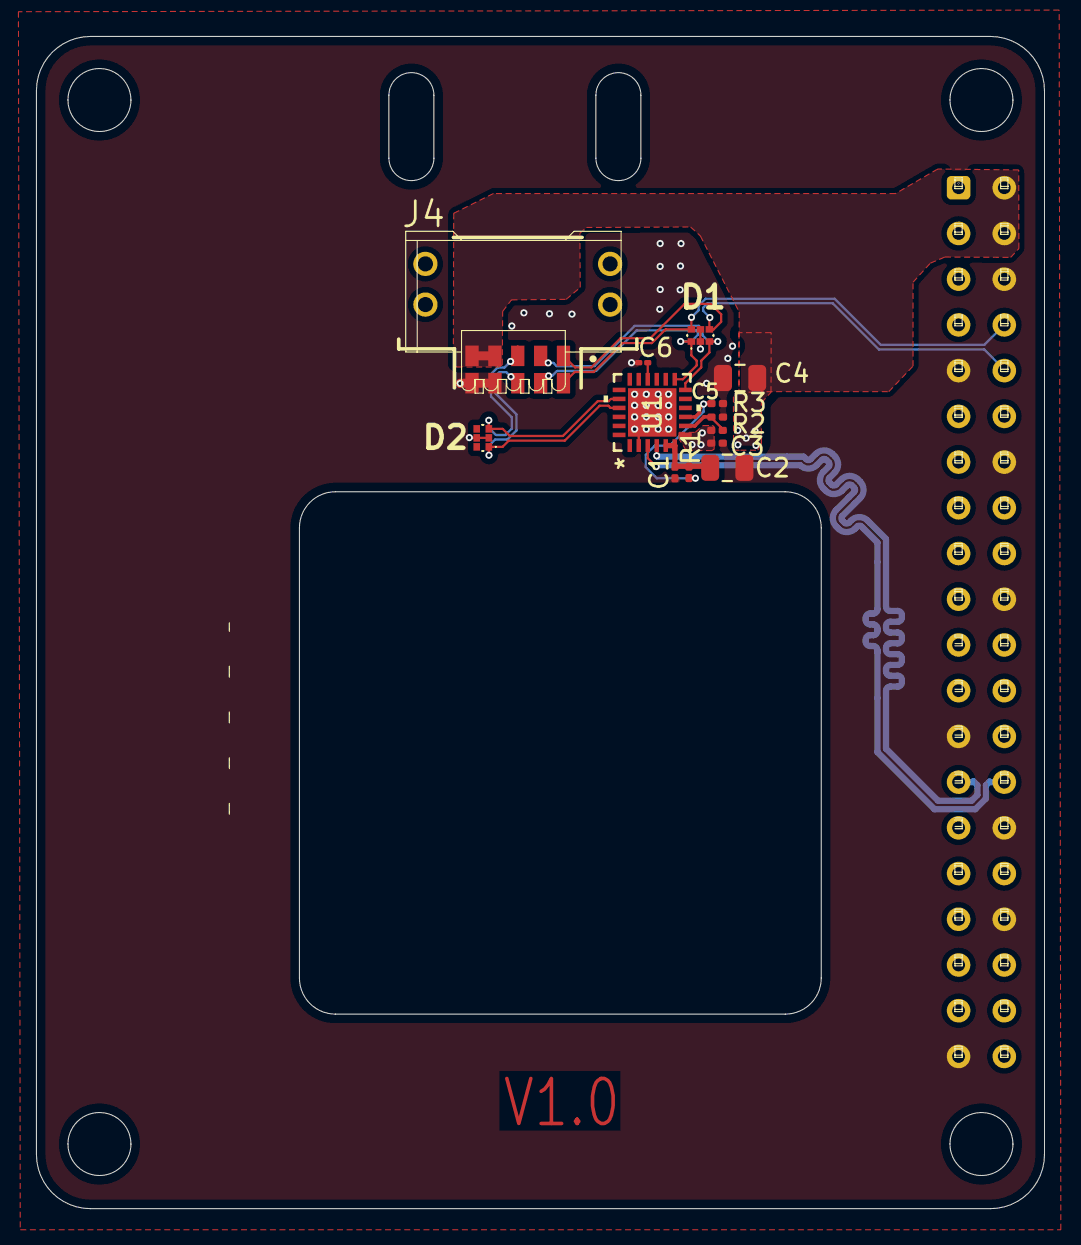
[picture p115: board RADXA5.0.kicad_pcb from above]

Board: 2 copper layers, 56.0 x 65.1 mm, 14 parts (1 on the bottom side), 14 nets.
