Pro-engineer616/pcb_projects_Alex/Sensor-Node v1.2/sensornodeV1.2/SensornodeV1.2.kicad_pcb

## KiCad design Sensor-Node v1.2/sensornodeV1.2/SensornodeV1.2.kicad_pcb (2024-09-19)

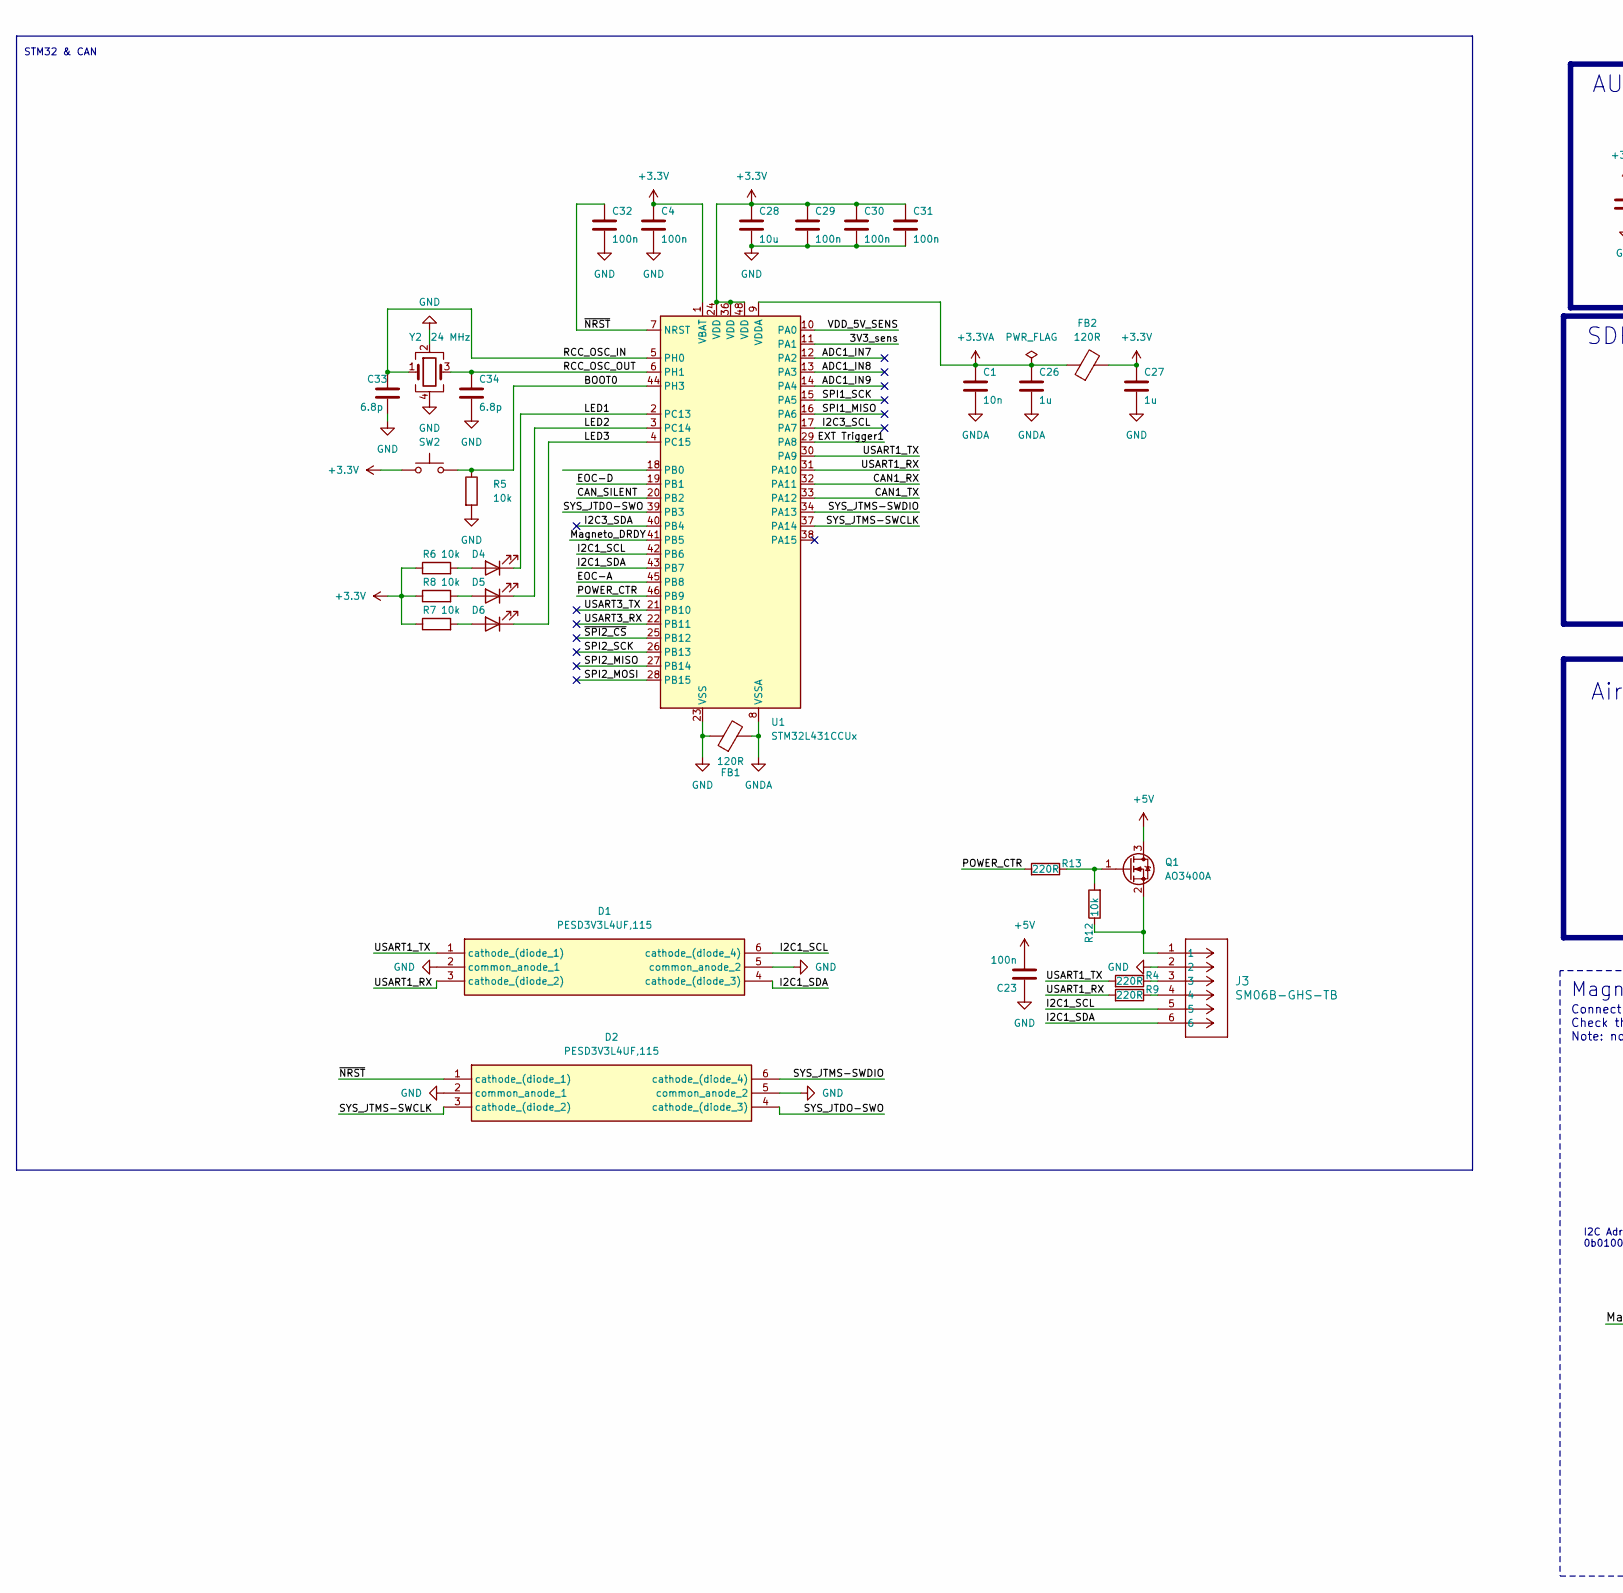
[picture p116: schematic SensornodeV1.2.kicad_sch, Sensornode, part in row 1, column 1]

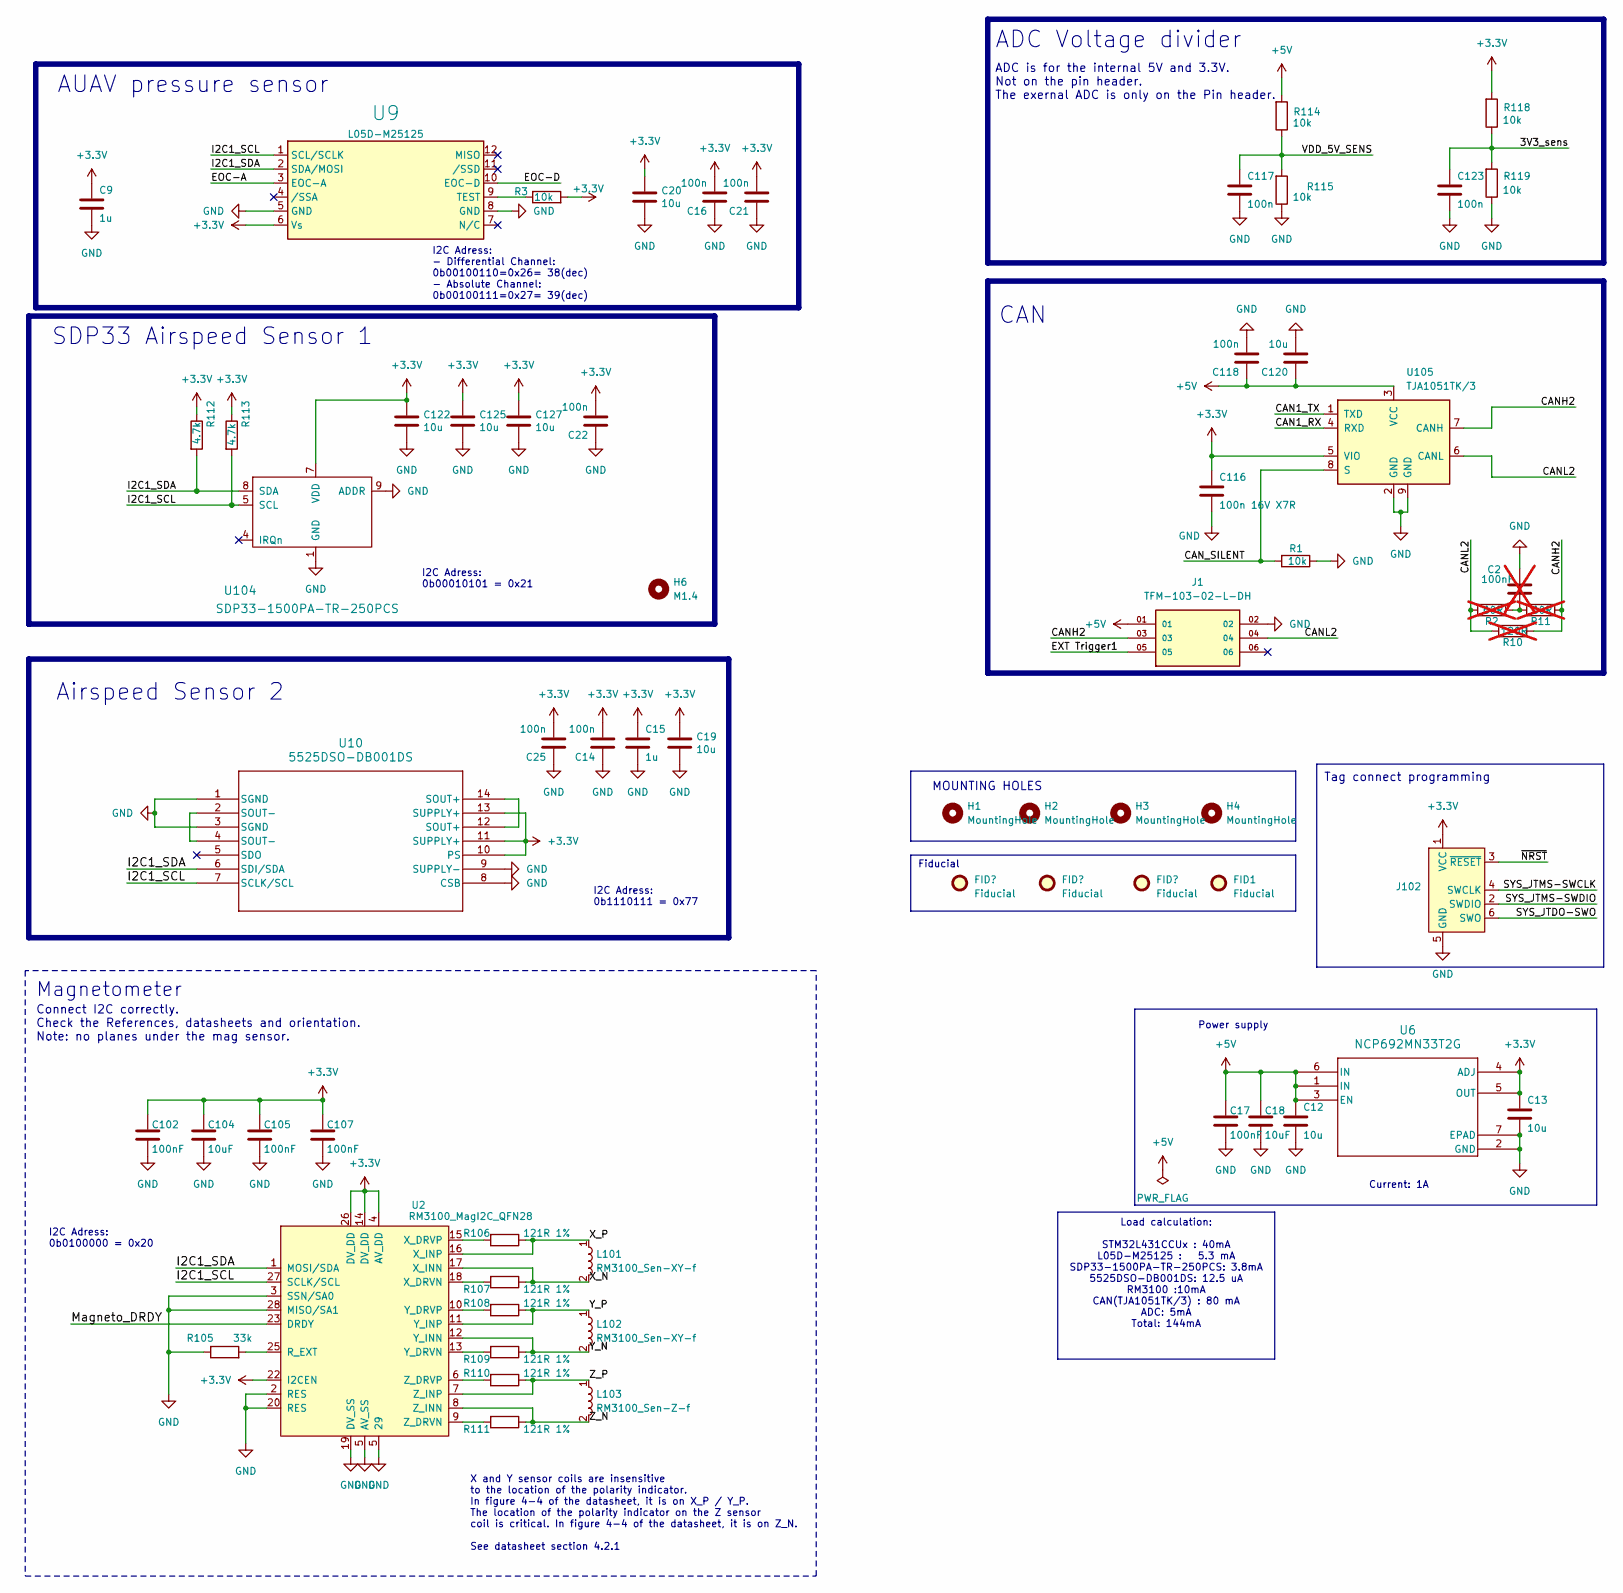
[picture p117: schematic SensornodeV1.2.kicad_sch, Sensornode, part in row 1, column 2]

Parts:
C1: 10n; C_0201_0603Metric; Part GRM033R71A103KA01D
C2: 100nF; R_0201_0603Metric; Part CL05B104KB54PNC; not fitted
C4, C29, C30, C31, C32: 100n; C_0201_0603Metric; Part CL10B104KB8NNWC
C9, C15, C26, C27: 1u; C_0201_0603Metric; Part CL10B105KA8NNNC
C12: 10u; C_1206_3216Metric; Part 1206B106K100NT
C13: 10u; C_0805_2012Metric; Part CL21A106KPFNNNE
C14, C16, C21, C22, C23, C25, C118: 100n; C_0201_0603Metric
C17, C102, C105, C107: 100nF; C_0201_0603Metric; MPN EMF105B7104KVHF
C18, C104: 10uF; C_0402_1005Metric; MPN EMK212BB7106MG-T
C19, C20, C120, C122, C125, C127: 10u; C_0402_1005Metric
C28: 10u; C_0402_1005Metric; Part CL05A106MP5NUNC
C33, C34: 6.8p; C_0201_0603Metric; Part C0201C0G6R8D500NTA
C116: 100n 16V X7R; C_0201_0603Metric; Part GRM033Z71C104KE14D
C117, C123: 100n; C_0201_0603Metric; Part CL21A106KOQNNNE
D1, D2: PESD3V3L4UF,115; PESD3V3L5UF115; Manufacturer_Part_Number PESD3V3L4UF,115; Mouser Part Number 771-PESD3V3L4UFT/R
D4: red; LED_0201_0603Metric; Part XL-0201SURC
D5: green; LED_0201_0603Metric; Part XL-0201UGC
D6: blue; LED_0201_0603Metric; Part XL-0201UBC
FB1, FB2: 120R; C_0201_0603Metric; Part BLM03AG121SN1D
FID1, FID101, FID102, FID103: Fiducial; Fiducial_0.5mm_Mask1.5mm
H1, H2, H3, H4: MountingHole; MountingHole_2.1mm
H6: M1.4; Mounting_Wuerth_WA-SMSI-M1.6_H1.5mm_9774015633
J1: TFM-103-02-L-DH; SAMTEC_TFM-103-02-L-DH; PARTREV F
J3: SM06B-GHS-TB; CONN_SM06B-GHS-TB_JST
J102: Conn_ARM_SWD_TagConnect_TC2030-NL; Tag-Connect_TC2030-IDC-NL_2x03_P1.27mm_Vertical
L101, L102: RM3100_Sen-XY-f; MPN RM3100
L103: RM3100_Sen-Z-f; MPN RM3100
Q1: AO3400A; SOT-23
R1, R114, R115, R118, R119: 10k; R_0201_0603Metric; MPN WR02X1002FAL
R2, R11: 60R; R_0402_1005Metric; PART NUMBER CS02W8J060LTCE; not fitted
R3, R12: 10k; R_0201_0603Metric
R4, R9, R13: 220R; R_0201_0603Metric; MPN RC0201FR-07220RL
R5, R6, R7, R8: 10k; R_0201_0603Metric; Part WR02X1002FAL
R10: 120R; R_0201_0603Metric; PART NUMBER 0402WGF1200TCE; not fitted
R105: 33k; R_0201_0603Metric
R106, R107, R108, R109, R110, R111: 121R 1%; R_0201_0603Metric; MPN RC-01W1210FT
R112, R113: 4.7k; R_0201_0603Metric
SW2: TS-1088R-02026; TS1088R02026
U1: STM32L431CCUx; QFN-48-1EP_7x7mm_P0.5mm_EP5.6x5.6mm
U2: RM3100_MagI2C_QFN28; RM3100_MagI2C_MLF_4x4mm_P0.4; MPN RM3100
U6: NCP692MN33T2G; DFN6_3X3_ONS-L
U9: L05D-M25125; DS-0432
U10: 5525DSO-DB001DS; SO14_MS5525DSO_TEC
U104: SDP33-1500PA-TR-250PCS; SDP3x
U105: TJA1051TK/3; DFN-8-1EP_3x3mm_P0.65mm_EP1.55x2.4mm
Y2: 24 MHz; Crystal_SMD_2016-4Pin_2.0x1.6mm; Part XC21M4-24.000-F06NKDTL

Connections:
+3.3V: C4.1, C9.1, C13.1, C14.2, C15.1, C16.2, C19.1, C20.1, C21.2, C22.2, C25.2, C27.1, C28.1, C29.1, C30.1, C31.1, C102.1, C104.1, C105.1, C107.1, C116.1, C122.1, C125.1, C127.1, FB2.2, J102.1 (VCC), R3.2, R6.1, R7.1, R8.1, R112.1, R113.1, R118.2, SW2.1, U1.1 (VBAT), U1.24 (VDD), U1.36 (VDD), U1.48 (VDD), U2.4 (AV_DD), U2.14 (DV_DD), U2.22 (I2CEN), U2.26 (DV_DD), U6.4 (ADJ), U6.5 (OUT), U9.6 (Vs), U10.10 (PS), U10.11 (SUPPLY+), U10.13 (SUPPLY+), U104.7 (VDD), U105.5 (VIO)
+3.3VA: C1.1, C26.1, FB2.1, U1.9 (VDDA)
+5V: C12.1, C17.1, C18.1, C23.2, C118.1, C120.1, J1.01, Q1.3 (D), R114.2, U6.1 (IN), U6.3 (EN), U6.6 (IN), U105.3 (VCC)
/3V3_sens: C123.1, R118.1, R119.2, U1.11 (PA1)
/ EXT Trigger1: J1.05, U1.29 (PA8)
/ADC1_IN7: U1.12 (PA2)
/ADC1_IN8: U1.13 (PA3)
/ADC1_IN9: U1.14 (PA4)
/BOOT0: R5.1, SW2.2, U1.44 (PH3)
/CAN1_RX: U1.32 (PA11), U105.4 (RXD)
/CAN1_TX: U1.33 (PA12), U105.1 (TXD)
/CANH2: J1.03, R10.1, R11.1, U105.7 (CANH)
/CANL2: J1.04, R2.2, R10.2, U105.6 (CANL)
/CAN_SILENT: R1.2, U1.20 (PB2), U105.8 (S)
/EOC-A: U1.45 (PB8), U9.3 (EOC-A)
/EOC-D: U1.19 (PB1), U9.10 (EOC-D)
/I2C1_SCL: D1.6 (cathode_(diode_4)), J3.5, R113.2, U1.42 (PB6), U2.27 (SCLK/SCL), U9.1 (SCL/SCLK), U10.7 (SCLK/SCL), U104.5 (SCL)
/I2C1_SDA: D1.4 (cathode_(diode_3)), J3.6, R112.2, U1.43 (PB7), U2.1 (MOSI/SDA), U9.2 (SDA/MOSI), U10.6 (SDI/SDA), U104.8 (SDA)
/I2C3_SCL: U1.17 (PA7)
/I2C3_SDA: U1.40 (PB4)
/LED1: D4.1 (K), U1.2 (PC13)
/LED2: D5.1 (K), U1.3 (PC14)
/LED3: D6.1 (K), U1.4 (PC15)
/Magneto_DRDY: U1.41 (PB5), U2.23 (DRDY)
/POWER_CTR: R13.2, U1.46 (PB9)
/RCC_OSC_IN: C33.2, U1.5 (PH0), Y2.1
/RCC_OSC_OUT: C34.2, U1.6 (PH1), Y2.3
/SPI1_MISO: U1.16 (PA6)
/SPI1_SCK: U1.15 (PA5)
/SPI2_MISO: U1.27 (PB14)
/SPI2_MOSI: U1.28 (PB15)
/SPI2_SCK: U1.26 (PB13)
/SYS_JTDO-SWO: D2.4 (cathode_(diode_3)), J102.6 (SWO), U1.39 (PB3)
/SYS_JTMS-SWCLK: D2.3 (cathode_(diode_2)), J102.4 (SWCLK), U1.37 (PA14)
/SYS_JTMS-SWDIO: D2.6 (cathode_(diode_4)), J102.2 (SWDIO), U1.34 (PA13)
/USART1_RX: D1.3 (cathode_(diode_2)), R9.2, U1.31 (PA10)
/USART1_TX: D1.1 (cathode_(diode_1)), R4.2, U1.30 (PA9)
/USART3_RX: U1.22 (PB11)
/USART3_TX: U1.21 (PB10)
/VDD_5V_SENS: C117.1, R114.1, R115.2, U1.10 (PA0)
/X_N: L101.2, R107.1, U2.17 (X_INN)
/X_P: L101.1, R106.1, U2.16 (X_INP)
/Y_N: L102.2, R109.1, U2.12 (Y_INN)
/Y_P: L102.1, R108.1, U2.11 (Y_INP)
/Z_N: L103.2, R111.1, U2.8 (Z_INN)
/Z_P: L103.1, R110.1, U2.7 (Z_INP)
/~NRST: C32.1, D2.1 (cathode_(diode_1)), J102.3 (~RESET), U1.7 (NRST)
/~SPI2_CS: U1.25 (PB12)
GND: C2.2, C4.2, C9.2, C12.2, C13.2, C14.1, C15.2, C16.1, C17.2, C18.2, C19.2, C20.2, C21.1, C22.1, C23.1, C25.1, C27.2, C28.2, C29.2, C30.2, C31.2, C32.2, C33.1, C34.1, C102.2, C104.2, C105.2, C107.2, C116.2, C117.2, C118.2, C120.2, C122.2, C123.2, C125.2, C127.2, D1.2 (common_anode_1), D1.5 (common_anode_2), D2.2 (common_anode_1), D2.5 (common_anode_2), FB1.1, J1.02, J3.2, J102.5 (GND), R1.1, R5.2, R105.1, R115.1, R119.1, U1.23 (VSS), U1.35 (VSS), U1.47 (VSS), U1.49 (VSS), U2.2 (RES), U2.3 (SSN/SA0), U2.5 (29), U2.19 (DV_SS), U2.20 (RES), U2.28 (MISO/SA1), U2.29, U6.2 (GND), U6.7 (EPAD), U9.5 (GND), U9.8 (GND), U10.1 (SGND), U10.3 (SGND), U10.8 (CSB), U10.9 (SUPPLY-), U104.1 (GND), U104.2 (GND), U104.3 (GND), U104.6 (GND), U104.9 (ADDR), U104.10 (GND), U104.11 (GND), U104.17 (GND), U104.18 (GND), U105.2 (GND), U105.9 (GND), Y2.2, Y2.4
GNDA: C1.2, C26.2, FB1.2, U1.8 (VSSA)
unnamed: C2.1, R2.1, R11.2
unnamed: D4.2 (A), R6.2
unnamed: D5.2 (A), R7.2
unnamed: D6.2 (A), R8.2
unnamed: J3.3, R4.1
unnamed: J3.4, R9.1
unnamed: Q1.1 (G), R12.2, R13.1
unnamed: J3.1, Q1.2 (S), R12.1
unnamed: R105.2, U2.25 (R_EXT)
unnamed: R107.2, U2.18 (X_DRVN)
unnamed: R106.2, U2.15 (X_DRVP)
unnamed: R109.2, U2.13 (Y_DRVN)
unnamed: R108.2, U2.10 (Y_DRVP)
unnamed: R111.2, U2.9 (Z_DRVN)
unnamed: R110.2, U2.6 (Z_DRVP)
unnamed: R3.1, U9.9 (TEST)
unnamed: U10.12 (SOUT+), U10.14 (SOUT+)
unnamed: U10.2 (SOUT-), U10.4 (SOUT-)

Notes on the sheet:
Load calculation: STM32L431CCUx : 40mA L05D-M25125 : 5.3 mA SDP33-1500PA-TR-250PCS: 3.8mA 5525DSO-DB001DS: 12.5 uA RM3100 :10mA CAN(TJA1051TK/3) : 80 mA ADC: 5mA Total: 144mA
STM32 & CAN
I2C Adress: 0b0100000 = 0x20
SDP33 Airspeed Sensor 1
Power supply
Fiducial
Connect I2C correctly. Check the References, datasheets and orientation. Note: no planes under the mag sensor.
ADC Voltage divider
MOUNTING HOLES
I2C Adress: 0b00010101 = 0x21
ADC is for the internal 5V and 3.3V. Not on the pin header. The exernal ADC is only on the Pin header.
CAN
I2C Adress: - Differential Channel: 0b00100110=0x26= 38(dec) - Absolute Channel: 0b00100111=0x27= 39(dec)
I2C Adress: 0b1110111 = 0x77
Magnetometer
X and Y sensor coils are insensitive to the location of the polarity indicator. In figure 4-4 of the datasheet, it is on X_P / Y_P. The location of the polarity indicator on the Z sensor coil is critical. In figure 4-4 of the datasheet, it is on Z_N. See datasheet section 4.2.1
Airspeed Sensor 2
AUAV pressure sensor
Tag connect programming
Current: 1A

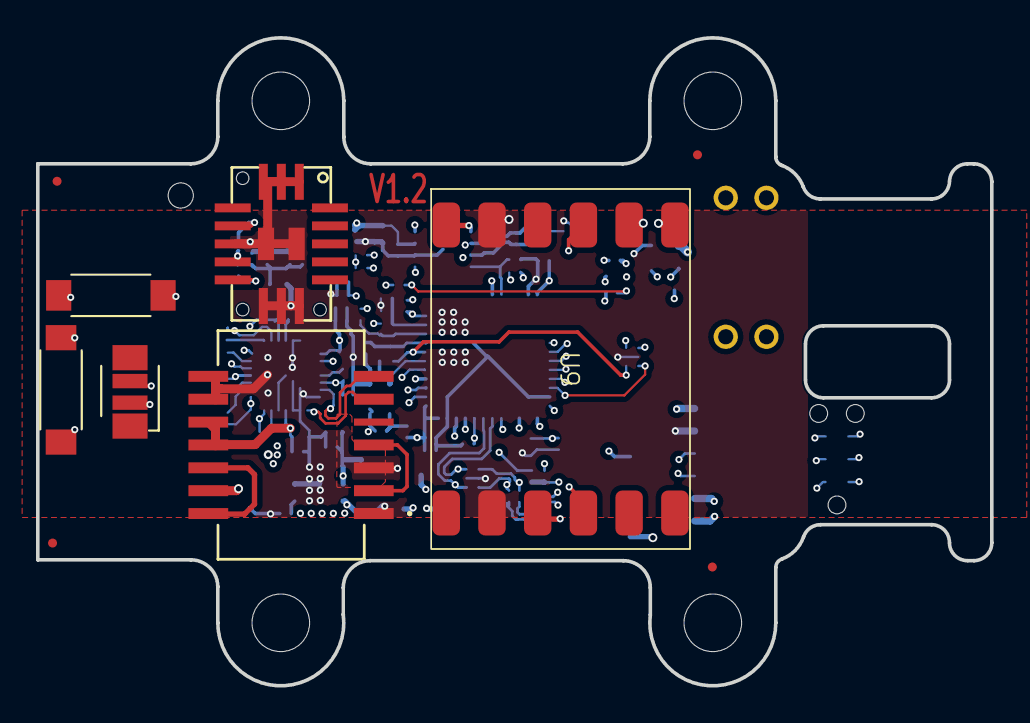
[picture p118: board SensornodeV1.2.kicad_pcb from above]

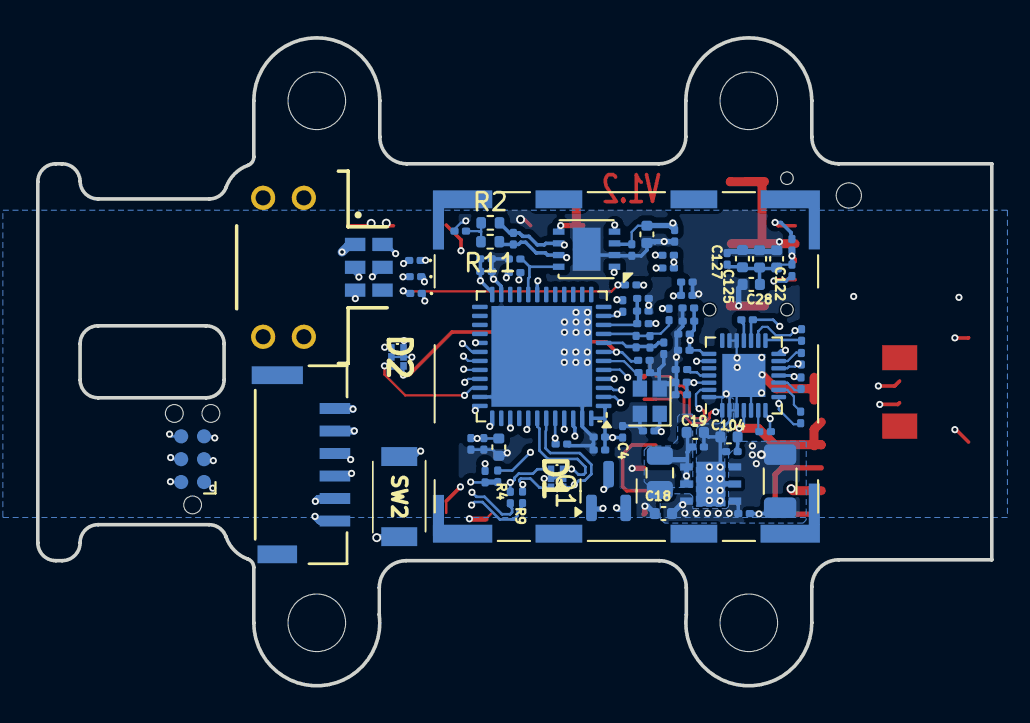
[picture p119: board SensornodeV1.2.kicad_pcb from below]

Board: 6 copper layers, 53.0 x 36.0 mm, 97 parts (86 on the bottom side), 55 nets.

Other parts of the board:
J2: Conn_01x01_Shielded; Wuerth_36103205_20x20mm
