Pro-engineer616/pcb_projects_Alex/PDB v1.4/source/PDB1.4/PDB1.4.kicad_pcb

## KiCad design PDB v1.4/source/PDB1.4/PDB1.4.kicad_pcb (2024-09-19)

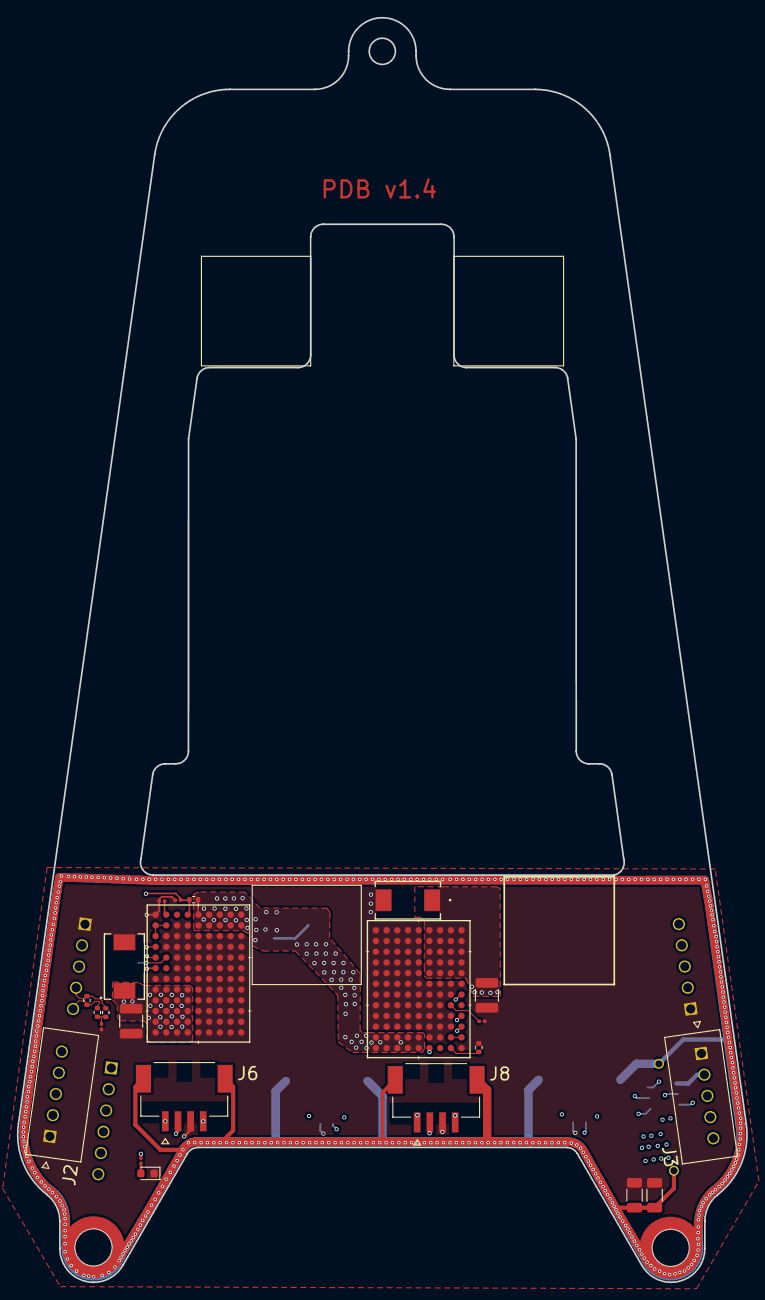
[picture p120: board PDB1.4.kicad_pcb from above]

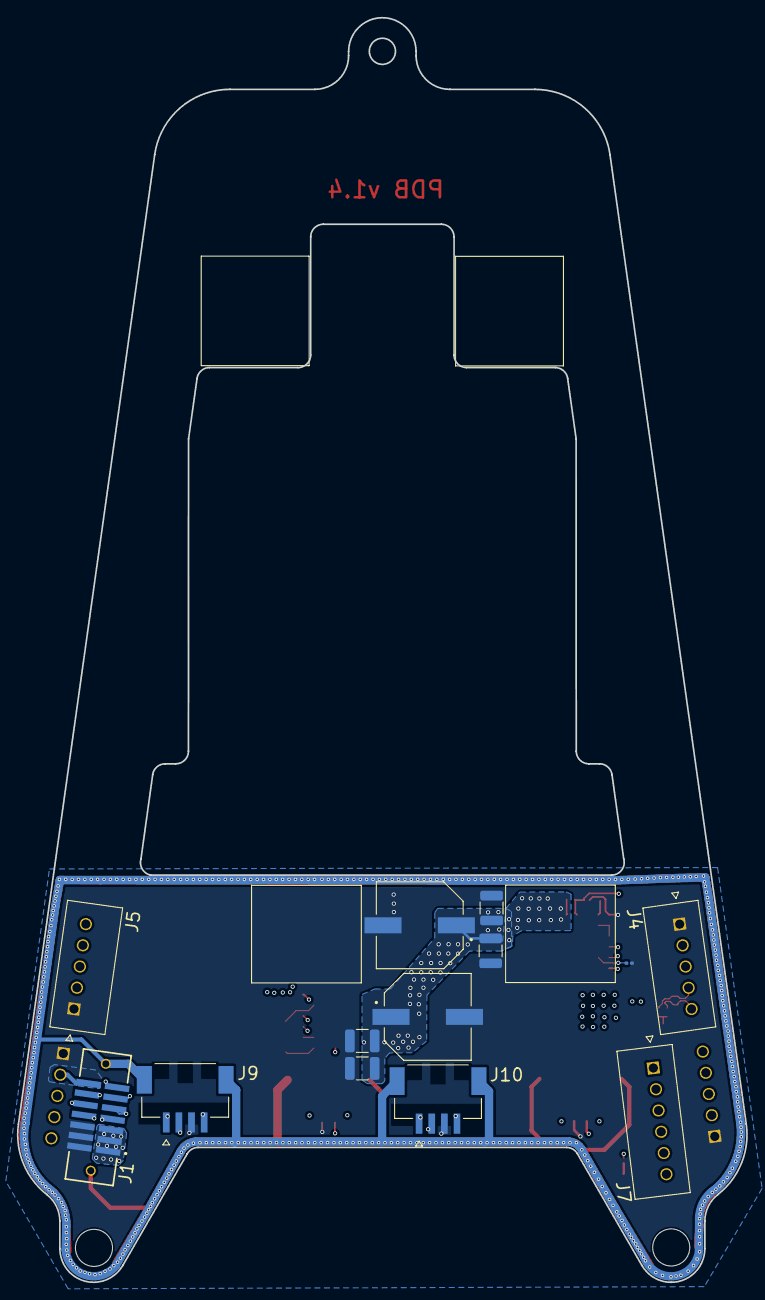
[picture p121: board PDB1.4.kicad_pcb from below]

Board: 6 copper layers, 86.5 x 150.0 mm, 38 parts (13 on the bottom side), 23 nets.

Parts:
C1, C6: 15uf; CAP_100SXV15MX
C2, C3, C7, C8: 10u; C_1210_3225Metric
C4, C9: 150uF; CAP_TRM-E-2917_AVX-L
C5, C10: 100uF; C_1210_3225Metric
C12: 470pF; C_1206_3216Metric
C17: 100nF; C_0201_0603Metric
D1: NCD0603C1; LED_0603_1608Metric
J1: TFM-107-02-L-D-WT; SAMTEC_TFM-107-02-L-D-WT
J2, J3, J4, J5: 1719710105; MOLEX_1719710105
J6, J8, J9, J10: 2132250430; MOLEX_2132250430
J7: 1719710106; MOLEX_1719710106
MP1, MP2: WA-SMSI_9774XXX360; WA-SMSI_9774120360
R1, R2, R5: 124k; R_0201_0603Metric
R3: 374k; R_0402_1005Metric
R4: 2.87k; R_0201_0603Metric
R6, R10: 60R; R_0402_1005Metric
R7: 2.8k; R_0402_1005Metric
R8: 100k; R_0201_0603Metric
R9: 120R; R_0402_1005Metric
R17: 2M; C_1206_3216Metric
U1, U2: LTM8064IY#PBF; BGA108_16X11P9_ADI

Connections:
+8V: C4.1, C5.2, C9.1, C10.2, J1.14, J2.2, J3.2, J4.2, J5.2, J7.5, R8.2, U1.H1 (VOUT), U1.H2 (VOUT), U1.H3 (VOUT), U1.H4 (VOUT), U1.J1 (VOUT), U1.J2 (VOUT), U1.J3 (VOUT), U1.J4 (VOUT), U1.K1 (VOUT), U1.K2 (VOUT), U1.K3 (VOUT), U1.K4 (VOUT), U1.L1 (VOUT), U1.L2 (VOUT), U1.L3 (VOUT), U1.L4 (VOUT), U1.M1 (VOUT), U1.M2 (VOUT), U1.M3 (VOUT), U1.M4 (VOUT), U2.H1 (VOUT), U2.H2 (VOUT), U2.H3 (VOUT), U2.H4 (VOUT), U2.J1 (VOUT), U2.J2 (VOUT), U2.J3 (VOUT), U2.J4 (VOUT), U2.K1 (VOUT), U2.K2 (VOUT), U2.K3 (VOUT), U2.K4 (VOUT), U2.L1 (VOUT), U2.L2 (VOUT), U2.L3 (VOUT), U2.L4 (VOUT), U2.M1 (VOUT), U2.M2 (VOUT), U2.M3 (VOUT), U2.M4 (VOUT)
/power/IOUTMON: U1.E1 (IOUTMON), U2.C1 (CTRL1)
/power/PWR_RUN: R2.2, R3.1, U1.A4 (RUN), U2.A4 (RUN)
/power/PWR_SS: U1.D1 (SS), U2.D1 (SS)
/power/SYNC: U1.F1 (SYNC), U2.F1 (SYNC)
CAN H1: J1.07, J2.5, J3.5, J4.5, J5.5, J6.4, J7.3, J8.4, J9.4, J10.4, R9.1, R10.1
CAN L1: J1.08, J2.4, J3.4, J4.4, J5.4, J6.1, J7.4, J8.1, J9.1, J10.1, R6.2, R9.2
Detach: J1.09, J7.2
GND: C1.2, C2.2, C3.2, C4.2, C5.1, C6.2, C7.2, C8.2, C9.2, C10.1, C12.2, C17.2, D1.1 (K), J1.02, J1.04, J1.06, J2.1, J3.1, J4.1, J5.1, J6.3, J8.3, J9.3, J10.3, R1.1, R2.1, R4.2, R5.1, R7.2, R17.2, U1.A1 (GND), U1.B3 (GND), U1.B4 (GND), U1.C2 (GND), U1.C3 (GND), U1.C4 (GND), U1.C5 (GND), U1.C6 (GND), U1.C7 (GND), U1.C8 (GND), U1.C9 (GND), U1.D2 (GND), U1.D3 (GND), U1.D4 (GND), U1.D5 (GND), U1.D6 (GND), U1.D7 (GND), U1.D8 (GND), U1.D9 (GND), U1.E3 (GND), U1.E4 (GND), U1.E5 (GND), U1.E6 (GND), U1.E7 (GND), U1.E8 (GND), U1.E9 (GND), U1.F3 (GND), U1.F4 (GND), U1.F5 (GND), U1.F6 (GND), U1.F7 (GND), U1.F8 (GND), U1.F9 (GND), U1.G1 (GND), U1.G2 (GND), U1.G3 (GND), U1.G4 (GND), U1.G5 (GND), U1.G6 (GND), U1.G7 (GND), U1.G8 (GND), U1.G9 (GND), U1.H5 (GND), U1.H6 (GND), U1.H7 (GND), U1.H8 (GND), U1.H9 (GND), U1.J5 (GND), U1.J6 (GND), U1.J7 (GND), U1.J8 (GND), U1.J9 (GND), U1.K5 (GND), U1.K6 (GND), U1.K7 (GND), U1.K8 (GND), U1.K9 (GND), U1.L5 (GND), U1.L6 (GND), U1.L7 (GND), U1.L8 (GND), U1.L9 (GND), U1.M5 (GND), U1.M6 (GND), U1.M7 (GND), U1.M8 (GND), U1.M9 (GND), U2.A1 (GND), U2.B3 (GND), U2.B4 (GND), U2.C2 (GND), U2.C3 (GND), U2.C4 (GND), U2.C5 (GND), U2.C6 (GND), U2.C7 (GND), U2.C8 (GND), U2.C9 (GND), U2.D2 (GND), U2.D3 (GND), U2.D4 (GND), U2.D5 (GND), U2.D6 (GND), U2.D7 (GND), U2.D8 (GND), U2.D9 (GND), U2.E3 (GND), U2.E4 (GND), U2.E5 (GND), U2.E6 (GND), U2.E7 (GND), U2.E8 (GND), U2.E9 (GND), U2.F2 (MODE), U2.F3 (GND), U2.F4 (GND), U2.F5 (GND), U2.F6 (GND), U2.F7 (GND), U2.F8 (GND), U2.F9 (GND), U2.G1 (GND), U2.G2 (GND), U2.G3 (GND), U2.G4 (GND), U2.G5 (GND), U2.G6 (GND), U2.G7 (GND), U2.G8 (GND), U2.G9 (GND), U2.H5 (GND), U2.H6 (GND), U2.H7 (GND), U2.H8 (GND), U2.H9 (GND), U2.J5 (GND), U2.J6 (GND), U2.J7 (GND), U2.J8 (GND), U2.J9 (GND), U2.K5 (GND), U2.K6 (GND), U2.K7 (GND), U2.K8 (GND), U2.K9 (GND), U2.L5 (GND), U2.L6 (GND), U2.L7 (GND), U2.L8 (GND), U2.L9 (GND), U2.M5 (GND), U2.M6 (GND), U2.M7 (GND), U2.M8 (GND), U2.M9 (GND)
GND_Shield: C12.1, J1.S1, J1.S2, J6.S1 (SHIELD1), J6.S2 (SHIELD2), J8.S1 (SHIELD1), J8.S2 (SHIELD2), J9.S1 (SHIELD1), J9.S2 (SHIELD2), J10.S1 (SHIELD1), J10.S2 (SHIELD2), MP1.1, MP2.1, R17.1
unnamed: C17.1, R6.1, R10.2
unnamed: D1.2 (A), R8.1
unnamed: U1.B1 (CTRL2), U1.B2 (VREF), U1.C1 (CTRL1)
unnamed: R4.1, U1.A2 (FB)
unnamed: R1.2, U1.E2 (RT)
unnamed: U2.B1 (CTRL2), U2.B2 (VREF)
unnamed: R7.1, U2.A2 (FB)
unnamed: R5.2, U2.E2 (RT)
PWM1: J1.11, J5.3
PWM2: J1.10, J4.3
PWM3: J1.13, J3.3
PWM4: J1.12, J2.3
VBAT: C1.1, C2.1, C3.1, C6.1, C7.1, C8.1, J1.01, J1.03, J1.05, J6.2, J8.2, J9.2, J10.2, R3.2, U1.A5 (VIN), U1.A6 (VIN), U1.A7 (VIN), U1.A8 (VIN), U1.A9 (VIN), U1.B5 (VIN), U1.B6 (VIN), U1.B7 (VIN), U1.B8 (VIN), U1.B9 (VIN), U2.A5 (VIN), U2.A6 (VIN), U2.A7 (VIN), U2.A8 (VIN), U2.A9 (VIN), U2.B5 (VIN), U2.B6 (VIN), U2.B7 (VIN), U2.B8 (VIN), U2.B9 (VIN)
