Pro-engineer616/pcb_projects_Alex/PDB v1.1/PDB_1.0/source/source/PDB.kicad_pcb

## KiCad design PDB v1.1/PDB_1.0/source/source/PDB.kicad_pcb (2024-08-19, an earlier design)

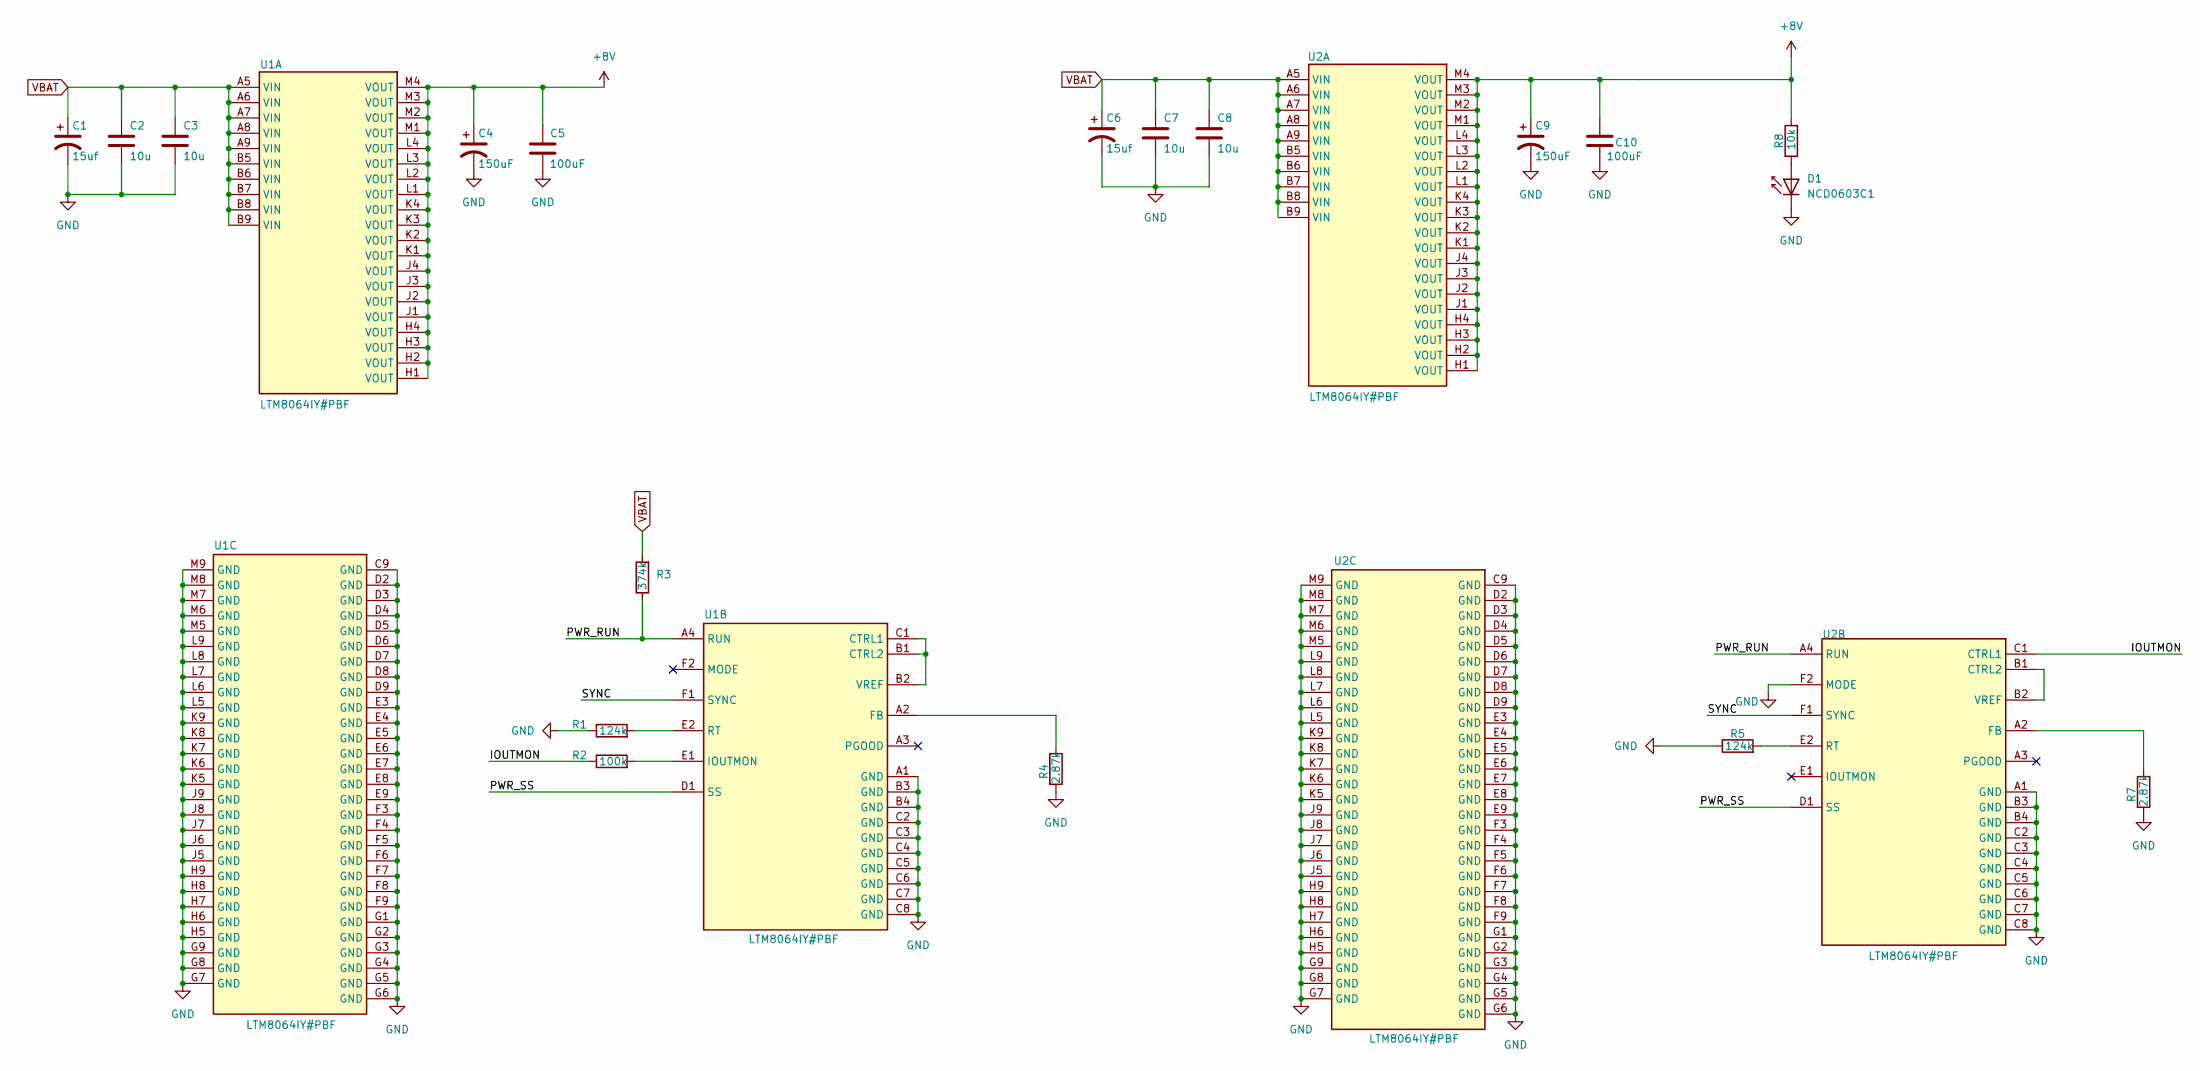
[picture p122: schematic power_sch.kicad_sch, POWER]

Parts:
C1, C6: 15uf; CAP_100SXV15MX; VOLTAGE RATING 6.3V; VOLTAGE RATING (DC) 6.3V; PART_NUMBER 100SXV15MX
C2, C3, C7, C8: 10u; C_1210_3225Metric; Part GRJ32ER71H106KE11L
C4, C9: 150uF; CAP_TRM-E-2917_AVX-L; TOLERANCE 10%; VOLTAGE 6.3V; PART_NUMBER TRME157M016R0030
C5, C10: 100uF; C_1210_3225Metric; Part CL32A107MPVNNNE
D1: NCD0603C1; LED_0603_1608Metric
R1, R5: 124k; R_0201_0603Metric; PART NUMBER RC0201FR-07124KL
R2: 100k; R_0201_0603Metric; PART NUMBER 0201WMF1003TEE
R3: 374k; R_0402_1005Metric; PART NUMBER ERJ2RKF3743X
R4, R7: 2.87k; R_0201_0603Metric; PART_NUMBER RTT012871FTH
R8: 10k; R_0201_0603Metric; PART NUMBER 0201WMF1002TEE
U1, U2: LTM8064IY#PBF; BGA108_16X11P9_ADI; OUTPUT VOLTAGE 3.3V; VOLTAGE - OUTPUT 1 36V

Connections:
+8V: C4.1, C5.2, C9.1, C10.2, R8.2, U1.H1 (VOUT), U1.H2 (VOUT), U1.H3 (VOUT), U1.H4 (VOUT), U1.J1 (VOUT), U1.J2 (VOUT), U1.J3 (VOUT), U1.J4 (VOUT), U1.K1 (VOUT), U1.K2 (VOUT), U1.K3 (VOUT), U1.K4 (VOUT), U1.L1 (VOUT), U1.L2 (VOUT), U1.L3 (VOUT), U1.L4 (VOUT), U1.M1 (VOUT), U1.M2 (VOUT), U1.M3 (VOUT), U1.M4 (VOUT), U2.H1 (VOUT), U2.H2 (VOUT), U2.H3 (VOUT), U2.H4 (VOUT), U2.J1 (VOUT), U2.J2 (VOUT), U2.J3 (VOUT), U2.J4 (VOUT), U2.K1 (VOUT), U2.K2 (VOUT), U2.K3 (VOUT), U2.K4 (VOUT), U2.L1 (VOUT), U2.L2 (VOUT), U2.L3 (VOUT), U2.L4 (VOUT), U2.M1 (VOUT), U2.M2 (VOUT), U2.M3 (VOUT), U2.M4 (VOUT); also elsewhere on the board
/power/IOUTMON: R2.1, U2.C1 (CTRL1)
/power/PWR_RUN: R3.1, U1.A4 (RUN), U2.A4 (RUN)
/power/PWR_SS: U1.D1 (SS), U2.D1 (SS)
/power/SYNC: U1.F1 (SYNC), U2.F1 (SYNC)
GND: C1.2, C2.2, C3.2, C4.2, C5.1, C6.2, C7.2, C8.2, C9.2, C10.1, D1.1 (K), R1.1, R4.2, R5.1, R7.2, U1.A1 (GND), U1.B3 (GND), U1.B4 (GND), U1.C2 (GND), U1.C3 (GND), U1.C4 (GND), U1.C5 (GND), U1.C6 (GND), U1.C7 (GND), U1.C8 (GND), U1.C9 (GND), U1.D2 (GND), U1.D3 (GND), U1.D4 (GND), U1.D5 (GND), U1.D6 (GND), U1.D7 (GND), U1.D8 (GND), U1.D9 (GND), U1.E3 (GND), U1.E4 (GND), U1.E5 (GND), U1.E6 (GND), U1.E7 (GND), U1.E8 (GND), U1.E9 (GND), U1.F3 (GND), U1.F4 (GND), U1.F5 (GND), U1.F6 (GND), U1.F7 (GND), U1.F8 (GND), U1.F9 (GND), U1.G1 (GND), U1.G2 (GND), U1.G3 (GND), U1.G4 (GND), U1.G5 (GND), U1.G6 (GND), U1.G7 (GND), U1.G8 (GND), U1.G9 (GND), U1.H5 (GND), U1.H6 (GND), U1.H7 (GND), U1.H8 (GND), U1.H9 (GND), U1.J5 (GND), U1.J6 (GND), U1.J7 (GND), U1.J8 (GND), U1.J9 (GND), U1.K5 (GND), U1.K6 (GND), U1.K7 (GND), U1.K8 (GND), U1.K9 (GND), U1.L5 (GND), U1.L6 (GND), U1.L7 (GND), U1.L8 (GND), U1.L9 (GND), U1.M5 (GND), U1.M6 (GND), U1.M7 (GND), U1.M8 (GND), U1.M9 (GND), U2.A1 (GND), U2.B3 (GND), U2.B4 (GND), U2.C2 (GND), U2.C3 (GND), U2.C4 (GND), U2.C5 (GND), U2.C6 (GND), U2.C7 (GND), U2.C8 (GND), U2.C9 (GND), U2.D2 (GND), U2.D3 (GND), U2.D4 (GND), U2.D5 (GND), U2.D6 (GND), U2.D7 (GND), U2.D8 (GND), U2.D9 (GND), U2.E3 (GND), U2.E4 (GND), U2.E5 (GND), U2.E6 (GND), U2.E7 (GND), U2.E8 (GND), U2.E9 (GND), U2.F2 (MODE), U2.F3 (GND), U2.F4 (GND), U2.F5 (GND), U2.F6 (GND), U2.F7 (GND), U2.F8 (GND), U2.F9 (GND), U2.G1 (GND), U2.G2 (GND), U2.G3 (GND), U2.G4 (GND), U2.G5 (GND), U2.G6 (GND), U2.G7 (GND), U2.G8 (GND), U2.G9 (GND), U2.H5 (GND), U2.H6 (GND), U2.H7 (GND), U2.H8 (GND), U2.H9 (GND), U2.J5 (GND), U2.J6 (GND), U2.J7 (GND), U2.J8 (GND), U2.J9 (GND), U2.K5 (GND), U2.K6 (GND), U2.K7 (GND), U2.K8 (GND), U2.K9 (GND), U2.L5 (GND), U2.L6 (GND), U2.L7 (GND), U2.L8 (GND), U2.L9 (GND), U2.M5 (GND), U2.M6 (GND), U2.M7 (GND), U2.M8 (GND), U2.M9 (GND); also elsewhere on the board
unnamed: D1.2 (A), R8.1
unnamed: U1.B1 (CTRL2), U1.B2 (VREF), U1.C1 (CTRL1)
unnamed: R4.1, U1.A2 (FB)
unnamed: R2.2, U1.E1 (IOUTMON)
unnamed: R1.2, U1.E2 (RT)
unnamed: U2.B1 (CTRL2), U2.B2 (VREF)
unnamed: R7.1, U2.A2 (FB)
unnamed: R5.2, U2.E2 (RT)
VBAT: C1.1, C2.1, C3.1, C6.1, C7.1, C8.1, R3.2, U1.A5 (VIN), U1.A6 (VIN), U1.A7 (VIN), U1.A8 (VIN), U1.A9 (VIN), U1.B5 (VIN), U1.B6 (VIN), U1.B7 (VIN), U1.B8 (VIN), U1.B9 (VIN), U2.A5 (VIN), U2.A6 (VIN), U2.A7 (VIN), U2.A8 (VIN), U2.A9 (VIN), U2.B5 (VIN), U2.B6 (VIN), U2.B7 (VIN), U2.B8 (VIN), U2.B9 (VIN); also elsewhere on the board

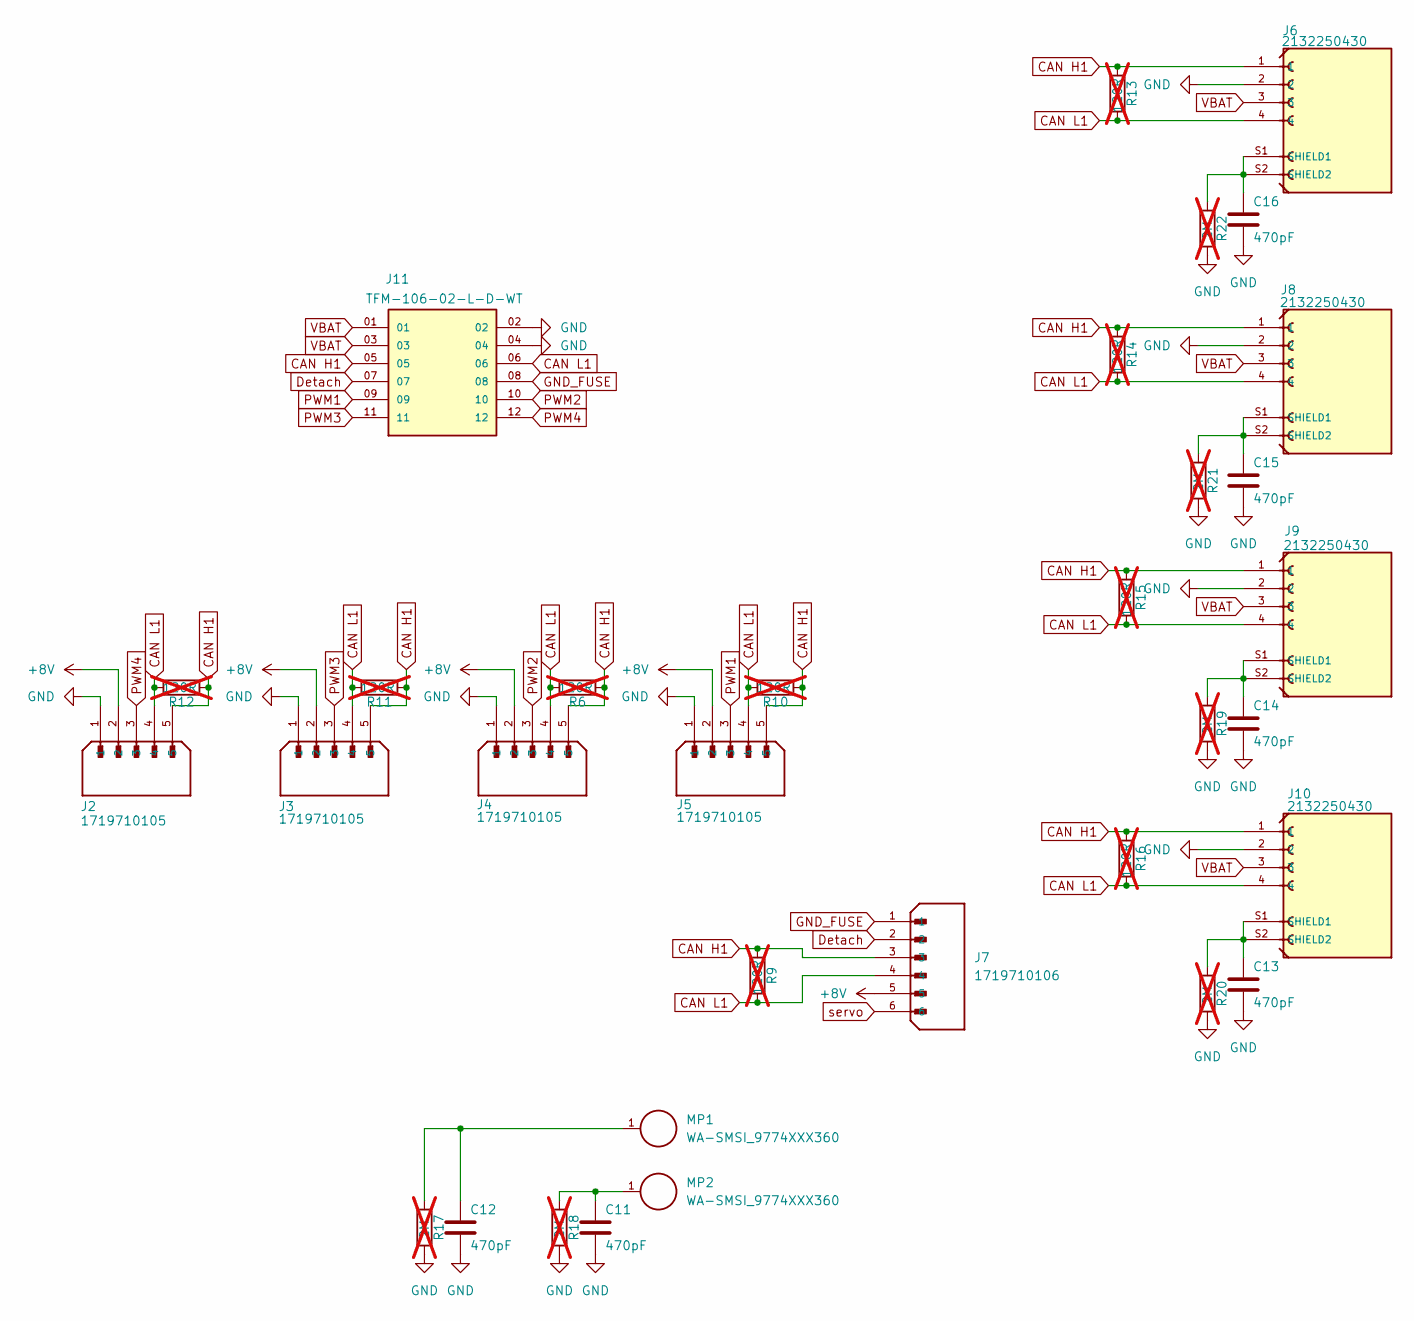
[picture p123: schematic Connector_sch.kicad_sch, CONNECTOR]

Parts:
C11, C12, C13, C14, C15, C16: 470pF; C_1206_3216Metric; Part FCC1206B471K102DT
J2, J3, J4, J5: 1719710105; MOLEX_1719710105; PARTREV C1
J6, J8, J9, J10: 2132250430; MOLEX_2132250430; PARTREV D
J7: 1719710106; MOLEX_1719710106; PARTREV C1
J11: TFM-106-02-L-D-WT; SAMTEC_TFM-106-02-L-D-WT; PARTREV Q
MP1, MP2: WA-SMSI_9774XXX360; WA-SMSI_9774120360; PART-NUMBER 9774120360R
R6, R9, R10, R11, R12, R13, R14, R15, R16: 120R; R_0402_1005Metric; PART NUMBER 0402WGF1200TCE; not fitted
R17, R18, R19, R20, R21, R22: 2M; C_1206_3216Metric; PART NUMBER 1206W4F2004T5E; not fitted

Connections:
+8V: J2.2, J3.2, J4.2, J5.2, J7.5; also elsewhere on the board
CAN H1: J2.5, J3.5, J4.5, J5.5, J6.1, J7.3, J8.1, J9.1, J10.1, J11.05, R6.1, R9.1, R10.1, R11.1, R12.1, R13.1, R14.1, R15.1, R16.1
CAN L1: J2.4, J3.4, J4.4, J5.4, J6.4, J7.4, J8.4, J9.4, J10.4, J11.06, R6.2, R9.2, R10.2, R11.2, R12.2, R13.2, R14.2, R15.2, R16.2
Detach: J7.2, J11.07
GND: C11.2, C12.2, C13.2, C14.2, C15.2, C16.2, J2.1, J3.1, J4.1, J5.1, J6.2, J8.2, J9.2, J10.2, J11.02, J11.04, R17.2, R18.2, R19.2, R20.2, R21.2, R22.2; also elsewhere on the board
GND_FUSE: J7.1, J11.08
unnamed: C11.1, MP2.1, R18.1
unnamed: C12.1, MP1.1, R17.1
unnamed: C16.1, J6.S1 (SHIELD1), J6.S2 (SHIELD2), R22.1
unnamed: C15.1, J8.S1 (SHIELD1), J8.S2 (SHIELD2), R21.1
unnamed: C14.1, J9.S1 (SHIELD1), J9.S2 (SHIELD2), R19.1
unnamed: C13.1, J10.S1 (SHIELD1), J10.S2 (SHIELD2), R20.1
PWM1: J5.3, J11.09
PWM2: J4.3, J11.10
PWM3: J3.3, J11.11
PWM4: J2.3, J11.12
VBAT: J6.3, J8.3, J9.3, J10.3, J11.01, J11.03; also elsewhere on the board
servo: J7.6
