Pro-engineer616/pcb_projects_Alex/PDB v1.1/PDB_1.0/source/source/PDB.kicad_pcb

## KiCad design PDB v1.1/PDB_1.0/source/source/PDB.kicad_pcb (continued)

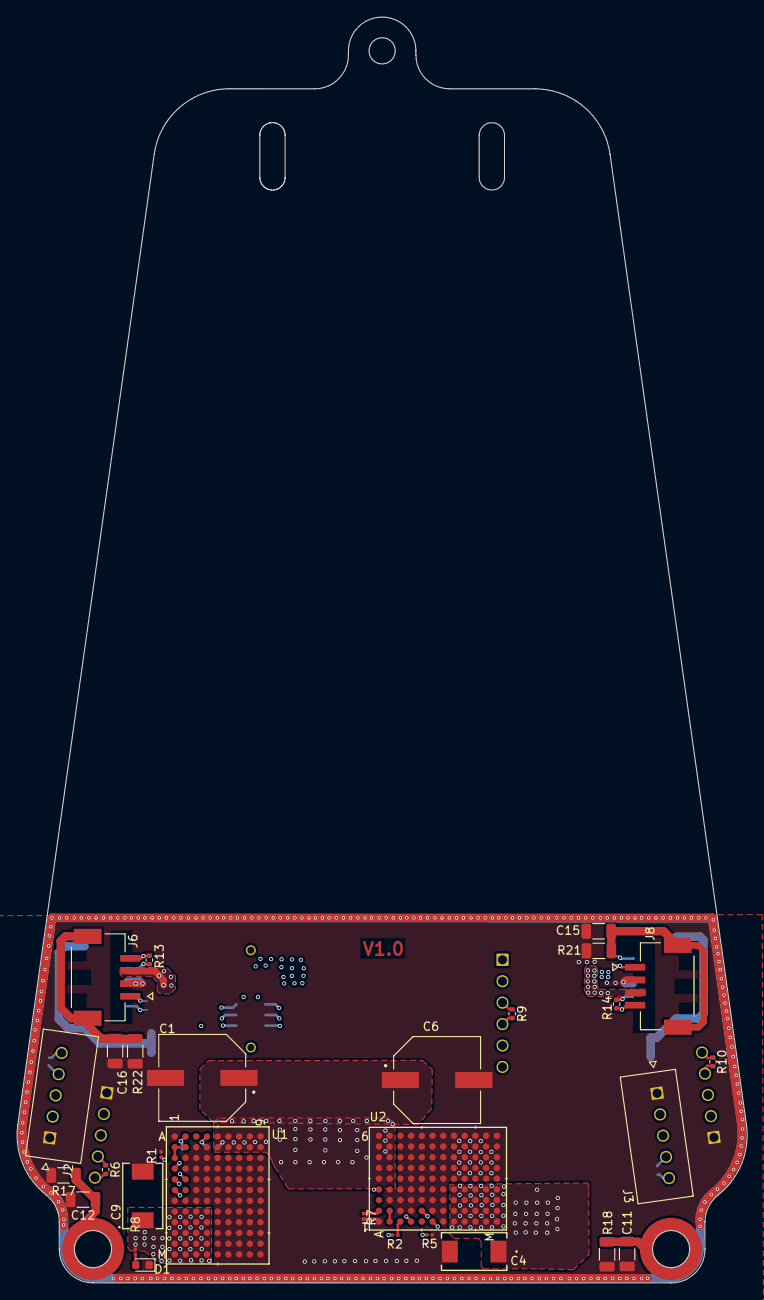
[picture p124: board PDB.kicad_pcb from above]

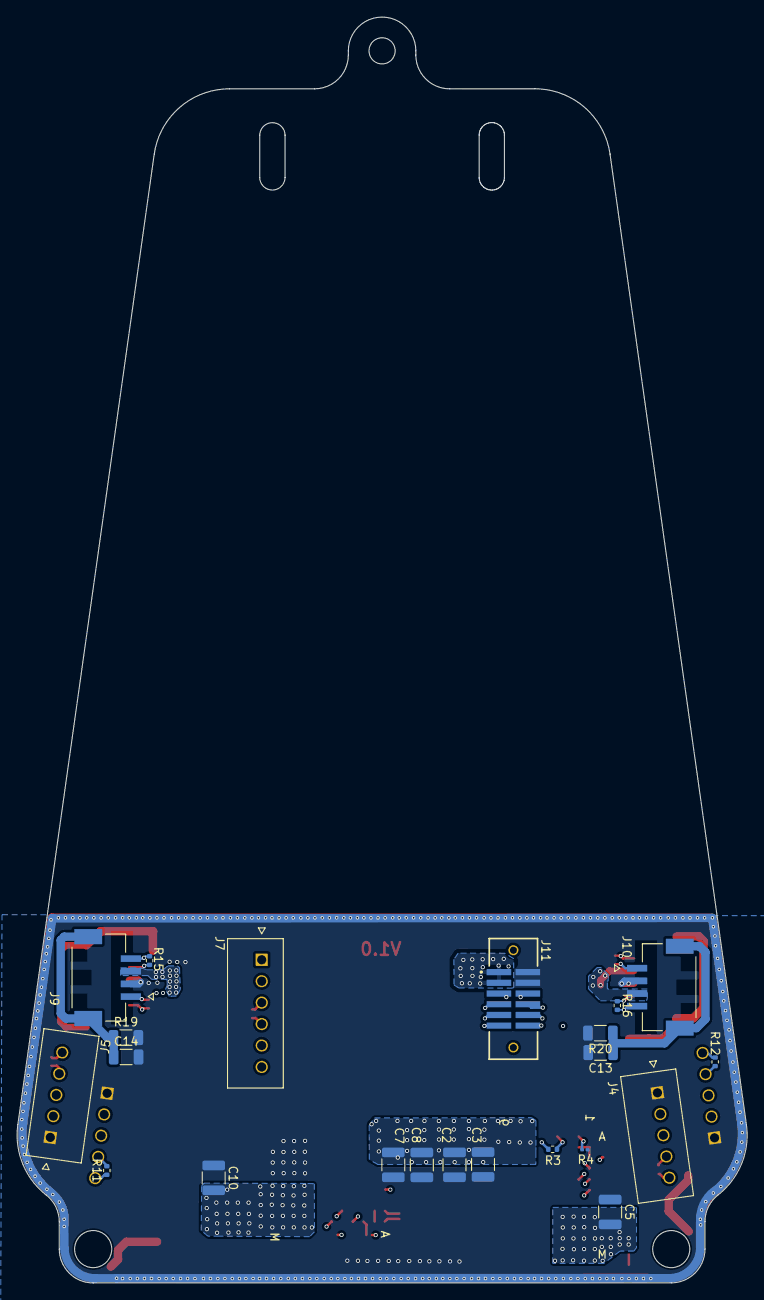
[picture p125: board PDB.kicad_pcb from below]

Board: 4 copper layers, 86.5 x 150.0 mm, 53 parts (22 on the bottom side), 29 nets.
