Pro-engineer616/pcb_projects_Alex/infrastructure-board/source/infrastructure/Connector_sch.kicad_sch

## KiCad design infrastructure-board/source/infrastructure/Connector_sch.kicad_sch (2024-09-03)

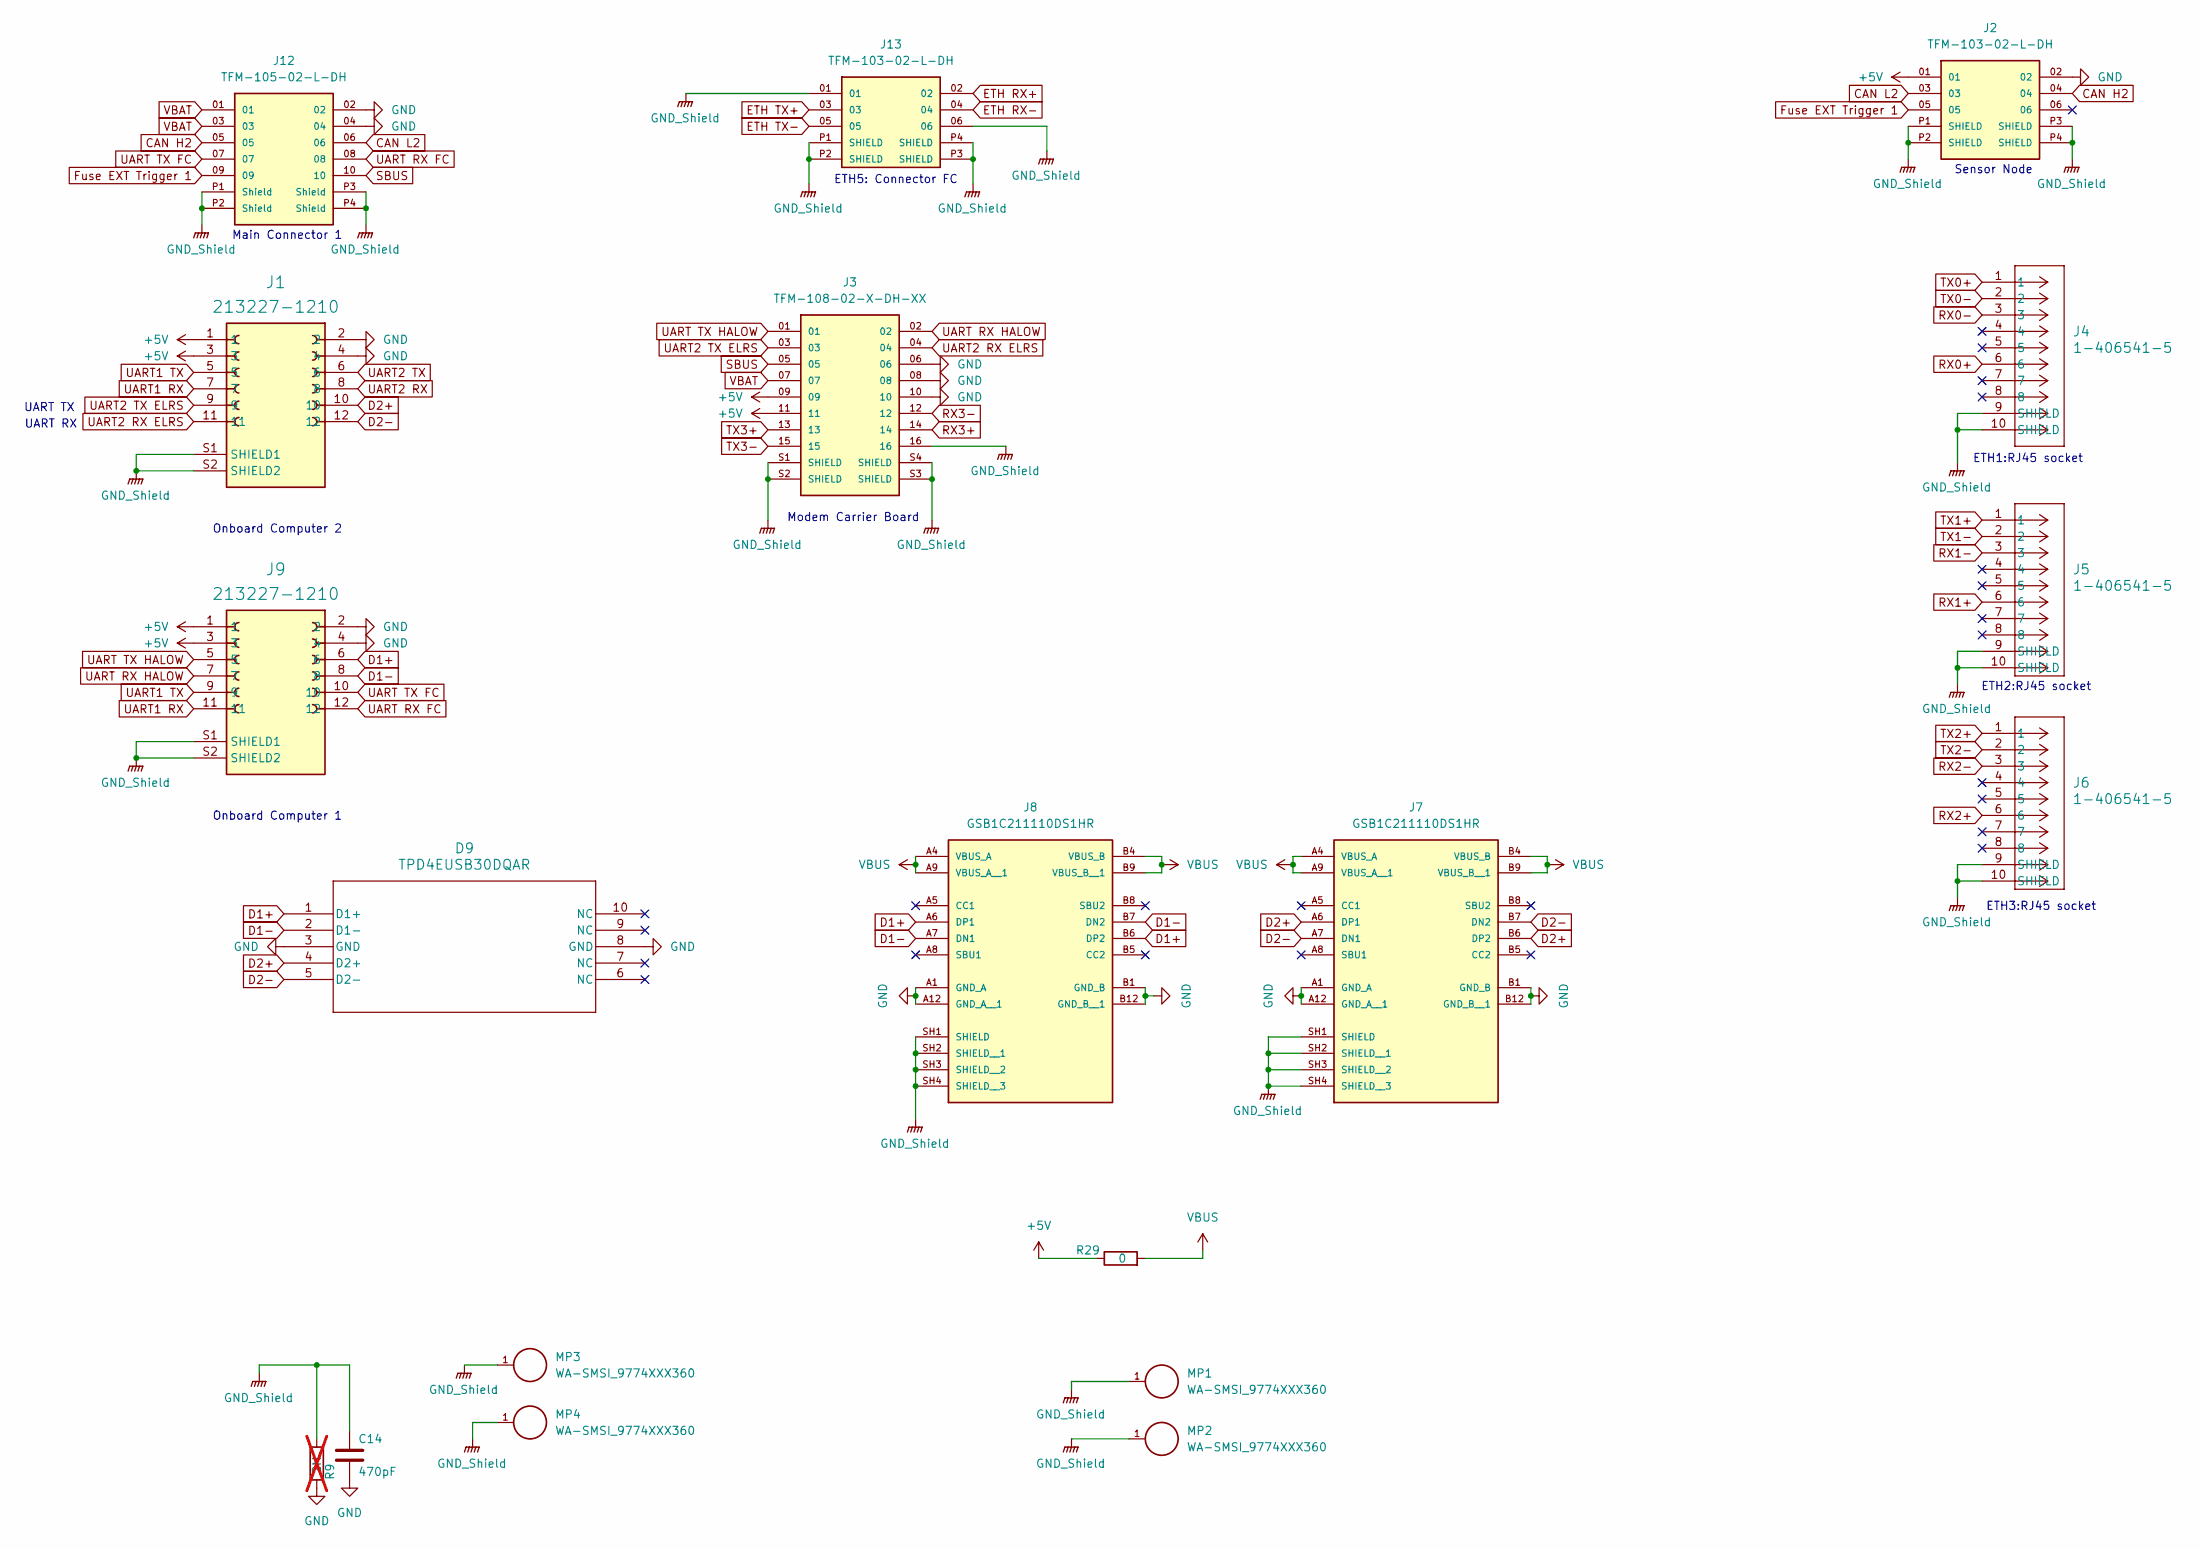
[picture p126: schematic Connector_sch.kicad_sch]

Parts:
C14: 470pF; C_1206_3216Metric; Part FCC1206B471K102DT
D9: TPD4EUSB30DQAR; DQA10
J1, J9: 213227-1210; MOLEX_2132271210
J2, J13: TFM-103-02-L-DH; SAMTEC_TFM-103-02-L-DH; PARTREV F
J3: TFM-108-02-X-DH-XX; SAMTEC_TFM-108-02-X-DH-XX; PARTREV F
J4, J5, J6: 1-406541-5; CONN8_406541_TEC
J7, J8: GSB1C211110DS1HR; AMPHENOL_GSB1C211110DS1HR; PARTREV AX1
J12: TFM-105-02-L-DH; SAMTEC_TFM-105-02-L-DH; PARTREV F
MP1, MP2, MP3, MP4: WA-SMSI_9774XXX360; WA-SMSI_9774120360; PART-NUMBER 9774120360R
R9: 2M; C_1206_3216Metric; PART NUMBER 1206W4F2004T5E; not fitted
R29: 0; R_0201_0603Metric; PART NUMBER RC0201FR-07124KL

Connections:
+5V: J1.1, J1.3, J2.01, J3.09, J3.11, J9.1, J9.3, R29.1
CAN H2: J2.04, J12.05
CAN L2: J2.03, J12.06
D1+: D9.1 (D1+), J8.A6 (DP1), J8.B6 (DP2), J9.6
D1-: D9.2 (D1-), J8.A7 (DN1), J8.B7 (DN2), J9.8
D2+: D9.4 (D2+), J1.10, J7.A6 (DP1), J7.B6 (DP2)
D2-: D9.5 (D2-), J1.12, J7.A7 (DN1), J7.B7 (DN2)
ETH RX+: J13.02
ETH RX-: J13.04
ETH TX+: J13.03
ETH TX-: J13.05
Fuse EXT Trigger 1: J2.05, J12.09
GND: C14.2, D9.3 (GND), D9.8 (GND), J1.2, J1.4, J2.02, J3.06, J3.08, J3.10, J7.A1 (GND_A), J7.A12 (GND_A__1), J7.B1 (GND_B), J7.B12 (GND_B__1), J8.A1 (GND_A), J8.A12 (GND_A__1), J8.B1 (GND_B), J8.B12 (GND_B__1), J9.2, J9.4, J12.02, J12.04, R9.2
GND_Shield: C14.1, J1.S1 (SHIELD1), J1.S2 (SHIELD2), J2.P1 (SHIELD), J2.P2 (SHIELD), J2.P3 (SHIELD), J2.P4 (SHIELD), J3.16, J3.S1 (SHIELD), J3.S2 (SHIELD), J3.S3 (SHIELD), J3.S4 (SHIELD), J4.9 (SHIELD), J4.10 (SHIELD), J5.9 (SHIELD), J5.10 (SHIELD), J6.9 (SHIELD), J6.10 (SHIELD), J7.SH1 (SHIELD), J7.SH2 (SHIELD__1), J7.SH3 (SHIELD__2), J7.SH4 (SHIELD__3), J8.SH1 (SHIELD), J8.SH2 (SHIELD__1), J8.SH3 (SHIELD__2), J8.SH4 (SHIELD__3), J9.S1 (SHIELD1), J9.S2 (SHIELD2), J12.P1 (Shield), J12.P2 (Shield), J12.P3 (Shield), J12.P4 (Shield), J13.01, J13.06, J13.P1 (SHIELD), J13.P2 (SHIELD), J13.P3 (SHIELD), J13.P4 (SHIELD), MP1.1, MP2.1, MP3.1, MP4.1, R9.1
RX0+: J4.6
RX0-: J4.3
RX1+: J5.6
RX1-: J5.3
RX2+: J6.6
RX2-: J6.3
RX3+: J3.14
RX3-: J3.12
SBUS: J3.05, J12.10
TX0+: J4.1
TX0-: J4.2
TX1+: J5.1
TX1-: J5.2
TX2+: J6.1
TX2-: J6.2
TX3+: J3.13
TX3-: J3.15
UART1 RX: J1.7, J9.11
UART1 TX: J1.5, J9.9
UART2 RX: J1.8
UART2 RX ELRS: J1.11, J3.04
UART2 TX: J1.6
UART2 TX ELRS: J1.9, J3.03
UART RX FC: J9.12, J12.08
UART RX HALOW: J3.02, J9.7
UART TX FC: J9.10, J12.07
UART TX HALOW: J3.01, J9.5
VBAT: J3.07, J12.01, J12.03
VBUS: J7.A4 (VBUS_A), J7.A9 (VBUS_A__1), J7.B4 (VBUS_B), J7.B9 (VBUS_B__1), J8.A4 (VBUS_A), J8.A9 (VBUS_A__1), J8.B4 (VBUS_B), J8.B9 (VBUS_B__1), R29.2

Notes on the sheet:
Onboard Computer 1
Main Connector 1
Onboard Computer 2
Modem Carrier Board
ETH5: Connector FC
ETH3:RJ45 socket
UART RX
UART TX
ETH2:RJ45 socket
Sensor Node
ETH1:RJ45 socket
