Pro-engineer616/pcb_projects_Alex/infrastructure-board/source/infrastructure/Ethernet.kicad_sch

## KiCad design infrastructure-board/source/infrastructure/Ethernet.kicad_sch (2024-08-29)

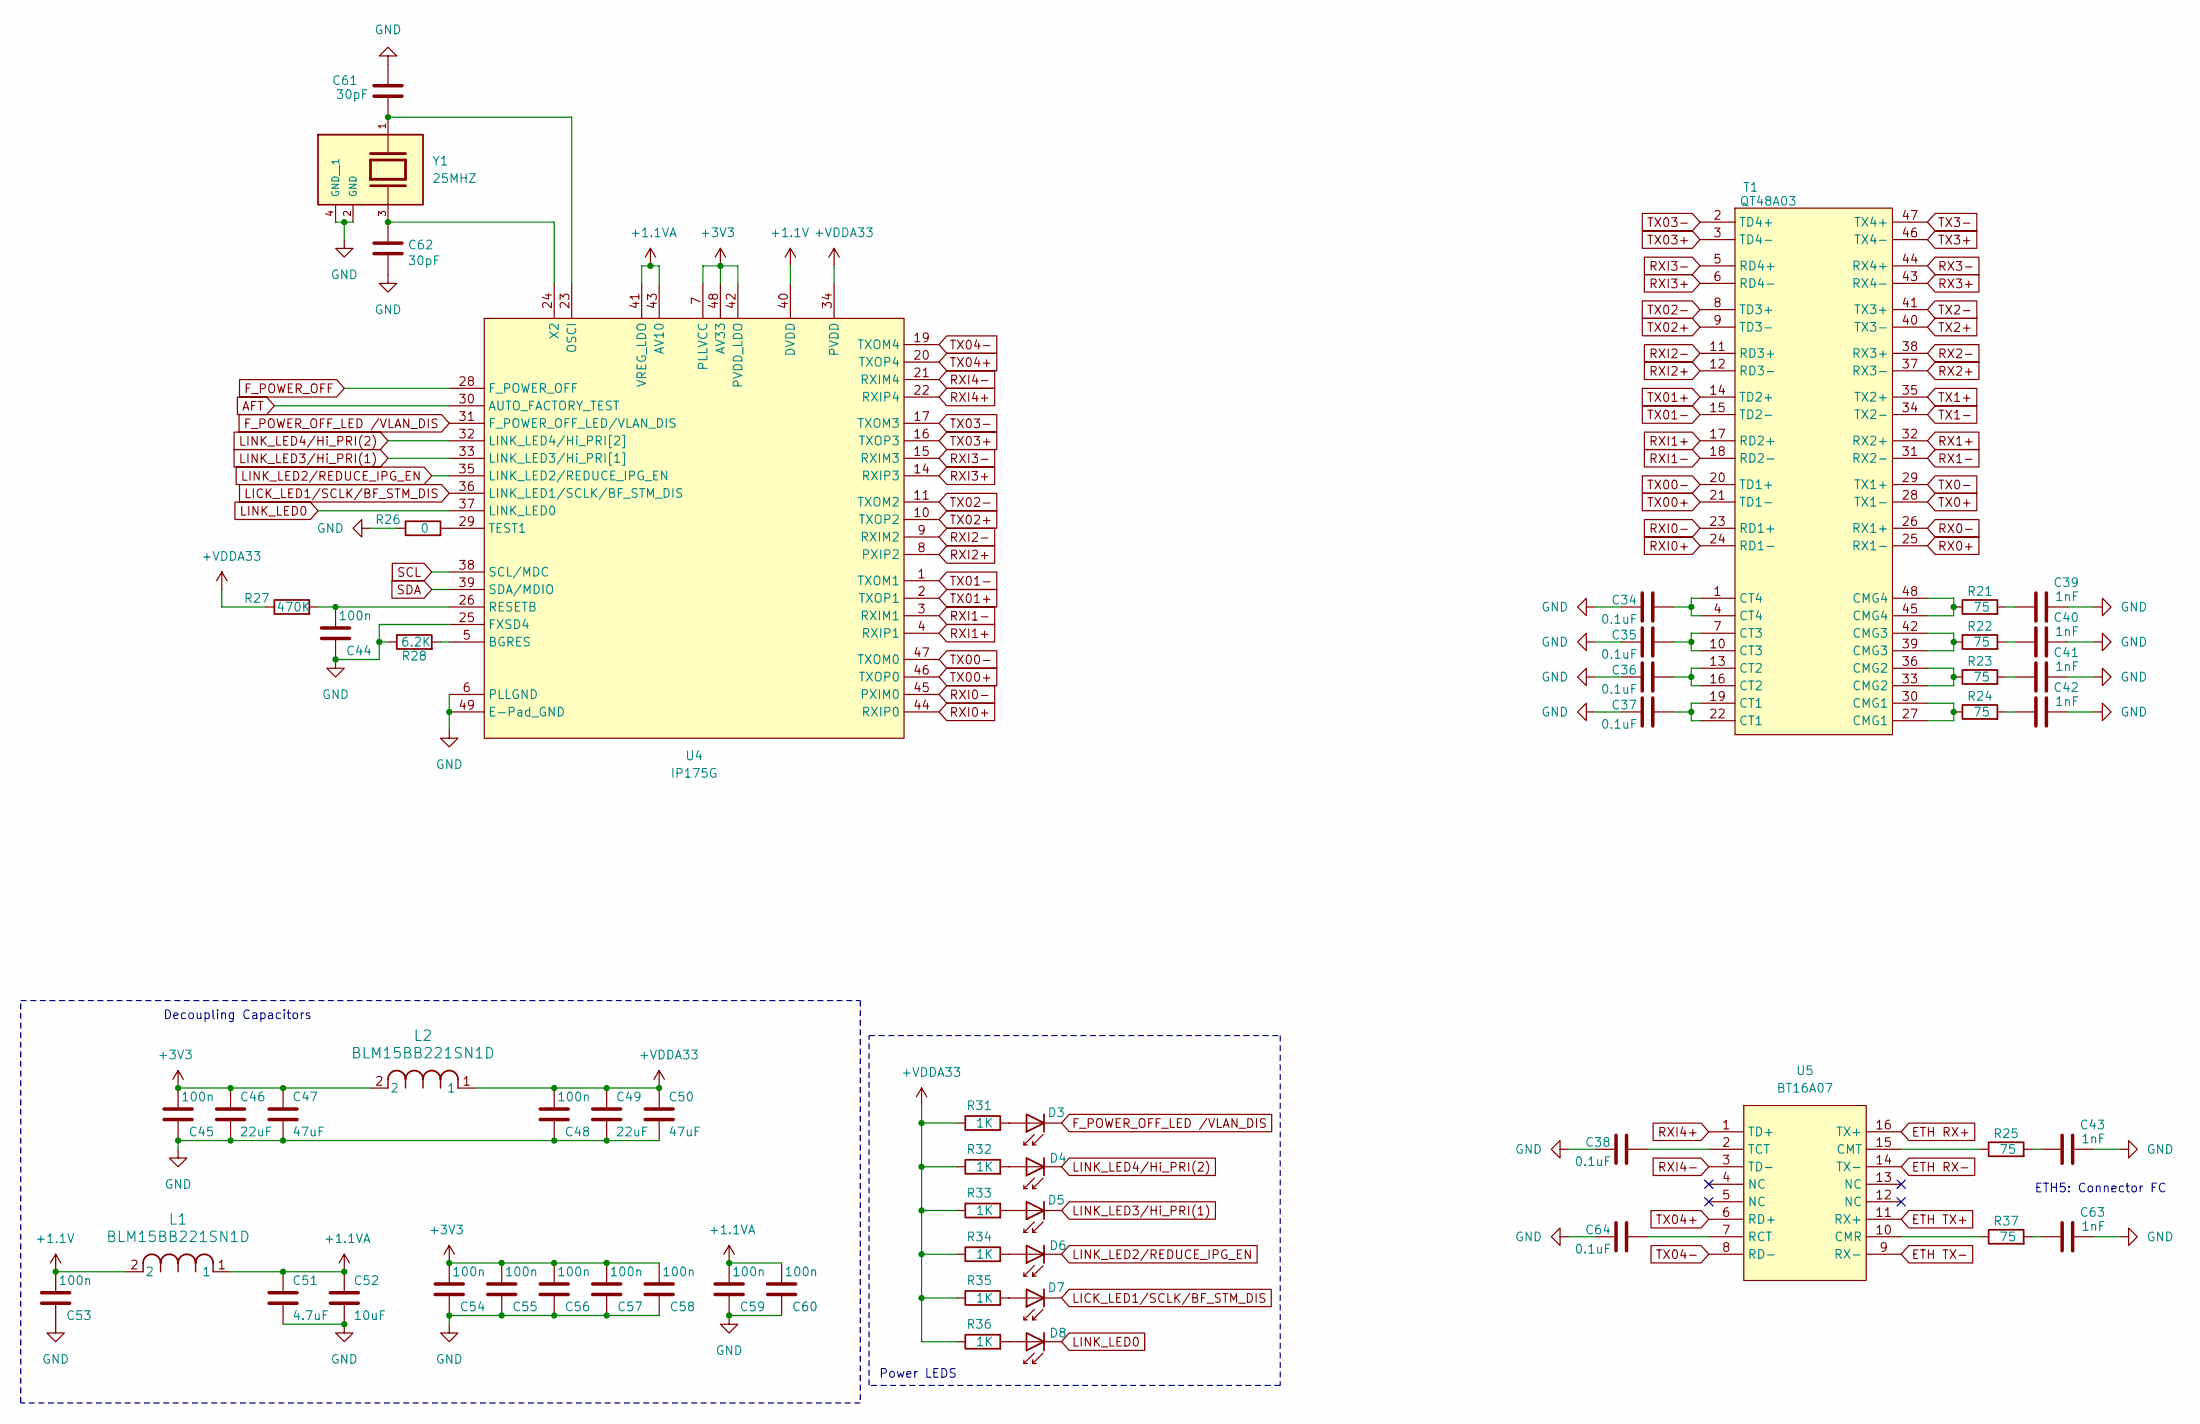
[picture p127: schematic Ethernet.kicad_sch]

Parts:
C34, C35, C36: 0.1uF; C_1206_3216Metric; Part GRM033R61E104KE14D
C37, C38, C64: 0.1uF; C_1206_3216Metric; Part FCC1206B471K102DT
C39, C40, C41, C42, C43, C63: 1nF; C_1206_3216Metric; Part FCC1206B471K102DT
C44: 100n; C_0201_0603Metric; Part GRM033R61E104KE14D
C45, C48, C53, C54, C55, C56, C57, C58, C59, C60: 100n; C_0201_0603Metric; Part C0201X5R104K160NT
C46, C49: 22uF; C_0402_1005Metric; Part GRM155R61A225KE95D
C47, C50: 47uF; C_0603_1608Metric; Part 0603X476M6R3NT
C51: 4.7uF; C_0402_1005Metric; Part GRM155R61A225KE95D
C52: 10uF; C_0402_1005Metric; Part CL05A106MP5NUNC
C61, C62: 30pF; C_0201_0603Metric; Part FCC1206B471K102DT
D3, D4, D5, D6, D7, D8: NCD0603C1; LED_0603_1608Metric
L1, L2: BLM15BB221SN1D; IND_BLM15_0402_MUR-L
R21, R22, R23, R24, R25, R37: 75; R_0201_0603Metric; PART NUMBER RC0201FR-07124KL
R26: 0; R_0201_0603Metric; PART NUMBER RC0201FR-07124KL
R27: 470K; R_0201_0603Metric; PART NUMBER RC0201FR-07124KL
R28: 6.2K; R_0201_0603Metric; PART NUMBER RC0201FR-07124KL
R31, R32, R33, R34, R35, R36: 1K; R_0201_0603Metric; PART NUMBER RC0201FR-07124KL
T1: QT48A03
U4: IP175G
U5: BT16A07
Y1: 25MHZ; XTAL_TSX-3225_40.0000MF20X-K0

Connections:
+1.1V: C53.2, L1.2, U4.27 (DVDD), U4.40 (DVDD)
+1.1VA: C51.1, C52.1, C59.2, C60.2, L1.1, U4.13 (AV10), U4.41 (VREG_LDO), U4.43 (AV10)
+3V3: C45.2, C46.1, C47.1, C54.2, C55.2, C56.2, C57.2, C58.2, L2.2, U4.7 (PLLVCC), U4.12 (AV33), U4.18 (AV33), U4.42 (PVDD_LDO), U4.48 (AV33)
+VDDA33: C48.2, C49.1, C50.1, L2.1, R27.1, R31.1, R32.1, R33.1, R34.1, R35.1, R36.1, U4.34 (PVDD)
AFT: U4.30 (AUTO_FACTORY_TEST)
ETH RX+: U5.16 (TX+)
ETH RX-: U5.14 (TX-)
ETH TX+: U5.11 (RX+)
ETH TX-: U5.9 (RX-)
F_POWER_OFF: U4.28 (F_POWER_OFF)
F_POWER_OFF_LED /VLAN_DIS: D3.1 (K), U4.31 (F_POWER_OFF_LED/VLAN_DIS)
GND: C34.2, C35.2, C36.2, C37.2, C38.2, C39.2, C40.2, C41.2, C42.2, C43.2, C44.1, C45.1, C46.2, C47.2, C48.1, C49.2, C50.2, C51.2, C52.2, C53.1, C54.1, C55.1, C56.1, C57.1, C58.1, C59.1, C60.1, C61.2, C62.2, C63.2, C64.2, R26.1, R28.1, U4.6 (PLLGND), U4.25 (FXSD4), U4.49 (E-Pad_GND), Y1.2 (GND), Y1.4 (GND__1)
LICK_LED1/SCLK/BF_STM_DIS: D7.1 (K), U4.36 (LINK_LED1/SCLK/BF_STM_DIS)
LINK_LED0: D8.1 (K), U4.37 (LINK_LED0)
LINK_LED2/REDUCE_IPG_EN: D6.1 (K), U4.35 (LINK_LED2/REDUCE_IPG_EN)
LINK_LED3/Hi_PRI(1): D5.1 (K), U4.33 (LINK_LED3/Hi_PRI[1])
LINK_LED4/Hi_PRI(2): D4.1 (K), U4.32 (LINK_LED4/Hi_PRI[2])
unnamed: C34.1, T1.1 (CT4), T1.4 (CT4)
unnamed: C35.1, T1.7 (CT3), T1.10 (CT3)
unnamed: C36.1, T1.13 (CT2), T1.16 (CT2)
unnamed: C37.1, T1.19 (CT1), T1.22 (CT1)
unnamed: C38.1, U5.2 (TCT)
unnamed: C39.1, R21.2
unnamed: C40.1, R22.2
unnamed: C41.1, R23.2
unnamed: C42.1, R24.2
unnamed: C43.1, R25.2
unnamed: C44.2, R27.2, U4.26 (RESETB)
unnamed: C61.1, U4.23 (OSCI), Y1.1
unnamed: C62.1, U4.24 (X2), Y1.3
unnamed: C63.1, R37.2
unnamed: C64.1, U5.7 (RCT)
unnamed: D3.2 (A), R31.2
unnamed: D4.2 (A), R32.2
unnamed: D5.2 (A), R33.2
unnamed: D6.2 (A), R34.2
unnamed: D7.2 (A), R35.2
unnamed: D8.2 (A), R36.2
unnamed: R21.1, T1.45 (CMG4), T1.48 (CMG4)
unnamed: R22.1, T1.39 (CMG3), T1.42 (CMG3)
unnamed: R23.1, T1.33 (CMG2), T1.36 (CMG2)
unnamed: R24.1, T1.27 (CMG1), T1.30 (CMG1)
unnamed: R25.1, U5.15 (CMT)
unnamed: R26.2, U4.29 (TEST1)
unnamed: R28.2, U4.5 (BGRES)
unnamed: R37.1, U5.10 (CMR)
RX0+: T1.25 (RX1-)
RX0-: T1.26 (RX1+)
RX1+: T1.32 (RX2+)
RX1-: T1.31 (RX2-)
RX2+: T1.37 (RX3-)
RX2-: T1.38 (RX3+)
RX3+: T1.43 (RX4-)
RX3-: T1.44 (RX4+)
RXI0+: T1.24 (RD1-), U4.44 (RXIP0)
RXI0-: T1.23 (RD1+), U4.45 (PXIM0)
RXI1+: T1.17 (RD2+), U4.4 (RXIP1)
RXI1-: T1.18 (RD2-), U4.3 (RXIM1)
RXI2+: T1.12 (RD3-), U4.8 (PXIP2)
RXI2-: T1.11 (RD3+), U4.9 (RXIM2)
RXI3+: T1.6 (RD4-), U4.14 (RXIP3)
RXI3-: T1.5 (RD4+), U4.15 (RXIM3)
RXI4+: U4.22 (RXIP4), U5.1 (TD+)
RXI4-: U4.21 (RXIM4), U5.3 (TD-)
SCL: U4.38 (SCL/MDC)
SDA: U4.39 (SDA/MDIO)
TX00+: T1.21 (TD1-), U4.46 (TXOP0)
TX0+: T1.28 (TX1-)
TX00-: T1.20 (TD1+), U4.47 (TXOM0)
TX0-: T1.29 (TX1+)
TX01+: T1.14 (TD2+), U4.2 (TXOP1)
TX1+: T1.35 (TX2+)
TX01-: T1.15 (TD2-), U4.1 (TXOM1)
TX1-: T1.34 (TX2-)
TX2+: T1.40 (TX3-)
TX02+: T1.9 (TD3-), U4.10 (TXOP2)
TX2-: T1.41 (TX3+)
TX02-: T1.8 (TD3+), U4.11 (TXOM2)
TX03+: T1.3 (TD4-), U4.16 (TXOP3)
TX3+: T1.46 (TX4-)
TX03-: T1.2 (TD4+), U4.17 (TXOM3)
TX3-: T1.47 (TX4+)
TX04+: U4.20 (TXOP4), U5.6 (RD+)
TX04-: U4.19 (TXOM4), U5.8 (RD-)

Notes on the sheet:
Power LEDS
ETH5: Connector FC
Decoupling Capacitors
