Pro-engineer616/pcb_projects_Alex/infrastructure-board/source/infrastructure/power_sch.kicad_sch

## KiCad design infrastructure-board/source/infrastructure/power_sch.kicad_sch (2024-08-29)

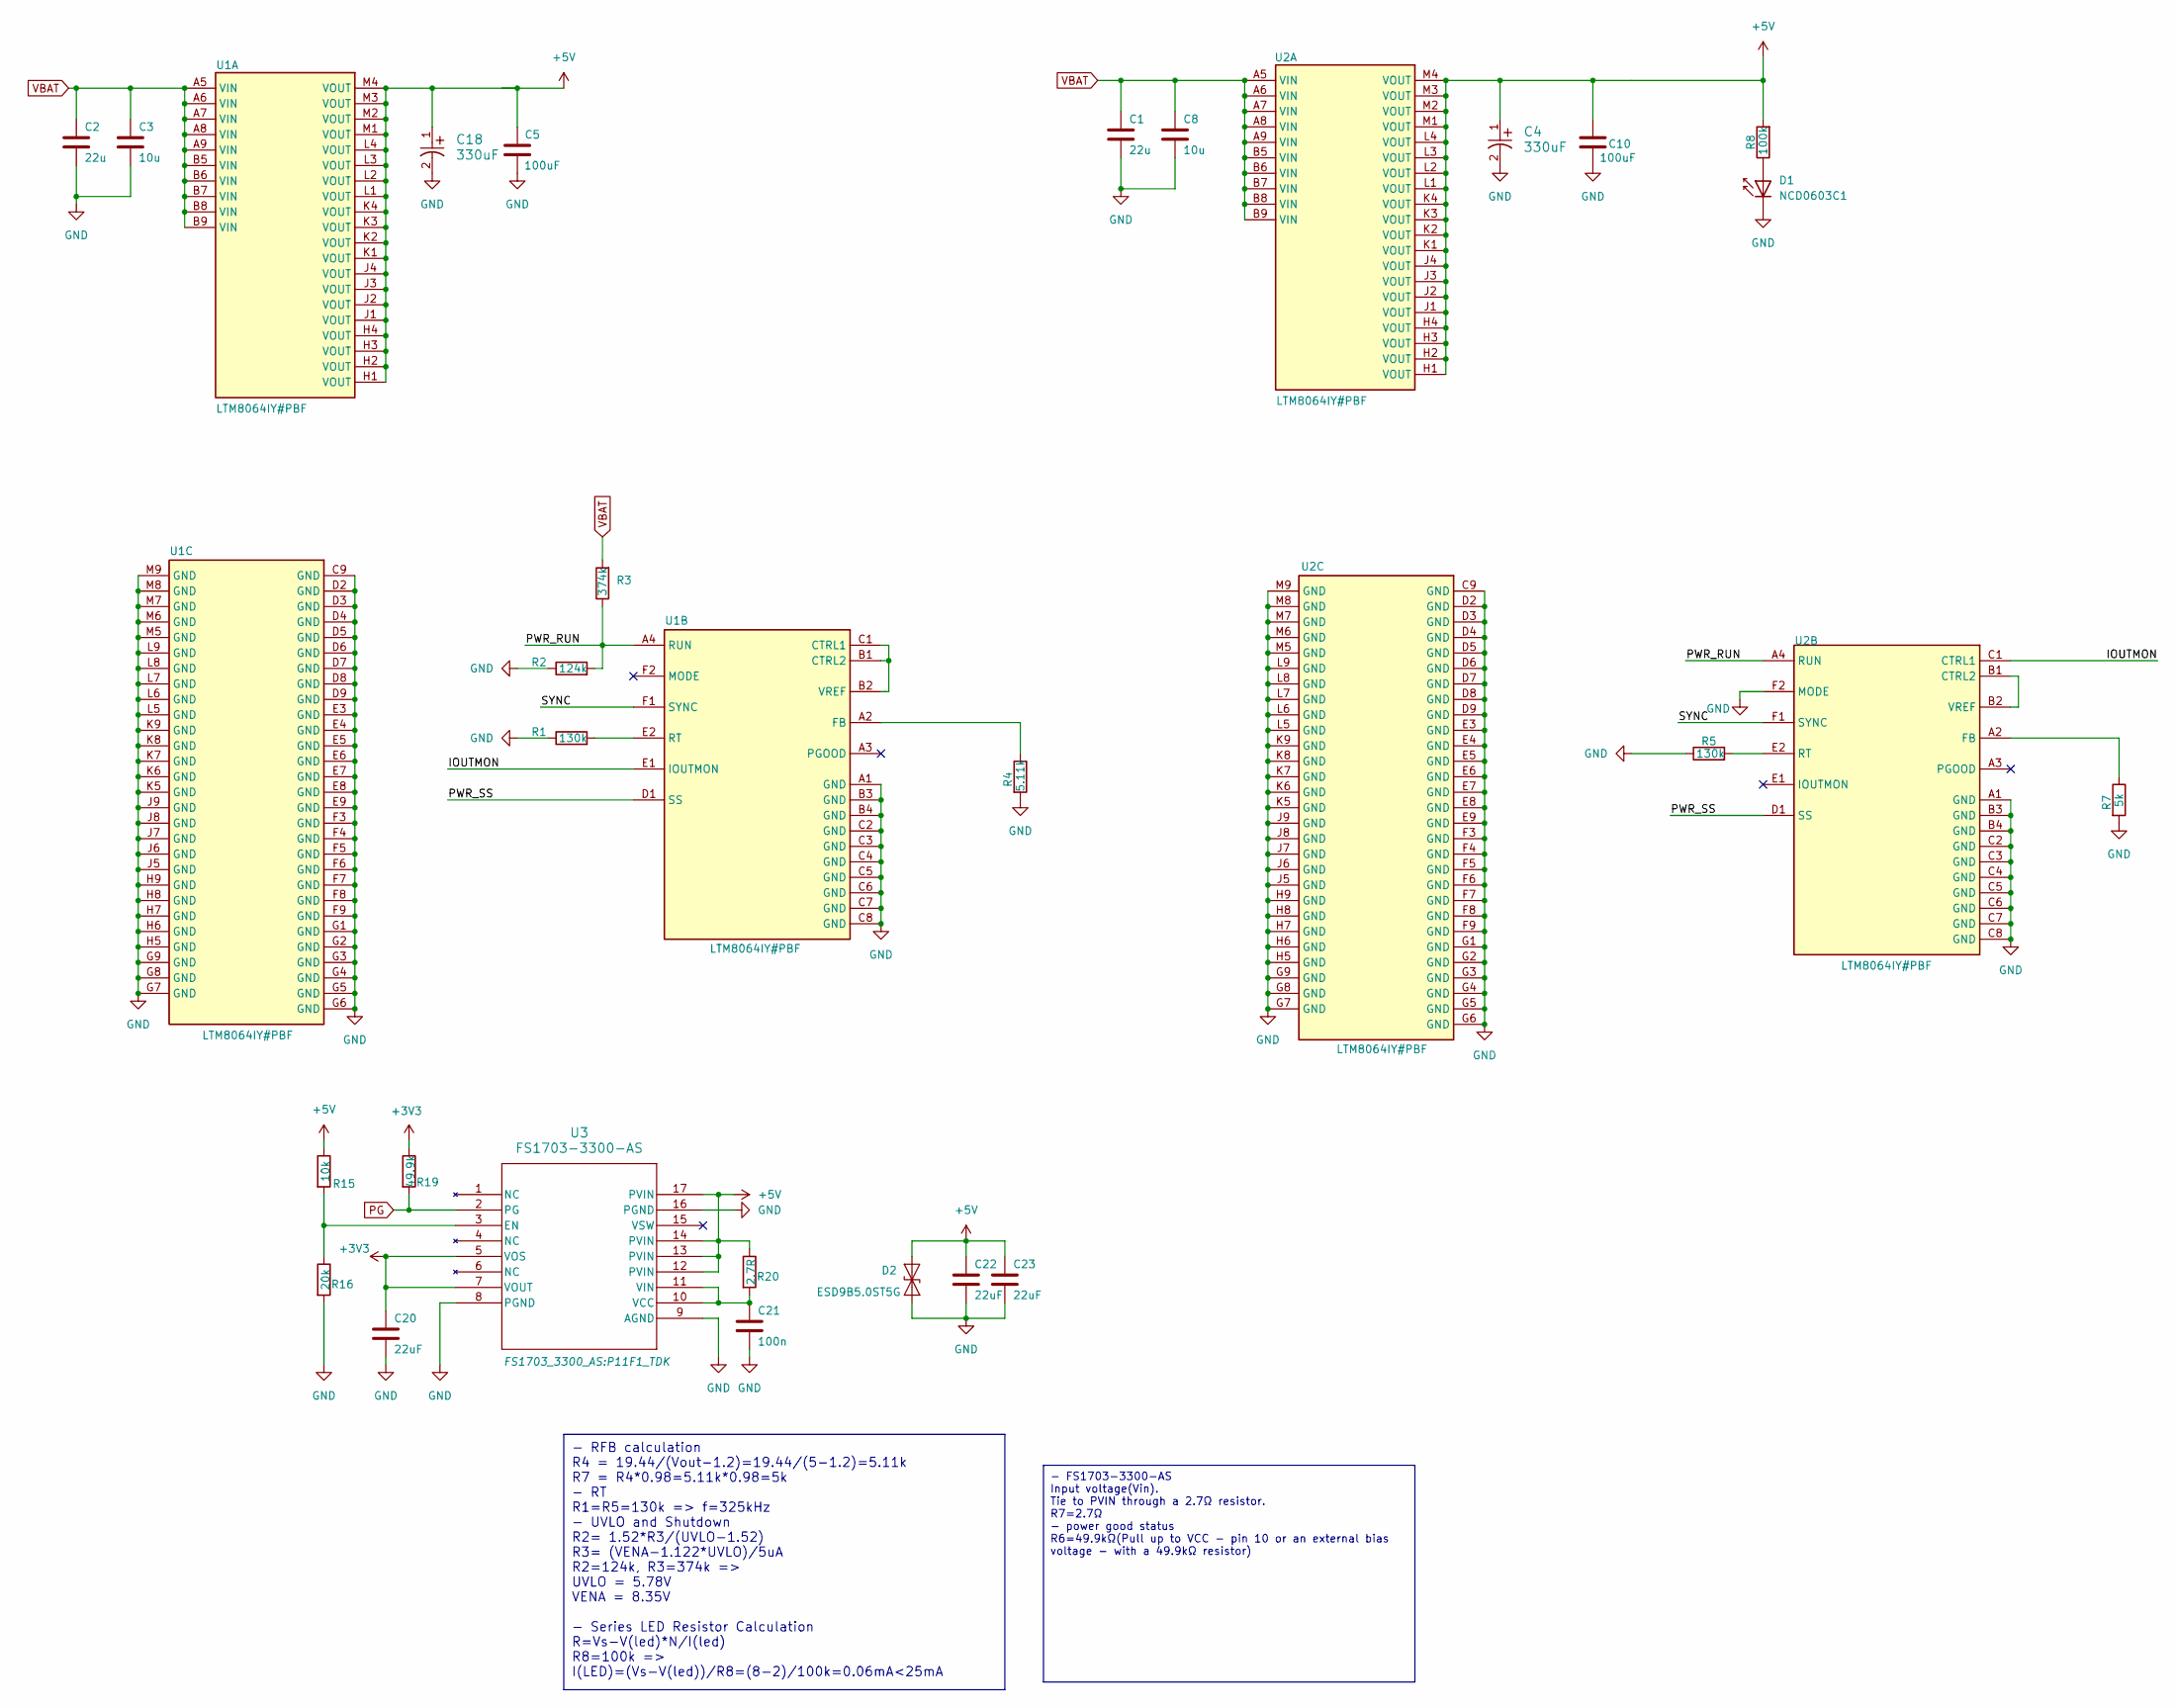
[picture p128: schematic power_sch.kicad_sch]

Parts:
C1, C2: 22u; C_1210_3225Metric; Part GMK325BJ226MM-P
C3, C8: 10u; C_1210_3225Metric; Part GRJ32ER71H106KE11L
C4, C18: 330uF; TAJD_AVX
C5, C10: 100uF; C_1210_3225Metric; Part CL32A107MPVNNNE
C20: 22uF; C_0402_1005Metric; Part CGA0402X5R226M100GT
C21: 100n; C_0201_0603Metric; Part CL10B104KB8NNWC
C22, C23: 22uF; C_0402_1005Metric; Part GRM155R61A225KE95D
D1: NCD0603C1; LED_0603_1608Metric
D2: ESD9B5.0ST5G; D_SOD-923
R1, R5: 130k; R_0201_0603Metric; PART NUMBER RC0201FR-07124KL
R2: 124k; R_0201_0603Metric; PART NUMBER RC0201FR-07124KL
R3: 374k; R_0402_1005Metric; PART NUMBER ERJ2RKF3743X
R4: 5.11k; R_0201_0603Metric; PART_NUMBER RTT012871FTH
R7: 5k; R_0402_1005Metric; PART_NUMBER RTT012871FTH
R8: 100k; R_0201_0603Metric; PART NUMBER 0201WMF1003TEE
R15: 10k; R_0201_0603Metric; Part RC0201JR-0710KL
R16: 20k; R_0201_0603Metric; Part 0201WMF2002TEE
R19: 49.9k; R_0201_0603Metric; Part RC0201FR-0749K9L
R20: 2.7R; R_0201_0603Metric; Part RTT012R70FTH
U1, U2: LTM8064IY#PBF; BGA108_16X11P9_ADI; OUTPUT VOLTAGE 3.3V; VOLTAGE - OUTPUT 1 36V
U3: FS1703-3300-AS; P11F1_TDK

Connections:
+3V3: C20.1, R19.1, U3.5 (VOS), U3.7 (VOUT)
+5V: C4.1, C5.2, C10.2, C18.1, C22.1, C23.1, D2.2 (A2), R8.2, R15.1, R20.1, U1.H1 (VOUT), U1.H2 (VOUT), U1.H3 (VOUT), U1.H4 (VOUT), U1.J1 (VOUT), U1.J2 (VOUT), U1.J3 (VOUT), U1.J4 (VOUT), U1.K1 (VOUT), U1.K2 (VOUT), U1.K3 (VOUT), U1.K4 (VOUT), U1.L1 (VOUT), U1.L2 (VOUT), U1.L3 (VOUT), U1.L4 (VOUT), U1.M1 (VOUT), U1.M2 (VOUT), U1.M3 (VOUT), U1.M4 (VOUT), U2.H1 (VOUT), U2.H2 (VOUT), U2.H3 (VOUT), U2.H4 (VOUT), U2.J1 (VOUT), U2.J2 (VOUT), U2.J3 (VOUT), U2.J4 (VOUT), U2.K1 (VOUT), U2.K2 (VOUT), U2.K3 (VOUT), U2.K4 (VOUT), U2.L1 (VOUT), U2.L2 (VOUT), U2.L3 (VOUT), U2.L4 (VOUT), U2.M1 (VOUT), U2.M2 (VOUT), U2.M3 (VOUT), U2.M4 (VOUT), U3.12 (PVIN), U3.13 (PVIN), U3.14 (PVIN), U3.17 (PVIN)
GND: C1.2, C2.2, C3.2, C4.2, C5.1, C8.2, C10.1, C18.2, C20.2, C21.2, C22.2, C23.2, D1.1 (K), D2.1 (A1), R1.1, R2.1, R4.2, R5.1, R7.2, R16.2, U1.A1 (GND), U1.B3 (GND), U1.B4 (GND), U1.C2 (GND), U1.C3 (GND), U1.C4 (GND), U1.C5 (GND), U1.C6 (GND), U1.C7 (GND), U1.C8 (GND), U1.C9 (GND), U1.D2 (GND), U1.D3 (GND), U1.D4 (GND), U1.D5 (GND), U1.D6 (GND), U1.D7 (GND), U1.D8 (GND), U1.D9 (GND), U1.E3 (GND), U1.E4 (GND), U1.E5 (GND), U1.E6 (GND), U1.E7 (GND), U1.E8 (GND), U1.E9 (GND), U1.F3 (GND), U1.F4 (GND), U1.F5 (GND), U1.F6 (GND), U1.F7 (GND), U1.F8 (GND), U1.F9 (GND), U1.G1 (GND), U1.G2 (GND), U1.G3 (GND), U1.G4 (GND), U1.G5 (GND), U1.G6 (GND), U1.G7 (GND), U1.G8 (GND), U1.G9 (GND), U1.H5 (GND), U1.H6 (GND), U1.H7 (GND), U1.H8 (GND), U1.H9 (GND), U1.J5 (GND), U1.J6 (GND), U1.J7 (GND), U1.J8 (GND), U1.J9 (GND), U1.K5 (GND), U1.K6 (GND), U1.K7 (GND), U1.K8 (GND), U1.K9 (GND), U1.L5 (GND), U1.L6 (GND), U1.L7 (GND), U1.L8 (GND), U1.L9 (GND), U1.M5 (GND), U1.M6 (GND), U1.M7 (GND), U1.M8 (GND), U1.M9 (GND), U2.A1 (GND), U2.B3 (GND), U2.B4 (GND), U2.C2 (GND), U2.C3 (GND), U2.C4 (GND), U2.C5 (GND), U2.C6 (GND), U2.C7 (GND), U2.C8 (GND), U2.C9 (GND), U2.D2 (GND), U2.D3 (GND), U2.D4 (GND), U2.D5 (GND), U2.D6 (GND), U2.D7 (GND), U2.D8 (GND), U2.D9 (GND), U2.E3 (GND), U2.E4 (GND), U2.E5 (GND), U2.E6 (GND), U2.E7 (GND), U2.E8 (GND), U2.E9 (GND), U2.F2 (MODE), U2.F3 (GND), U2.F4 (GND), U2.F5 (GND), U2.F6 (GND), U2.F7 (GND), U2.F8 (GND), U2.F9 (GND), U2.G1 (GND), U2.G2 (GND), U2.G3 (GND), U2.G4 (GND), U2.G5 (GND), U2.G6 (GND), U2.G7 (GND), U2.G8 (GND), U2.G9 (GND), U2.H5 (GND), U2.H6 (GND), U2.H7 (GND), U2.H8 (GND), U2.H9 (GND), U2.J5 (GND), U2.J6 (GND), U2.J7 (GND), U2.J8 (GND), U2.J9 (GND), U2.K5 (GND), U2.K6 (GND), U2.K7 (GND), U2.K8 (GND), U2.K9 (GND), U2.L5 (GND), U2.L6 (GND), U2.L7 (GND), U2.L8 (GND), U2.L9 (GND), U2.M5 (GND), U2.M6 (GND), U2.M7 (GND), U2.M8 (GND), U2.M9 (GND), U3.8 (PGND), U3.9 (AGND), U3.16 (PGND)
IOUTMON: U1.E1 (IOUTMON), U2.C1 (CTRL1)
unnamed: C21.1, R20.2, U3.10 (VCC), U3.11 (VIN)
unnamed: D1.2 (A), R8.1
unnamed: R1.2, U1.E2 (RT)
unnamed: R4.1, U1.A2 (FB)
unnamed: R5.2, U2.E2 (RT)
unnamed: R7.1, U2.A2 (FB)
unnamed: R15.2, R16.1, U3.3 (EN)
unnamed: U1.B1 (CTRL2), U1.B2 (VREF), U1.C1 (CTRL1)
unnamed: U2.B1 (CTRL2), U2.B2 (VREF)
PG: R19.2, U3.2 (PG)
PWR_RUN: R2.2, R3.1, U1.A4 (RUN), U2.A4 (RUN)
PWR_SS: U1.D1 (SS), U2.D1 (SS)
SYNC: U1.F1 (SYNC), U2.F1 (SYNC)
VBAT: C1.1, C2.1, C3.1, C8.1, R3.2, U1.A5 (VIN), U1.A6 (VIN), U1.A7 (VIN), U1.A8 (VIN), U1.A9 (VIN), U1.B5 (VIN), U1.B6 (VIN), U1.B7 (VIN), U1.B8 (VIN), U1.B9 (VIN), U2.A5 (VIN), U2.A6 (VIN), U2.A7 (VIN), U2.A8 (VIN), U2.A9 (VIN), U2.B5 (VIN), U2.B6 (VIN), U2.B7 (VIN), U2.B8 (VIN), U2.B9 (VIN)

Notes on the sheet:
- RFB calculation R4 = 19.44/(Vout-1.2)=19.44/(5-1.2)=5.11k R7 = R4*0.98=5.11k*0.98=5k - RT R1=R5=130k => f=325kHz - UVLO and Shutdown R2= 1.52*R3/(UVLO-1.52) R3= (VENA-1.122*UVLO)/5uA R2=124k, R3=374k => UVLO = 5.78V VENA = 8.35V - Series LED Resistor Calculation R=Vs-V(led)*N/I(led) R8=100k => I(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
- FS1703-3300-AS Input voltage(Vin). Tie to PVIN through a 2.7Ω resistor. R7=2.7Ω - power good status R6=49.9kΩ(Pull up to VCC - pin 10 or an external bias voltage - with a 49.9kΩ resistor)
