Pro-engineer616/pcb_projects_Alex/(commit log)

2024-08-19 Add Source and production files
    Add Source and production files
    [DQA0010A.stp, EDI2CAP.CFG, FS1703-3300-AL--3DModel-STEP-269445.STEP, PESD3V3L4UF,115.stp, QFN24_4X4_SIL.step, QFN36_6X6MC_MCH.step, RADXA5.0_V1.1.step, Radxa Shield Rev. 1.1.kicad_pcb]
2024-08-19 Add PDB, sensor_node projects
    Add PDB, sensor_node projects
    [100SXV15MX.step, 1719710105.step, 1719710106.step, 2132250430.step, AUAV-RR.STEP, Airsensor.step, Airspeed_pcb.step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]
2024-08-21 Add the calculation for UART_HUB and USB_HUB
    Add the calculation for UART_HUB and USB_HUB
    [UART_HUB.kicad_sch, USB_Hub.kicad_sch]
2024-08-29 Add infrastructure project
    Add infrastructure project
    [100SXV15MX.step, 1719710105.step, 1719710106.step, 2132250430.step, 2132271210.stp, 530470210.stp, 530470410.stp, BGA108_16X11P9_ADI.step]
2024-09-03 Update VBAT net
    connection VBAT net to +5V
    [Connector_sch.kicad_sch]
2024-09-03 Add Radxa shield rev 1.2
    [DQA0010A.stp, EDI2CAP.CFG, FS1703-3300-AL--3DModel-STEP-269445.STEP, PESD3V3L4UF,115.stp, QFN24_4X4_SIL.step, QFN36_6X6MC_MCH.step, RADXA5.0_V1.1.step, Radxa Shield Rev. 1.2.kicad_pcb]
2024-09-03 Add PDB1.1
    [100SXV15MX.step, 1719710105.step, 1719710106.step, 2132250430.step, BGA108_16X11P9_ADI.step, CAP_TRM-E-2917_AVX.step, Connector_sch.kicad_sch, PDB.kicad_pcb]
2024-09-09 Add production data files
    PDB1.2, SensornodeV1.2, infrastructure
    [100SXV15MX.step, 1719710105.step, 1719710106.step, 2132250430.step, BGA108_16X11P9_ADI.step, CAP_TRM-E-2917_AVX.step, Connector_sch.kicad_sch, PDB1.2.kicad_pcb]
2024-09-09 Add productiondata
    [PDB1.2_CPL.xlsx]
2024-09-12 Update the mosfet with sot-23 package in PDB1.2 project
    Update the mosfet with sot-23 package in PDB1.2 project
    [PDB1.2.kicad_pcb, PDB1.step, bottom.DXF, top.DXF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]
2024-09-18 Add PDB1.4
    Add PDB1.4 included all source files.
    [100SXV15MX.step, 1719710105.step, 1719710106.step, 2132250430.step, BGA108_16X11P9_ADI.step, CAP_TRM-E-2917_AVX.step, Connector_sch.kicad_sch, PDB1.4.kicad_pcb]
2024-09-18 Add PDB1.4
    [PDB1.4 - Copy.step]
2024-09-18 Add BOM file
    Add BOM file
    [PDB1.4_BOM.csv]
2024-09-18 Add Version text
    Add Version text
    [100SXV15MX.step, 1719710105.step, 1719710106.step, 2132250430.step, BGA108_16X11P9_ADI.step, CAP_TRM-E-2917_AVX.step, Connector_sch.kicad_sch, PDB.kicad_pcb]
2024-09-18 Add version
    [PDB v1.4_BOM.csv]
2024-09-18 Add remove filling
    Add remove filling
    [100SXV15MX.step, 1719710105.step, 1719710106.step, 2132250430.step, BGA108_16X11P9_ADI.step, CAP_TRM-E-2917_AVX.step, Connector_sch.kicad_sch, PDB1.4.kicad_pcb]
2024-09-18 Add PCB specification of PDB v1.4
    Add PCB specification of PDB v1.4
2024-09-19 Update all projects
    add the items as following
    - PCB specifications
    - production files of PCBWay, JLCPCB
    [Radxa Shield Rev. 1.2_BOM_way.xlsx, sensor_node1.2_BOM_way.xlsx]
2024-09-19 Add zip files
    [100SXV15MX.step, 1719710105.step, 1719710106.step, 2132250430.step, BGA108_16X11P9_ADI.step, CAP_TRM-E-2917_AVX.step, Connector_sch.kicad_sch, PDB v1.4.step]
2024-09-19 Add sensornode_CPL
    [sensor_node_CPL.csv]
2024-09-19 Add BOM of PDB v1.4
    [PDB1.4_BOM.xlsx]
2024-09-19 add missed files
    [PDB1.2_BOM.csv, PDB1.4_BOM.csv, PDB1.4_BOM_way.csv, PDB_BOM.csv, infrastructure_BOM.csv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]
2024-09-19 Add board Name
    [PDB1.4.kicad_pcb]
2024-12-04 Create PDB_BOM - Copy.csv
    [PDB_BOM - Copy.csv]
