Pro-engineer616/pcb_projects_Alex/(notices)

Notices in the files:
infrastructure-board/source/infrastructure/package/TFM_108_02_L_DH/TFM-108-02-X-DH-XX.step:
author */ ('License CC BY-ND 4.0'),
